dominicbeesley/blitter-vhdl-6502/src/hdl/modelC20K/boards/C20K816only/README.MD

# C20K

Test version with on-board 816 as main CPU
