dominicbeesley/blitter-vhdl-6502/src/hdl/modelC20K/boards/C20KFirstLight816/README.MD

# C20KFirstLight816 build

C20K test just the 816 and memory, uses debug UART + NoIce
now includes HDMI
