dominicbeesley/blitter-vhdl-6502/src/hdl/modelC20K/asm/C20KFirstLight816/C20KBareMOS816/README.md

# C20KBareMOS
=============

This is a boot ROM to be loaded at F000 on the C20KFirstLight816 firmware which
connects via the debug UART to a DeIce monitor.
