dominicbeesley/blitter-vhdl-6502/doc/API.md

# Introduction

The Paula and Blitter expansion boards expose a number of hardware 
registers. Most of the hardware registers are in the JIM page-wide except
where those registers enhance or reimplement a well-known mechanism, i.e.
the ROM paging register.

The addresses listed below are "physical" addresses in the form "AA BBCC"
i.e. FF FE30. Logical addresses are prefixed with "L" i.e. LFE30

# Physical memory map

The Blitter firmware has the concept of Physical and Logical memory maps. This
is to cater for the fact that the Blitter board needs a relatively large (24 bit)
memory map to cater for the large amount of memory available and the large number
of peripheral registers. However, each of the supported CPUs has differing 
capabilities in terms of the size of address that they natively support.

The section on [Logical to Physical Mapping] below describes how each CPU can 
access the physical address map.

## Physcial memory map overview

The physical memory map is separated in to the broad areas in the table
below. The following sections describe these in more detail.

 | Physical address         | hardware item         |
 |--------------------------|-----------------------|
 | $00 0000 - $5F FFFF      | ChipRAM               | 
 | $60 0000 - $7F FFFF      | BB RAM                | 
 | $80 0000 - $BF FFFF      | Flash EEPROM repeats  | 
 | $C0 0000 - $F9 FFFF      | Undefined do not use  | !!!! Used by 65816 for access to SYS without log mapping
 | $FA 0000 - $FB FDFF      | HDMI memory           | 
 | $FB FE00 - $FB FFFF      | HDMI registers        | 
 | $FC 0000 - $FC FFFF      | Debug/Version info    | !!!! Also boot rom for pre-boot?
 | $FE FC00 - $FE FCFF      | Chipset registers BE  | 
 | $FE FE00 - $FE FEFF      | Chipset registers LE  | 
 | $FF 0000 - $FF FFFF      | Motherboard           |

The Physical memory map is used when:
 - accessing devices or memory via the JIM page-wide interface
 - programming Chipset registers

### ChipRAM

ChipRAM is the extra RAM that is present on the Blitter/Paula board the amount
and arrangement of RAM will depend on which revision and level of board.

When accessing ChipRAM on a MOS compatible system it is advised that the memory
layout be divined using the OSWORD 99 calls available through the Utility ROM
wherever possible.

### BB RAM

Battery backed RAM present on Mk.2, Mk.3 and C20K boards, typically there is 
one megabyte of RAM that repeats here.

#### Paula

On the Paula there is 512KB of Fast 10ns RAM. This RAM will repeatedly alias
to fill the banks 00..7F. There is no battery backed RAM

#### Mk.2 Blitter

The Mk.2 contains a single 2MB CMOS SRAM which is usually battery backed. This
RAM will repeatedly alias to fill the banks 00..7F

### Mk.3 Blitter

#### Mk.3 Fast RAM

The Mk.3 Blitter can contain up to 3x2MB fast 10ns RAM in the range 00..5F these
RAMs may be smaller than 2MB in which case they will each alias within a range of 
banks that is &20 banks long. There may be no fast RAM in which case whatever chip
is in socket 3 (battery backed) will alias in the same way as the Mk.2 Blitter. 
Conversely if there is no Battery Backed RAM the ChipRAM will also alias in the 
60..7F range.

#### Mk.3 Battery backed RAM
The Mk.3 Blitter may contain up to 2MB of 45ns CMOS static battery backed RAM 
which will appear in the range 60..7F. If there is no Fast RAM the battery backed
RAM will also appear in the lower portion of ChipRAM address space 00..5F

### Flash EEPROM

The Mk.2 and Mk.3 Blitters contain upto 512KB of Flash EEPROM at $80 0000 onwards
the Paula board contains an alias of RAM in this range.

The Flash EEPROM is an SST39VFxxx-55 compatible device upto (and usually) 512KB in
size. The main use is to provide sideways ROMS however there is usually unused 
capacity toward the borrom of the ROM which may be used for other applications.

### HDMI memory / registers

Optionally on the Mk.3 boards there may be a HDMI framebuffer of up to 128K and
some associated registers in this area.

### Debug / Version info

The firmware places a ROM in these pages for the purpose of identifying the firmware
and capabilities of the board.

### Chipset Registers

The Blitter, Paula Sound, DMA, Aeris registers are in this address range

### Motherboard

The whole of the BBC Micro's or Electron's address space appears in bank FF 
The following points should be noted:
- There is no re-mapping of the sideways ROM/RAM area and the sideways ROM/RAM
  selected on the Blitter board will not be accessed, instead the underlying
  motherboard mapping will apply.
- Writing the ROM select register (BBC/Master at FF FE30, Elk at FE05) will
  also write the Blitter's copy, thus updating the mapping in the logical 
  to physical mapping (see below)
- Writing device select register at FF FCFF with the value D1 (blitter) or
  D0 (1M Paula) will enable Blitter JIM access, any other value will disable
- Reading or Writing the JIM paging registers at FF FCFD..FCFE when the
  when Blitter JIM access is enabled will *only* read or write the Blitter's
  copy of the paging registers

# Logical to Physical Mapping

There is a layer of address remapping between the currently running CPU and
the hardware resources of the board. This allows for:

 - different CPUs require ROM at different locations
 - 8, 16, 32 bit CPU requirements
 - providing enhanced Sideways ROM/RAM

In the following sections the various logical mappings are described. 
Addresses of the form LXXXX refer to logical addresses as seen by the CPU,
addressed of the XX XXXX refer to physical addresses

## MOS Compatible memory Map

In general most 8-bit CPUs use a "MOS compatible" memory map such that RAM
appears at 0-7FFF, Sideways ROM/RAM at 8000-BFFF and MOS ROM at C000-FFFF with
a "hole" for hardware register access at FC00-FEFF.

The default mappings for 6502, 65c02, 65816, 6809, 6309 and 6800 all use a 
similar mapping.

At boot time the RAM at 0000-7FFF is mapped to motherboard memory on 65xx systems
this will allow most games and demos to run without and modification. The motherboard
memory has a maximum speed of 2MHz and this will tend to throttle any faster
CPU to 2MHz by default when running code from, or accessing data in the 
motherboard RAM.

If a MOS compatible CPU wishes to access a physical address it can either
use a chipset device (such as the DMA device) or use the JIM page-wide
address expansion mechanism see [Using JIM](#using-jim)

### Shadow/Turbo memory

The normal mapping for the MOS memory map is to have the bottom 32k access
motherboard RAM. This is a good default setting for running existing 6502
games and demos which expect to run at 2MHz but will restrict the speed of
the CPU. 

It is possible using the [Lowmem Turbo](#TODO) register to configure
the logical to physical mapping to remap this area to faster chip ram

see [Low Memory Turbo](#ff-fe37-low-memory-turbo)
see [*BLTURBO](https://github.com/dominicbeesley/blitter-vhdl-6502/wiki/Command:BLTURBO)

### Sideways ROM/RAM

One of the most powerful features of the BBC micro series is the idea of 
sideways ROM (or sideways RAM). However, on the BBC Micro there are only
a limited number (4) of ROM slots on the motherboard. The Blitter board
can be used to expand this up to two sets of 16.

As the Blitter boards can be either run with an emulated 6502A (T65) CPU
or a variety of different hard CPUs it is useful to be able to have two
sets of ROM mappings for what might be two very different CPUs. There are
currently two maps called Map 0 and Map 1. 

Map 0 is usually in force when the T65 CPU is in use and will "punch through" 
various motherboard ROMs (depending on host machine).
Map 1 is usually in force then a hard CPU is in use.

It is possible to swap the above mapping by fitting the SWROMX jumper or
to disable Blitter ROMs altogether by fitting the MEMI jumper (see
the relevant jumper documentation for your board).

The mapping of which slots are mapped to motherboard ROM slots and which
to either RAM or ROM is dependent upon which type of host machine is in use.

The following sections outline how the mappings are performed.

Note: where "RAM" is specified in the tables below it will depend on which
mark of board and what level of RAM is fitted as to whether the RAM is 
battery backed or not.

As these mappings are quite complex and subject to change it is strongly
advised that the OSWORD 99 API be used to query these mappings in software.

#### ROM access speeds

Depending on the mapping of the current ROM the CPU may or may not be able
to run at greater than 2MHz depending on the ROM slot.

When running from a motherboard ("SYS") rom slot the CPU will always be 
restricted to running at 2MHz.

If running from EEPROM or BBRAM the memory will be accessed at either 45ns 
or 55ns with additional overhead of address mapping and arbitration the 
maximum speed of most CPUs will be held to around 6.5Mhz (this will change)

Each ROM can optionally be throttled by setting a bit in the [Per-ROM throttle 
register](#ff-fe33-ff-fe35-throttle-per-rom) see [*BLTURBO](https://github.com/dominicbeesley/blitter-vhdl-6502/wiki/Command:BLTURBO)

#### BBC B

##### BBC MAP 0

  | # | Type      | Physical address   | Notes                                 
  |---|-----------|--------------------|---------------------------------------
  | 0 | BB RAM    | 7E 0000 - 7E 3FFF  |                                       
  | 1 | EEPROM    | 9E 0000 - 9E 3FFF  |                                       
  | 2 | BB RAM    | 7E 4000 - 7E 7FFF  |                                       
  | 3 | EEPROM    | 9E 4000 - 9E 7FFF  |                    

  | 4 | SYS IC 52 | FF 8000 - FF BFFF  | Mk.1 / Mk.2 / Mk.3                                      
  | 5 | SYS IC 88 | FF 8000 - FF BFFF  | Mk.1 / Mk.2 / Mk.3                                      
  | 6 | SYS IC 100| FF 8000 - FF BFFF  | Mk.1 / Mk.2 / Mk.3                                      
  | 7 | SYS IC 101| FF 8000 - FF BFFF  | Mk.1 / Mk.2 / Mk.3                                      
  
  | 4 | BB        | 7E 8000 - 7E BFFF  | C20K                                      
  | 5 | EEPROM    | 9E 8000 - 9E BFFF  | C20K                                      
  | 6 | BB        | 7E C000 - 7E FFFF  | C20K                                      
  | 7 | EEPROM    | 9E C000 - 9E FFFF  | C20K                                      

  | 8 | BB RAM    | 7F 0000 - 7F 3FFF  | NB: also used as the MOS ROM when MOSRAM in effect
  | 9 | EEPROM    | 9F 0000 - 9F 3FFF  | NB: also used as the MOS on C20K                                      
  | A | BB RAM    | 7F 4000 - 7F 7FFF  |                                       
  | B | EEPROM    | 9F 4000 - 9F 7FFF  |                                       
  | C | BB RAM    | 7F 8000 - 7F BFFF  |                                       
  | D | EEPROM    | 9F 8000 - 9F BFFF  |                                       
  | E | BB RAM    | 1F 0000 - 1F 3FFF  | Fast chipRAM
  | F | EEPROM    | 9F C000 - 9F FFFF  | NB: also used as the NoIce debug bank

NOTE: In map 0 Blitter boards ROM slots 4-7 are taken direct from the BBC 
motherboard whereas on the C20K all ROMS come from the Flash EEPROM or BB RAM

NOTE: On the C20K the MOS ROM is loaded to slot 8 or 9

##### BBC MAP 1

  | # | Type      | Physical address   | Notes                                 
  |---|-----------|--------------------|---------------------------------------
  | 0 | BB RAM    | 7C 0000 - 7C 3FFF  |
  | 1 | EEPROM    | 9C 0000 - 9C 3FFF  |
  | 2 | BB RAM    | 7C 4000 - 7C 7FFF  |
  | 3 | EEPROM    | 9C 4000 - 9C 7FFF  |
  | 4 | BB RAM    | 7C 8000 - 7C BFFF  |
  | 5 | EEPROM    | 9C 8000 - 9C BFFF  |
  | 6 | BB RAM    | 7C C000 - 7C FFFF  |
  | 7 | EEPROM    | 9C C000 - 9C FFFF  |
  | 8 | BB RAM    | 7D 0000 - 7D 3FFF  | NB: also used as the MOS ROM when MOSRAM in effect
  | 9 | EEPROM    | 9D 0000 - 9D 3FFF  | NB: also used for MOS in Map 1 (not when MOSRAM in effect)
  | A | BB RAM    | 7D 4000 - 7D 7FFF  |
  | B | EEPROM    | 9D 4000 - 9D 7FFF  |
  | C | BB RAM    | 7D 8000 - 7D BFFF  |
  | D | EEPROM    | 9D 8000 - 9D BFFF  |
  | E | BB RAM    | 1F 4000 - 1F 7FFF  | Fast chipRAM
  | F | EEPROM    | 9D C000 - 9D FFFF  | NB: also used as the NoIce debug bank

#### Electron

##### Electron MAP 0

  | # | Type      | Physical address   | Notes                                 
  |---|-----------|--------------------|---------------------------------------
  | 0 | BB RAM    | 7F 8000 - 7F BFFF  |                                       
  | 1 | EEPROM    | 8F 8000 - 8F BFFF  |                                       
  | 2 | BB RAM    | 7F C000 - 7F FFFF  |                                       
  | 3 | EEPROM    | 8F C000 - 8F FFFF  | NB: also used as the NoIce debug bank
  | 4 | BB RAM    | 7F 0000 - 7F 3FFF  | NB: also used as the MOS ROM when MOSRAM in effect
  | 5 | EEPROM    | 8F 0000 - 8F 3FFF  |                                       
  | 6 | BB RAM    | 7F 4000 - 7F 7FFF  |                                       
  | 7 | EEPROM    | 8F 4000 - 8F 7FFF  |                                       
  | 8 | SYS       | FF 8000 - FF BFFF  | Keyboard
  | 9 | SYS       | FF 8000 - FF BFFF  | Keyboard                                      
  | A | SYS       | FF 8000 - FF BFFF  |                                       
  | B | SYS       | FF 8000 - FF BFFF  |                                       
  | C | BB RAM    | 7E 0000 - 7E 3FFF  |                                       
  | D | EEPROM    | 8E 0000 - 8E 3FFF  |                                       
  | E | BB RAM    | 7E 4000 - 7E 7FFF  |                                       
  | F | EEPROM    | 8E 4000 - 8E 7FFF  |                                       

##### Electron MAP 1

  | # | Type      | Physical address   | Notes                                 
  |---|-----------|--------------------|---------------------------------------
  | 0 | BB RAM    | 7D 8000 - 7D BFFF  |
  | 1 | EEPROM    | 8D 8000 - 8D BFFF  |
  | 2 | BB RAM    | 7D C000 - 7D FFFF  |
  | 3 | EEPROM    | 8D C000 - 8D FFFF  | NB: also used as the NoIce debug bank
  | 4 | BB RAM    | 7D 0000 - 7D 3FFF  | NB: also used as the MOS ROM when MOSRAM in effect
  | 5 | EEPROM    | 8D 0000 - 8D 3FFF  | NB: also used for MOS in Map 1 (not when MOSRAM in effect)
  | 6 | BB RAM    | 7D 4000 - 7D 7FFF  |
  | 7 | EEPROM    | 8D 4000 - 8D 7FFF  |
  | 8 | SYS       | FF 8000 - FF BFFF  | Keyboard
  | 9 | SYS       | FF 8000 - FF BFFF  | Keyboard                                      
  | A | SYS       | FF 8000 - FF BFFF  |                                       
  | B | SYS       | FF 8000 - FF BFFF  |                                       
  | C | BB RAM    | 7C 0000 - 7C 3FFF  |
  | D | EEPROM    | 8C 0000 - 8C 3FFF  |
  | E | BB RAM    | 7C 4000 - 7C 7FFF  |
  | F | EEPROM    | 8C 4000 - 8C 7FFF  |

NOTE:TODO: for NoIce to work correctly the utility ROM should be loaded in banks 3 and F on the Electron!

NOTE: the Electron mappings are similar to those for the BBC micro except that 
the ROM paging register is exclusive or'd with 0x0C and the SYS roms punch through in both maps

#### Master

TBC

### MOS in Map 1

When a Map 1 is in force the MOS at LC000..LFFFF is taken from Map 1's 
slot #9 (#5 on Elk). However, if [MOSRAM](#mosram) is in force the MOS 
will be taken from slot #8 (#4 on Elk)

### MOSRAM

When either the MOSRAM jumper is fitted or a '1' has has been written to the 
MOSRAM bit of the SWMOS_CTL register the MOS at LC000-LFFFF will be taken
from slot #8 (#4 on Elk) of the current map. 

This is useful for debugging the MOS ROM using NoIce and is also used to 
make a "flat" 64K RAM map for running non-MOS operating systems such as 
Flex for the 6800, 6809 or 6309.

The [BLTURBO](https://github.com/dominicbeesley/blitter-vhdl-6502/wiki/Command:BLTURBO) 
command can also be used to copy a ROM based MOS to ram and run from there to 
provide a speed boost.

See also: Registers [FF FE31 SWROM](#ff-fe31-swmos), [FF FE32 SWMOS save register](#ff-fe32-swmos-save-register)

TODO: remove FLEX shadow from vhdl
TODO: rename SWMOS_SHADOW to MOSRAM throughout vhdl/docs
TODO: BLTURBO link 

### NoIce Debugger mappings

## 6502/65C02/T65 extras

On the 65xx (not 65816) series CPUs there are some advanced facilities
to assist using the NoIce debugger.

NMI - when an NMI is detected extra logic is enabled to discover the
source (debug button or motherboard) and to enter the NoIce debugger
if it is enabled if the debug button is pressed.

5C NOP - when NoIce is enabled should an unknown/illegal opcode $5C
be executed then special processing is performed to enter the noice
debugger.

For more information read the section [The NoIce Debugger](#the-noice-debugger)

## 6809/6309 extras

The 6x09 CPUs have similar hardware reset and interrupt vectors to the
6502 and appear like the 6502 at the end of the 64K memory map. There 
are however more of them and these clash with "well known" MOS entry 
points. For this reason there is an extra logical mapping applied to 
6x09 series CPU whereby if a vector is being read, detected by the CPU
BA and BS pins being 0 and 1 respectively, then bit 11 of the address
is toggles such that vectors normally at LFFF0..F will actually be
read from LF7F0..F

On the 6x09 series processors the motherboard NMI line is actually
routed to the 6x09's FIRQ input as that is more suitable for fast
data transfers. The NMI input is mapped direct to the debug button.

## 65816 extras

The firmware for the 65816 CPU will normally boot in a MOS compatible mode such
that the 65816's logical bank 0 will map in the same way as a normal 6502
and the CPU will start in "emulation" mode. In this way the 65816 will
behave more or less identically to a 6502 except it may run faster. This is
known as "65816 boot mode".

The 65816 also has a "native" mode which unlocks some of its extended
functions but also requires a new set of hardware vectors. In additions there
are new hardware and software vectors in emulation mode for the ABORT 
interrupt and the COP instruction.

These new vectors addresses clash with locations in the 6502 MOS OS function
entry table so there is an extra logical mapping which redirects these vectors 
to chip RAM such that the vectors in native mode are fetched from L00FFxx to 
00 8Fxx in ChipRAM. The emulation mode vectors for irq, nmi and reset still
map to FF FFFx in boot mode - for maximum compatibility with 6502 code.

This is an experimental feature but has been used with some success in 
getting Communicator 65816 BASIC to run in native mode on an unmodified MOS.

Each time the hardware is reset the logical to physical mapping will
revert to this "boot mode". However it is possible to  remap the 65816 to 
use a "flatter" memory map where the bank register maps directly to 
the Physical bank *except* for bank FF which will go through a MOS compatible
logical to physical mapping. This has not been widely used and may change in
future. To exit boot mode write a 0 to bit 5 of FF FE31 (L00FE31 in boot mode) 
see [below](#ff-fe31-swmos)

## Motorolla M68K series

### 68K boot

When the 68008 first boots it needs its vectors to appear at 0 0000 to 0 00FF but
that would normally map to RAM. A facility is provided such that a boot ROM can appear
at 8D 3F00 (or 7D 3F00 if mosram is fitted) and it will be remapped to appear to the 
cpu to be at 0 0000, for reads only. This mapping will remain in effect until the first 
access of the JIM device register. 

The normal boot action of an OS ROM should be:

```
    ; copy rom vectors to low memory
    lea     $D0000,A6
    movea   #0, A0
    move.w  $FF, D0
.lp:move.l  (A6)+,(A0)+       ; note during "boot" writes to RAM pass through but reads from the bottom
                              ; page of RAM map to the boot rom 
    dbf     D0,.lp

    ; switch maps by temporarily selecting blitter device
    move.b  #$D1,$FFCFF       ; set jim device number
```

i.e. copy the vectors to RAM and then select the blitter JIM device

NOTE: this may be changed in future as it relies on the M68k running in map 1.

### 68008 specifics

The 68008 can address only 1MB of memory space which is remapped as follows to 
allow access to both ROM and RAMS

The 68008 processor has a special memory mapping: when the top bit(19) of the 
address is set

 | A19..16      | Mapping                                  | Bank |
 |--------------|------------------------------------------|------|
 | F            | MOS logical bank                         |    FF|
 | E            | The Chipset registers bank               |    FE|
 | D            | Current MOS - when mosram not fitted     |    8D|
 |              |  -- "" --   - when mosram is fitted      |    7D|
 | others       | Map to RAM                               |00..0C|

Whilst this does not expose all possible addresses it is still possible to access
all addresses via the JIM interface as the memory exposed at LF0000-LFFFFF is 
actually the MOS logical map along with all the usual ROM/JIM/etc mappings.

NOTE: this may be changed in future as it relies on the M68k running in map 1.

### 68000 / 68010 specifics

The 68000 plugin for the Mk.3 board actually has a full set of 24 address lines
sufficient to fully address all of the physical memory map. However there are
still logical mappings applied:

 | A19..16      | Mapping                                  | Bank |
 |--------------|------------------------------------------|------|
 | FF           | MOS logical bank                         |    FF|
 | others       | Map direct to physical address           |00..FE|

The boot mapping described [above](#68k-boot) is also applied to allow the 
initial reset time vectors to appear in low-memory.

### 68000 / 68008 agnostic code

The 8 bit and 16 bit version of the M68k are functionally almost 
identical apart from the address bus width. If the boot ROM is written
to be compiled at L8Dxxxx or L7Dxxxx it should work on both the 8 and
16 bit varieties.

TODO: two separate versions of boot rom must be compiled for running 
either from RAM (at L7D0000 or L8D0000) - consider extra mapping so that
boot rom is always at a single address?

# Using JIM

The BBC Micro series feature a "page-wide" address expansion mechanism
that allows hardware to appear outside the normal memory map. This is
useful where there is a limited address space, such as on 8-bit CPUs 
limited to 64K of memory. 

The Blitter and Paula use 3 registers to control access to the JIM memory
map. These appear in the FRED page of memory - which can be accessed 
direct by 8-bit CPUs. [where Physical Addresses start FF they can be 
accessed direct on 8-bit CPUs]

 | Phys Address | Contents                         
 |--------------|----------------------------------
 | FF FCFD      | JIM paging register high byte
 | FF FCFE      | JIM paging register low byte
 | FF FCFF      | JIM device register

Note: when the device register is read back, if the Blitter/Paula device
is selected the complement of the devices number will be read back

The Paula and Blitter use the device select mechanism described at
[https://stardot.org.uk/forums/viewtopic.php?f=3&t=17222] 

Paula uses a device number of $D0 and the Blitter $D1. If the device
is detected/selected the complement $2F, $2E respectively will be read
back.

In addition the Blitter support ROM for 6502/6809 the zero-page location 
$EE to store the current device number. This should be set to the desired
device number *before* the device register is written as during interrupts
this value may be used by the support ROM to restore the device number.

It is necessary to first set the 

i.e. to access the Blitter from BASIC:

```
        10  A_JIM%=&FD00:A_DEV%=&FCFF:A_PAGH%=&FCFD:A_PAGL%=&FCFE:A_DEVSAVE%=&EE:DEVNO%=&D1
        ...
        100 REM Poke a value to physical address 12 3456
        110 ?A_DEVSAVE%=DEVNO%:?A_DEV%=DEVNO%
        120 ?A_PAGH%=&12:?A_PAGL%=&34:A_JIM%?&56=X%
```

Or in assembler to write the contents of Y to a 24 bit physical address 
stored in little-endian format in zeropage address &80

```
        
        LDA #&D1:STA &EE:STA &FCFF                      \ select device
        LDA &82:STA &FCFD:LDA &81:STA &FCFE             \ set paging registers
        LDX &80:TYA:STA &FD00,X                         \ write value
```

Note: on the Blitter the board will NOT output any read or write access to the page 
select registers on to the motherboard when the Blitter is selected as the current
device. However, on the Paula 1MHz bus device all accesses will be sent to all 
hardware. Care should be taken if there are devices on the 1MHz bus that might
respond to these accesses (such as an unmodified RetroClinic DataCentre)

## Saving device registers

In general when coding as the "current application" it is not necessary to
worry about saving device state but if coding an interrupt routine or a 
ROM it is necessary to restore the state of the device select and register
state after changing them so as not to disturb the foreground application.

```
        
        LDA &EE:PHA                                     \ save "current device"        
        LDA #&D1:STA &EE:STA &FCFF                      \ select device
        LDA &FCFD:PHA:LDA &FCFE:PHA                     \ save current paging register values
        LDA &82:STA &FCFD:LDA &81:STA &FCFE             \ set paging registers
        LDX &80:TYA:STA &FD00,X                         \ write value
        PLA:STA &FCFE:PLA:STA &FCFD                     \ restore paging registers
        PLA:STA &EE:STA &FCFF                           \ reselect original device
```

## Detecting Blitter / Paula

The presence of the Paula and Blitter can be confirmed by first writing the
device number to the Device Select register and then reading back that register
if the device is selected can be read back and the complement of the device
number will read back.

```
        LDA &EE:PHA                                     \ save "current device"        
        LDA #&D1:STA &EE:STA &FCFF                      \ select device
        LDA &FCFF:EOR #&D1:TAX                          \ exclusive or with #&FF
        PLA:STA &EE:STA &FCFF                           \ reselect original device
        INX:BEQ present                                 \ branch if 0 for present
        \ do something here for blitter not present
```

# Register Reference

## FF xxxx

The entire memory map of the BBC micro appears in bank FF. When accessed 
via the JIM mechanism of an 8-bit CPU this is just like addressing direct
to a normal 16bit address. On a 16 or 32 bit CPU the motherboard resources
can be accessed here. 

For more information see (Logical to Physical Mapping)[#logical-to-physical-mapping]

Note: When reading through to the motherboard via JIM the Blitter
sideways ROM/RAM mapping is NOT performed therefore it is possible to
access all ROMS on the motherboard by using this mechanism as the ROM
select register is always written to both the Blitter copy AND the 
motherboard.

Note: When reading this address range direct from  CPUs with a larger 
address space than 64k (i.e. 65816, 68K, x86) the logical to physical
translation *is* performed

| Phys Address | Contents |API|Sub| 
|---|---
| FF FCFD..FF  | JIM device and paging | | |
| FF FE05 | Electron ROM paging | | |
| FF FE30 | ROM paging register | | |
| FF FE31 | Sideways MOS/NoIce control | | |
| FF FE32 | Sideways MOS/NoIce restore | | |
| FF FE33,5 | Per ROM throttle | 1 | 2 |
| FF FE36 | Memory aux control 1 | | |
| FF FE37 | "Low Mem Turbo" register. | | |
| FF FE38,9 | Per ROM auto-hazel | 1 | 3 |
| FF FE3E..3F  | Mk.2 config registers (deprecated) | | |
| FF FE3E..3F  | 65816 MOS/RAM window **dev/test** | 1 | 4 |

Note: the registers at FE3x may be moved to a different location in future
firmware releases to minimize incompatibilities with other memory expansion
hardware. For this reason caution should be exercised when using these
registers. If there is a reason to access these directly please contact
the firmware authors to register an interest. It may be possible to 
add an OSWORD call to the utility ROM to support your needs.

### FF FCFD..FCFF - JIM paging registers

See the section [Using JIM](#using-jim) for information on these registers

### FF FE30 ROMSEL

This register is kept in sync with the same register on the motherboard.
It is used to control the selection of sideways ROM/RAM in the logical
address space FF 8000..BFFF

When enabled sideways RAM/ROM accesses are mapped to Flash and ChipRAM
as outlined in the [Logical to Physical Mapping](#logical-to-physical)
section above. 

Note: this register is effectively ignored if the SWROM inhibit jumper
is fitted.

### FF FE31 SWMOS

This register controls the various MOS mapping options

 | Bit    | Purpose
 |--------|------------------------------------------------------------------
 | 0  #   | MOSRAM_EN 
 | 1      | - reserved -
 | 2      | SWMOS_DEBUG 
 | 3  #   | SWMOS_DEBUG_EN
 | 4      | 65816 boot
 | 5      | 65816 boot
 | 6      | SWMOS_DEBUG_5C
 | 7      | SWMOS_DEBUG_ACT

Note: items marked # are _not_ reset on a normal break, instead a "full reset"
must be performed by either power-cycling or holding down BREAK for 3 seconds.

Note: reserved items currently read as zero. To ensure compatibility with
future firmwares it is recommended these bits should be left unmodified i.e.
use OR or AND to set/clear bits rather than writing direct.

 * **MOSRAM_EN** when set to 1 the MOS will execute from sideways RAM bank #8. 
   Note: this setting may also be in force due to the MOSRAM jumper being fitted
   but currently this bit will still read back as '0'

 * **SWMOS_DEBUG** When set to 1 the MOS logical area LC000-LFFFF is remapped to 
   allow NoIce to run:

   | logical address range    | Mapped to
   |--------------------------|---------------------------------------
   | LC000-LCFFF              | 7E 8000 This is the hidden slot #4 of map 0
   | LD000-LFBFF, LFF00-LFFFF | Rom #F of current map (either (9F D000 or 9D D000))

   Note: on the Electron the ROM will be #3

   Note: writing this bit has no effect unless bit 3 is also set
   Note: this mapping does not take effect until the next instruction *after* 
   the current instruction has been executed.

 * **SWMOS_DEBUG_EN** This bit, when set enables the extra debugging features 
   the 5C debugging on the 6502/T65/65C02 CPUs and also the NMI debug on 65xx
   and 6x09 CPUs

   See [Noice Debugger](#the-noice-debugger) below

 * **65816 boot** In 65816 mode these bits control the 65816 access 
   to logical CPU bank 0 

   In "boot" mode the 65816 will see the motherboard in bank 0 i.e. bank FF
   will be mirrored in bank 0 with all logical addresses applied as if the
   processor were an 8bit 65xx

   Additionally in boot mode when the CPU is executing in "native mode" hardware
   vector accesses (VPB pin == '0' and E pin = '0') will be made from *physical
   address* 00 8Fxx as will the extra vectors for the emulation mode (cop/abort)

    | bit 5..4 | Description
    |----------|----------------------------------------------------------------
    | "00"     | Addresses mapped direct, no remapping, throttle applies in all modes
    | "01"     | logical Bank FF maps onto logical bank 00 in emulation mode only, throttle applies in all modes
    | "10"*    | logical Bank FF maps onto logical bank 00 in all modes, throttle applies in all modes
    | "11"     | logical Bank FF maps onto logical bank 00 in emulation mode only, throttle applies in emulation mode only

   [\*] The default setting is "10"

   Note: changes to the memory mapping take 2 cycles to complete to allow a 
   jump to follow the instruction performing the swap to continue in another bank.

 * **SWMOS_DEBUG_5C** This bit indicates that debug mode was entered due to a 
   5C opcode being executed (as opposed to a debug button NMI).

   See [Noice Debugger](#the-noice-debugger) below.

 * **SWMOS_DEBUG_ACT** This bit is set by the debug state machine when the debugger
   has been entered due to the debug NMI button or a 5C instruction being executed
   or bits 2 and 3 being set.

### FF FE32 SWMOS save register

This register holds a copy of some of the bits of the FE31 SWMOS register taken
at the time that the debugger is entered (due to a debug button NMI or the 
5C instruction being executed)

 | Bit    | Purpose           | Current/Saved
 |--------|-------------------|----------------------------------------------
 | 0  #   | MOSRAM_EN         | current
 | 1      | - reserved -      | -
 | 2      | SWMOS_DEBUG       | saved
 | 3  #   | SWMOS_DEBUG_EN    | current
 | 4      | - reserved -      | -
 | 5      | 65816 boot        | - 
 | 6      | SWMOS_DEBUG_5C    | current
 | 7      | SWMOS_DEBUG_ACT   | current

The main purpose of this register is that any write to this register initiates
a state machine which will restore the state of the SWMOS_DEBUG bit in FE31 and
hence the MOS remapping to the state it was before the debugger was entered.

To return after a debug interrupt the NoIce Monitor code does:

```
        STA     $FE32                           ; reset DEBUG map by writing restore reg
        RTI
```

### FF FE36 Throttle CPU

Bit 7, when set any 65xx/T65/6x09 CPU will be throttled to 2MHz and synchronized 
with the motherboard phi2 clock. This can be useful to ensure that games
and demos run correctly. 

Bit 6, when set any 65xx/T65/6x09 CPU will be throttled to 2MHz and 
synchronized with the motherboard phi2 clock when accessing the MOS area at 
FF C000-FF FFFF (except for hardware registers)

Bit 5, writing bit 5 will cancel the preboot mapping - see PREBOOT. This is 
typically set at reset and the pre-boot mini-rom will unset it and "reboot" by
returning the SYSVIA state to how it was before the preboot-1 rom was entered.

Bit 4, this bit selects between rom maps 0 and 1, it is normally set at boot time 
bit may be used to swap out the MOS rom programmatically

See [\*BLTURBO](https://github.com/dominicbeesley/blitter-vhdl-6502/wiki/Command:BLTURBO) 
command.

All other bits should be left alone (they may be non-zero) for future
expansion.

This setting may be ignored in non-boot mode 651816 operation, see the FF FE31 SWMOS 
register for details.

### FF FE33, FF FE35 Throttle per ROM
API/Sub : 1/2

Certain sideways ROMs may misbehave if they are allowed to run faster than
2MHz. By default ROMs on the Blitter will run faster than this depending on 
the type of memory that is delivering the ROM and which revision of the board.

Setting a bit in FEF3 or FEF5 will throttle accesses to bytes from that ROM
much as the CPU throttle in bit 7 of FE36. Bits in FE33 control accesses
to ROMs 0..7 and in FE35 control ROMs 8..15.

Depending on the type of memory this might not have any effect i.e. accesses
to motherboard roms will be unaffected as these run at 2MHz already.

See the [\*BLTURBO](https://github.com/dominicbeesley/blitter-vhdl-6502/wiki/Command:BLTURBO), 
[\*SRLOAD](https://github.com/dominicbeesley/blitter-vhdl-6502/wiki/Command:SRLOAD) and 
[\*ROMS](https://github.com/dominicbeesley/blitter-vhdl-6502/wiki/Command:SRLOAD) commands

### FF FE37 Low Memory Turbo

This register controls the mapping of the "low" portion of memory in the
65xx, T65, 6809 and 6800 CPUs logical to physical mappings. [Note: Z80
addresses are mapped differently]

Any bit that is set it in this register will cause a 4K chunk of memory
visible to an 8-bit cpu in the range 0-7FFF to be mapped to ChipRAM instead 
of the motherboard memory. This is used by the \*BLTURBO command 'L' option 
to accelerate programs on CPUs that run at >2MHz

i.e. ?&FE37 = &81 will cause addresses 0..0FFF and 7000-7FFF to come from
ChipRam when performing logical to physical address mapping.

The mapping causes logical addresses FF xxxx to become 00 xxxx. The first
32k of ChipRAM is generally reserved for this purpose.

Note: setting this at run time will likely crash the machine unless the 
current contents of the relevant memory are copied to chipRam first.

See [\*BLTURBO](https://github.com/dominicbeesley/blitter-vhdl-6502/wiki/Command:BLTURBO) 
command.

### FF FE38..39 - Auto-hazel
API/Sub : 1/3

When this bit is set the "Auto-Hazel" mapping is applied, that is the 
MOS at C000-DFFF is overlaid by RAM whenever a ROM is selected whose 
bit in this register is a '1'. The ROM at FF C000-DFFF is overlaid with
memory from physical address 00 C000-00 DFFF when Auto-Hazel is active.

The "auto" part of the auto-hazel is that the remapping of the C000-DFFF
region only occurs when an instruction is being executed in a marked ROM.
This is done to ensure maximum compatibility with existing Model B/B+ software
which expects MOS font data at C000 and Hazel capable ROMs.

### FF FE3E..3F - Old Mk.2 firmware config registers

NOTE: these registers are now deprecated. On firmwares after May 2022 the 
configuration MUST be read using the mechanisms outlined in the 
[Boot Time Configuration](#boot-time-configuration) section.

Information about the old registers is contained in the [Old Mk.2 Firmware
Documentaton.md] file.

### FF FE3E..3F - 65816 RAM window                  

Using the registers at these locations it is possible to remap the memory 
that is usually seen by the 6502/65816 at FF Exxx to any 4k region in 
physical memory. This mapping is only visible from emu/boot mode 

The bottom 3 bits of FE3E are ignored and should be set to 0
These bits are reset to map to the MOS rom at boot (dependent on the memi/swmos/mosram/map)

The mapping is only updated when the high order register is written

The mapping is the base address, and lies on any **2K** boundary to allow for the
window to be set such that strings of data up to 2K can be allowed to straddle

These registers are WRITE ONLY and will continue to return the mk.2 config bits for now

## Boot Time Configuration 

**Blitter only**

This section describes a set of read-only registers that describe the 
firmware that is currently programmed to the Blitter. 

### Build version and configuration

The version and configuration page in physical page FC 00xx contains 
information about the static build information for the current firmware.

Locations FC 0000 to FC 0080 contain a set of strings delimited by 0 bytes
and terminated by two zero bytes:

```
 | index        | Contents                                             |
 |--------------|------------------------------------------------------|
 | 0            | Repo version:                                        |
 |              | - G:<hash>[M] - Git Version hash                     |
 |              | - S:<number>[M] - Svn version number                 |
 |              | trailing 'M' indicates modified from the given no.   |
 |--------------|------------------------------------------------------|
 | 1            | YYYY-MM-DD:HH:MM:SS                                  |
 |              | build start time                                     |
 |--------------|------------------------------------------------------|
 | 2            | Board name - a short name for the configuration      |
 |--------------|------------------------------------------------------|
 | 3            | branch:repo                                          |
 |              | the repo name is shortened and the format should not |
 |              | be relied on and may change                          |
 |--------------|------------------------------------------------------|
```

More strings may be added in future

### Configuration Information

The boot-time configuration is read from the on-board configuration switches
(or build time options for firmware versions that do not support the function)
and presented in page FC 0080 onwards

This page contains information relating to the API level of the board and
the configuration settings as set by the user.

```
 | address      | Contents                                             |
 |--------------|------------------------------------------------------|
 | FC 0080      | API Level                                            |
 |              | If this byte is 0 or FF then the firmware is API 0   |
 |              | and the rest of the information in this page is not  |
 |              | valid. Current Value = 1                             | 
 |--------------|------------------------------------------------------|
 | FC 0081      | Board Type                                           |
 |              | - 0 - 1MHz Paula                                     |
 |              | - 1 - Mk.1 Blitter                                   |
 |              | - 2 - Mk.2 Blitter                                   |
 |              | - 3 - Mk.3 Blitter                                   |
 |              | - 4 - C20K / ModelC                                  |
 |--------------|------------------------------------------------------|
 | FC 0082      | API Sub level                                        |
 |--------------|------------------------------------------------------|
 | FC 0083      | - reserved -                                         |
 |--------------|------------------------------------------------------|
 | FC 0084..87  | Configuration bits in force, see table below         | [1]
 |--------------|------------------------------------------------------|
 | FC 0088..8F  | Capabilities, see table below                        |
 |--------------|------------------------------------------------------|
```

[1] The configuration bits are read at boot time. Unused bits should be masked out
as future firmwares will likely utilize these bits

#### API 0

Prior to the API/Sub registers being introduced it was not possible to 
query the capabilities of the board. API 0 builds are deprecated and 
may stop being supported altogether.

#### API > 1

The table below shows the features introduced at each API level. 

Tables elsewhere in this document may include API/Sub columns and these
indicate the API level at which a feature was introduced.

| API | Sub | Description |
|-----|-----|---|
|  1  |  0  | API level/sublevel registers introduced |
|  1  |  1  | Added new CPU types, per-ROM throttle registers |
|  1  |  2  | Per-rom throttle |
|  1  |  3  | Auto-hazel for Model B / Elk |
|  1  |  4  | 65816 MOS/RAM window **dev** |

#### Configuration bits

FC 0084..FC 0087

The configuration bits are mapped differently for each board level:

##### Paula

The current Paula firmware does not implement these registers.

TODO/CHECK, more info on how to detect/work round this?

##### Mk.2

 | address      | hardware                          |
 |--------------|-----------------------------------|
 | FC 0084      | configuration header bits  [7..0] |
 | FC 0085      | configuration header bits [15..8] |
 | FC 0086      | - unused -                        |
 | FC 0087      | - unused -                        |

##### Mk.3

 | address      | hardware                          |
 |--------------|-----------------------------------|
 | FC 0084      | PORTG[7..0]                       |
 | FC 0085      | PORTF[3..0] & PORTG[11..8]        |
 | FC 0086      | - unused -                        |
 | FC 0087      | - unused -                        |

### Blitter Capabilities

FC 0088..FC 008F

The capabilities of the current firmware build are exposed in API>0 at these 
locations the capabilities describe which devices and functions are available
in the current build

 | address     | bit # | descriptions                   |API|Sub|
 |-------------|-------|--------------------------------|---|---|
 | FC 0088     | 0     | Chipset                        | 1 | 0 |
 |             | 1     | Chipset + DMA                  | 1 | 0 |
 |             | 2     | Chipset + Blitter              | 1 | 0 |
 |             | 3     | Chipset + Aeris                | 1 | 0 |
 |             | 4     | Chipset + i2c                  | 1 | 0 |
 |             | 5     | Chipset + Paula sound          | 1 | 0 |
 |             | 6     | HDMI framebuffer               | 1 | 0 |
 |             | 7     | T65 soft CPU                   | 1 | 0 |
 | FC 0089     | 0     | 65C02 hard CPU                 | 1 | 0 |
 |             | 1     | 6800 hard CPU                  | 1 | 0 |
 |             | 2     | 80188 hard CPU                 | 1 | 0 |
 |             | 3     | 65816 hard CPU                 | 1 | 0 |
 |             | 4     | 6x09 hard CPU                  | 1 | 0 |
 |             | 5     | Z80 hard CPU                   | 1 | 0 |
 |             | 6     | 68008 hard CPU                 | 1 | 0 |
 |             | 7     | 680x0 hard CPU                 | 1 | 0 |
 | FC 008A     | 0     | ARM2 hard CPU                  | 1 | 1 |
 |             | 1     | Z180 hard CPU                  | 1 | 1 |
 |             | 2     | George Foot Supershadow        | 1 | 1 |
 |             | 3     | Fast RAM @ 10ns (else 45ns)    | 1 | 1 |
 |             | 4     | Slow RAM @ 45ns (else 55ns)    | 1 | 1 |
 |             | 5     | Chipset + SDCARD / SPI         | 1 | 4 |
 |             | 6     | 0                              | 1 | 1 |
 |             | 7     | 0                              | 1 | 1 |
 | FC 008B..8F | *     | - reserved - all bits read 0   |

# PREBOOT

In 2026 a new pre-boot feature is being rolled out to all the boards, starting
with the C20K.  The Pre-boot is a menu system that allows the user to 
re-configure their machine:
  - load romsets
  - switch between maps
  - switch between hard/soft cpus
  - other TBC

The main driver is that on the C20K if the MOS or BLTUTIL images are erased or
corrupted in FlashEEPROM it is difficult to reinstate them.

The pre-boot is a tiny <256 MOS rom that is mapped in for each reset, this rom
is part of the main FPGA bitstream. If a certain key combination is held down 
(COPY-ESC-BREAK) the pre-boot MOS will bootstrap a more complicated BIOS-like 
menu system. This will be loaded from the FPGA's SPI Flash configuration memory
(user flash on Mk.3/MAX10). See [preboot readme](../src/roms/preboot/readme.md)

# The NoIce debugger

TODO: tidy up and check the below - it may be wrong/out of date

### 3.5.1 DEBUG MEMORY MAP [65x02 only]

When the debug memory map is enabled (bit 0 and 2 of $FE31 SMOS are both set)
the MOS area of memory i.e. C000-FBFF and FF00 to FFFF will be mapped as follows:
```
C000-CFFF   = physical RAM 7E 8000 to 7E 8FFF this can be used by the 
              debugger as scratch memory, buffer space, etc
              [this is the SWRAM memory for ROM #4 which is always obscured by
              the SYS ROM]
D000-FBFF 
and
FF00-FFFF   = the top portion of SWROM #F (i.e. $ 8F D000 - 8F FFFF)
```

DEBUG NMI [65x02 only]
======================
A debug switch can be fitted to ground the bugbtn header pin input, which will 
cause an NMI [ on the 6809 the CPU nNMI input is dedicated to this pin]
      
A falling edge on this input will (after 16 8MHz cycles) perform the following:
  - save existing bits 0, 1 and 2 in FE31, these will be readable from FE32 
  - cause an NMI 
  - wait for the next NMI fetch and set bits 0 and 2 in the FE31 SWMOS register 
    to map in the debug memory and ROM #8 into the MOS workspace

This behaviour will be inhibited by holding the CPU nNMI low until $FE32 is 
next written to restore $FE31, this is to stop spurious multiple NMIs being 
generated from the debug button.

A consequence of these behaviours is that real NMI's will be lost whilst the
debugger is active.

Bit 3 of SWMOS must be set to enable this behaviour

DEBUG NOP [65x02 only]
======================
On the 6502A and 65c02 processors the opcode $5C is a NOP, when bit 3 of SWMOS
is set executing this instuction will cause the following behaviour:

  - save existing bits 0, 1 and 2 in FE31, these will be readable from FE32 
  - wait for the next vector fetch and set bits 0 and 2 in the FE31 SWMOS 
    register to map in the debug memory and ROM #8 into the MOS workspace
    [if an IRQ is pending this will be processed first]
  - cause and hold and nmi (as debug button)
This will effectively cause a BRK instruction to appear to have been executed
3 bytes after the 5C instruction (the 5C nop takes 2 bytes as arguments).

This is used by the NoICE debugger as its break point instruction, leaving the 
BRK instruction to be used as the regular MOS error mechanism.

Bit 3 of SWMOS must be set to enable this behaviour

WRITING BITs 2/3 of SWMOS
================================================ 
Writing a '1' to bits 2 and 3 of the SWMOS register will enter the noice debug 
memory map after the next instruction, saving the to the $FE32 register as above
this allows the debugger memory to be entered with an instruction sequence 
as below (example for 6809)

    ldx   #<address of entry routine in debugger memory>
    pshs  X
    lda   #$0C
    ora   $FE31
    sta   $FE31
    rts

the final rts will pull the debugger entry address from the stack in the 
_current_ map and set the PC to that address. The memory map will then be
swapped ready for the next instruction.

SWMOS debug save (65x02 only)
-----------------------------
[See FE32 above]

[Note: this is likely to change to along with SWMOS register]

When a debug NMI occurs on a 65x02 machine the SWMOS register will be saved
here prior to setting the SWMOS bits 0, 1 and 2 can be read by the debugger
to check the machine state before a debug NMI and to restore the state when
exiting the NMI

Any write to this register is a special case. A state machine will wait until
after the next CPU sync that before writing the data contained in this register
to $FE31. This for an exit from a debug NMI of the form

    .nmi_exit_to_sys
      pla
      tax
      pla
      tay
      pla
      sta $FE32
      rti                 ; at this point the old SWMOS state will be restored 
                          ; from the contents of $FE32

The current values of FE31 are returned in FE32 to allow code such as below to 
access the memory map as it stood when the debug nmi / 5C occurred.

    .get_byte
      lda $FE31
      pha
      lda $FE32
      sta $FE31
      lda ($00),Y
      tax
      pla
      sta $FE31
      rts

This code would need to be executed from memory other than C000-FFFF as the 
act of setting FE31 would likely page out the current code!

# Deprecated registers:

May 2022

The following registers are now deprecated and should not be used in new software
and are likely to be removed from the firmware. This information is retained in
case of looking at older software.

CONFIG registers

  **FF FE3E,F** this register pair can be used to read back the current values
  on the configuration pins, the values are inverted and give a '1' where a 
  jumper is fitted. Writing to this register is reserved for future uses and
  should be avoided.

  $FE3E:

```
  Bit(s) | Value | Meaning
  -------|-------|--------------------------------------
   0    *|   1   | t65 core in operation
         |   0   | hard cpu in operation
   3..1 *|  000  | 6502A @ 2 MHz
         |  100  | 65C02 @4Mhz
         |  010  | 65C02 @8Mhz          --currently 4Mhz
         |  110  | 65C816 @8Mhz         --currently 4Mhz
         |  001  | 6809E/6309E @2Mhz
         |  101  | 6309E @4Mhz
         |  011  | Z80A @8Mhz
         |  111  | 68008 @8Mhz
   4    *|   1   | swromx not fitted 
         |   0   | swromx fitted
   5     |   ?   | ?
   6     |   ?   | ?
   7     |   1   | bugbtn pressed         
```
  $FE3F:
```
  Bit(s) | Value | Meaning
  -------|-------|--------------------------------------
   0    *|   1   | memi jumper fitted i.e. chip swrom/ram disabled
         |   0   | normal
   1     |   X   | inverted bugout signal
   7..2  |   ?   | ?
```

NOTE: bits marked * are latched at reset time and do not reflect the active state
of the config pins
NOTE: bits marked ? should be masked out and ignored as these are used for various
debugging and test purposes which is likely to change with firmware updates
