dominicbeesley/blitter-vhdl-6502/ATTRIBUTION.md

Some parts of this project have been taken from source on the internet:

## Code taken from:

* [Benjamin Krill](https://git.krll.de/public/snippets/src/branch/master/vhdl/rrarbiter.vhd) for round robin arbiter
* T65 core - Daniel Wallner, Mike Johnson, Wolfgang Scherr Morten Leikvoll and many others
* Various files from Mike Stirling's [BeebFPGA](https://www.mike-stirling.com/retro-fpga/bbc-micro-on-an-fpga/bbc-micro-on-an-fpga-design-detail/)
* Various files from Mike Field's [HamsterWorks site](https://web.archive.org/web/20190115073318/http://hamsterworks.co.nz/mediawiki/index.php/FPGA_Projects)

## Code required for Simulations

These cores are used for simulations and are not present in the repository due to incompatible licences

See the file [README.md] in the /src/hdl/library/3rdparty/missing folder for instructions on how
to download the right files

* TG68 core - Tobias Gubener [GitHub](https://github.com/TobiFlex/TG68K.C)
* I2C_minion - Peter Samarin [GitHub](https://github.com/oetr/FPGA-I2C-Minion)
* System09 6809 core - John E Kent [http://members.optushome.com.au/jekent/system09/index.html#download]
* System68 6800 core - John E Kent [http://members.optushome.com.au/jekent/system68/index.htm]

## Many Thanks to
* [Dave Banks/Hoglet](https://github.com/hoglet67) for inspiration and advice
* [JGH](https://mdfs.net) for advice and  keeping my APIs more or less on the straight and narrow
* Everyone at [https://stardot.org.uk/forums]
