dominicbeesley/blitter-vhdl-6502/doc/mk3-components.png

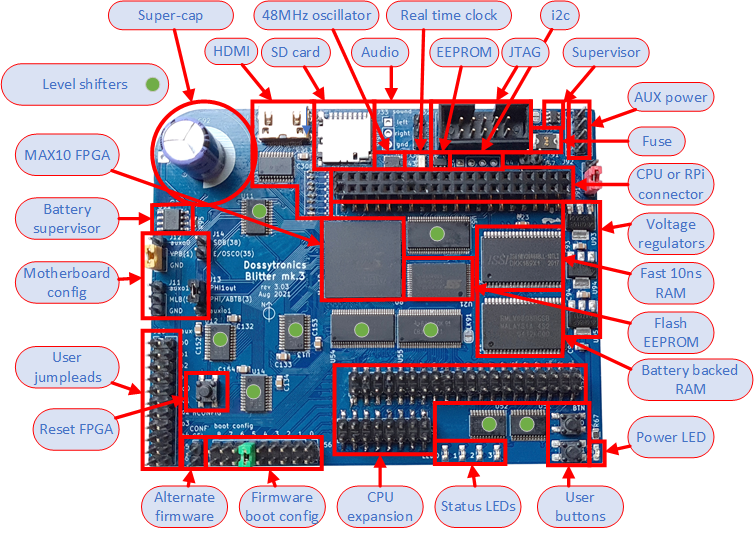
doc/mk3-components.png
