dominicbeesley/blitter-vhdl-6502/doc/getting-started.md

Getting Started - BBC Model B
=============================

# Long-Break

The Blitter and C20k respond differently to the Break key depending on how 
long it is held down. Pressing the Break key for less than 2 seconds results
in normal operation. Holding the Break key down for more than 3 seconds will
result in the configuration jumpers being re-scanned. It is recommended when
performing a long break to always hold down the ctrl-key as well to force a
cold boot.

# Introduction

This guide is intended to guide you through some first steps in using the 
Blitter board. It is not intended to be a complete reference.

The accompanying disc images are available [here](assets/getting-started/discs.zip)

# Preparing the base machine

Before inserting the card in a model B for the frst time it is recommended 
that you should:

 * remove any other sideways ROM/RAM expansions, you will hopefully not need
   these anyway
 * remove any 1MHz bus devices whilst doing initial setup and testing
 * remove any TUBE devices whilst doing initial setup and testing
 * remove expansion ROMS but keep BASIC and whatever filing system you wish
   to use to load ROMs ([see Choosing a filing system](#choosing-a-filing-system))
 * remove the 6502 CPU
 * place the supplied 6502 BLTUTILs ROM in the right-most (highest priority
   ROM slot)
 * VideoNULA is recommended but not required

Your machine should now look like this:

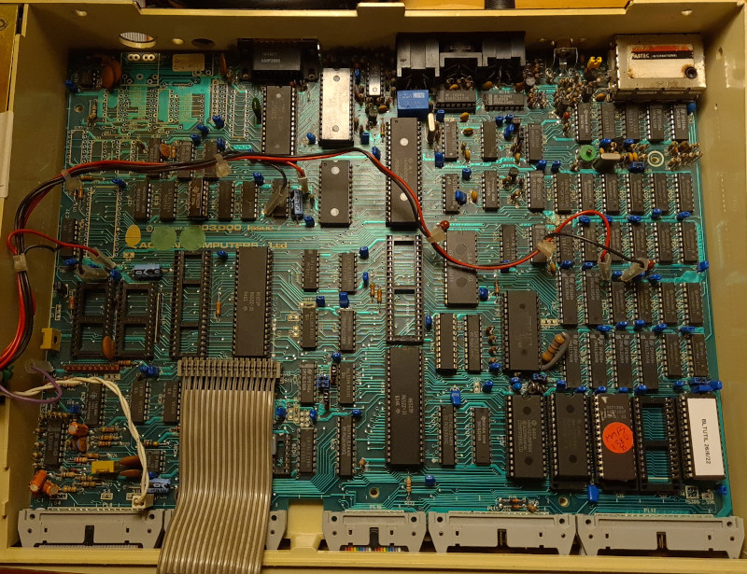
[picture p6: doc/assets/getting-started/empty-mb.jpg]


## Check S9 on the BBC Motherboard

Ensure either that S9 is fitted on the motherboard (it may be a wire link) or
that a Disc Interface is fitted. If your machine at one point had a disc 
interface that has now been removed you should remake S9.

## Choosing a filing system

The Blitter in 6502 mode should work with most filing systems *except* for 
unmodified RetroClinic DataCentre board which take over the 1MHz bus JIM 
interface in such a way that is not compatible with the Blitter. An updated
[firmware and ROM is available for the DataCentre](https://github.com/dominicbeesley/DataCentre)

In this example a simple user-port MMFS solution is used. Other options
that have been widely tested are:
 * ADFS (Disc and Winchester) \[Not Pi 1MHz\]
 * 1770 DFS
 * 8271 DFS
 * HOSTFS

The commands in the examples below i.e. DIN refer to the MMFS insert disk
command where this command is seen and you are using a different filing 
system then insert the relevant disc using the relevant command or by
inserting the given floppy disc.

## Strip down the Blitter to a minimal configuration

You may have been supplied with a buttons board to make changing jumper 
settings easier. If you have then you may connect the board as described
in [Buttons Board](buttons-mk1.md). NOTE: wherever a jumper is left open
in this guide the corresponding switch should be in the UP position. i.e.
British switch sense - down for on

**Mk.2**

* remove all hard CPUs
* remove all jumpers except:
  - P6 CPU voltage set to 3.3V (south)
  - J5 configuration jumper on position marked "0" (3rd from left) - selects T65 internal CPU
  - J2 SYS CPU Gnd - additional ground taken from motherboard
  - J8 Power Select - East - take power from motherboard

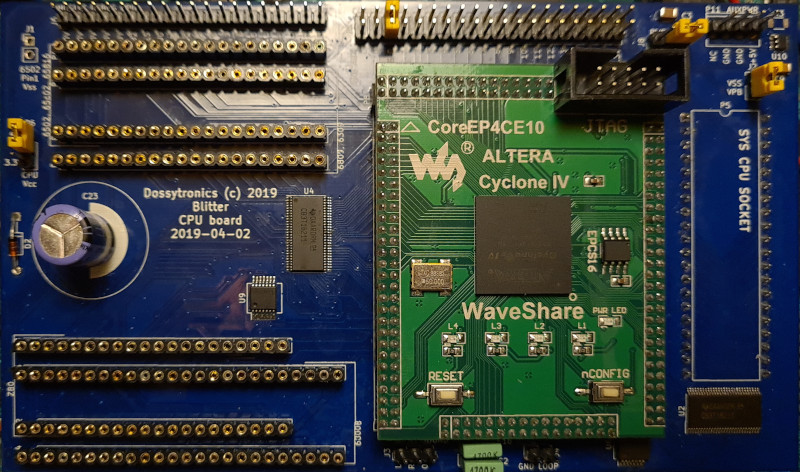
[picture p7: doc/assets/getting-started/mk2-first-boot-jumpers.jpg]


[See Hardware Overview](hardware-overview-mk2.md) for more information about
jumpers

**Mk.3**

TODO

## Insert the Blitter into the motherboard

Take great care when fitting the board as it is very easy to damage the pins
on the riser plug. 

### Raising the blitter

If you need to use a Watford Electronics or RetroClinic 1770/2 daughter board
with the Mk.2 blitter you may need to add about 1.5cm of height to the Blitter
this can be achieved by piggybacking 5 turned-pin 40pin dip sockets on the
end of Blitter to CPU socket riser plug.

When fitted the board should look like this:

**Mk.2**

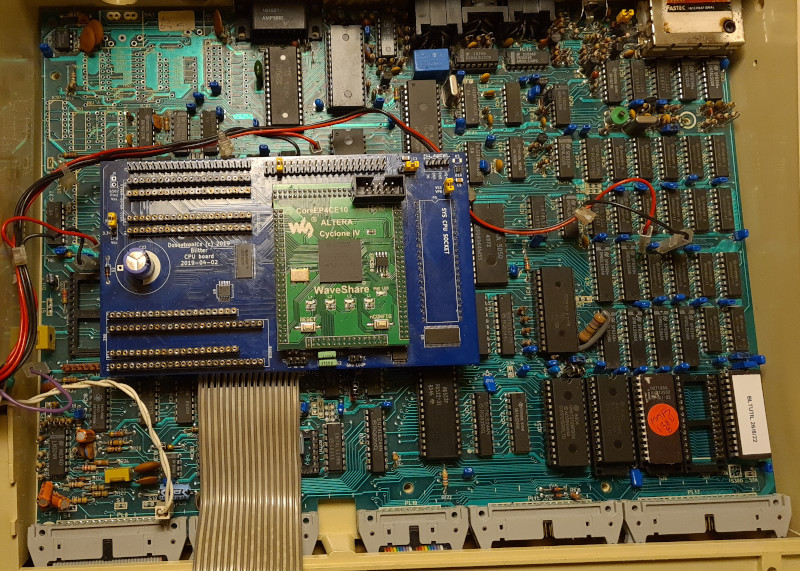
[picture p8: doc/assets/getting-started/mk2-first-boot-fitted.jpg]


**Mk.3**

TODO

Double check by looking under the board as best you can that the pins of the 
riser are correctly aligned with the motherboard CPU socket.

# First boot

You should power-up with the R key held down which should reset the 
configuration. Note: this will only work if your BLTUTIL ROM is newer than 
Nov 2024.

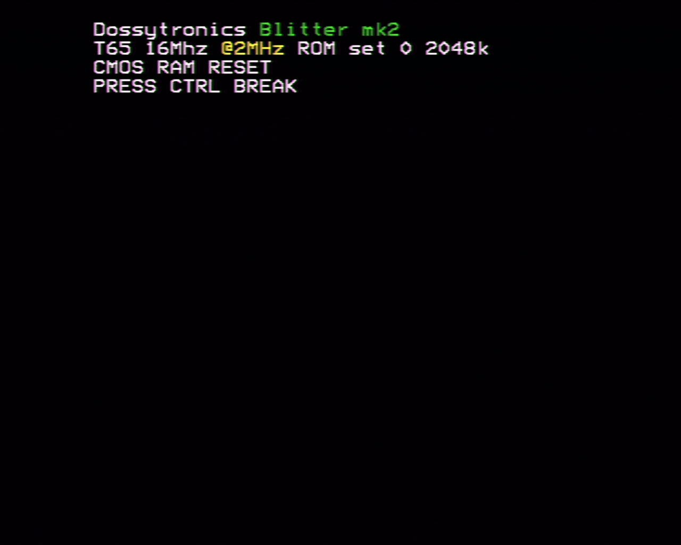
[picture p9: doc/assets/getting-started/mk2-cmos-reset-1st.jpg]


You can now press CTRL-BREAK to get to the normal boot screen.

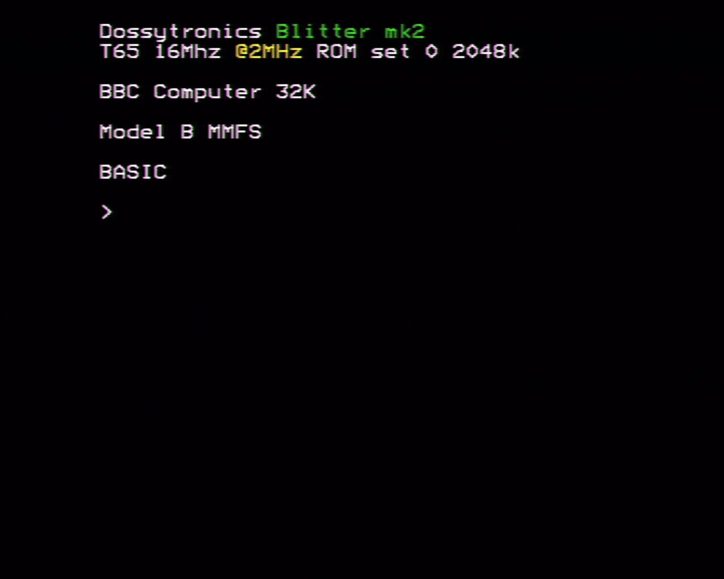
[picture p10: doc/assets/getting-started/mk2-first-boot.jpg]


If the machine doesn't boot then switch off and work through the 
[Troubleshooting](#troubleshooting) section.

You should then be able type type

    *ROMS

at the command prompt and receive a display of the ROMS in the machine thus:

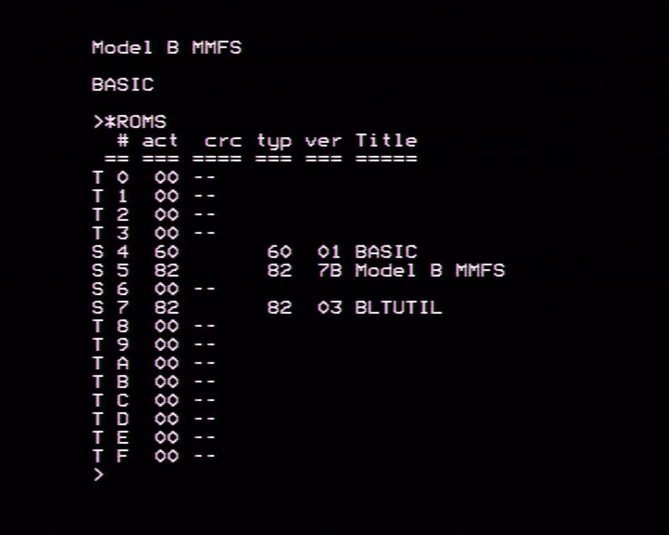
[picture p11: doc/assets/getting-started/empty-roms.jpg]


The ROMS that show through in slots #4-#7 should correspond to those fitted
in the motherboard. (Indicated with an S for System board). The other ROMS are
all marked as T to show that they are throttled.

The following sections will discuss loading up the default set of ROMs
you may have been supplied with a board which is pre-loaded with ROMs in 
which case you may want to skip all or part of the following sections.

# Configuration

The Blitter allows you to save some configuration to an on board EEPROM and
gives its own versions of \*CONFIGURE and \*STATUS as found on the Master 
series. There are a number of configuration options which may be set and you
can see what is available by typing

    *STATUS

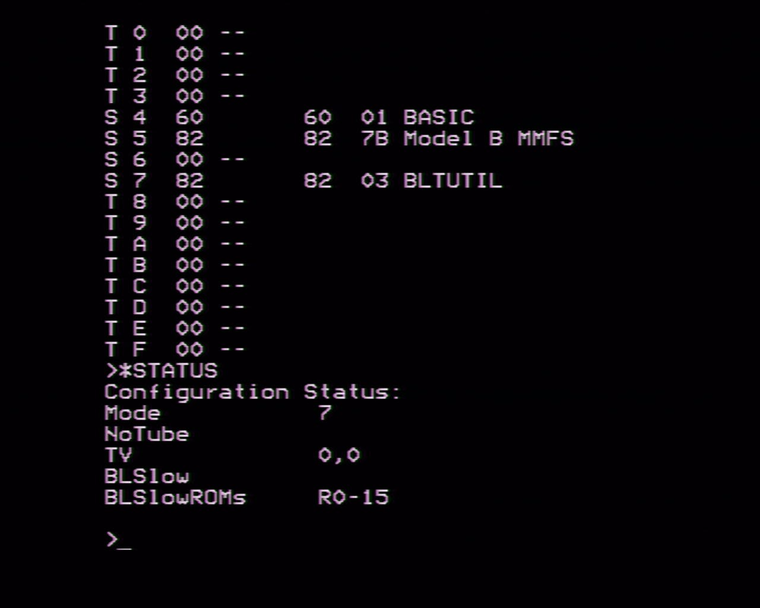
[picture p12: doc/assets/getting-started/status1.jpg]


You can set the options with the \*CONFIGURE command - for more information
on the options see the [BLTUTILS documentation](https://github.com/dominicbeesley/blitter-65xx-code/blob/dev-config/doc/bltutil_readme.md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)

For now we will turn off the throttling of the CPU and the ROMs using the
commands

    *CON. NOBLSLOW
    *CON. BLSLOWROMS -R0-R15

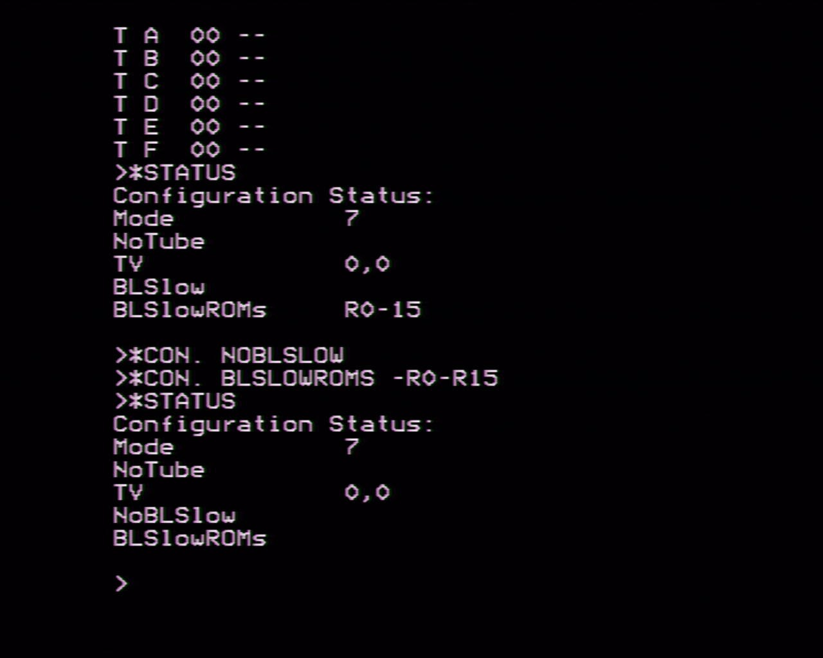
[picture p13: doc/assets/getting-started/con-slow-off.jpg]


You should now press CTRL-BREAK to update the current settings from the CMOS.

Typing

    *ROMS

will show the ROMs are now no longer all marked with 'T'

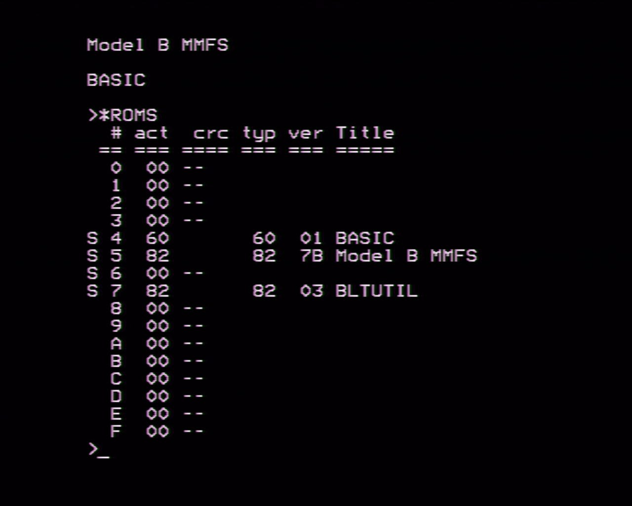
[picture p14: doc/assets/getting-started/empty-roms-fast.jpg]


# Loading other ROMs

This section will guide you through loading some ROMs to the slots provided
by the Blitter card.

When following these examples the syntax of the BLTUTIL ROM utilities can
be found on the [GitHub Wiki](https://github.com/dominicbeesley/blitter-vhdl-6502/wiki/BLTUTIL-Star-Commands)

## Load BLTUTILS to slot \#F (15)

It is desirable to have the utility ROM be in the highest slot:
 * the NoIce debugger only works in slot F
 * holding down "£" at boot can be used to "catch" corrupted ROMs (see 
   [Troubleshooting](#troubleshooting))
 * The Hazel feature for Model B, Electron machines only works on ROM slots 
   with a number below that of the BLTUTIL ROM

Please use the ROMS65.SSD file with your filing system. In this example it
is on MMFS

    *DIN 0 ROMS65
    *SRLOAD BLTUTIL F

This will load the ROM in slot F of the current map. You should get the 
following:

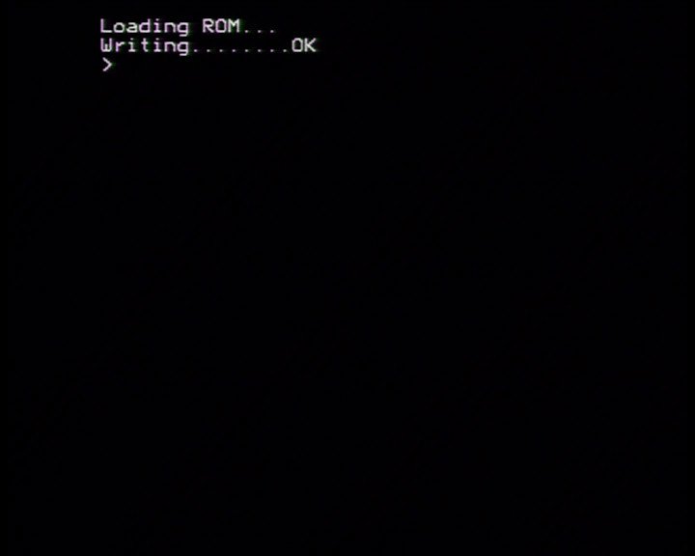
[picture p15: doc/assets/getting-started/srload-output.jpg]


You should now press CTRL-BREAK to refresh the MOS ROM table. Typing:

    *ROMS

Should now show

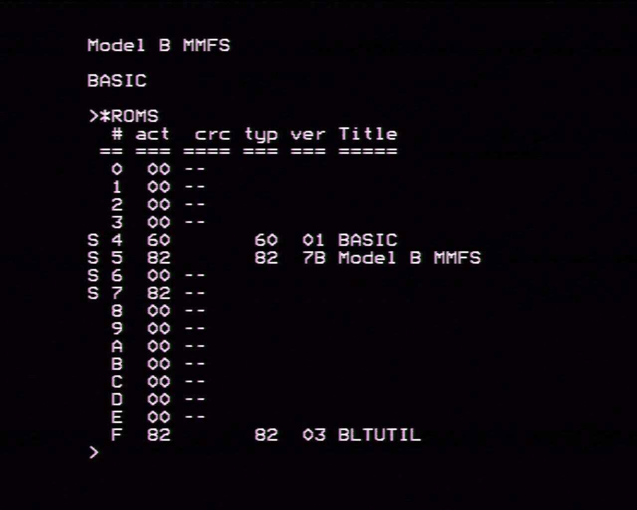
[picture p16: doc/assets/getting-started/srload-2.jpg]


The OS has now disabled the ROM at #7 as it is identical to the one in 
slot #F. 

Note: if you attempt to overwrite the current BLTUTIL rom at any time
the load should work but you will not be returned to the command prompt, 
instead the machine will hang after the "...OK" message. This is deliberate
you will need to press CTRL-BREAK to get the MOS to reload the ROMS table.

You can at any time add a parameter "A" to the \*ROMS command and it will
show all the ROMS, even those ignored by the MOS

    *ROMS A

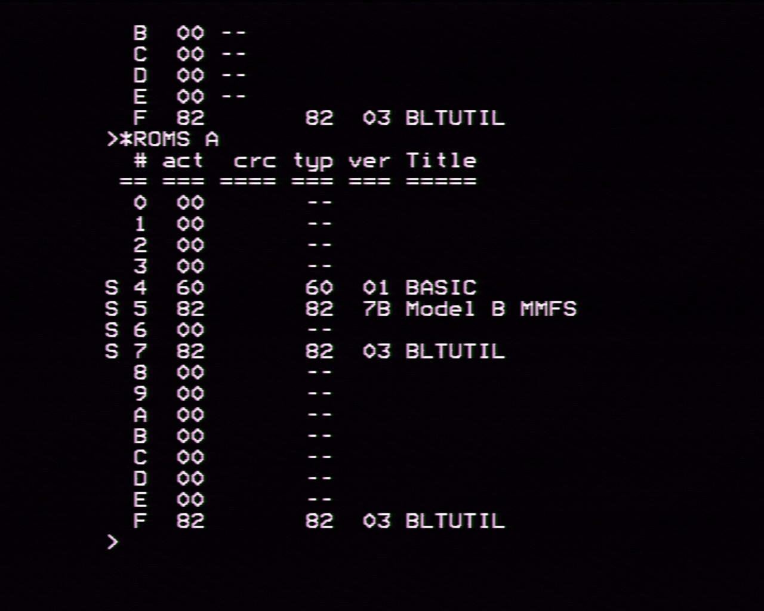
[picture p17: doc/assets/getting-started/roms-a.jpg]


There are also options 

  * "V" to show more verbose ROM titles (including version)
  * "C" to show a CRC for each ROM

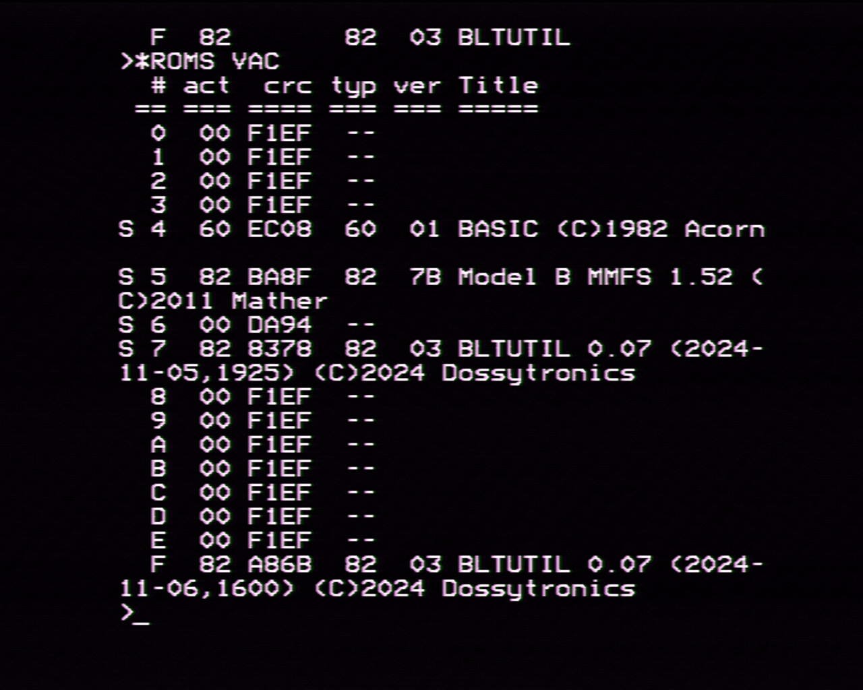
[picture p18: doc/assets/getting-started/roms-vac.jpg]


It can be useful to keep a note of ROM CRCs when they are first loaded,
especially to sideways RAM to check for corruption. Here you can see that
the ROMS at #7 and #F have the same CRC.

You could now remove the BLTUTILs ROM from the motherboard however it
is not recommended as it can be useful to use the MEMI jumper to boot
with the Blitter ROMs disabled. (see [Troubleshooting](#troubleshooting))

## ROM Notes

In map 0 the slots #4-#7 map directly to the four motherboard sockets
and the MOS ROM is taken from the motherboard socket

In map 0 (the default map, for alternate map see [Alternate ROM sets](#alternate-rom-sets))
the even numbered slots map to battery backed RAM and odd numbered slots
map to Flash EEPROM. There is little difference between the two except
that RAM is marginally faster but is more susceptible to accidental 
erasure or corruption

## VideoNULA

Some of the demos in this document work best when there is a VideoNULA 
fitted. They use the advanced palette features of the NULA. However, 
the demos will run without the NULA but the colours will be wrong.

The VideoNULA ROM be present in the machine. You may either install it 
in the spare motherboard slot or load it to a spare sideways ROM socket. 
You should insert the disc/image supplies with your NULA and type

    *SRLOAD NULA 3

Note: it is worth loading ROM images for frequently used and important
ROMS to odd-numbered sockets or to a motherboard socket (4-7) as the
sideways RAM sockets are more prone to becoming corrupted by errant
software.

# Try out CLOCKSP

You may now check to see the speed of the system:

    *DIN 0 TOOLS65
    CHAIN"CLOCKSP"

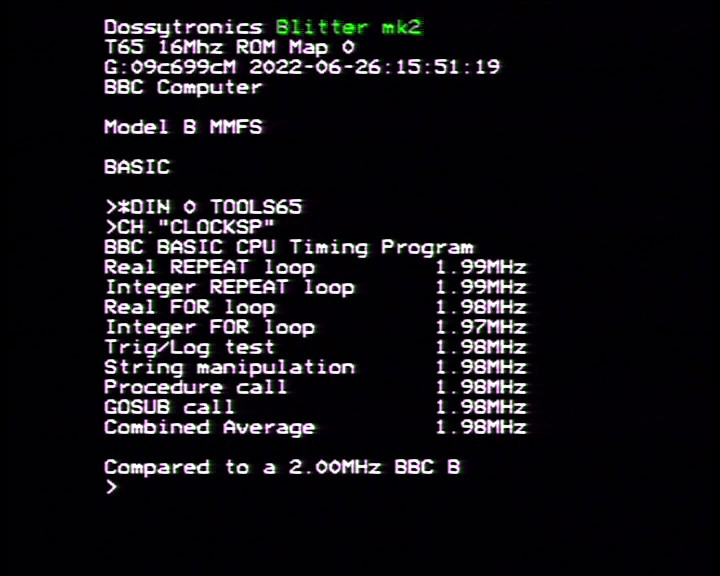
[picture p19: doc/assets/getting-started/clocksp-base.jpg]


As can be seen this is running at 2MHz. Even though the T65 core is 
capable of running at up to 16MHz per cycle on this firmware it is being
held back to 2MHz by the fact that the BASIC ROM, MOS and RAM are all being
accessed from the motherboard which has a maximum speed of 2MHz.

We could make BASIC a little faster by loading the BASIC ROM in to a Blitter
sideways RAM socket:

    *DIN 0 ROMS65
    *SRLOAD BASIC2 E

And press CTRL-Break

    *DIN 0 TOOLS65
    CHAIN"CLOCKSP"

<img src="assets/getting-started/clocksp-f2.jpg" width="600"" />

This has more or less doubled the speed of BASIC but we can do more:

    MODE 7
    *BLTURBO L7F
    RUN

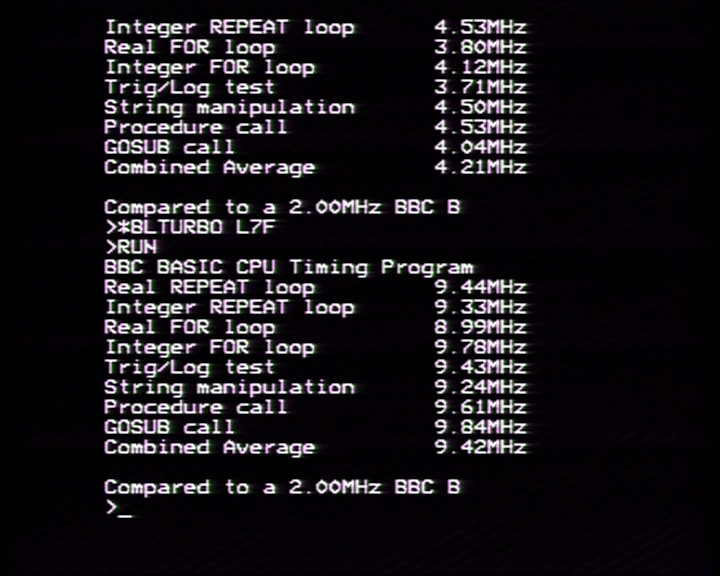
[picture p20: doc/assets/getting-started/clocksp-f3.jpg]


The [BLTURBO Lxx](https://github.com/dominicbeesley/blitter-vhdl-6502/wiki/Command:BLTURBO) 
command with the "L" switch will copy low memory in the range 0..7FFF to 
fast Blitter ChipRAM and then redirect CPU accesses to use this RAM. Each bit
in the number after "L" indicates a block of &1000 that will be redirected so
in our test above the memory 0-6FFF is taken from ChipRAM and 7000-7FFF is
on the motherboard.

The reason we had to switch to MODE 7 is that the MOS is currently unaware of
this remapping and will write any screen bound information to ChipRAM where there
is a remapping.

i.e. switch to MODE 0 and make the top most bank of memory be remapped    

    *BLTURBO L80

You will now need to type blind:

    MODE 0

The mode should change and give some garbage at the bottom. The data that are
being written to 7000-7FFF are now going to ChipRAM instead of the motherboard
so the video system will display the old data. Repeatedly typing

    *HELP

The help information will write correctly to much of the screen but no the 4K
that we have redirected to ChipRAM

    *BLTURBO L00

will restore the screen.

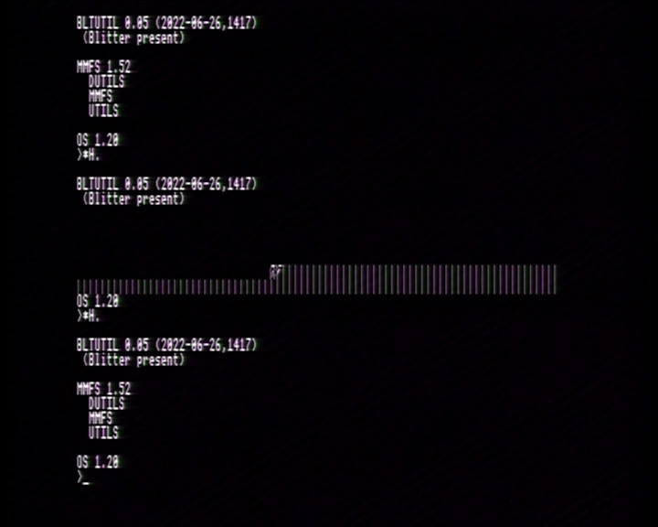
[picture p21: doc/assets/getting-started/blturbo-1.jpg]


We can have mode 0 work normally *and* have faster basic by using 

    *BLTURBO L07

This will remap 0-2FFF to ChipRAM and leave screen ram at 3000-7FFF pointing at
the motherboard

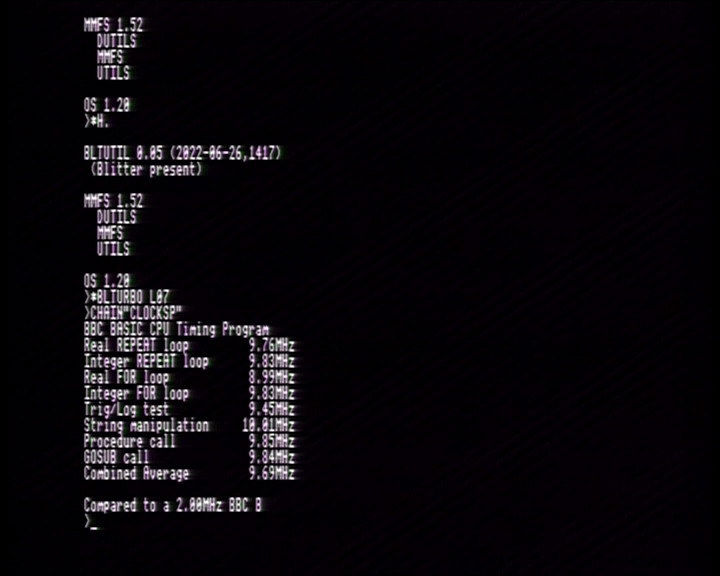
[picture p22: doc/assets/getting-started/blturbo-2.jpg]


Sometimes it is desirable, when ROMs or RAM is remapped to fast memory to have
the T65 run at a stable 2MHz this can be acheived with:

    *BLTURBO T

This will "throttle" the core such that all memory accesses are synchronised
the motherboard's phi2 clock.

One can type 

    *BLTURBO ?

to query the current settings.

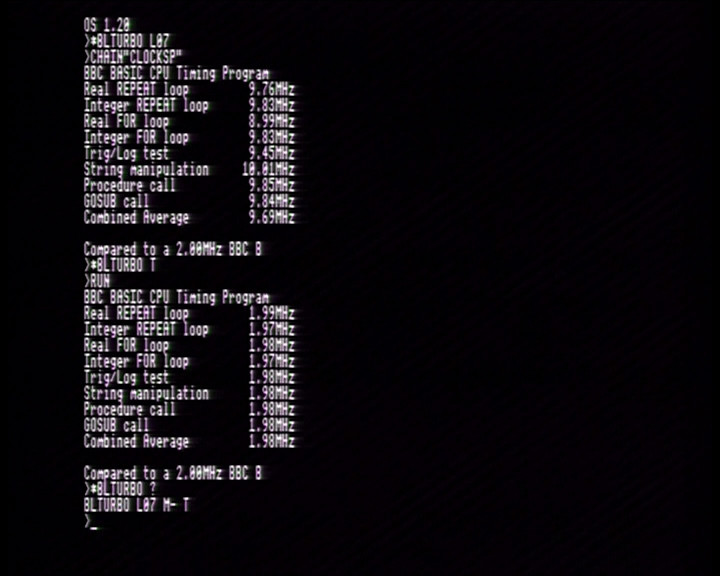
[picture p23: doc/assets/getting-started/blturbo-3.jpg]


When you have finished you may wish to erase the Blitter copy of the BASIC2 rom

    *SRERASE E

This command can be used to clear any ROM/RAM slot (including motherboard sockets
where sideways RAM is fitted).

And CTRL-BREAK - you may find the machine crashes when deleting the current 
language!

# Testing Sound

The Blitter board contains a Chipset feature called Paula which is closely 
modelled on the Amiga's Chip of the same name. One of the distinctive features
of the Paula is that it contains several independent channels which can play
sound samples at different sample rates. This is in contrast to newer machines
and many older machines such as the Archimedes etc that require complex 
and CPU intensive digital signal processing to play different notes. The
Paula concept is very much suited to 8 bit machines.

The Blitter board may be hooked up to the BBC Micro motherboard by attaching 
flying leads from the L and 0 pins of the Blitter audio header to the top
and bottom of resistor R172 on the motherboard respectively.

The audio headers are J3 on the Mk.2 and J32 on the Mk.3. The ground loop 
connector (J4 on the Mk.2 LK34 on the Mk.3) should be left un-bridged. 

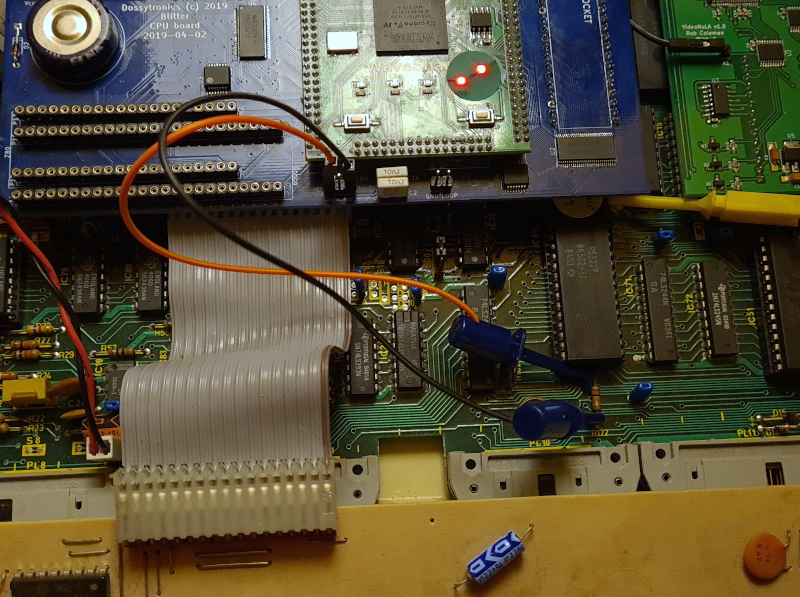
[picture p24: doc/assets/getting-started/mk2-audio-hookup.jpg]


This will mix the Paula sound with that of the BBC Micro and play it out 
through the internal speaker. Of course, it will sound pretty tinny and not
show off the true capabilities through a tiny speaker. 

Other options:
  
  * connect the Blitter as above and then unplug the BBC's internal speaker
    into "PC Speakers" or hifi

  * connect a larger speaker 4-16ohms to the bbc micro's speaker header. The
    LM386 is capable of delivering a few watts which is usually loud enough. 
    Alternatively there are a number of small amplifier modules on ebay which
    will deliver a decent amount of loudness from a single 5V supply which can 
    be source from the BBC motherboard [this is the solution I use]

  * connect some "PC Speakers" or other amplifier direct to the Blitter sound 
    output - you may need to experiment with the ground loop jumper if there 
    is excessive hum. You will not get the BBC motherboard sounds through the 
    speakers

Note: care should be taken when connecting to hifi equipment that the earthing
arrangements of the BBC Micro and Hifi are not incompatible. PC Speakers tend
to be designed to be hooked up to a device such as a desktop PC which is 
referenced to mains earth. If in doubt, ask!

## Playing some tunes

The paula.ssd demo disk contains a handful of tracker modules and a player.
More mod's are available on stardot.org.uk - as these are quite large it is
recommended that .adl or ADFS disks are used as these allow for much larger
trackers and are many times faster to load. (TODO: investigate ADFS MMFS)

    *DIN 0 PAULA
    *EXEC !BOOT

You should now be able to select one of the tunes to play - it may take some
time to load.

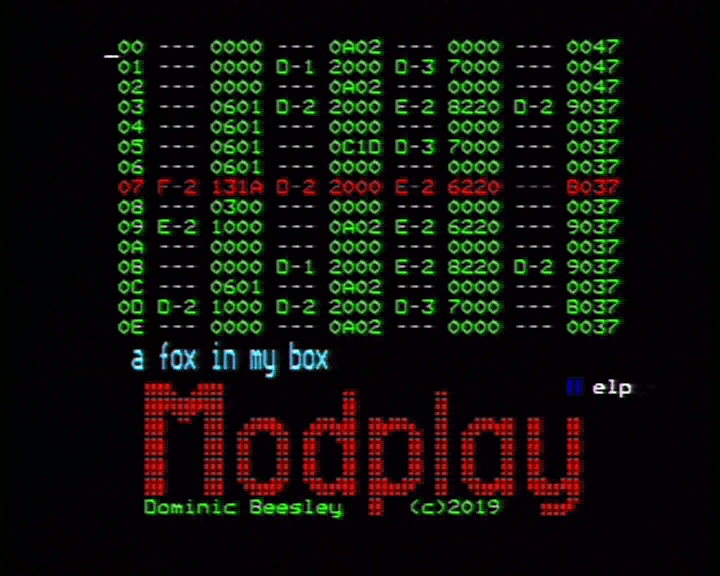
[picture p25: doc/assets/getting-started/modplay-1.gif]


Press H for options or ESCape to stop.

# Blitter

The Blitter Chipset feature is a virtual device for quickly performing
various bitmap operations such as drawing sprites and lines. For more
information see [Chipset](chipset.md#the-blitter)

## Run the demo

    *DIN 0 DEMO65
    *EXEC !BOOT

You should see demo which shows some smoot scrolling of large graphics
at 50 frames a second.

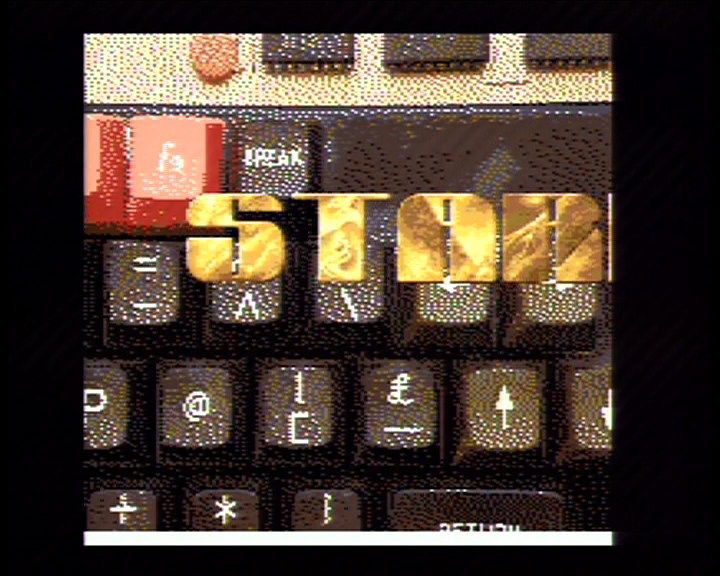
[picture p26: doc/assets/getting-started/demo65.jpg]


# Aeris

The Aeris is a Chipset feature which is analogous to [Copper](https://second.wiki/wiki/copper_amiga)
chip of the Amiga. It can very quickly perform operations that are
synchronised to the position of the display raster with very little
intervention from the CPU. This can produce some advanced graphics
effects such as palette cycling and vertical rupture whilst leaving 
the CPU free to handle game or demo control logic. 

For more information see [Chipset Aeris](chipset.md#the-aeris)

## Hookup the Aeris

To stay in sync with the display raster, whatever the screen mode, the
Aeris needs to monitor the horizontal and vertical sync lines of the 
CRTC controller. To do this please hook up the Blitter board to the 
CRTC as follows:

### mk.2 Aeris Hookup

 * Pin 14 of the configuration header (J5) should be attached to pin 40 of the
   CRTC (IC2, near middle North of the motherboard)
 * Pin 15 of the configuration header should be attached to pin 39 of
   IC2

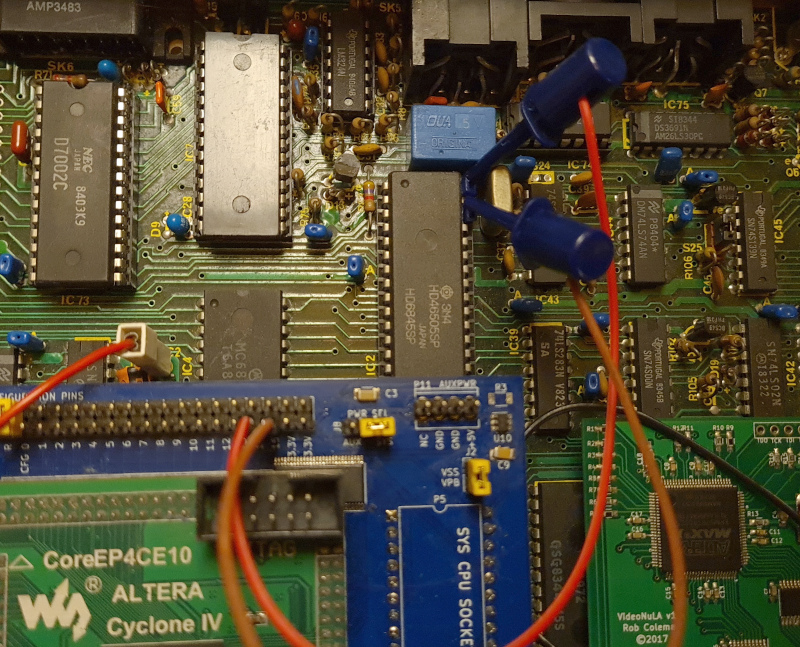
[picture p27: doc/assets/getting-started/mk2-aeris-hookup.jpg]


### mk.3 Aeris hookup

  TODO

## Bigfonts demo

The supplied bigfonts.ssd demo shows off some of the capabilities of the 
Aeris by scrolling some large bitmaps (using the Blitter Chipset) and 
doing various palette cycling and poking:
 
 * the outlines of the letters are cycled once per frame to make them
   appear to move at a different speed to the letters
 * the copper bars redefine the palette on each line without CPU 
   intervention
 * the copper bars are redefined also in the middle of the line

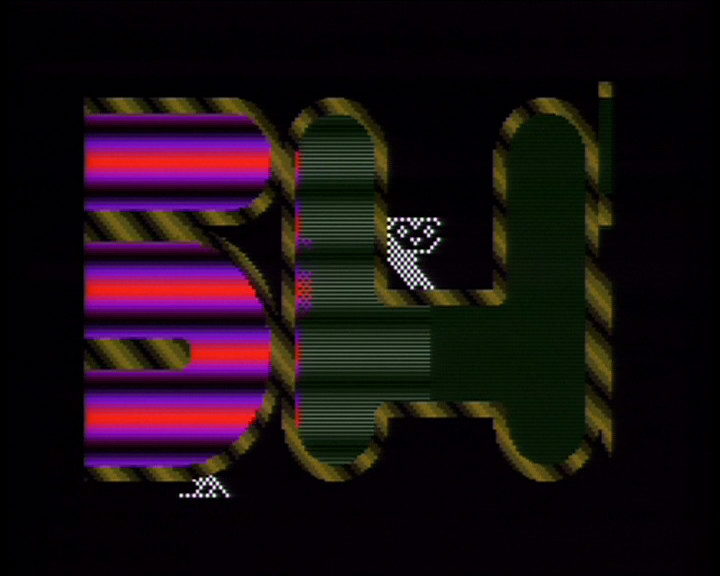
[picture p28: doc/assets/getting-started/bigfonts.jpg]


To show how much the Aeris and Blitter can assist with off-loading CPU
processing this demo is written in C, which is relatively slow, and runs the
CPU at 2MHz.

A further demonstration of the Aeris can be had by going back to the 
music player demo above and pressing the 'A' key. The colours of certain
text-columns in mode 7 are used to form a vu-meter.

# Alternate ROM sets

The Blitter provides a second bank of sideways ROM/RAM which may either be
used as an alternate set of ROMs for the T65 core or as a separate set of
ROMs for a hard CPU.

In this section an example will be given of loading up an alternate ROM set.

Before starting please check that your machine is set to run in Map 0 you
should get a boot message like the one in the picture below the important
parts are circled.

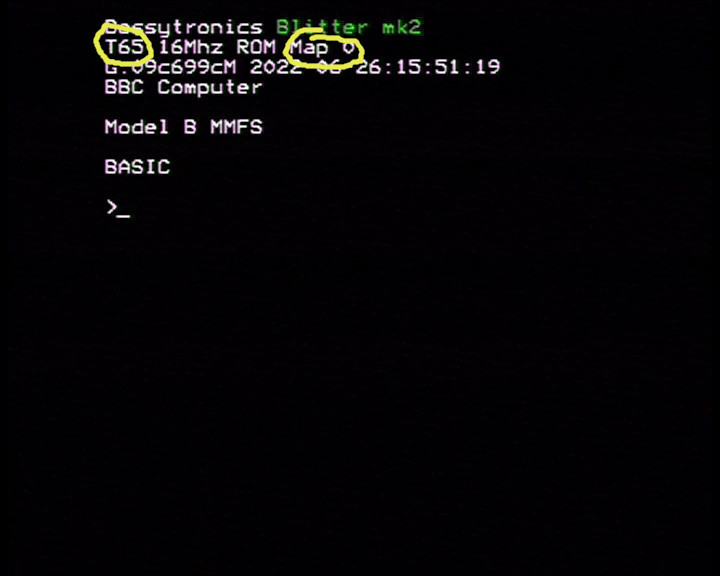
[picture p29: doc/assets/getting-started/mk2-first-boot-map0.jpg]


If you don't please check that the jumpers are set follows:

**MK2**

J5 (config):
  
  - CFG0 FITTED (t65 enabled)
  - CFG4 NOT FITTED (swromx disabled - map 0)
  - CFG5 NOT FITTED (mosram disabled)

Refer to [Hardware overview](harware-overview-mk2.md#j5-system-config)

**MK3**

TODO

## Accessing the alternate ROM set

The SRLOAD, SRERASE and ROMS commands all take an optional X switch which
will display the opposite set map to the one currently being accessed by the
CPU. Alternatively the map to use can be explicitly set by adding a 0 or 1 as
the final parameter.

## Check alternate set is blank

Executing the next line when in T65 mode and the SWROMX jumper is not fitted
will list the alternate ROM set from map 1

    *ROMS ACX

This will be equivalent to executing 

    *ROMS AC1

If you have started with a blank blitter board you should get a display like
this:

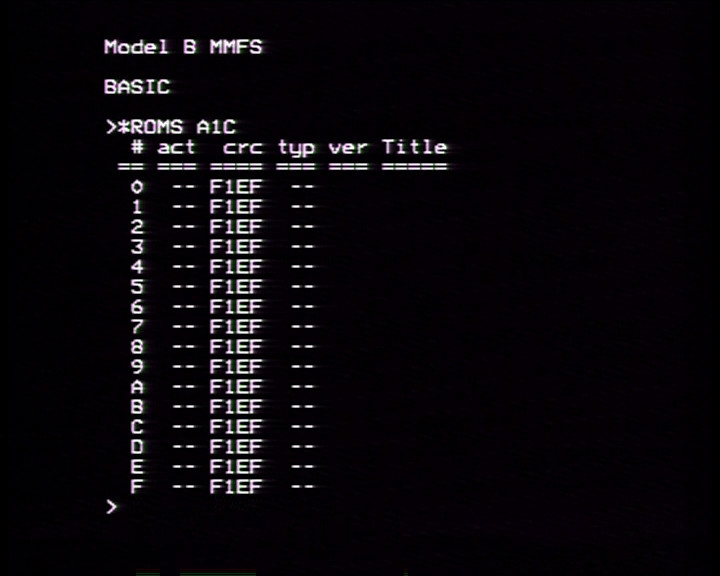
[picture p30: doc/assets/getting-started/roms-alt-all-blank.jpg]


Note: the special CRC F1EF is an indicator that all bytes of the entire 16K 
of each bank is set to the value &FF.

If any of the ROM slots is not blank or doesn't have a CRC of F1EF then
type 

    *SRERASE # 1

replacing # for the number of the non-blank slot.

## Loading up an alternate ROM set

When the Blitter has an alternate ROM set active not only do the sideways
ROM slots come from the alternate ROM set so does the operating system MOS
ROM. For this reason first we will load up an alternate MOS ROM and try
rebooting.

    *DIN 0 ROMS65
    *SRLOAD M.MOS120 9 X

Rom slot #9 in map 1 has a special purpose as it is the MOS rom slot for
that map and therefore should not be used for loading normal ROM images.

You should now type

    *ROMS ACX

and the CRC for slot #9 should now be 4694 which is the CRC of the MOS 
ROM.

You can now try booting to the alternate ROM set by fitting a jumper as 
follows:

**MK2**
    
    J5 - fit jumper to CFG4 (SWROMX)

**MK3**

    TODO

Refer to [Hardware overview](harware-overview-mk2.md#j5-system-config)

You may change the jumper settings any time when the blitter is running
- they will will only take effect after the next time a [long-break](#long-break)
is pressed.

CTRL-LONG-BREAK, you should see:

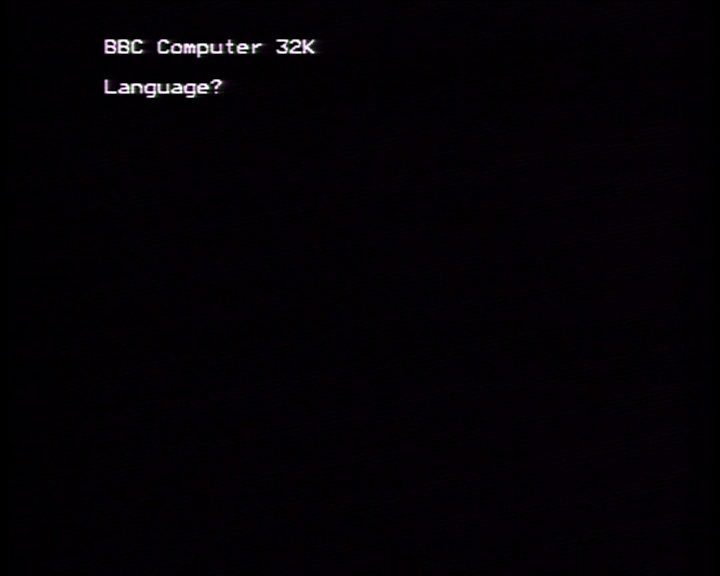
[picture p31: doc/assets/getting-started/roms-alt-boot-lang.jpg]


This shows that the MOS in slot #9 has been recognised but no other ROMS
are present.

Please now switch back to map 0 by removing the SWROMX jumper and reboot
with CTRL-LONG-BREAK.

You should now load up the remainder of the ROMS to the alternate ROM
set:

    *DIN 0 ROMS65
    *SRLOAD BLTUTIL F X
    *SRLOAD BASIC2 3 X

If you are using ADFS, HOSTFS, DFS you may also load these ROMS to the
alternate set. Unfortunately, at present MMFS relies on timing loops to
function correctly and so cannot be run from a Blitter ROM slot. It is 
hoped to have a correction for this in the near future whereby ROM slots
can be marked as throttled.

You should now be able to swap between sets and have a functioning system

# Hard CPUs

The following sections give a brief introduction to running alternate
CPUs in the sockets provided on the Blitter board. 

Please remove the SWROMX jumper if you fitted it above and perform a 
CTRL-LONG-BREAK.

## Running a 65C02

In this guide you may run either a Rockwell 65C02 or similar at 4MHz or
a faster W65C02S at 8MHz.

The pictures in the example show the W65C02S8P-10 please ensure that
you have selected the correct jumper settings for the speed grade and
supply voltage required. In general most of the older 65C02 chips 
should be run at 5V but the W65C02S (i.e. S suffix) do not run well
at 5V due to their requirement for a larger voltage swing on the data
and control lines.

**MK2**

Insert the CPU into the board as pictured and set the CPU configuration
jumpers as follows:

 * for 4MHz or faster parts fit CFG3 and leave CFG1 and CFG2 empty
 * for 8MHz or faster parts fit CFG2 and leave CFG1 and CFG3 empty

For further information see [Hardware overview Mk.2](hardware-overview-mk2.md#j5-system-config)

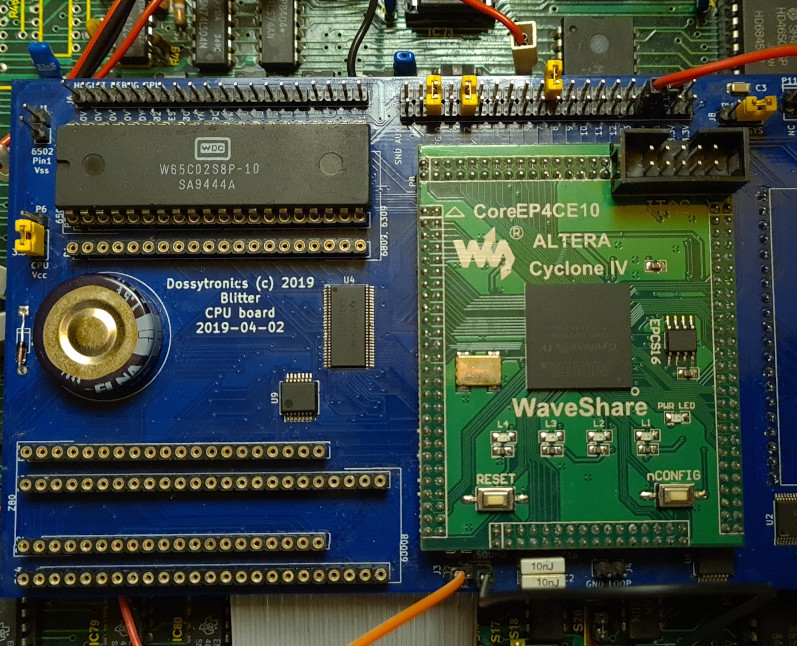
[picture p32: doc/assets/getting-started/w65c02s-fit.jpg]


Please ensure that:

 * the Pin 1 notch is to the West
 * the CPU is in the topmost CPU slot

### Loading ROMS and MOS

The hard CPU needs its own set of ROMS separate to those used in normal
T65 mode. These should be loaded as follows:

    *DIN 0 ROMS65
    *SRLOAD BLTUTIL F X
    *SRLOAD BASIC2 7 X
    *SRLOAD MOS120 9 X

Note: the X modifier after the ROM slot indicates that it should be loaded
to the other bank

The last of these commands loads the MOS operating system ROM into slot 9 
in map 1 - this is a special slot in that it is used to provide the MOS rom.

You should check that these, and no other, ROMs are loaded to map 1 by typing

    *ROMS ACX

Which will list all the ROMs in map 1 along with their CRC. your list should
look like this:

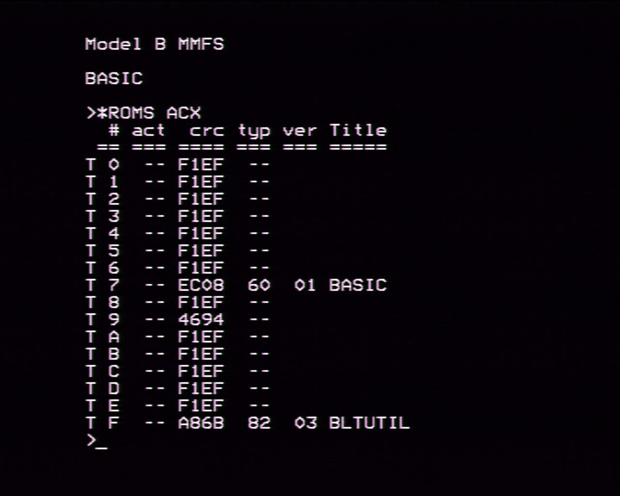
[picture p33: doc/assets/getting-started/w65c02-roms-1.jpg]


Any unwanted roms should be unloaded using

    *SRERASE # X

for each unwanted ROM, substituting the ROM number as appropriate.

You are now ready to boot to the alternate ROM set. You should remove the 
jumper from CFG0 to disable to disable the T65 CPU and perform a 
CTRL-LONG-BREAK.

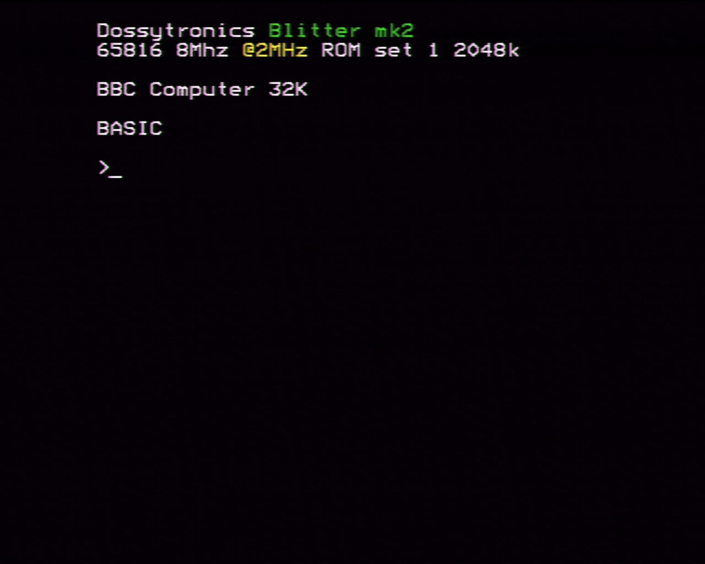
[picture p34: doc/assets/getting-started/w65c02-boot-1.jpg]


If you have problems such as a garbled or rolling screen you may need to hold
down R and press CTRL-BREAK to reset the CMOS configuration.

Notice that the boot message now says "65C02 8MHz". You may also type

    *BLINFO

as a command to see the configuration.

As the boot banner notes and the ```\*ROMS``` command will show the CPU and
ROM slots are all throttled to 2MHz you should enter the following commands, 
as you did for the T65 soft CPU, to set them to full speed:

    *CON. NOBLSLOW
    *CON. BLSLOWROMS -R0-R15

There's not much you can do other than type in BASIC programs as there is
no filing system present yet.

Switch back to T65 by refitting CFG0 and pressing CTRL-LONG-BREAK.

    *DIN 0 TOOLS65
    LOAD"CLOCKSP"
    PRINT ~PAGE

This will load the CLOCKSP program to memory and display page which will be
something like "E00" or "1900". Remove CFG0 and press CTRL-BREAK again. Then
execute the commands below, substituting XXXX for the value of page from 
above.

    PAGE=&XXXX
    OLD
    LIST

You should now see the CLOCKSP program listed and be able to run it.

    RUN

You should now get the CLOCKSP results you may try using BLTURBO Lxx as 
described [above](#try-out-clocksp)

    *BLTURBO L03
    RUN

This should run somewhat faster. Note depending on the configuration and type
of board you have the CPU may not be able to run at full speed.

You can get some more performance in BASIC by running a new version of BASIC.
Switch back to T65 by refitting CFG0 and loading BASIC 4.32

    *DIN 0 ROMS65
    *SRLOAD BAS432 7 X
    *DIN 0 TOOLS65
    LOAD "CLOCKSP"

Then switch back to the 65C02 by removing CFG0 (t65) and pressing CTRL-LONG-BREAK.

    PAGE=&XXXX
    OLD
    RUN

CLOCKSP should now run significantly faster, especially the Trig/Log test.

Copying files from the T65 to the 65C02 like this is somewhat laborious. So, 
you will probably want now to switch back to T65 mode and load the ROM images
for your favoured filing system and other utility ROMS to the alternate ROM
set. Use SRLOAD but do remember to use the X modifier as appropriate.

### Loading a filing system

You may now switch back to T65 mode and can load a filings system ROM to the
alternate ROM set using 

    *SRLOAD XXXX 3 X 

substituting the filename of a filing system ROM image for XXXX.

The following filing systems are tested and known to work

    * DFS 2.26
    * DFS 0.90
    * ADFS 1.3\*
    * HOSTFS
    * MMFS

Other filing systems may or may not work. Please report any difficulties on
the startdot forum.

Note: the supplied roms65.ssd contains BLMMFS and ADFSH30 which are special
Blitter enhanced versions of ADFS130 and MMFS (User port) for the BBC Micro
which leave PAGE at E00.

## Running a 65816

The Blitter supports a w65c816s as a hard CPU. The 65816 can operate almost
identically to a 65C02 processor and the ROM set and tests described above in
the 65C02 can be utilised but it is important still to set the jumpers 
specifically for the 65816 as it uses slightly different control signals and
damage could occur if these are not set first.

**MK2**

The speed grade of the CPU should be 8MHz or higher. Due to the fact that
the 65816 needs CMOS voltage levels on the data-bus it is important that
the 65816 voltage be set to 3.3V on P6.

Insert the CPU into the board as pictured and set the CPU configuration
jumpers as follows:

 * fit CFG2 and CFG3 and leave CFG1 empty

For further information see [Hardware overview Mk.2](hardware-overview-mk2.md#j5-system-config)

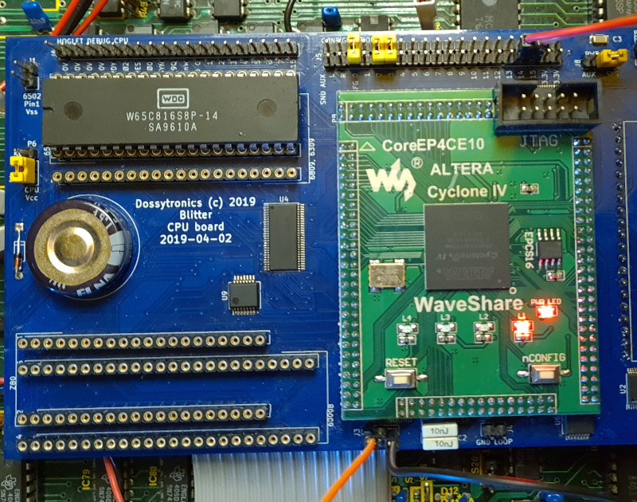
[picture p35: doc/assets/getting-started/w65c816s-fit.jpg]


Please ensure that:

 * the Pin 1 notch is to the West
 * the CPU is in the topmost CPU slot

You should can now try all the same tests as for the 65C02. Please follow the
instructions from the section *Loading ROMS and MOS* for the 65C02 above.

### 65816 Communicator BASIC

The 65816 has advanced facilities such as addressing up to 16MB of memory and
extra instructions. There is not much software yet to take advantage of this

However, there is a 65816 specific version of BBC BASIC which has been ported 
which is available at https://github.com/dominicbeesley/CommunicatorBasic100/releases

You should be able to run this extended version of BASIC by mounting the 
SSD (BAS816_BLIT.SSD) and executing !B00T. Ensure that you are running 
in hard cpu (not T65) mode:

    *DIN 0 BAS816BLIT
    *EXEC !BOOT

This should load up some files and return a > prompt. Typing 

    REPORT

should show "6816 BASIC (c) 2020 Dossy". 

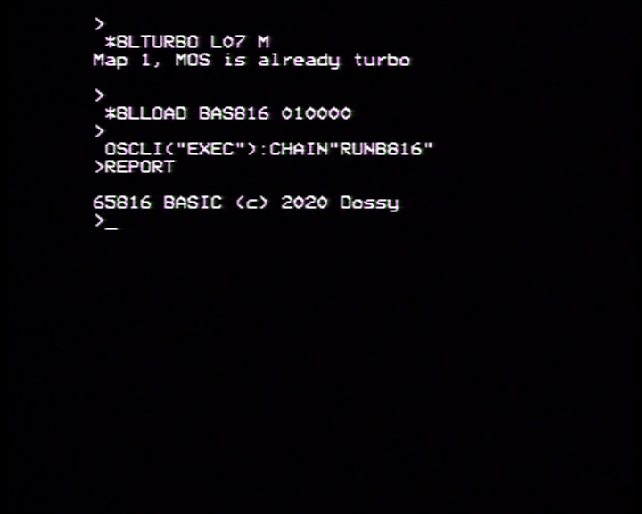
[picture p36: doc/assets/getting-started/bas816-1.jpg]


You may now run BASIC programs as normal i.e. CLOCKSP:

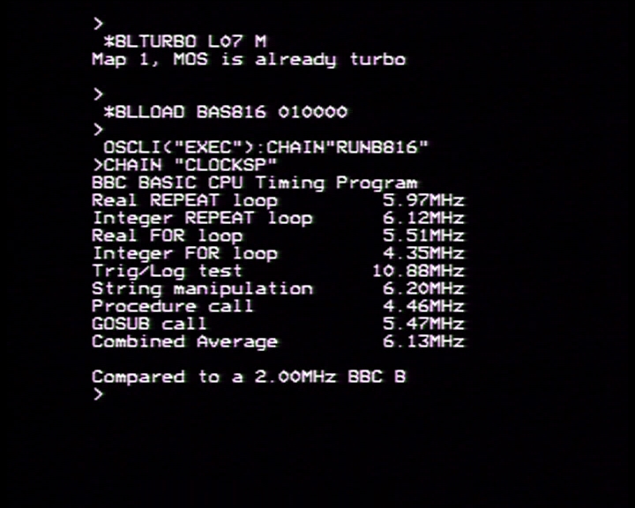
[picture p37: doc/assets/getting-started/bas816-2.jpg]


This will be somewhat slower than the figures obtained for a 65C02 running 
BASIC 4.32 but this is explained, in part, by the fact that the BASIC 
interpreter is using larger, slower, 24 bit pointers which allows for much
larger programs and data:

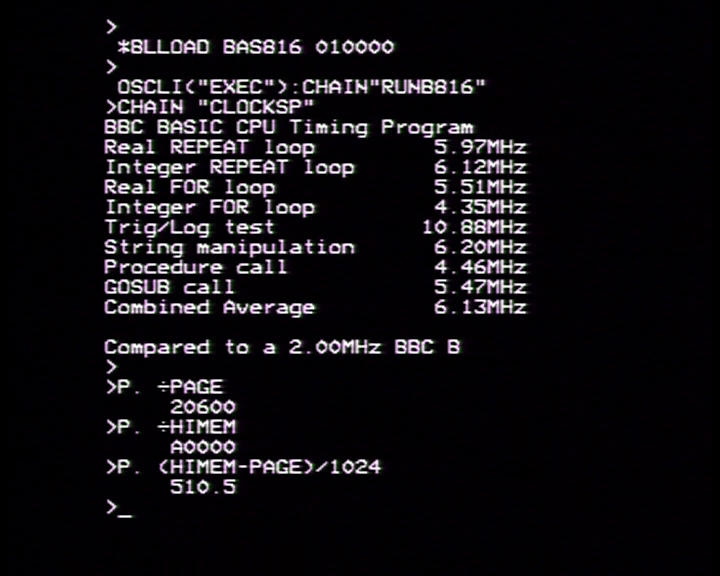
[picture p38: doc/assets/getting-started/bas816-3.jpg]


Currently the program/data size is limited to just slightly less than 512K.
However, if there is sufficient interest, this could be increased.

## Running a 6809 or 6309

The Blitter supports either a 68B09E, 63B09E at 2MHz or a 63C09E at 3.5MHz. 

Before starting this tutorial please remove the MEMI and SWROMX jumpers if
they are fitted and ensure you can boot to T65 mode.

### 2MHz

All the CPUs listed above may be run at 2MHz it is sensible even when using
a 63C09E to try it out at 2MHz first.

**MK2**

The jumpers should be set as follows:

    P6 - 5V
    CFG1 on J5 fitted
    CFG2,CFG3 on J5 clear

For details see [Mk.2 Hardware Overview](https://github.com/dominicbeesley/blitter-vhdl-6502/blob/main/doc/hardware-overview-mk2.md#j5-system-config)

Insert the 6309 in the correct set of pins with pin 1 of the CPU to the left 
and the CPU inserted into the lower of the 6502/6x09 socket pair near the top 
left.

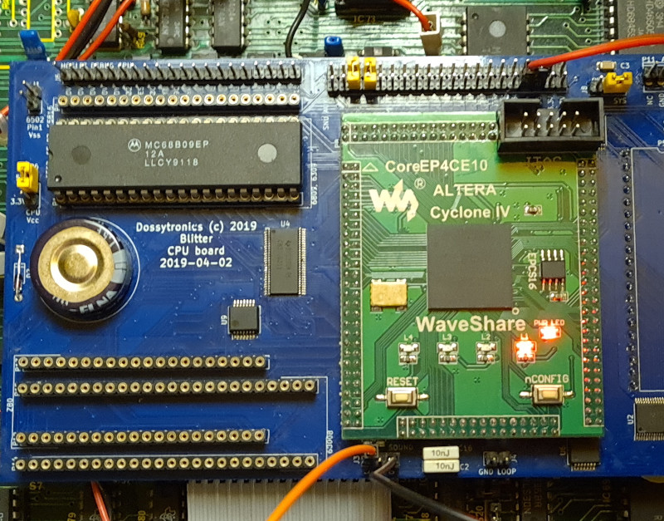
[picture p39: doc/assets/getting-started/6809-fit.jpg]


Please ensure that:

 * the Pin 1 notch is to the West
 * the CPU is in the second highest CPU slot, be careful it overlaps the 65xx
   sockets

## Load 6x09 ROMs

You should now be able to start the machine to load a set of ROMS and an 
operating system.

To double check that you have the configuration selected for the 6809 you can
type 

    *BLINFO

as a command to see the configuration, the hard cpu that is configured
should display even when it is not selected.

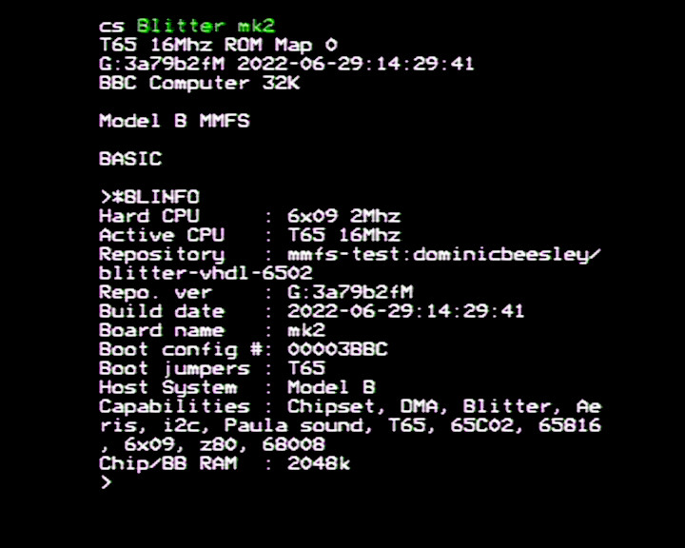
[picture p40: doc/assets/getting-started/6809-blinfo.jpg]


You will then need to load the 6809 MOS and BASIC roms from T65 mode:

    *DIN 0 ROMS69
    *SRLOAD M.MOS6809 9 X
    *SRLOAD R.BASIC 3 X
    *SRLOAD R.UTILS09 F X

and check with 

    *ROMS X

If you get any other ROMS, you should delete them using \*SRERASE # X

Ensure you have loaded from ROMS68 not the 6502 ssd!

You should have these ROMS:

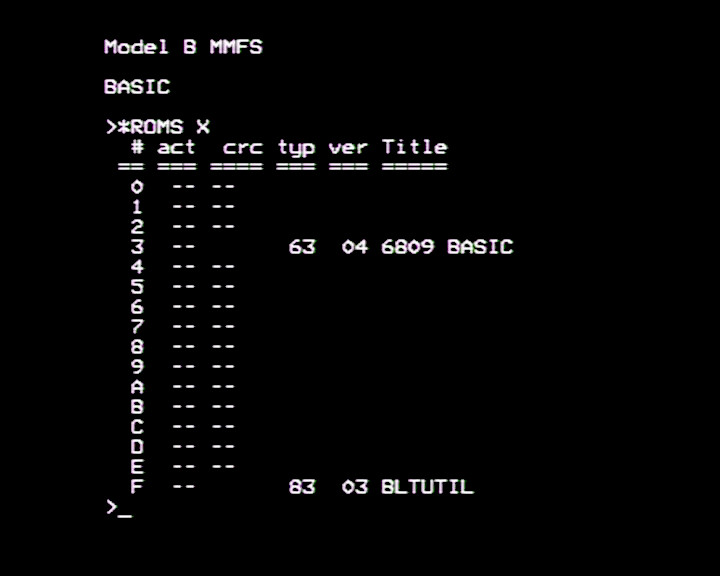
[picture p41: doc/assets/getting-started/6809-roms.jpg]


You should now be able to boot the 6809 by removing the T65 jumper (CFG0) and 
perform a CTRL-LONG-BREAK.

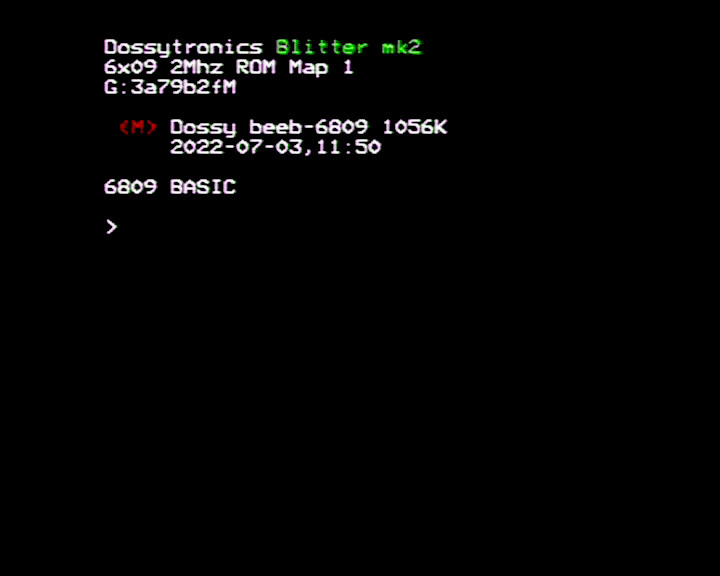
[picture p42: doc/assets/getting-started/6809-boot-1.jpg]


You should get a screen as above. As there is now no filings system there is
not much you can do other than type programs in and try them out.

However, you may use the T65 mode to load BASIC programs into memory and then
access them on the 6x09

Switch back to T65 by refitting CFG0 (t65 enabled) and performing a 
CTRL-LONG-BREAK.

    *DIN 0 TOOLS65
    LOAD"CLOCKSP"
    PRINT ~PAGE

This will load the CLOCKSP program to memory and display page which will be
something like "E00" or "1900". Remove CFG0 (t65) and perform a 
CTRL-LONG-BREAK again. Then execute the commands below, substituting XXXX for
the value of page from above.

    PAGE=&XXXX
    OLD
    LIST

You should now see the CLOCKSP program listed and be able to run it. This
should run a little faster then a 2MHz 6502 

    RUN

### HOSTFS on 6x09

Alternatively the ROMS69.ssd contains a ROM R.HOSTFS which is the HOSTFS 
filing system ported to the 6809. This is set to run with a baud rate of
38,400.

see:
    [https://github.com/sweharris/TubeHost]
    [https://mdfs.net/Software/Tube/Serial/]

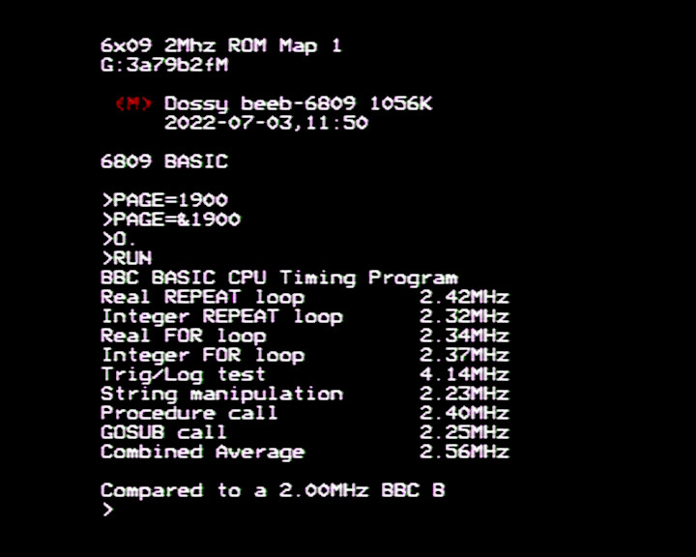
[picture p43: doc/assets/getting-started/6809-clocksp.jpg]


The timings are a little faster but fairly similar to a 6502. This first
comparison is a little flattering of the 6809 as in 2MHz mode it actually
run slightly faster than 2MHz. To give a fairer comparison it is possible
to throttle the CPU to be exactly 2MHz and synchronized with the BBC's 
motherboard clock.

    *BLTURBO T



Now most of the timings are within around 10% of the 6502's times. The
trig/log functions are significantly faster as the 6809 BASIC ROM uses
the algorithms from BBC BASIC 4.32.

The ports of BASIC currently in use for the 6809/6309 have not been 
heavily optimised for the 6809. In future it should be possible to improve
on thse numbers

## 3.5 MHz

If you have a HD63C09E chip then you can run this at 3.5MHz. Change the 
CPU configuration jumpers as below

**MK2**

The jumpers should be set as follows:

    P6 - 5V
    CFG1,CFG3 on J5 fitted
    CFG2 on J5 clear

Note: It has been found that newer MC68B09E CPUs will happily run at 3.5MHz
though it is unlikely that these will support the extended instruction set
of the HD63C09E that is used in the following examples.

You should now be able to reboot to the 6309. You should transfer the CLOCKSP
program to the 6309 using the method above or using HOSTFS. Running CLOCKSP
should now give better results

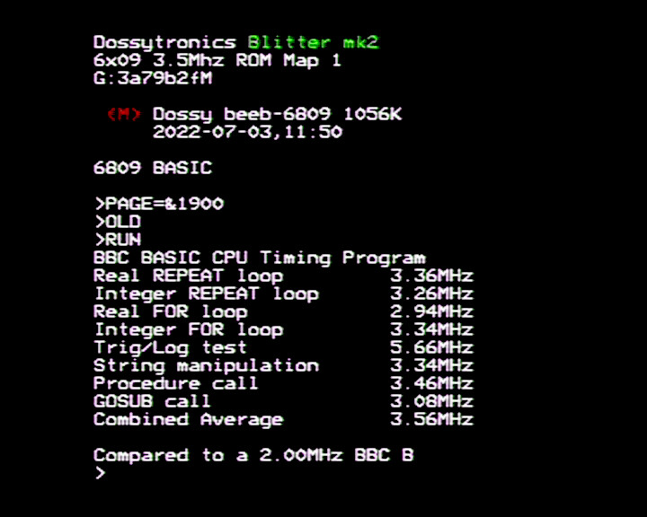
[picture p44: doc/assets/getting-started/6309-clocksp-1.jpg]


This is still somewhat held back by the fact that the memory used to store
the BASIC program is running at 2MHz. You can used the BLTURBO command to 
use fast ChipRAM shadow memory

    *BLTURBO L07

This should give a little more of a boost

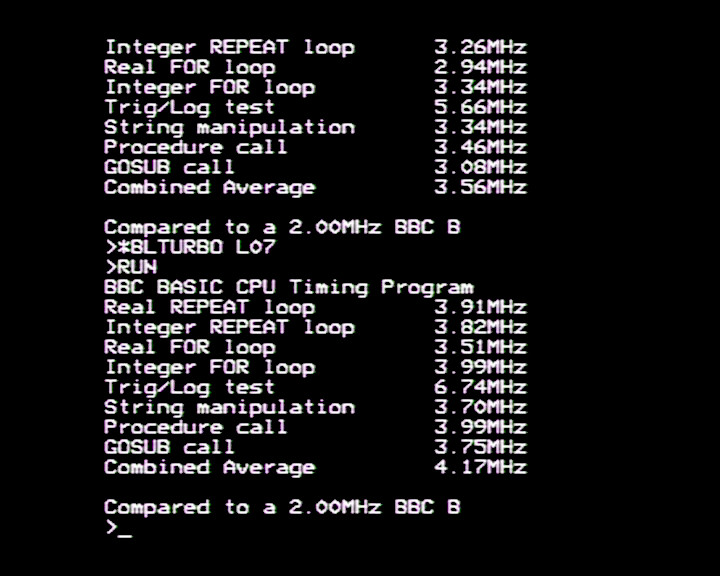
[picture p45: doc/assets/getting-started/6309-clocksp-2.jpg]


However, this is still not using all the facilities of the 6309 processor
which features a "native" mode which runs around 25% faster than the 6809
by eliminating most of the CPUs "dead" cycles. Also, the 6309 offers extra
registers and instructions which may be used to improve performance.

Switch back to T65 mode and load alternate operating system and BASIC ROMS:

    *DIN 0 ROMS69
    *SRLOAD M.MOS630N 9 X
    *SRLOAD R.BAS6309 3 X

Note: the correct MOS filename ends with "N" for native.

Repeating the CLOCKSP tests above (don't forget BLTURBO L07) should give an
even greater improvement.

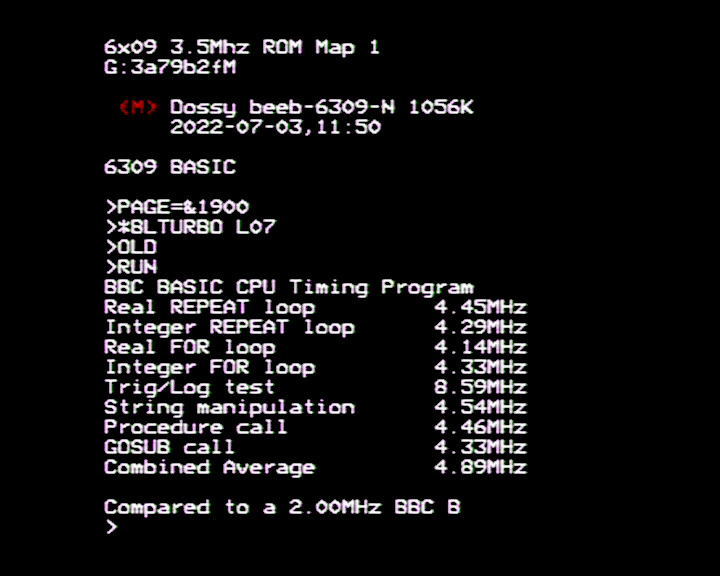
[picture p46: doc/assets/getting-started/6309-clocksp-3.jpg]


6x09 MOS ROMS

  | Filename  | Description
  |-----------|------------------------------------------------
  | M.MOS6809 | The MOS120 ROM for 6809. No 6309 specifics
  | M.MOS6309 | As above with optimisations for 6309
  | M.MOS630N | As above in "native mode". 25% faster

6x09 BASIC ROMS

  | Filename  | Description
  |-----------|------------------------------------------------
  | R.BASIC   | BBC BASIC 4.32 with 6809 assembler
  | R.BAS6309 | BBC BASIC 4.32 with 6309 assembler and 6309 optimisations

6x09 Filing system ROMS

  | Filename  | Description
  |-----------|------------------------------------------------
  | R.HOSTFS  | HostFS over RS423 serial
  | R.HOSTFSM | HostFS over "Myelin" second serial port
  | R.HOSTFST | HostFS over TCP/IP using WizNet ethernet module

# Troubleshooting

## NOTES/Q's for Hoglet

### Default Turbo/Throttle off

Currently the 65xx and 6x09 CPUs by default boot in a trim that allows them
to go as fast as the memory they are accessing will allow. This is usually
not a problem for games as by default they'll run from normal motherboard 
memory at 2MHz but ROMs may run faster which may cause problems (see MMFS
below). Would it be better to boot in "Throttled" mode where these CPUs 
boot strictly limited to 2MHz unless explicitly unlocked?

### BLTURBO L

I've not really given much thought to doing proper shadow memory. It should
be possible to do something akin to the B+ but that will mean some fannying 
around with the MOS? Or maybe just checking for instructions executing from
C000-D000? 

### Rom options

Any preferences on how the sideways ROM/RAM is split I've gone for a 
very arbitrary choice of RAM at even slots, ROM at odd slots and with
the motherboard punching through at slots 4-7 in map 0.

I need to add the following stuff
 * optional write protect on RAM slots
 * optional "slow" setting on non-motherboard slots
 * SRCOPY command

Would a "hard" unplug be useful? Any other requests for ROM management

### 65C02 "soft" CPU

The default fall-back mode is to run with a T65 FPGA core configured as a 
NMOS 6502. This gives maximum compatibility for Elk/BBC. Would it be desirable
to be able to be able to configure the T65 as CMOS - this would allow 
running BASIC 4, etc and possibly other Master compatible stuff but at the 
expense of loss of compatibility.

### MMFS

However, on one machine which otherwise seemed to work OK MMFS returned 
corrupt directories listings and the games menu would crash. Swapping the 
74LS245 (IC14) with and HCT device from another machine solved the problem. 
The swapped out 74LS245 worked ok in the original machine!?!

I've not got MMFS to work when loaded into the Blitterboard sideways ROM or 
RAM but I suspect that is because T65 will try to run at full speed and MMFS
is doing timing loops? If this proves troublesome I have planned but not 
started a facility to mark which ROMs should be allowed to run full speed.
