dominicbeesley/blitter-vhdl-6502/src/hdl/modelC20K/doc/UKWebb/assets/getting-started/816-2-clockspL7F.jpg

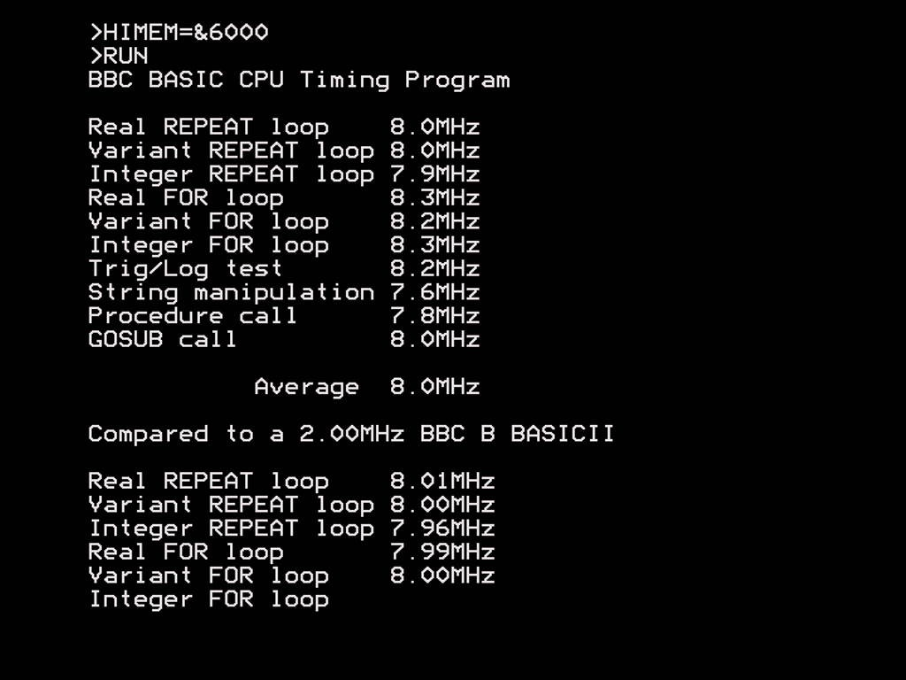
src/hdl/modelC20K/doc/UKWebb/assets/getting-started/816-2-clockspL7F.jpg
