dominicbeesley/blitter-vhdl-6502/src/hdl/modelC20K/doc/UKWebb/assets/getting-started/816-3-clocksp-64.jpg

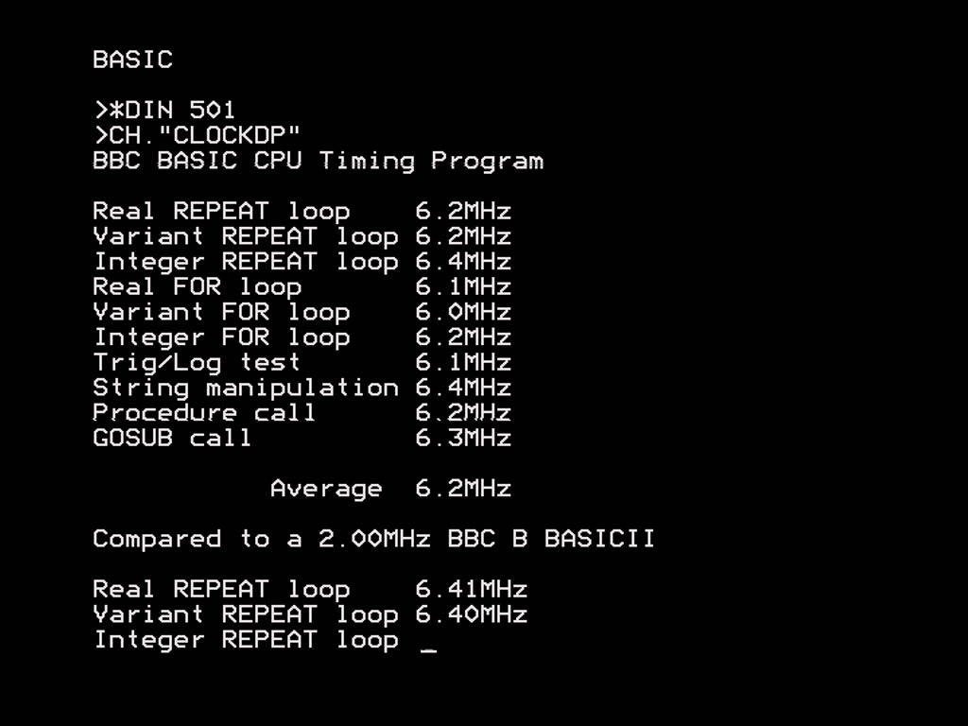
src/hdl/modelC20K/doc/UKWebb/assets/getting-started/816-3-clocksp-64.jpg
