dominicbeesley/blitter-vhdl-6502/src/hdl/modelC20K/doc/UKWebb/assets/getting-started/blturbo-L80-mode0.jpg

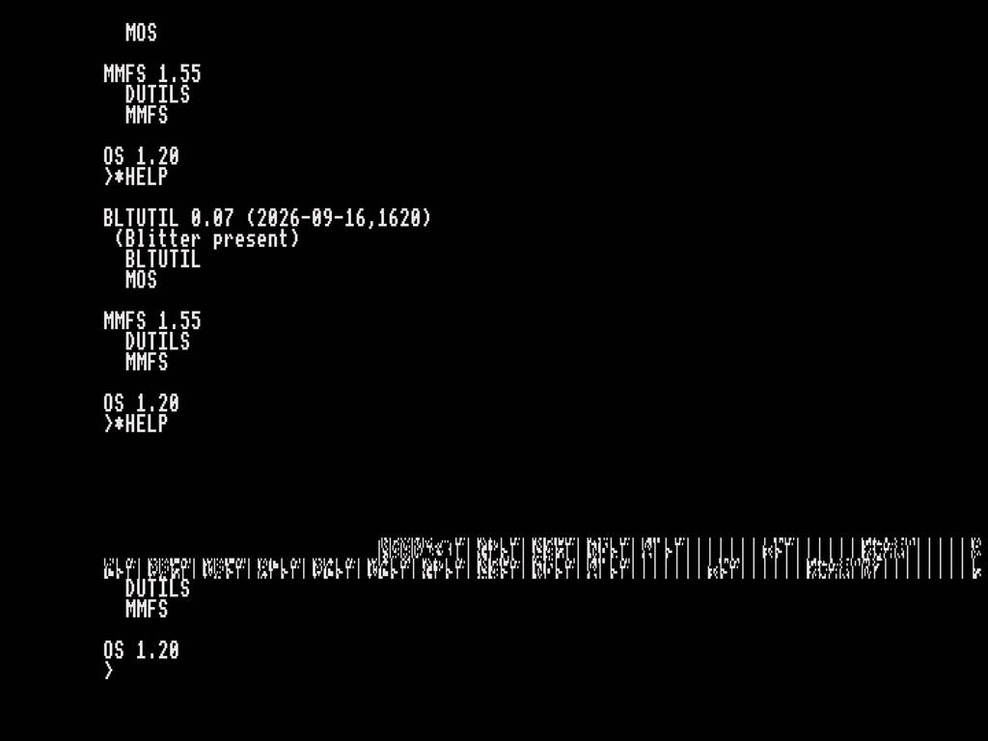
src/hdl/modelC20K/doc/UKWebb/assets/getting-started/blturbo-L80-mode0.jpg
