dominicbeesley/blitter-vhdl-6502/src/hdl/modelC20K/doc/UKWebb/assets/getting-started/preboot2-clear.jpg

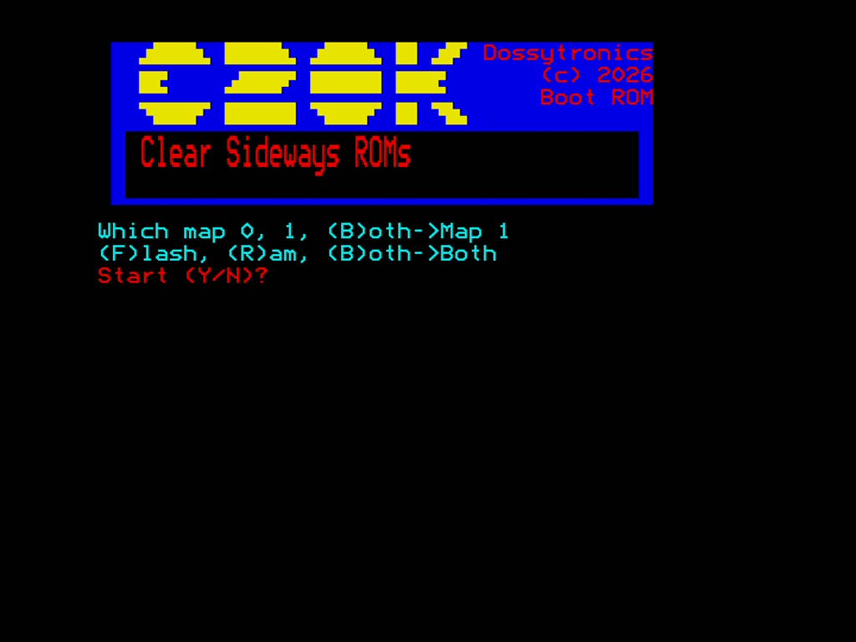
src/hdl/modelC20K/doc/UKWebb/assets/getting-started/preboot2-clear.jpg
