dominicbeesley/blitter-vhdl-6502/src/hdl/modelC20K/doc/UKWebb/assets/getting-started/preboot-3-load-menu.jpg

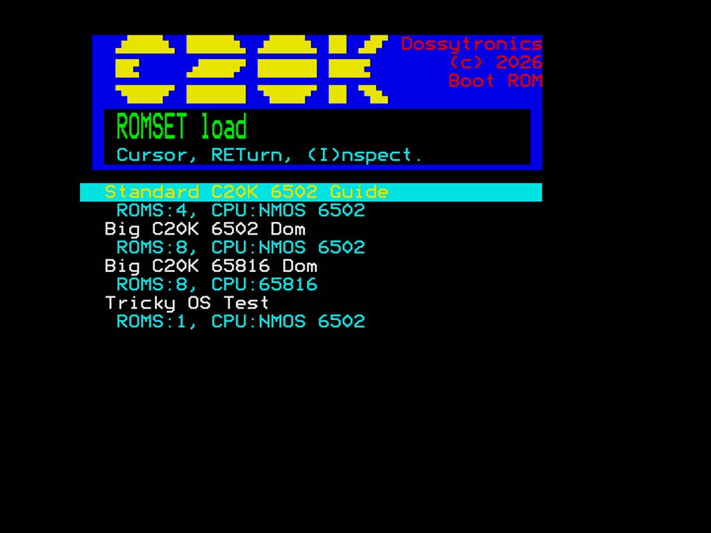
src/hdl/modelC20K/doc/UKWebb/assets/getting-started/preboot-3-load-menu.jpg
