dominicbeesley/blitter-vhdl-6502/src/hdl/modelC20K/doc/UKWebb/assets/getting-started/preboot-4-inspect.jpg

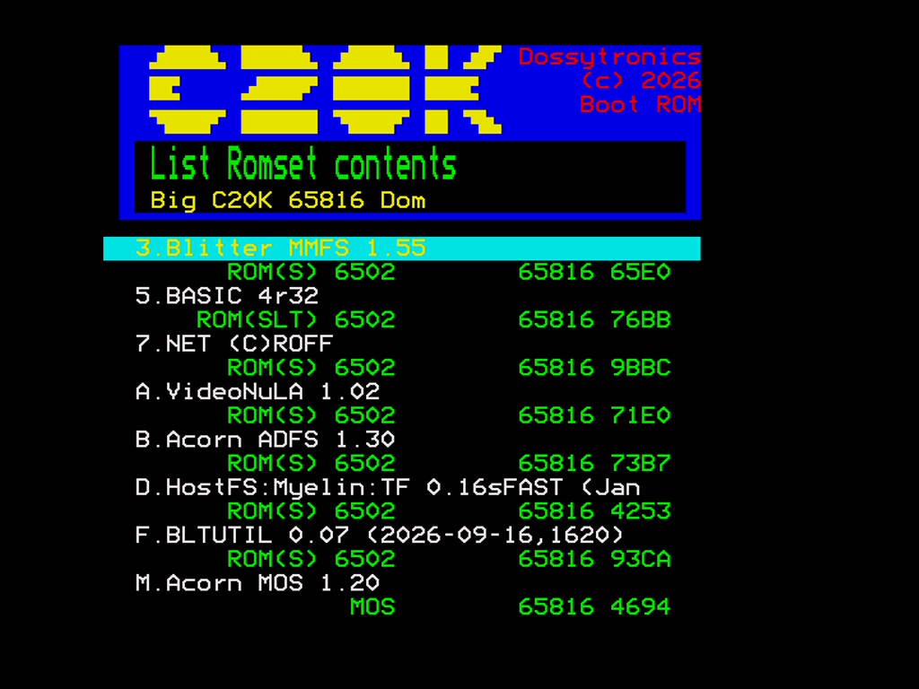
src/hdl/modelC20K/doc/UKWebb/assets/getting-started/preboot-4-inspect.jpg
