dominicbeesley/blitter-vhdl-6502/src/hdl/modelC20K/doc/UKWebb/assets/getting-started/preboot-5-load-1.jpg

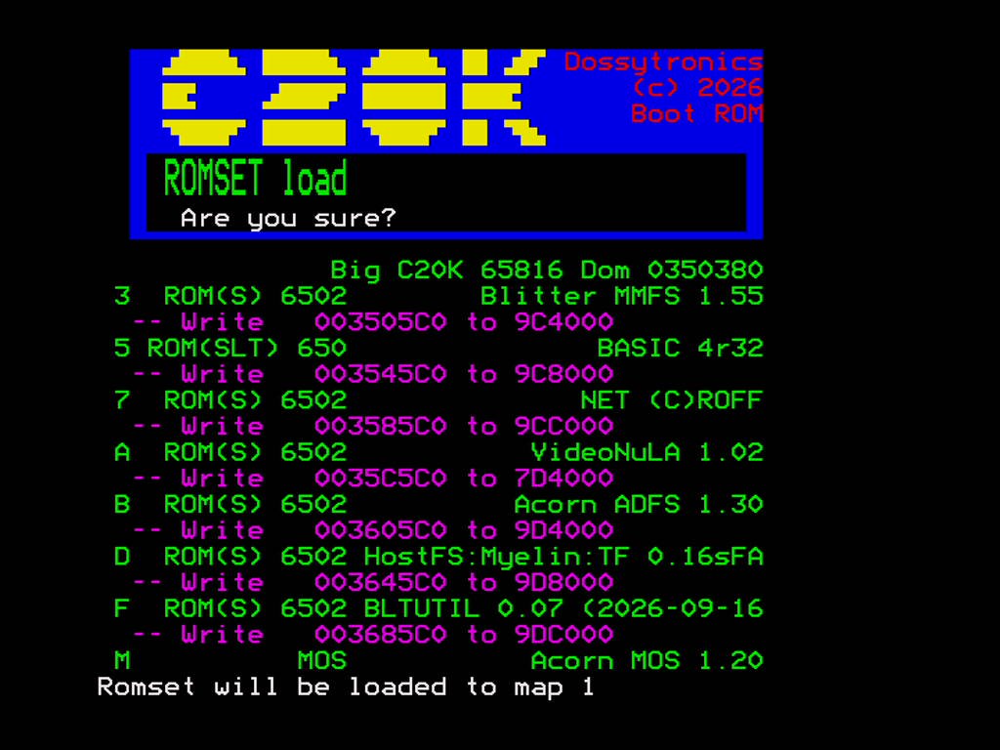
src/hdl/modelC20K/doc/UKWebb/assets/getting-started/preboot-5-load-1.jpg
