dominicbeesley/blitter-vhdl-6502/src/hdl/modelC20K/doc/UKWebb/assets/getting-started/preboot-6-load-2.jpg

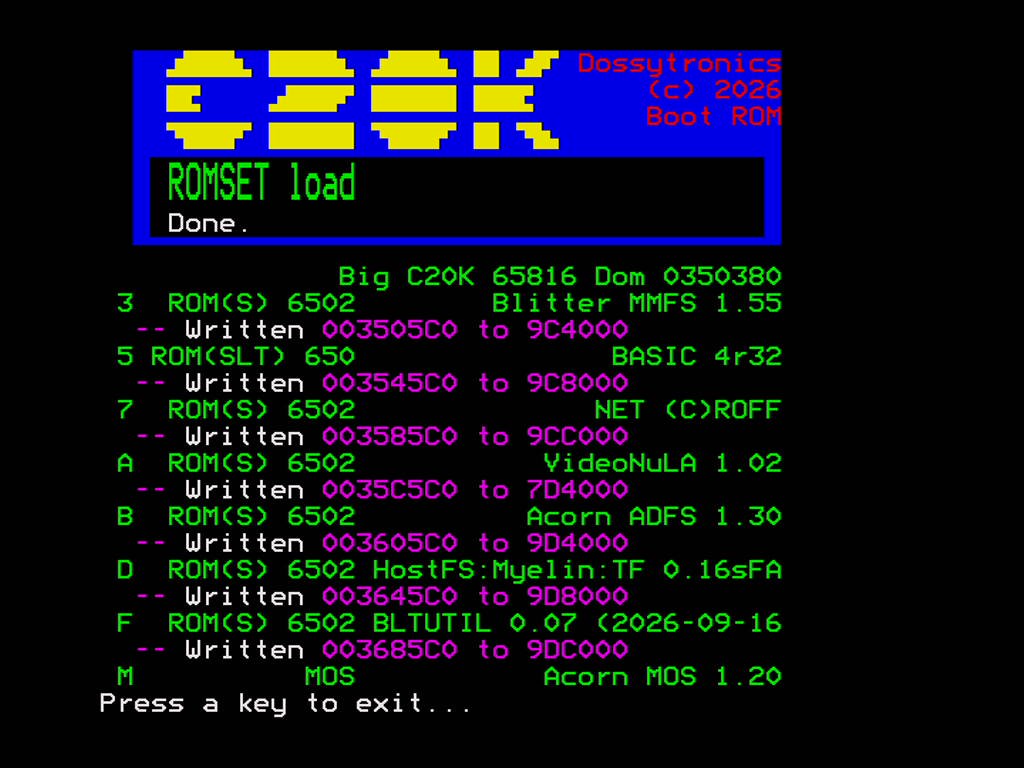
src/hdl/modelC20K/doc/UKWebb/assets/getting-started/preboot-6-load-2.jpg
