dominicbeesley/blitter-vhdl-6502/src/hdl/mk2/testing/README.md

# Testing

This folder contains board builds for performing build and electrical testing of boards
