dominicbeesley/blitter-vhdl-6502/src/hdl/mk3/Testing/mk3-erc-65816/README.md

# mk3-board-erc

This project can be used to buzz out a mk.3 board 65816 CPU expansion board

No CPU or other expansion (SD/HDMI/etc) should be fitted. The board should NOT be plugged into a machine's CPU socket and should be powered via the AUX connector. The 68000 expansion board should be fitted with no jumpers set.

Input / output lines are set as outputs and each line continuously outputs a 4 character code to identify it. This can be used to check soldering.

* Bridged/shorted lines will output incorrect/low levels or garbled text
* High impedance/partially soldered lines should be loaded with ca. 1k resistor to ground and tested for level.

The lines should be tested at the CPU socket pins
