dominicbeesley/blitter-vhdl-6502/src/hdl/modelC20K/vunit/tests/sim_beebfpga_peripherals_obs/readme.txt

# sim_beebfpga_peripherals_obs

An observational test bed for the peripherals controller running at BeebFPGA 
speeds
