dominicbeesley/blitter-vhdl-6502/src/hdl/modelC20K/vunit/tests/sim_fb_c20k_peripherals_obs/readme.txt

# sim_fb_c20k_peripherals_obs

An observational test bed for the peripherals controller running at within a 
Fishbone wrapper
