dominicbeesley/blitter-vhdl-6502/src/hdl/modelC20K/vunit/tests/sim_peripherals_csel/readme.txt

# sim_periph_csl

An observational test bed for the sim_peripherals_csl.vhd board simulation
module
