dominicbeesley/blitter-vhdl-6502/src/hdl/modelC20K/vunit/tests/sim_peripherals_mux/readme.txt

# sim_peripherals_mux

An observational test bed for the sim_peripherals_mux.vhd board simulation
module
