dominicbeesley/blitter-vhdl-6502/src/hdl/modelC20K/asm/C20KFirstLight/testprogs/flashinfo/readme.md

# FlshTst

Demonstrates reading the manufacturer codes of the Flash EEPROM of
the Blitter (mk2 or mk3) board via the JIM interface.
This assumes that the Flash EEPROM is mapped at JIM addres 80 0000
