dominicbeesley/blitter-vhdl-6502/src/hdl/modelC20K/asm/C20KFirstLight/testprogs/ledchase/readme.md

# ledchase

A simple led pattern chaser to test the ws2812 functionality
