dominicbeesley/blitter-vhdl-6502/doc/blit-cpu-mk2.pdf

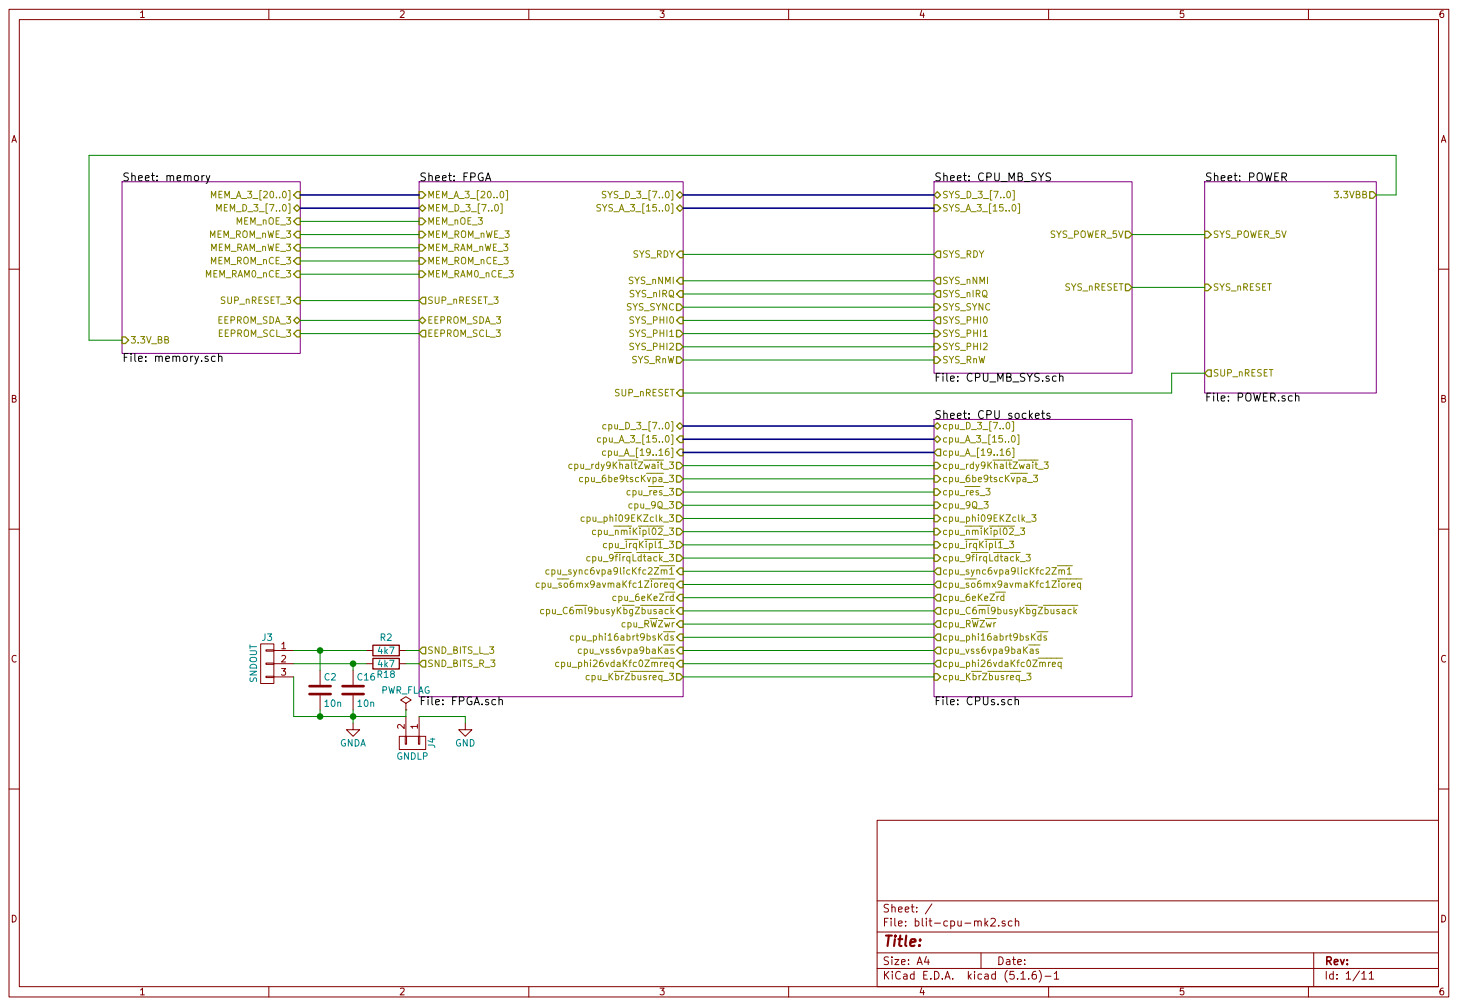
[picture p80: page 1]

File: blit-cpu-mk2.sch Sheet: /
Id: 1/11 Title:

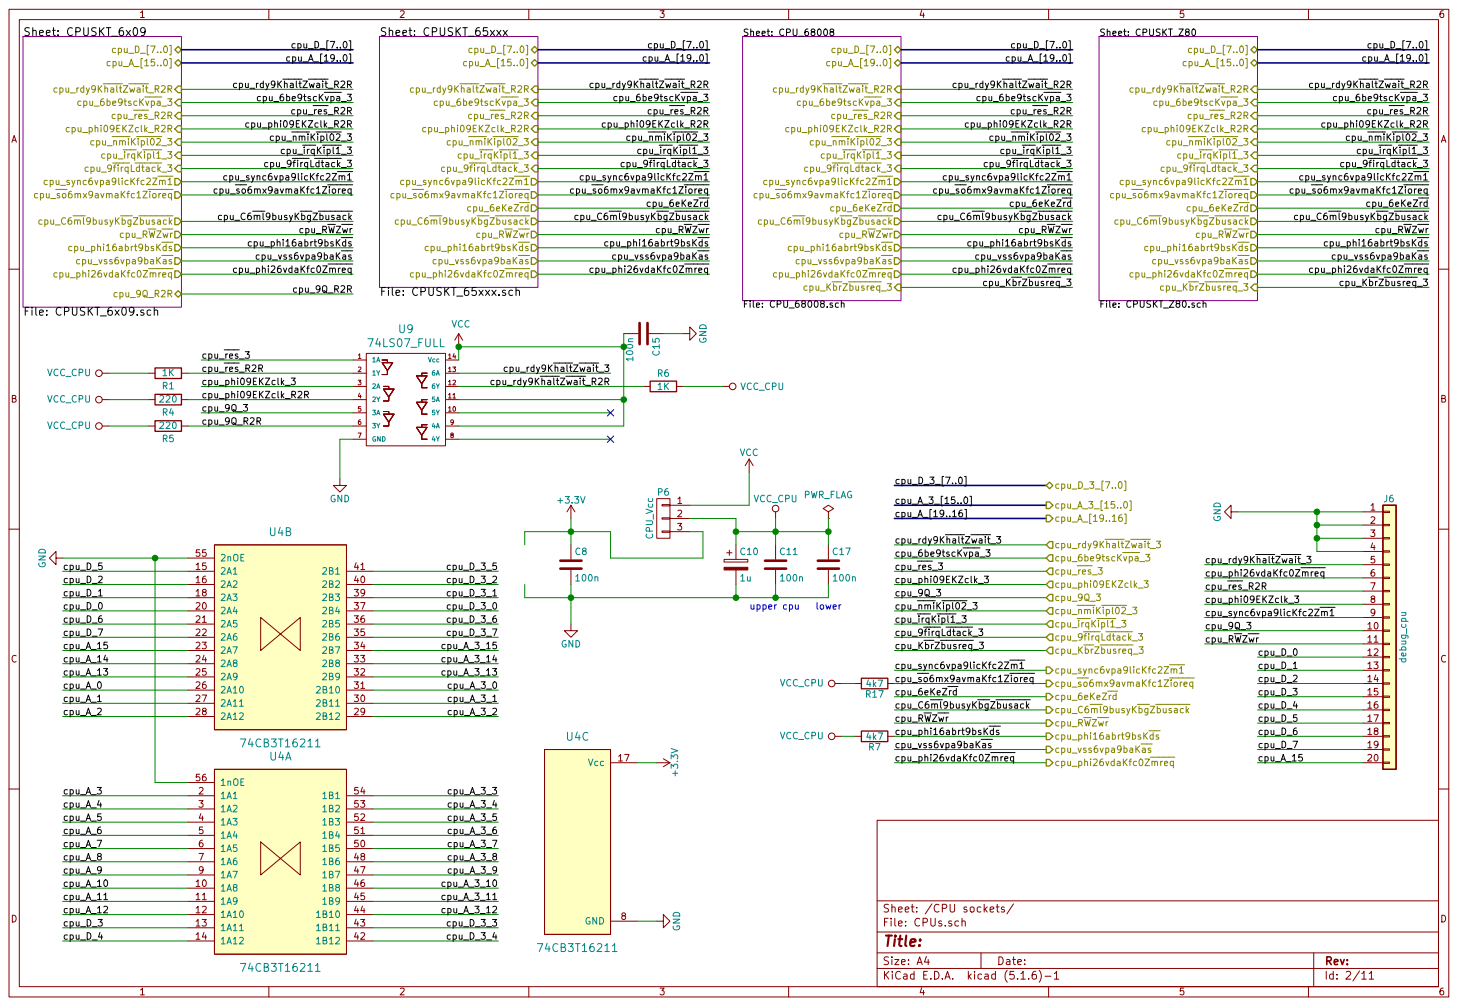
[picture p81: page 2]

cpu_rdy9KhaltZwait_R2R | cpu_rdy9KhaltZwait_R2R | cpu_rdy9KhaltZwait_R2R
cpu_6be9tscKvpa_3 | cpu_6be9tscKvpa_3 | cpu_6be9tscKvpa_3
cpu_res_R2R | cpu_res_R2R | cpu_res_R2R

cpu_phi09EKZclk_R2R | cpu_phi09EKZclk_R2R | cpu_phi09EKZclk_R2R
cpu_nmiKipl02_3 | cpu_nmiKipl02_3 | cpu_nmiKipl02_3
cpu_irqKipl1_3 | cpu_irqKipl1_3 | cpu_irqKipl1_3
cpu_9firqLdtack_3 | cpu_9firqLdtack_3 | cpu_9firqLdtack_3

cpu_sync6vpa9licKfc2Zm1 | cpu_sync6vpa9licKfc2Zm1 | cpu_sync6vpa9licKfc2Zm1
cpu_so6mx9avmaKfc1Zioreq | cpu_so6mx9avmaKfc1Zioreq | cpu_so6mx9avmaKfc1Zioreq
cpu_C6ml9busyKbgZbusack | cpu_6eKeZrd | cpu_6eKeZrd

cpu_C6ml9busyKbgZbusack | cpu_C6ml9busyKbgZbusack

cpu_RWZwr | cpu_RWZwr | cpu_RWZwr

cpu_phi16abrt9bsKds | cpu_phi16abrt9bsKds | cpu_phi16abrt9bsKds
cpu_vss6vpa9baKas | cpu_vss6vpa9baKas | cpu_vss6vpa9baKas
cpu_phi26vdaKfc0Zmreq | cpu_phi26vdaKfc0Zmreq | cpu_phi26vdaKfc0Zmreq

Id: 2/11 Title: File: CPUs.sch Sheet: /CPU sockets/

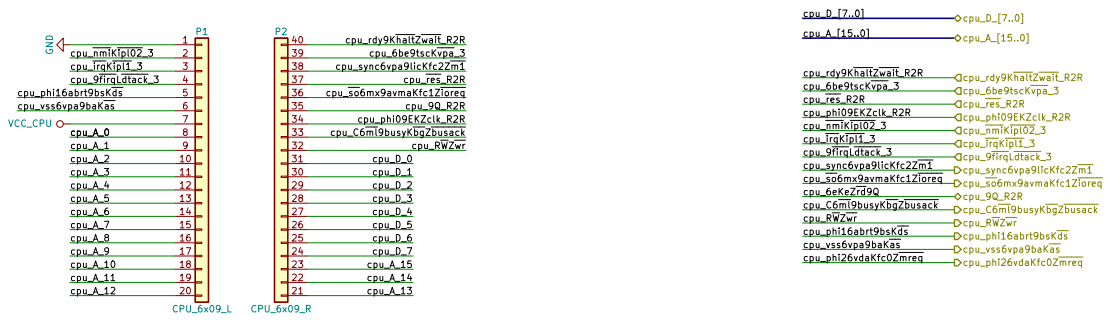
[picture p82: page 3]

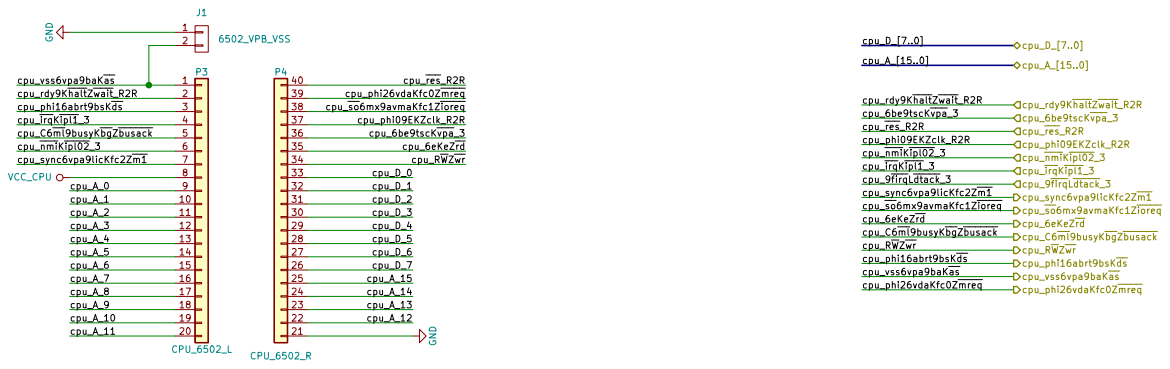
[picture p83: page 4]

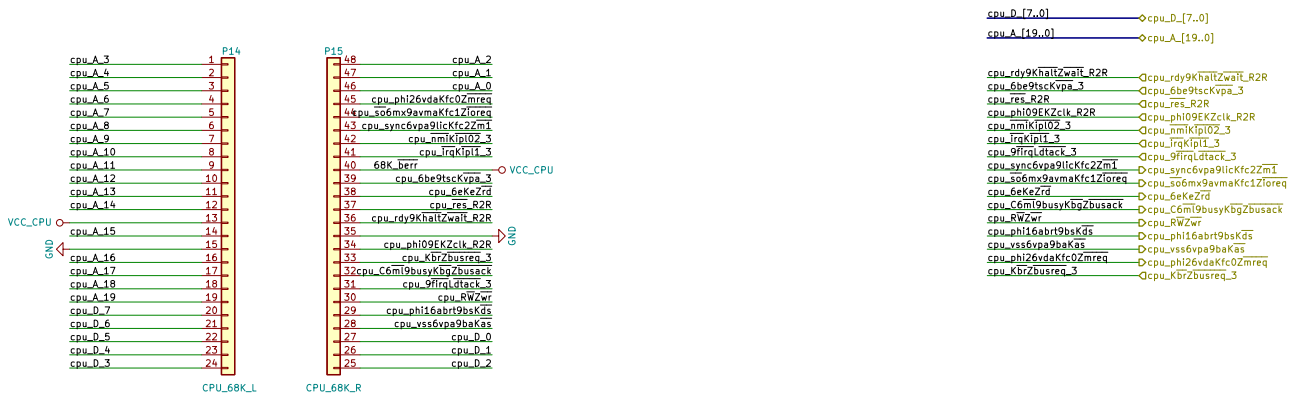
[picture p84: page 5]

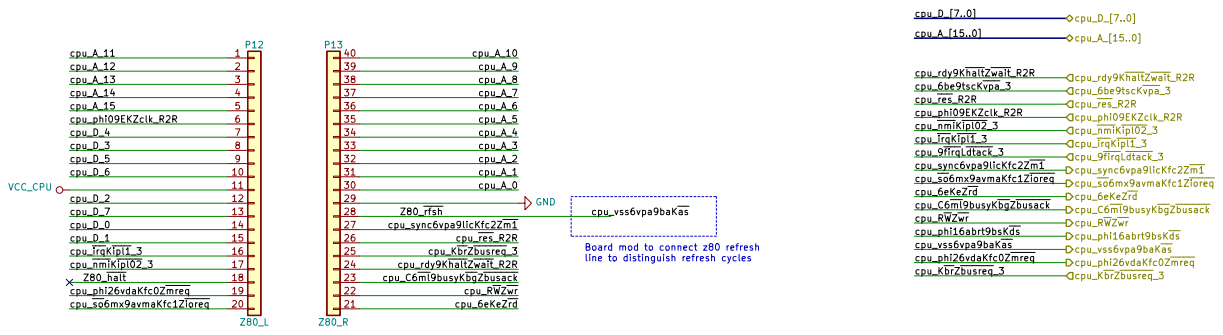
[picture p85: page 6]

line to distinguish refresh cycles

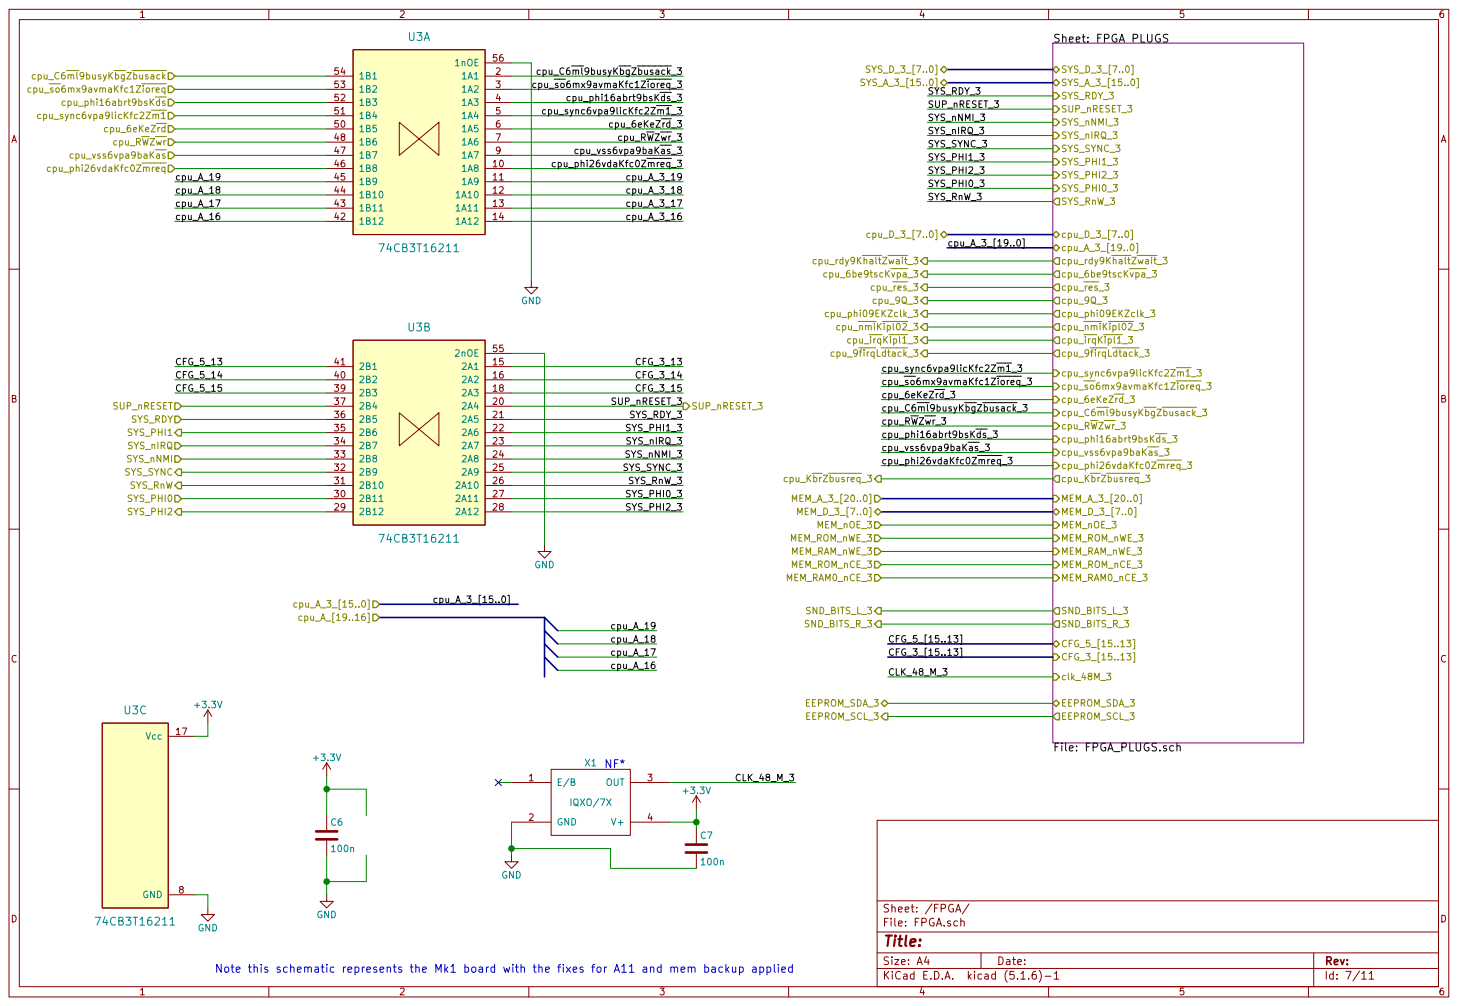
[picture p86: page 7]

SUP_nRESET_3 NF* Note this schematic represents the Mk1 board with the fixes for A11 and mem backup applied

Id: 7/11 Title: File: FPGA.sch Sheet: /FPGA/

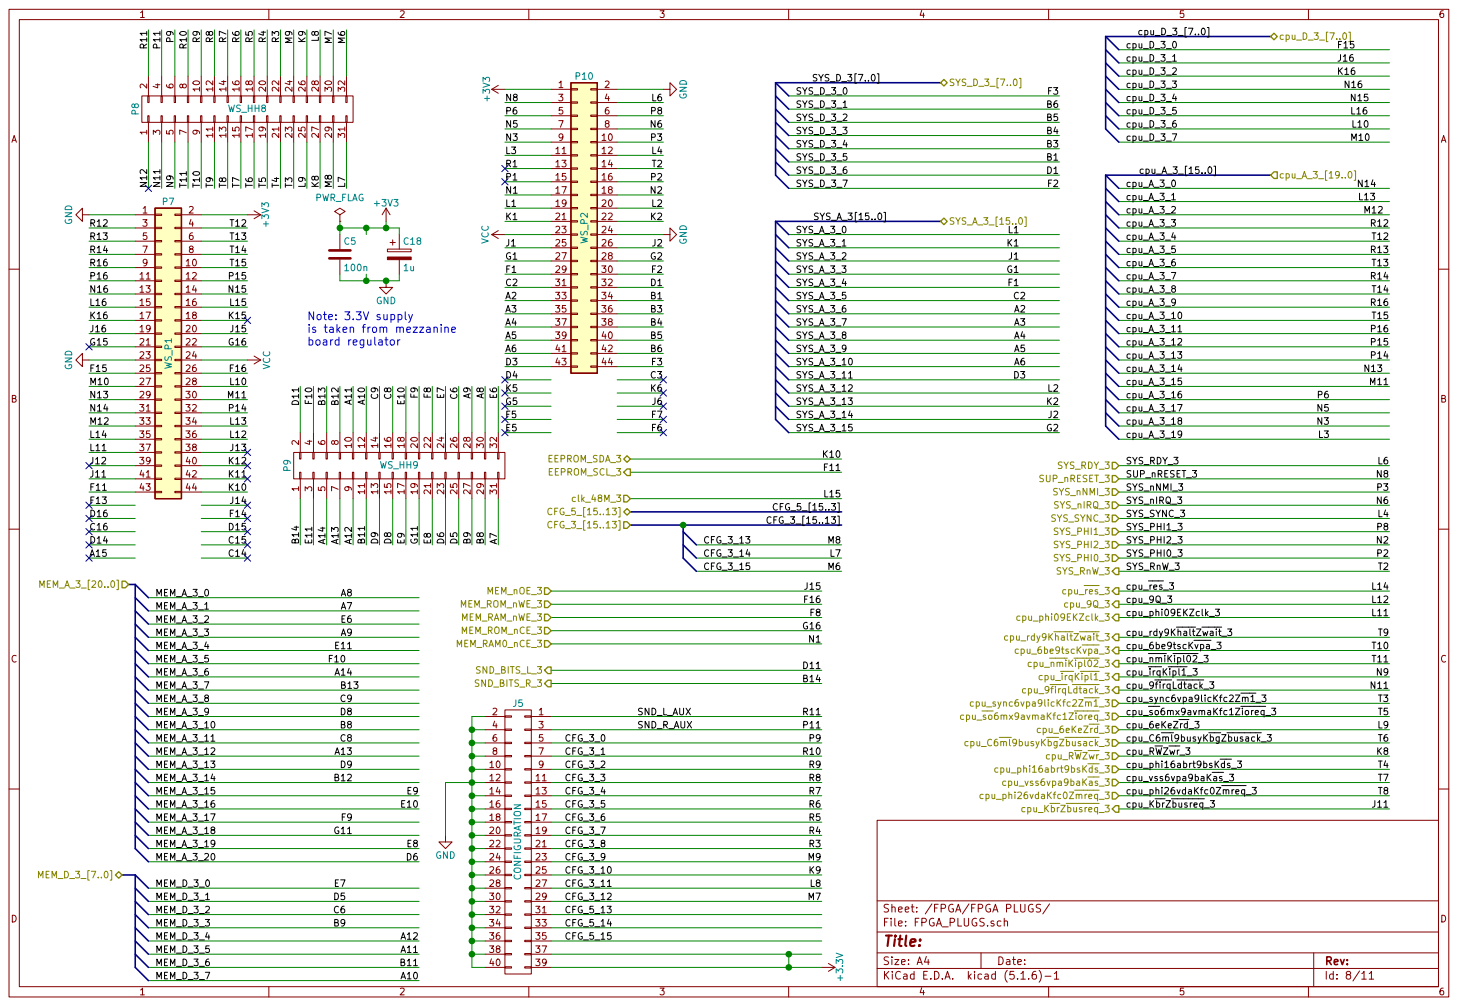
[picture p87: page 8]

is taken from mezzanine
board regulator

File: FPGA_PLUGS.sch Sheet: /FPGA/FPGA PLUGS/
Id: 8/11 Title:

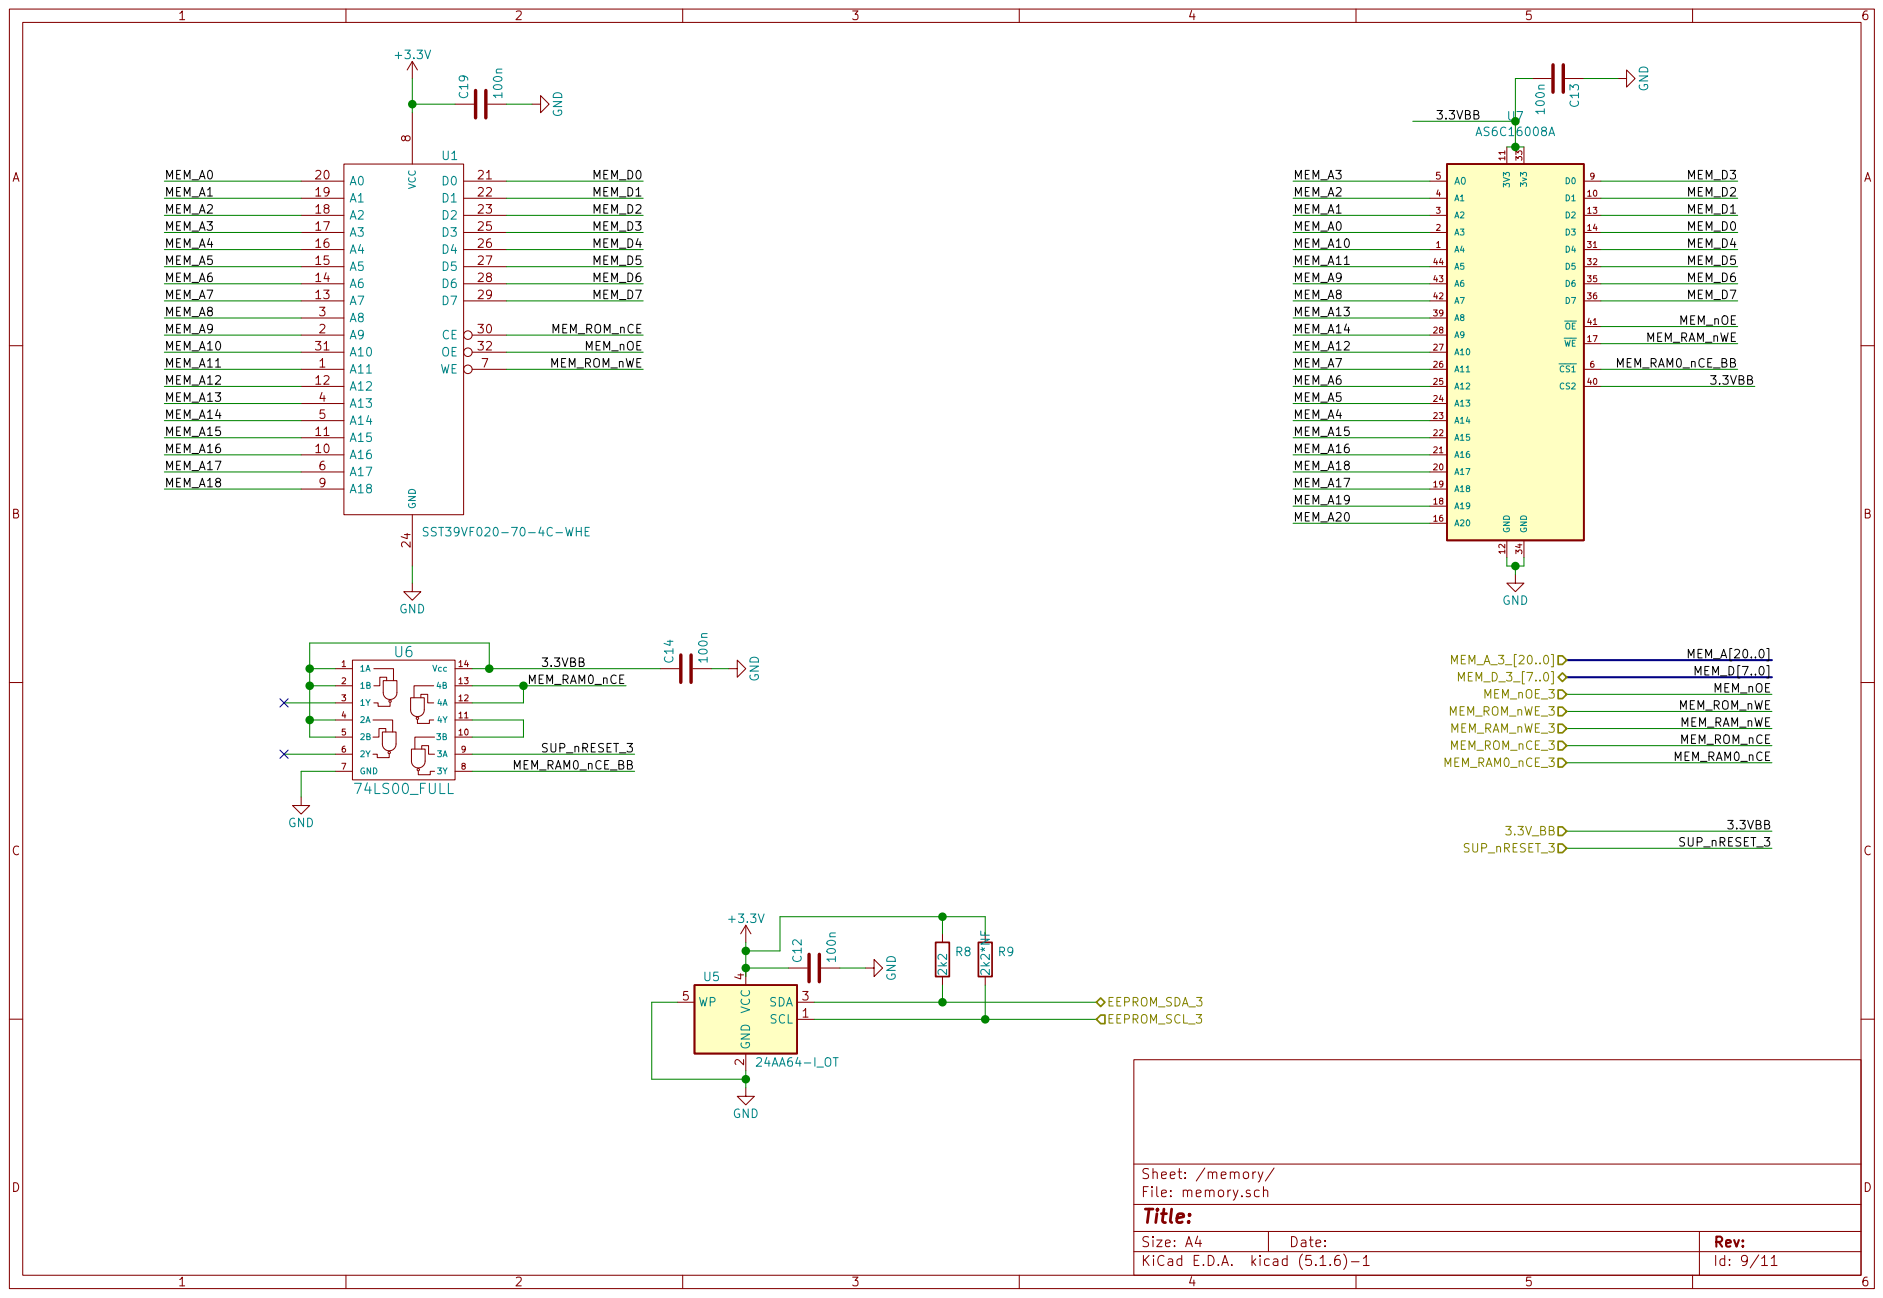
[picture p88: page 9]

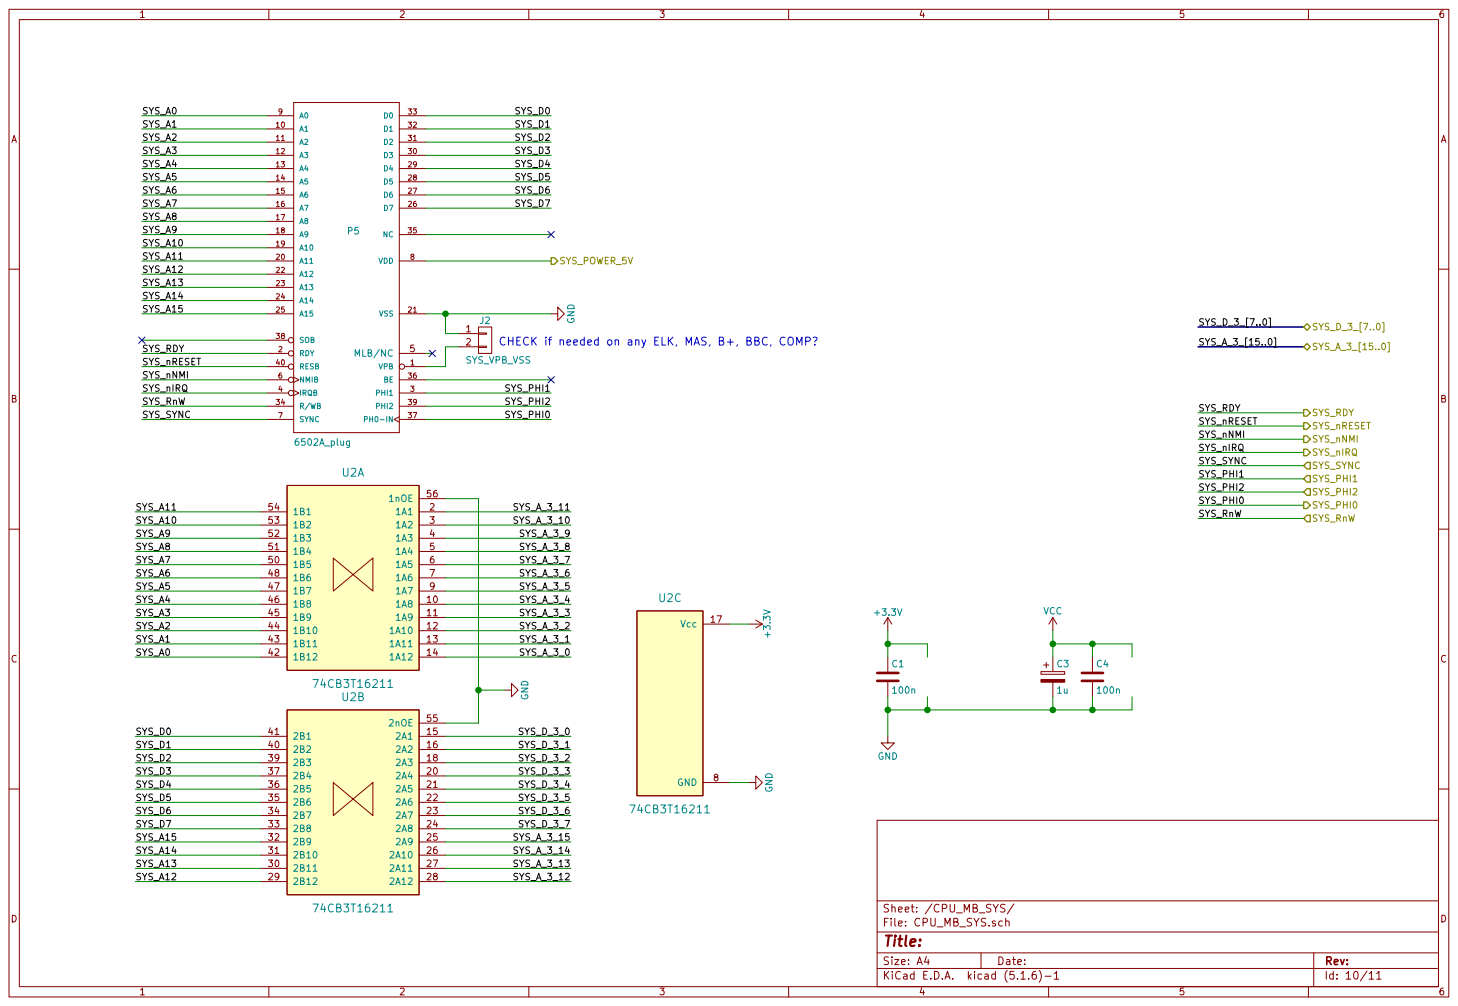
[picture p89: page 10]

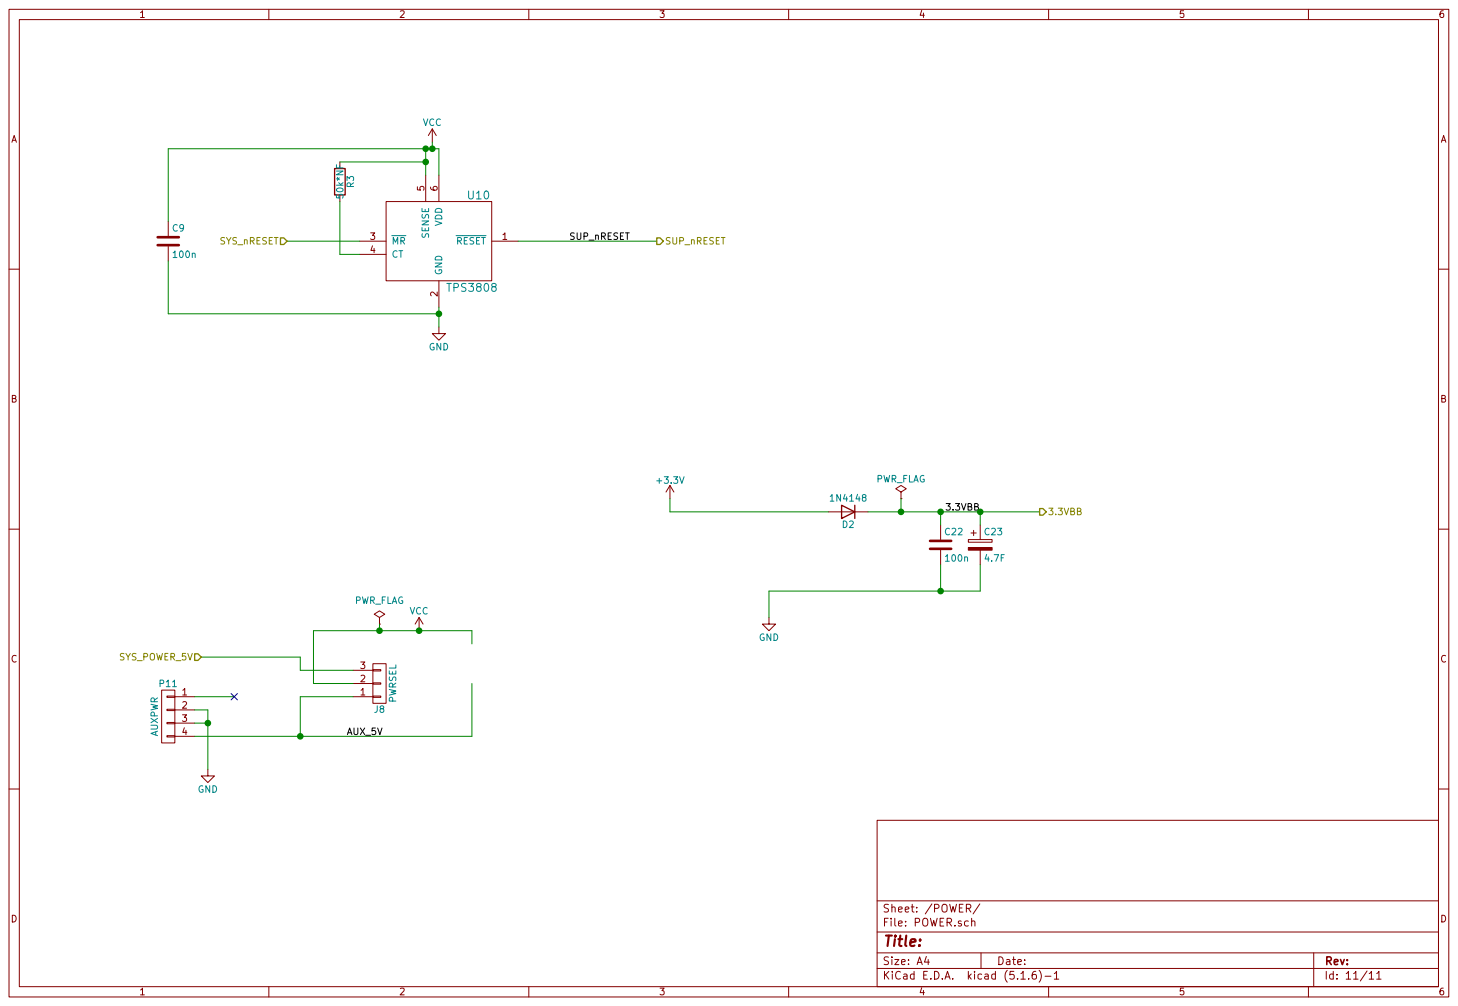
[picture p90: page 11]

Id: 11/11 Title: File: POWER.sch Sheet: /POWER/
