dominicbeesley/blitter-vhdl-6502/doc/blit-cpu-mk3.pdf

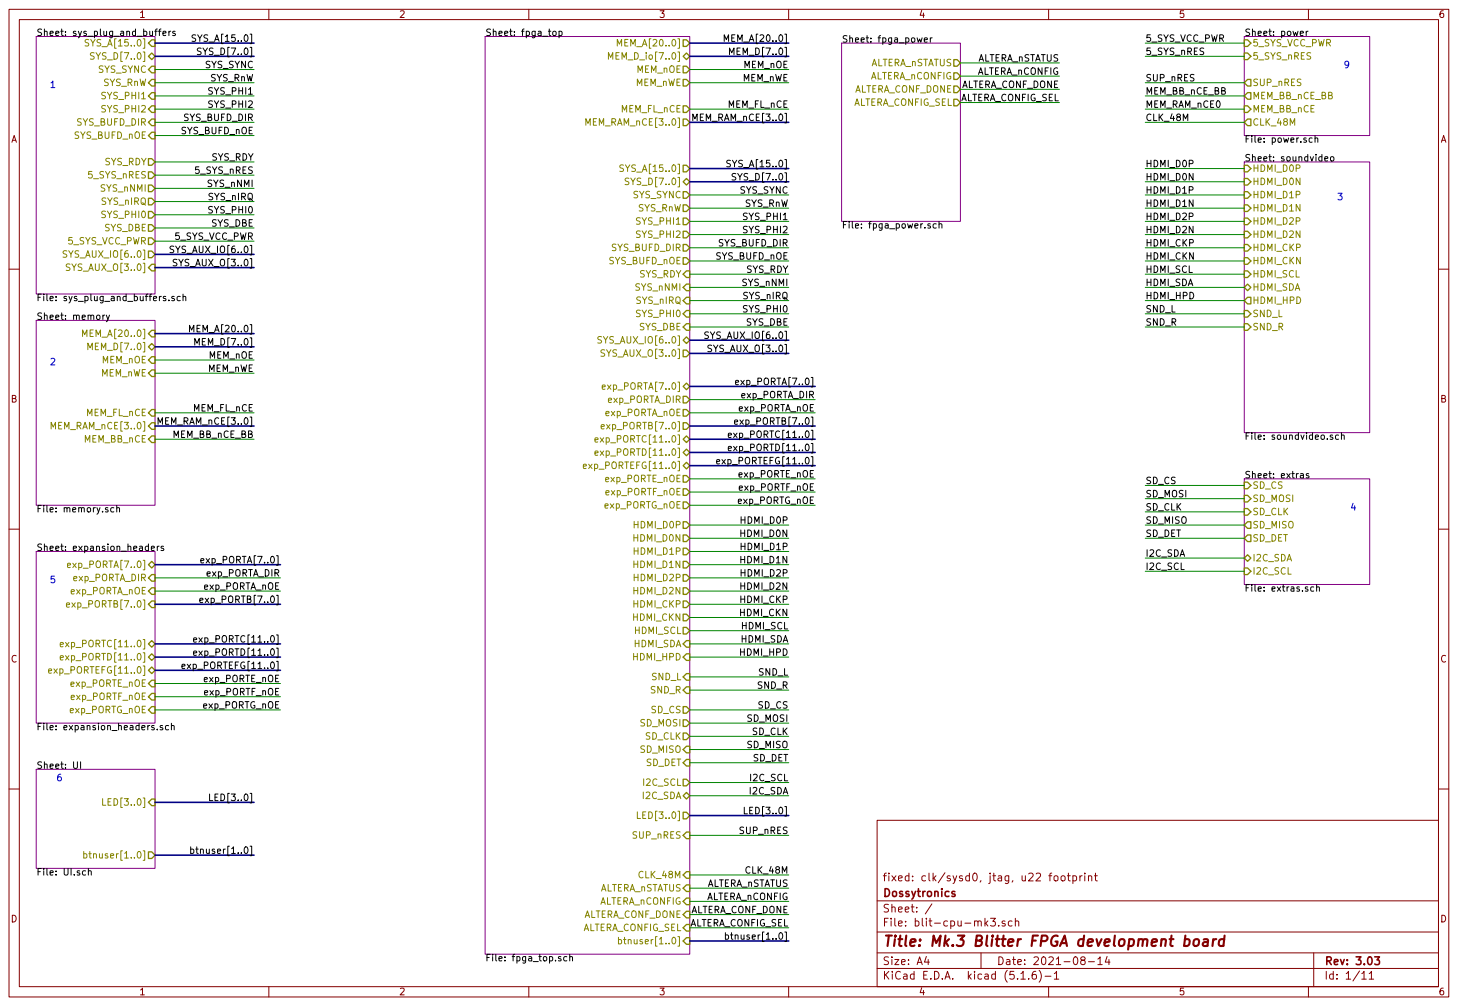
[picture p91: page 1]

SYS_AUX_IO[6..0]
SYS_AUX_O[3..0]

exp_PORTB[7..0]
exp_PORTC[11..0]
exp_PORTD[11..0]
exp_PORTEFG[11..0]

Sheet: extras File: extras.sch SD_CS

fixed: clk/sysd0, jtag, u22 footprint
File: blit-cpu-mk3.sch Sheet: / Dossytronics

Id: 1/11 Title: Mk.3 Blitter FPGA development board

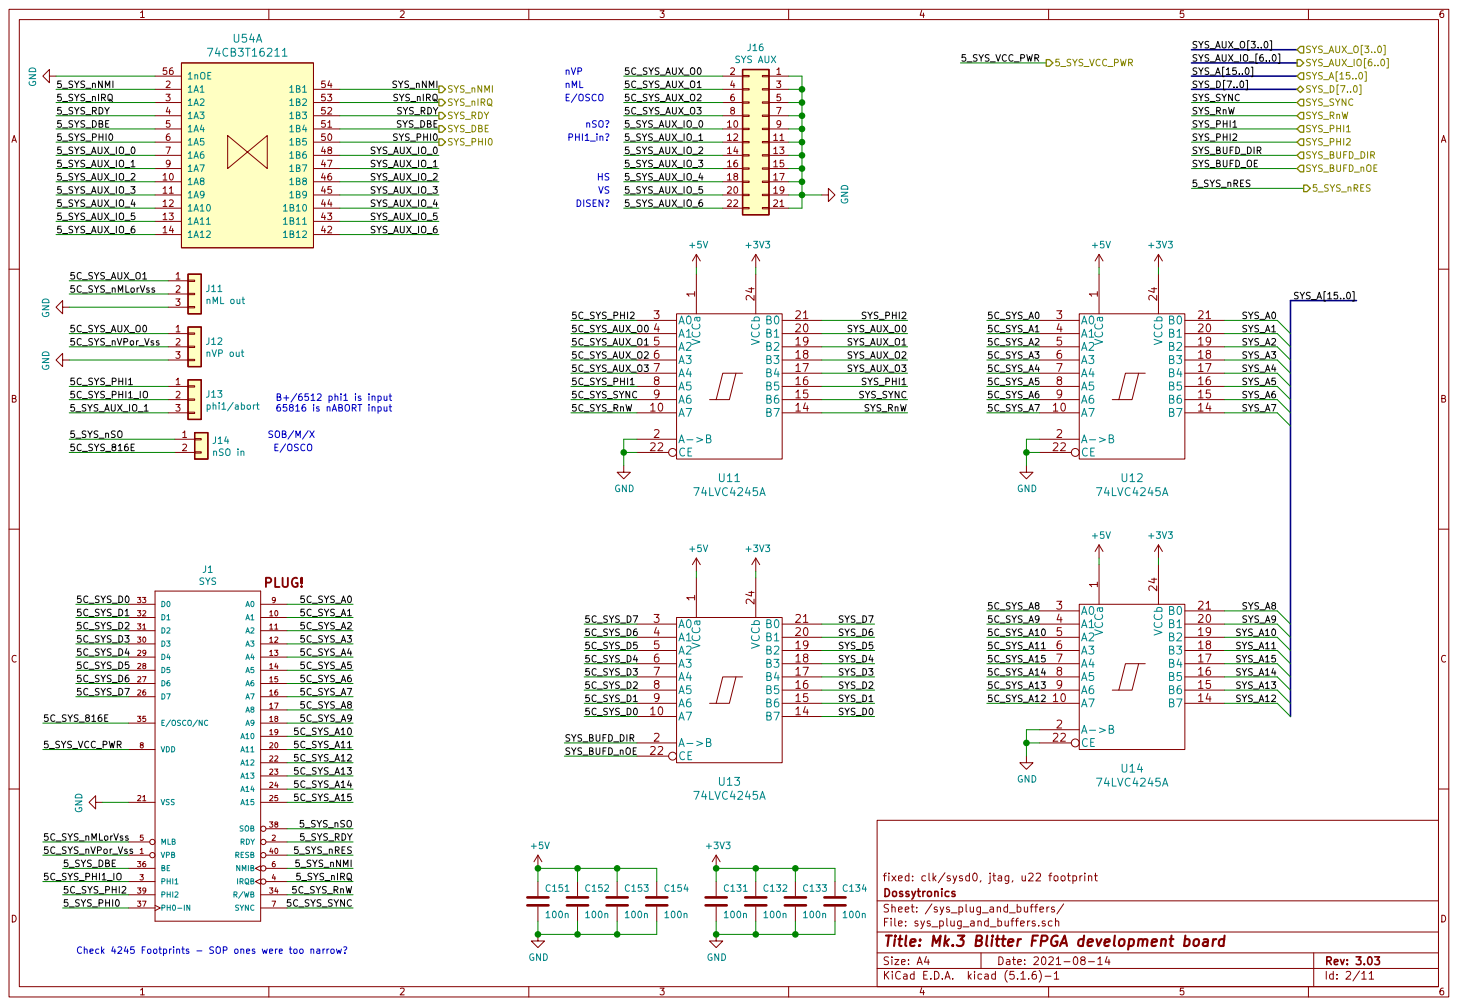
[picture p92: page 2]

fixed: clk/sysd0, jtag, u22 footprint VCCa

Dossytronics
Sheet: /sys_plug_and_buffers/
File: sys_plug_and_buffers.sch
Id: 2/11 Title: Mk.3 Blitter FPGA development board

Check 4245 Footprints - SOP ones were too narrow?

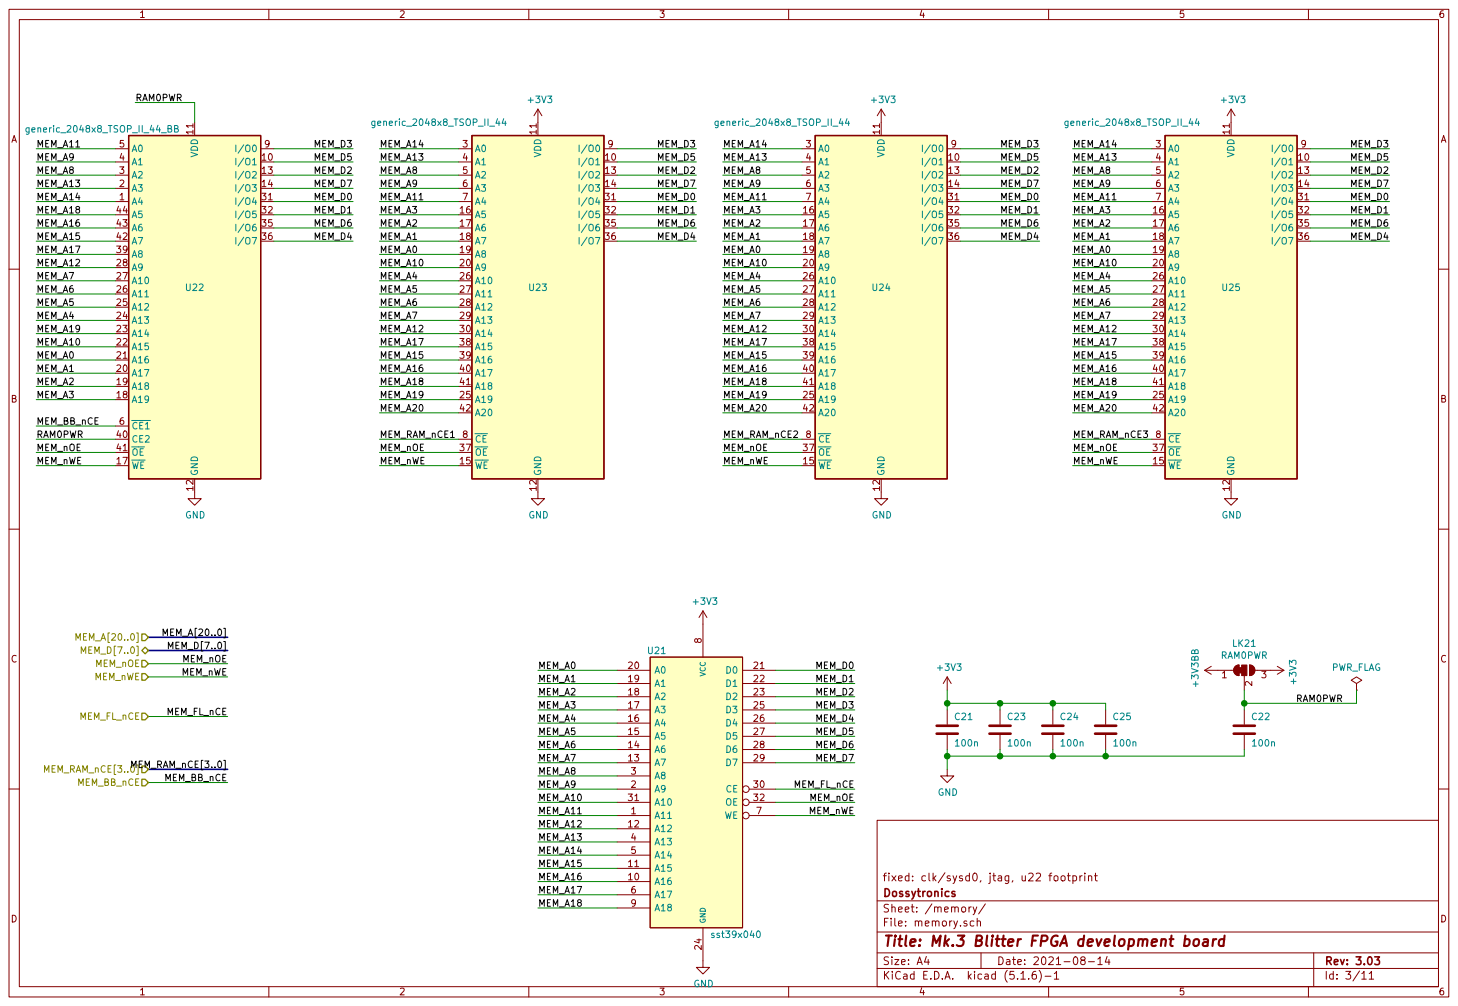
[picture p93: page 3]

Dossytronics
Sheet: /memory/
File: memory.sch
Id: 3/11 Title: Mk.3 Blitter FPGA development board

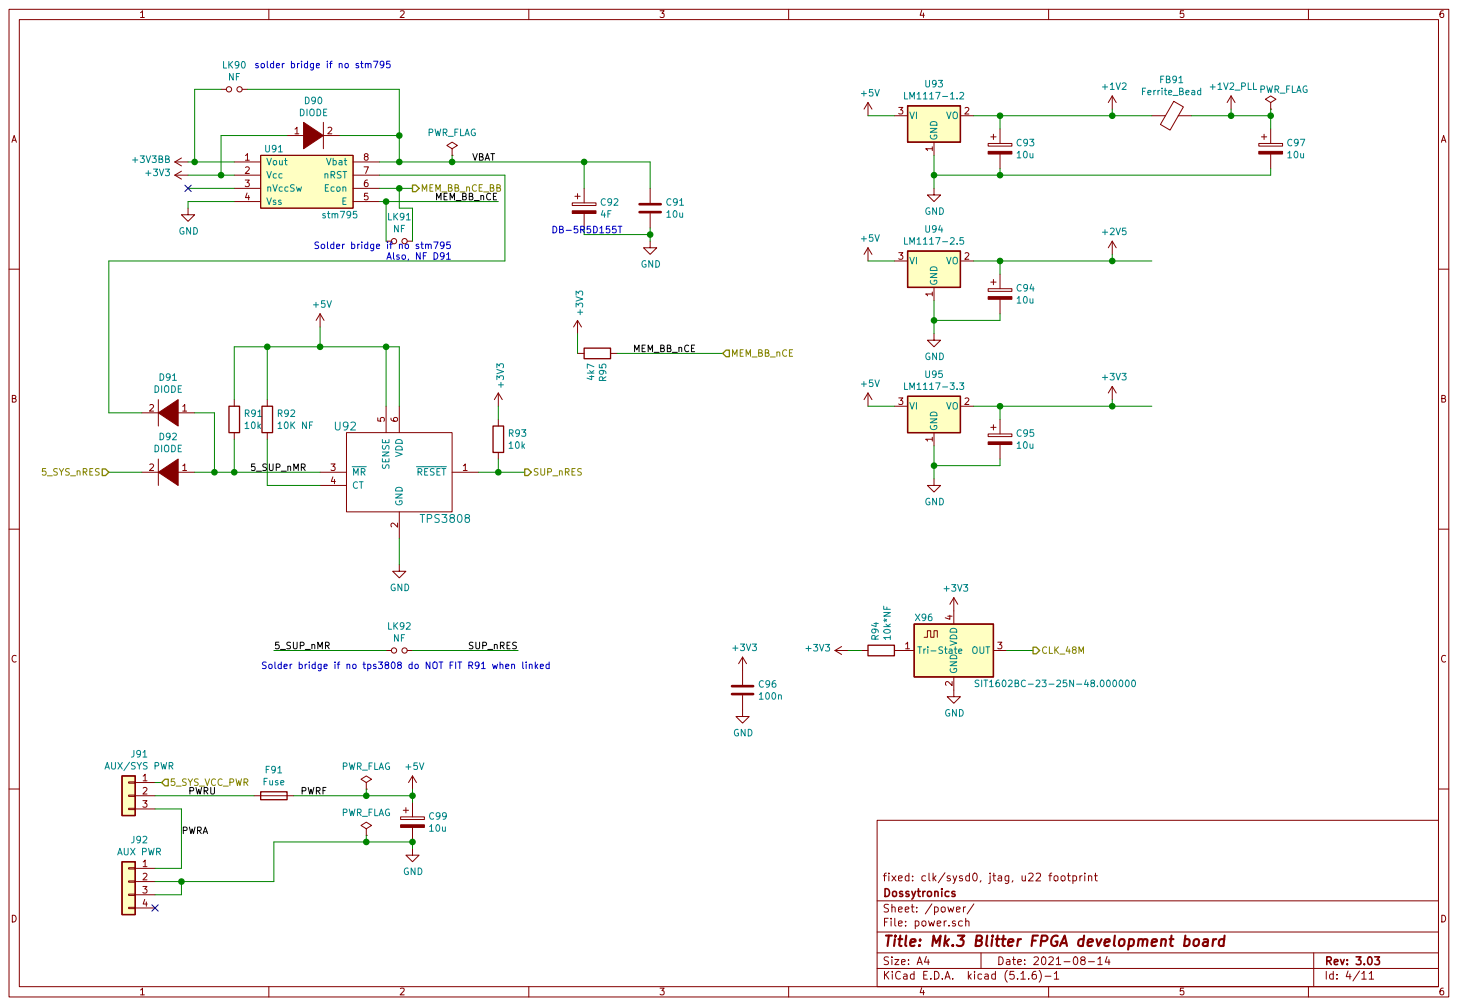
[picture p94: page 4]

solder bridge if no stm795

fixed: clk/sysd0, jtag, u22 footprint
Dossytronics
Sheet: /power/
File: power.sch
Id: 4/11 Title: Mk.3 Blitter FPGA development board

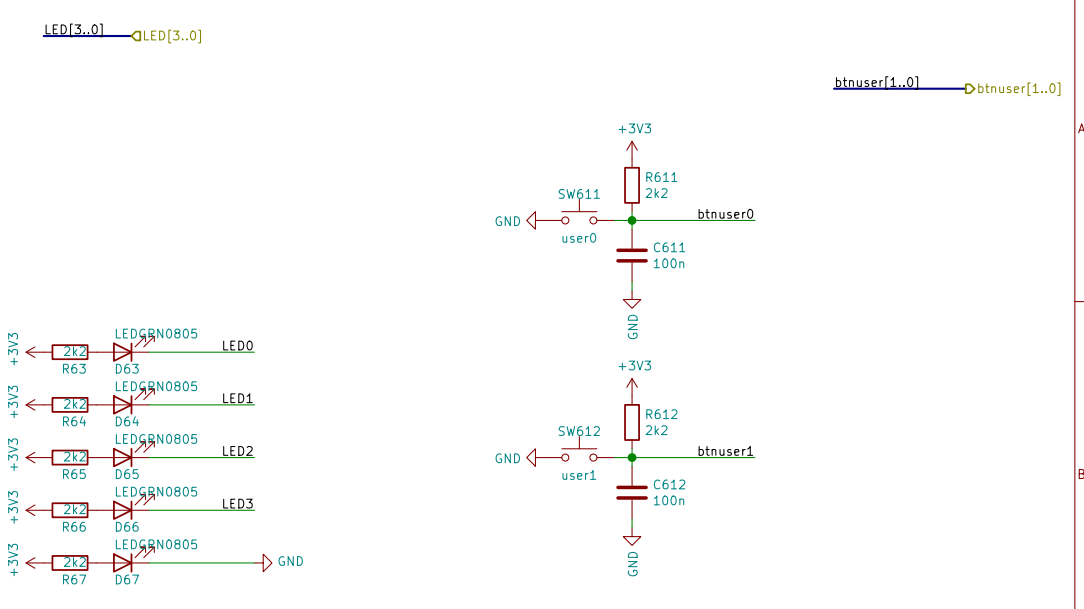
[picture p95: page 5]

fixed: clk/sysd0, jtag, u22 footprint
File: UI.sch Sheet: /UI/ Dossytronics

Id: 5/11 Title: Mk.3 Blitter FPGA development board

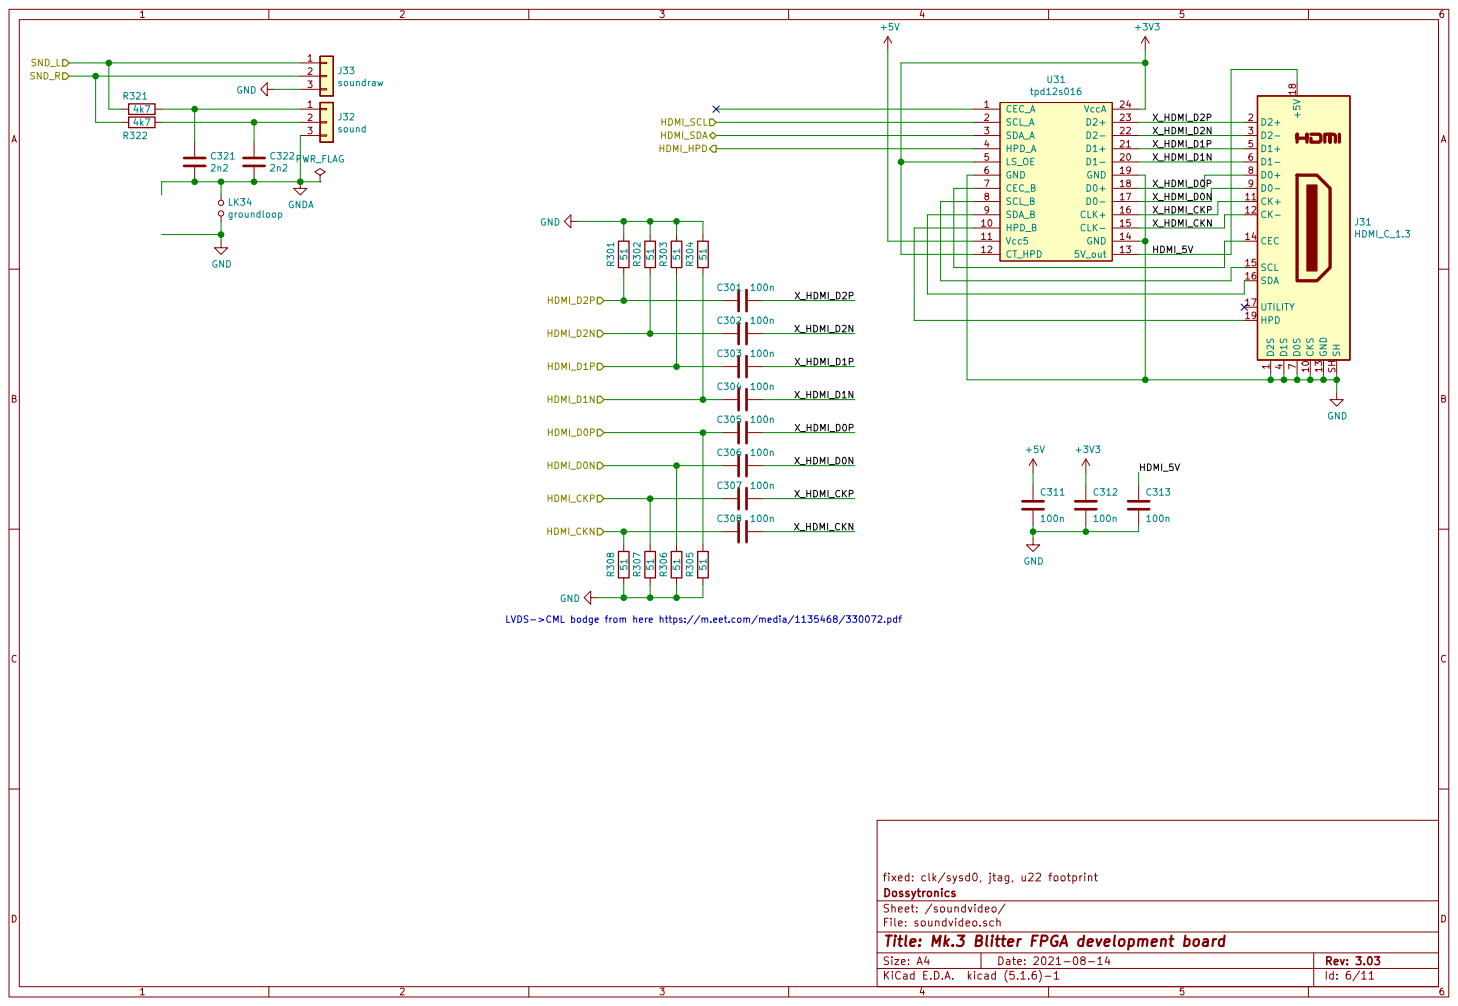
[picture p96: page 6]

1 CKS 10 CK+ 11 CK- 12 GND 13 CEC 14 SCL 15 SDA 16 UTILITY 17 +5V 18 HPD 19 D2+ 2 D2- 3 D1S

X_HDMI_D1P
X_HDMI_D1N

LVDS->CML bodge from here https://m.eet.com/media/1135468/330072.pdf

fixed: clk/sysd0, jtag, u22 footprint
File: soundvideo.sch Sheet: /soundvideo/ Dossytronics

Id: 6/11 Title: Mk.3 Blitter FPGA development board

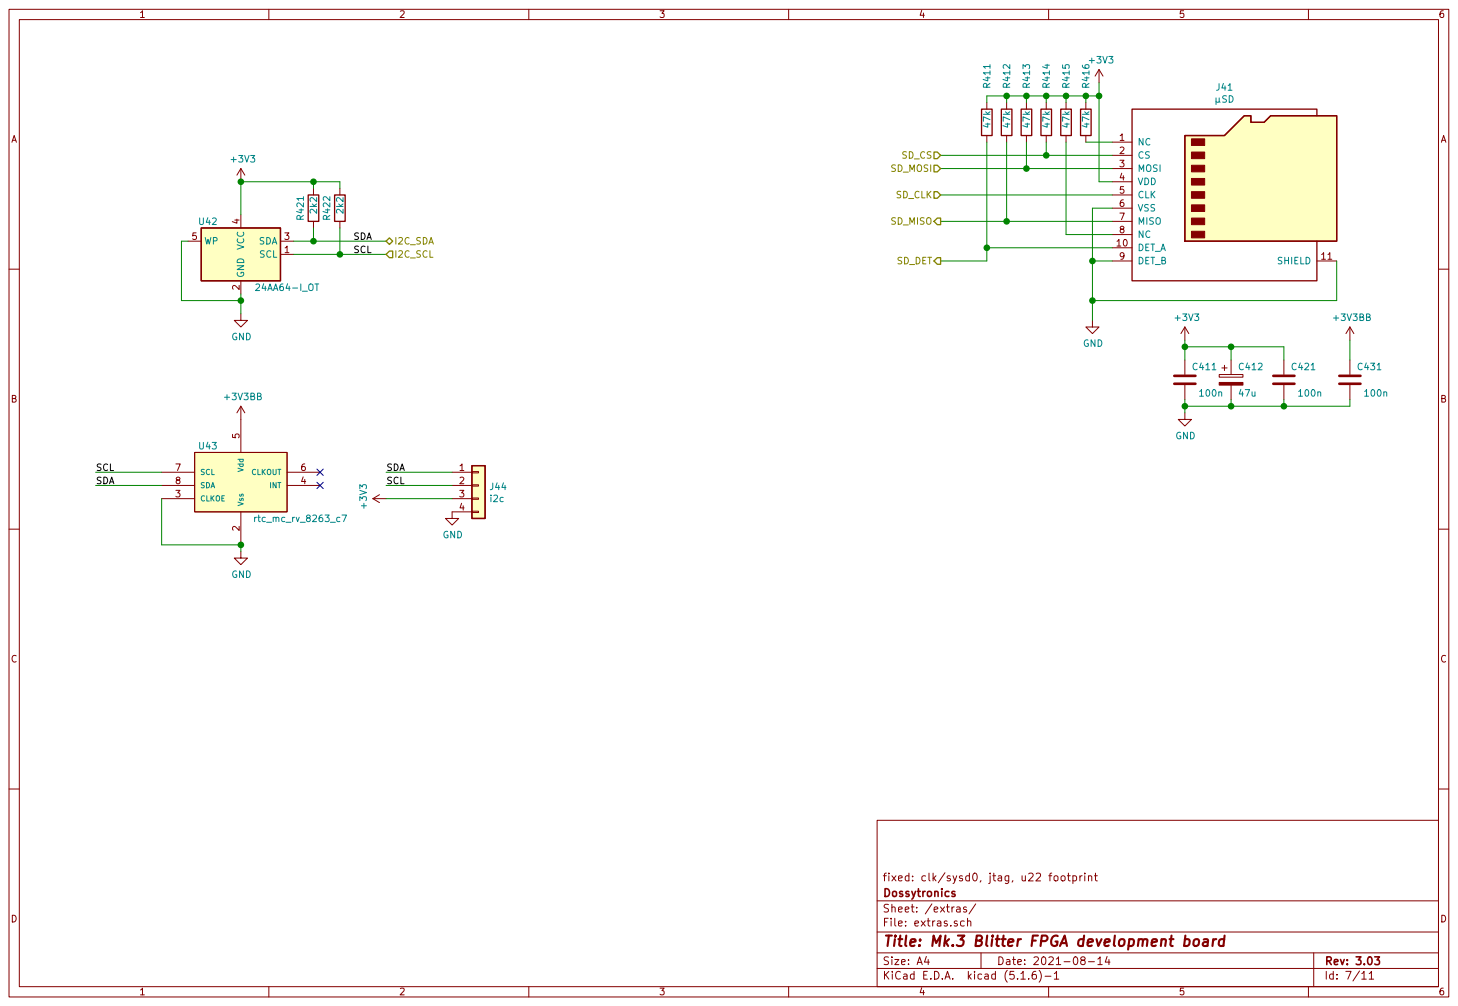
[picture p97: page 7]

File: extras.sch Sheet: /extras/ Dossytronics

Id: 7/11 Title: Mk.3 Blitter FPGA development board

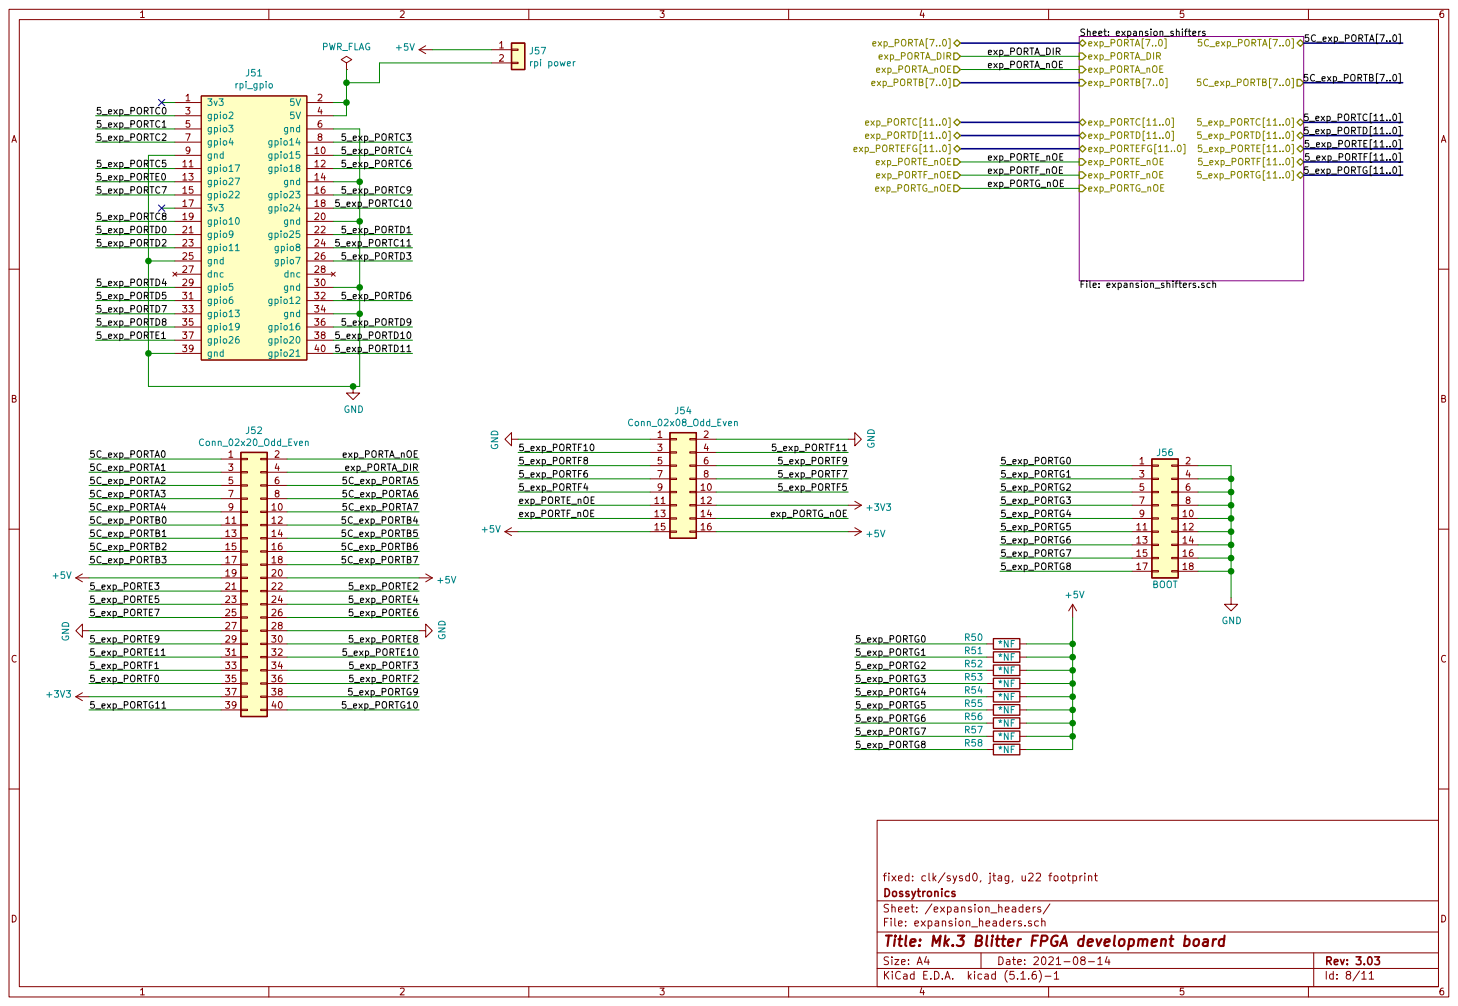
[picture p98: page 8]

5_exp_PORTD[11..0]
5_exp_PORTE[11..0]
5_exp_PORTF[11..0]
5_exp_PORTG[11..0]

fixed: clk/sysd0, jtag, u22 footprint
Dossytronics
Sheet: /expansion_headers/
File: expansion_headers.sch
Id: 8/11 Title: Mk.3 Blitter FPGA development board

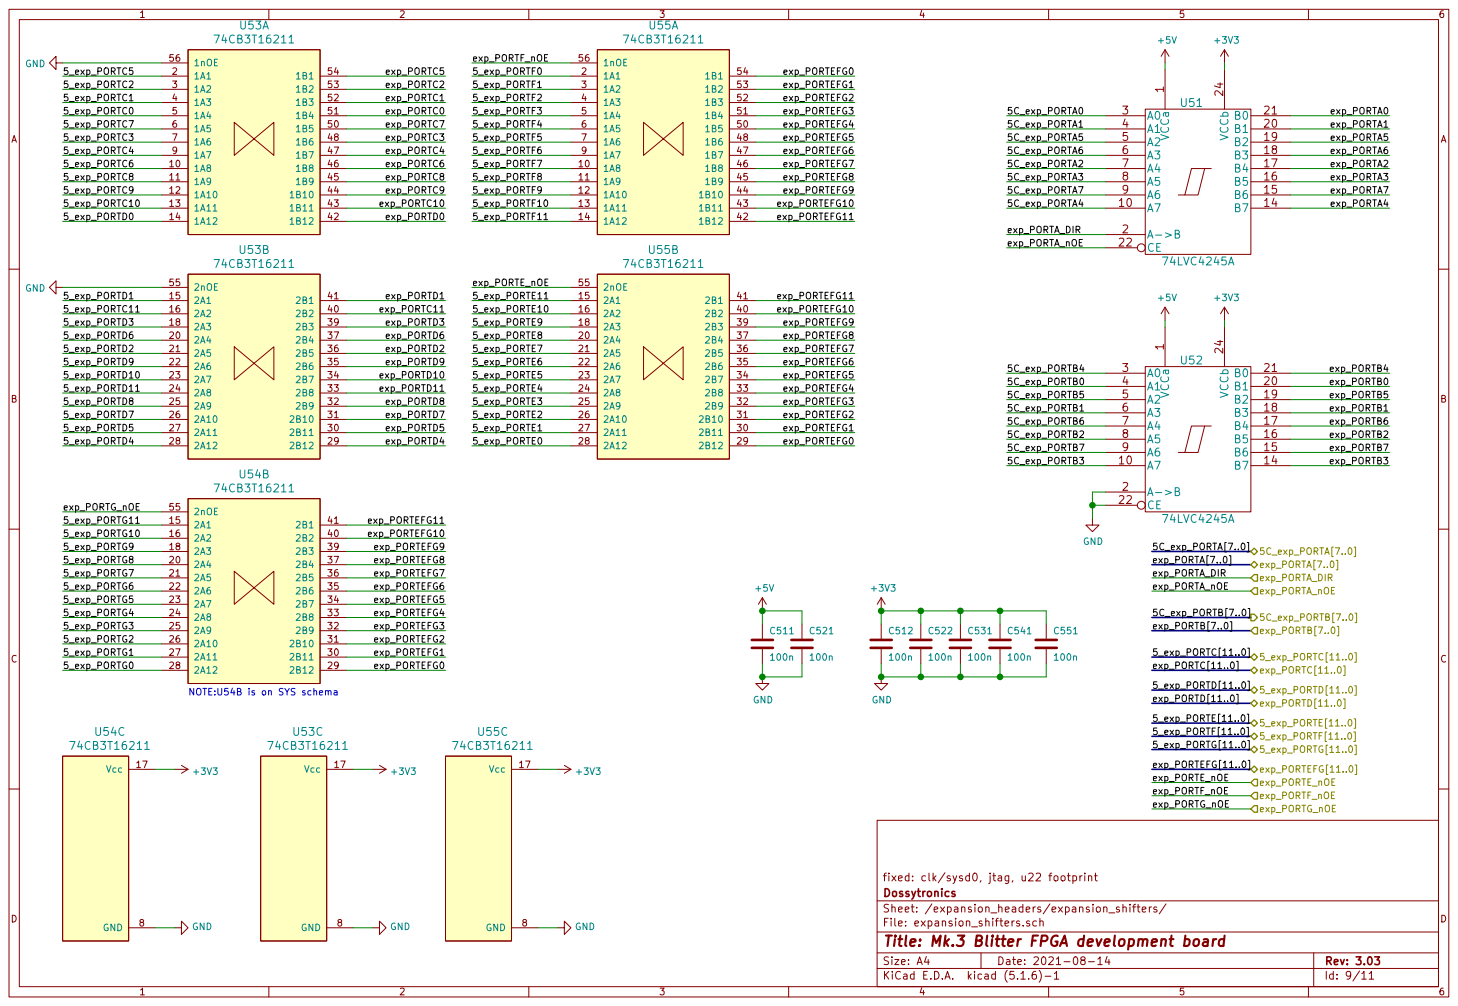
[picture p99: page 9]

5_exp_PORTE6 NOTE:U54B is on SYS schema

fixed: clk/sysd0, jtag, u22 footprint C541

Dossytronics
Sheet: /expansion_headers/expansion_shifters/
File: expansion_shifters.sch
Id: 9/11 Title: Mk.3 Blitter FPGA development board

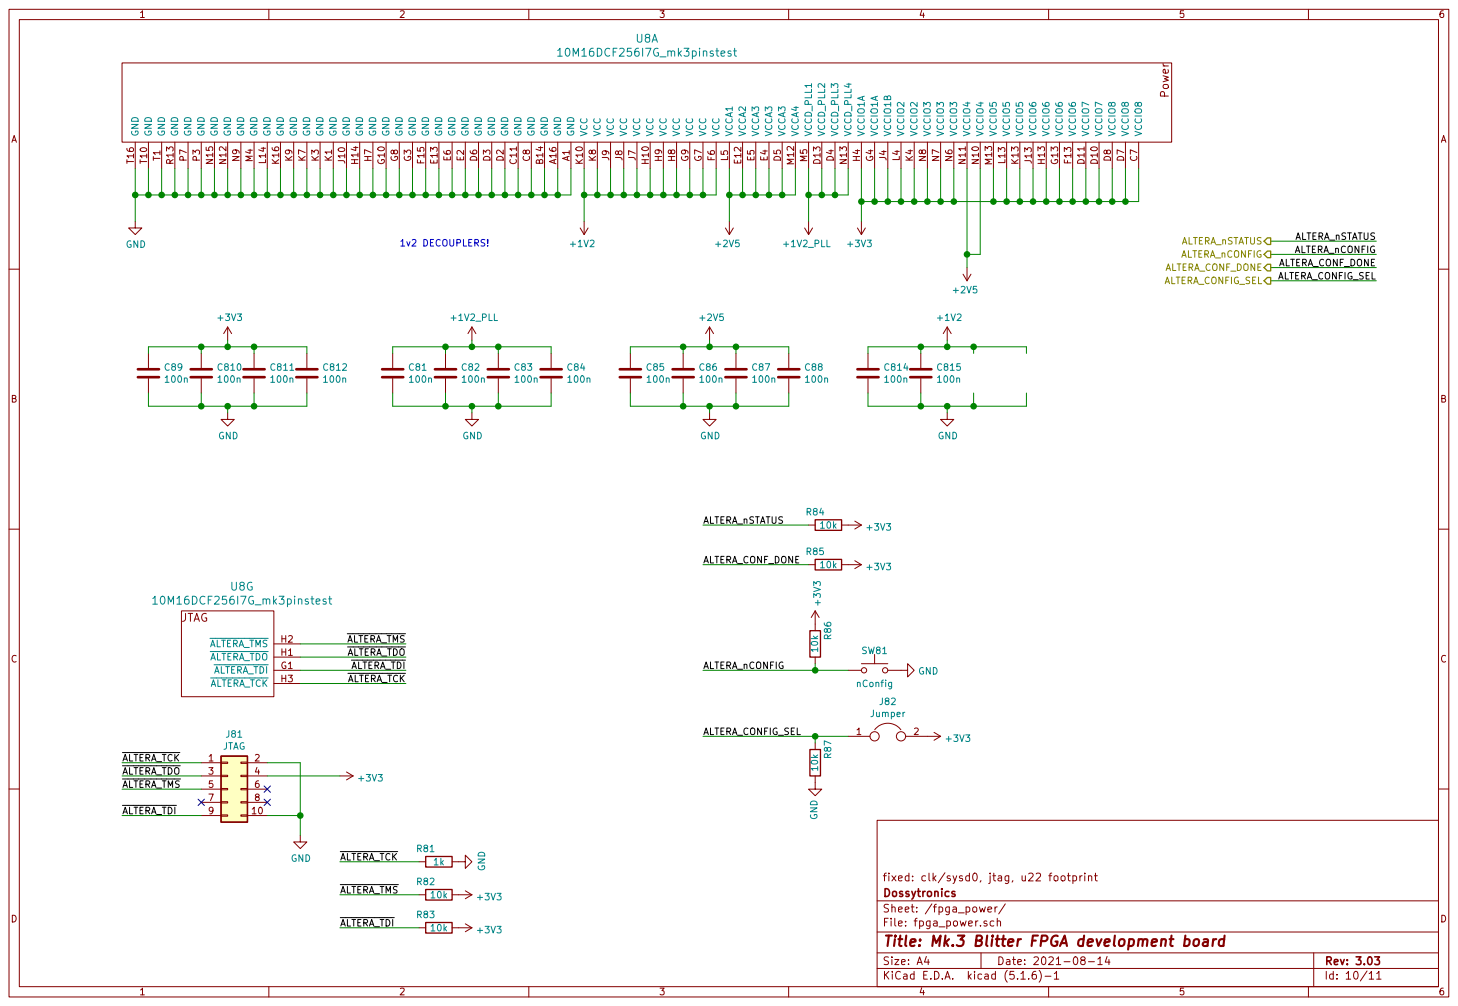
[picture p100: page 10]

fixed: clk/sysd0, jtag, u22 footprint
Dossytronics
Sheet: /fpga_power/
File: fpga_power.sch
Id: 10/11 Title: Mk.3 Blitter FPGA development board

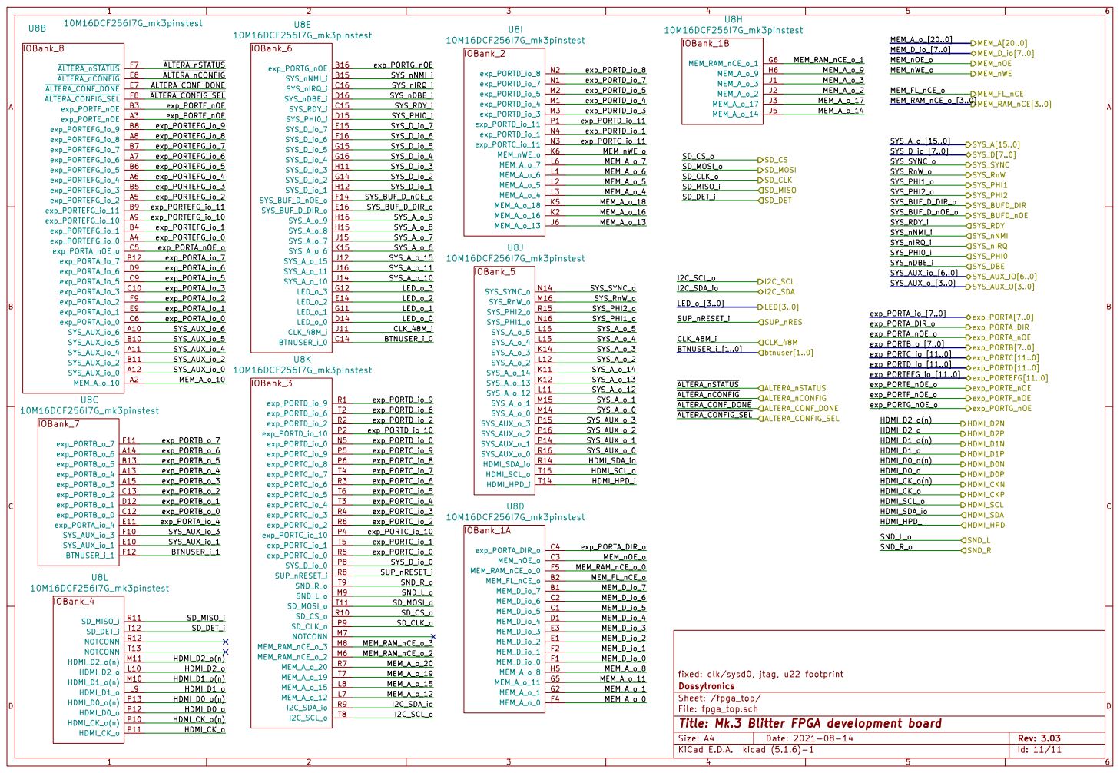
[picture p101: page 11]

fixed: clk/sysd0, jtag, u22 footprint
Dossytronics
Sheet: /fpga_top/
File: fpga_top.sch
Id: 11/11 Title: Mk.3 Blitter FPGA development board
