dominicbeesley/blitter-vhdl-6502/src/hdl/shared/fb_CPU_arm2.vhd

-- MIT License
-- -----------------------------------------------------------------------------
-- Copyright (c) 2022 Dominic Beesley https://github.com/dominicbeesley
--
-- Permission is hereby granted, free of charge, to any person obtaining a copy
-- of this software and associated documentation files (the "Software"), to deal
-- in the Software without restriction, including without limitation the rights
-- to use, copy, modify, merge, publish, distribute, sublicense, and/or sell
-- copies of the Software, and to permit persons to whom the Software is
-- furnished to do so, subject to the following conditions:
--
-- The above copyright notice and this permission notice shall be included in
-- all copies or substantial portions of the Software.
--
-- THE SOFTWARE IS PROVIDED "AS IS", WITHOUT WARRANTY OF ANY KIND, EXPRESS OR
-- IMPLIED, INCLUDING BUT NOT LIMITED TO THE WARRANTIES OF MERCHANTABILITY,
-- FITNESS FOR A PARTICULAR PURPOSE AND NONINFRINGEMENT. IN NO EVENT SHALL THE
-- AUTHORS OR COPYRIGHT HOLDERS BE LIABLE FOR ANY CLAIM, DAMAGES OR OTHER
-- LIABILITY, WHETHER IN AN ACTION OF CONTRACT, TORT OR OTHERWISE, ARISING FROM,
-- OUT OF OR IN CONNECTION WITH THE SOFTWARE OR THE USE OR OTHER DEALINGS IN
-- THE SOFTWARE.
-- -----------------------------------------------------------------------------

-- Company: 			Dossytronics
-- Engineer: 			Dominic Beesley
-- 
-- Create Date:    	19/7/2022
-- Design Name: 
-- Module Name:    	fishbone bus - CPU wrapper component - arm2
-- Project Name: 
-- Target Devices: 
-- Tool versions: 
-- Description: 		A fishbone wrapper for the arm2 processor slot
-- Dependencies: 
--
-- Revision: 
-- Additional Comments: 
--
----------------------------------------------------------------------------------

library ieee;
use ieee.std_logic_1164.all;
use ieee.numeric_std.all;

library work;
use work.fishbone.all;
use work.common.all;
use work.board_config_pack.all;
use work.fb_cpu_pack.all;
use work.fb_cpu_exp_pack.all;

entity fb_cpu_arm2 is
	generic (
		CLOCKSPEED							: positive := 128;
		SIM									: boolean := false
	);
	port(

		-- configuration
		cpu_en_i									: in std_logic;				-- 1 when this cpu is the current one
		fb_syscon_i								: in	fb_syscon_t;
		cfg_mosram_i							: in std_logic;

		-- state machine signals
		wrap_o									: out t_cpu_wrap_o;
		wrap_i									: in t_cpu_wrap_i;

		-- CPU expansion signals
		wrap_exp_o								: out t_cpu_wrap_exp_o;
		wrap_exp_i								: in t_cpu_wrap_exp_i;

		-- special arm2 signals

		jim_en_i									: in		std_logic

	);
end fb_cpu_arm2;

architecture rtl of fb_cpu_arm2 is

	function prior(x : in std_logic_vector) return std_logic_vector is
	variable v_x   : std_logic_vector(x'length-1 downto 0);
	variable v_ret : std_logic_vector(x'length-1 downto 0);
	begin
	   v_x   := x;
	   v_ret := (others => '0');
	   for I in 0 to x'length-1 loop
	      if v_x(I) = '1' then
	         v_ret(I) := '1';
	         return v_ret;
	      end if;
	   end loop;
	   return v_ret;
	end function;

-- timings below in number of fast clocks
	constant C_CLKD2_8		: natural 		:= 8;		-- clock half period - 8MHz

	signal r_clkctdn			: unsigned(NUMBITS(C_CLKD2_8)-1 downto 0) := to_unsigned(C_CLKD2_8-1, NUMBITS(C_CLKD2_8));

	signal r_cpu_phi1			: std_logic;
	signal r_cpu_phi2			: std_logic;

	signal r_cyc_o				: std_logic;
	signal i_cyc_ack_i		: std_logic;
	signal r_D_wr_stb			: std_logic_vector(3 downto 0);
	signal r_D_wr				: std_logic_vector(31 downto 0);

	signal r_arm_boot			: std_logic;							-- place ROM at 0-100 from 8D3Fxx at boot

	-- address signals registered from the cpu during phi2 of previous cycle (pipelined)
	-- note ABE, ALE are pulled high
	signal r_a_cpu_p			: std_logic_vector(23 downto 0);
	signal r_nMREQ_p				: std_logic;
	signal r_nOPC_p				: std_logic;
	signal r_nBW_p				: std_logic;
	signal r_nRW_p				: std_logic;

	-- the current ARM cycle's request: copied from the _p signals when phi2
	-- ends (the cycle starts) and held for the whole cycle, so an access that
	-- starts late (behind a posted write) still uses this cycle's values
	signal r_a_cpu_cur		: std_logic_vector(23 downto 0);
	signal r_nMREQ_cur		: std_logic := '1';
	signal r_nBW_cur			: std_logic;
	signal r_nRW_cur			: std_logic;						-- also sets the PORTA buffer direction
	signal r_instr_fetch		: std_logic;						-- not nOPC

	-- Fishbone access signals
	signal r_A_log_cur		: std_logic_vector(23 downto 0);
	signal r_WE					: std_logic;

	-- port A buffer signals
	signal r_nRW_buf_dly		: std_logic_vector(1 downto 0);	-- r_nRW_cur delayed for the PORTA buffer direction

	-- port B

	signal i_CPUSKT_ABRT_b2c	: std_logic;
	signal i_CPUSKT_phi1_b2c	: std_logic;
	signal i_CPUSKT_phi2_b2c	: std_logic;
	signal i_CPUSKT_nIRQ_b2c	: std_logic;
	signal i_CPUSKT_nFIRQ_b2c	: std_logic;
	signal i_CPUSKT_RES_b2c		: std_logic;

	signal i_CPUBRD_nBL_b2c		: std_logic_vector(3 downto 0);

	signal i_BUF_D_RnW_b2c		: std_logic;

	signal i_CPUSKT_nM_c2b		: std_logic_vector(1 downto 0);
	signal i_CPUSKT_nRW_c2b		: std_logic;
	signal i_CPUSKT_nBW_c2b		: std_logic;
	signal i_CPUSKT_nOPC_c2b	: std_logic;
	signal i_CPUSKT_nMREQ_c2b	: std_logic;
	signal i_CPUSKT_nTRAN_c2b	: std_logic;
	signal i_CPUSKT_SEQ_c2b		: std_logic;


	signal i_CPUSKT_D_mux_c2b	: std_logic_vector(7 downto 0);
	signal i_CPUSKT_D_mux_b2c	: std_logic_vector(7 downto 0);
	signal i_CPUSKT_A_c2b		: std_logic_vector(25 downto 0);

	signal r_rd_nBL				: std_logic_vector(3 downto 0);	-- read latch pre-enables, low for 1 clock per byte lane
	signal r_rd_nBL2				: std_logic_vector(3 downto 0);	-- actual read latch enables, low for 1 clock 1/2 clock later
	signal r_rd_D					: std_logic_vector(7 downto 0);	-- read byte to the latches - must be valid for at least 2 cycles.

	signal r_write_lane			: std_logic_vector(3 downto 0);
	signal r_write_lane_prev	: std_logic_vector(3 downto 0);
	signal r_write_lane_done	: std_logic_vector(3 downto 0);
	signal r_write_lane_done2	: std_logic_vector(3 downto 0);

	type t_clk_state is (
		phi1,
		phi2
		);

	signal r_clk_state		: t_clk_state;

	-- Fishbone access for the current ARM cycle:
	--   idle  		no access in progress (a pending one starts from here)
	--   rd    		read in progress, waiting for con_burst's ack
	--   wr    		write in progress: gathering the bytes from the ARM in phi2
	--   wr_post	write has been posted wait for ack but allow phi2 to end
	--         		then waiting for con_burst's ack before resuming idle
	type t_mem_acc_state is (
		idle,
		rd,
		wr,
		wr_post
		);

	signal r_mem_acc_state  : t_mem_acc_state;

	-- handshake between p_clk_state (ARM phi1/phi2) and p_mem_acc_state (Fishbone)
	signal r_new_cycle		: std_logic;		-- (p_clk_state) one clock pulse: phi2 ended, a new ARM cycle starts; the _cur request is now this cycle's
	signal r_acc_pending		: std_logic;		-- (p_mem_acc_state) this ARM cycle still needs its Fishbone access started
	signal r_release			: std_logic;		-- (p_mem_acc_state) this ARM cycle's access no longer needs the ARM: phi2 may end
	signal r_lane_req		: std_logic_vector(3 downto 0);

begin

	assert CLOCKSPEED = 128 report "CLOCKSPEED must be 128" severity failure;
	
	e_pinmap:entity work.fb_cpu_arm2_exp_pins
	port map(

		-- cpu wrapper signals
		wrap_exp_o => wrap_exp_o,
		wrap_exp_i => wrap_exp_i,

		-- local 6x09 wrapper signals to/from CPU expansion port 

		CPUSKT_ABRT_b2c		=> i_CPUSKT_ABRT_b2c,
		CPUSKT_phi1_b2c		=> i_CPUSKT_phi1_b2c,
		CPUSKT_phi2_b2c		=> i_CPUSKT_phi2_b2c,
		CPUSKT_nIRQ_b2c		=> i_CPUSKT_nIRQ_b2c,
		CPUSKT_nFIRQ_b2c		=> i_CPUSKT_nFIRQ_b2c,
		CPUSKT_RES_b2c			=> i_CPUSKT_RES_b2c,

		-- multiplexed 8 to 32 databus
		CPUSKT_D_mux_b2c		=> i_CPUSKT_D_mux_b2c,
		CPUBRD_nBL_b2c			=> i_CPUBRD_nBL_b2c,
		BUF_D_RnW_b2c			=> i_BUF_D_RnW_b2c,

		CPUSKT_nM_c2b			=> i_CPUSKT_nM_c2b,
		CPUSKT_nRW_c2b			=> i_CPUSKT_nRW_c2b,
		CPUSKT_nBW_c2b			=> i_CPUSKT_nBW_c2b,
		CPUSKT_nOPC_c2b		=> i_CPUSKT_nOPC_c2b,
		CPUSKT_nMREQ_c2b		=> i_CPUSKT_nMREQ_c2b,
		CPUSKT_nTRAN_c2b		=> i_CPUSKT_nTRAN_c2b,
		CPUSKT_SEQ_c2b			=> i_CPUSKT_SEQ_c2b,

		CPUSKT_D_mux_c2b		=> i_CPUSKT_D_mux_c2b,
		CPUSKT_A_c2b			=> i_CPUSKT_A_c2b

	);


	-- The PORTA direction changes 2 clocks after r_nRW_cur: at the end of a read
	-- the last lane's latch (nBL) closes on the same edge that r_nRW_cur changes,
	-- so without the delay PORTA stops being driven with no hold time
	-- (2543 hold is 2 ns). Writes don't need DIR until phi2.
	i_BUF_D_RnW_b2c <= 	not r_nRW_buf_dly(1);

	i_CPUSKT_ABRT_b2c 	<= '0';
	i_CPUSKT_phi1_b2c 	<= r_cpu_phi1;
	i_CPUSKT_phi2_b2c 	<= r_cpu_phi2;
	i_CPUSKT_RES_b2c		<= fb_syscon_i.rst when cpu_en_i = '1' else '1';		-- can be async
	i_CPUSKT_nFIRQ_b2c	<= wrap_i.nmi_n;
	i_CPUSKT_nIRQ_b2c 	<= wrap_i.irq_n;
	i_CPUBRD_nBL_b2c 		<= r_rd_nBL2 when r_WE = '0' else
									not r_write_lane;
	i_CPUSKT_D_mux_b2c <= 	r_rd_D;


	wrap_o.BE 				<= '0';
	wrap_o.A	 				<= r_A_log_cur;
	wrap_o.lane_req		<= r_lane_req;
	wrap_o.cyc 				<= r_cyc_o;
	wrap_o.we	  			<= r_WE;
	wrap_o.D_wr				<=	r_D_wr;
	wrap_o.D_wr_stb		<= r_D_wr_stb;
	wrap_o.rdy_ctdn		<= RDY_CTDN_MIN;
	wrap_o.instr_fetch 	<= r_instr_fetch;

	i_cyc_ack_i 			<= wrap_i.ack;



	-- Read bytes to the CPU board latches. Data and latch enable come straight
	-- from registers (only the CPU mux follows), so they reach the pins
	-- together. They are loaded from con_burst's rx_lane_unreg/rx_D_rd_unreg,
	-- so they change on the same edge as ack_lane did. Each latch is re-registered
	-- on the falling_edge in the p_rd_lat2 process and is open for
	-- one clock while its byte lane data is on PORTA; the next byte comes at least
	-- one half clock after the BL2 latch closes (back-to-back reads are 2 clocks apart).
	p_rd_lat:process(fb_syscon_i)
	begin
		if fb_syscon_i.rst = '1' then
			r_rd_nBL <= (others => '1');
			r_rd_D <= (others => '0');
		elsif rising_edge(fb_syscon_i.clk) then
			r_rd_nBL <= not wrap_i.rx_lane_unreg;
			if my_or_reduce(wrap_i.rx_lane_unreg) = '1' then
				r_rd_D <= wrap_i.rx_D_rd_unreg;
			end if;
		end if;
	end process;

	-- shifted byte lane latch signal to allow data throw exp4 4245 to transit before
	-- latching.
	p_rd_lat2:process(fb_syscon_i)
	begin
		if fb_syscon_i.rst = '1' then
			r_rd_nBL2 <= (others => '1');
		elsif falling_edge(fb_syscon_i.clk) then
			r_rd_nBL2 <= r_rd_nBL;
		end if;
	end process;

	p_mem_acc_state:process(fb_syscon_i)
	variable v_start : boolean;
	begin
		if fb_syscon_i.rst ='1' then
			r_cyc_o <= '0';
			r_lane_req <= (others => '1');
			r_write_lane <= (others => '0');
			r_write_lane_prev <= (others => '0');
			r_write_lane_done <= (others => '0');
			r_write_lane_done2 <= (others => '0');
			r_mem_acc_state <= idle;
			r_D_wr_stb <= (others => '0');
			r_D_wr <= (others => '0');
			r_WE <= '0';
			r_A_log_cur <= (others => '0');	
			r_acc_pending <= '0';
			r_release <= '0';
		elsif rising_edge(fb_syscon_i.clk) then

			r_write_lane <= prior(r_lane_req and (not r_write_lane_done) and (r_cpu_phi2 & r_cpu_phi2 & r_cpu_phi2 & r_cpu_phi2));
			r_write_lane_prev <= r_write_lane;
			r_write_lane_done <= r_write_lane_done or r_write_lane_prev;
			r_write_lane_done2 <= r_write_lane_done;

			-- a new ARM cycle: take its access requirement, it hasn't been released yet
			if r_new_cycle = '1' then
				r_acc_pending <= not r_nMREQ_cur;
				r_release <= '0';
			end if;

			case r_mem_acc_state is 
				when idle =>
					null; -- a pending access starts below
				when rd =>
					if i_cyc_ack_i then
						r_cyc_o <= '0';
						r_release <= '1';							-- read data is in the latches
						r_mem_acc_state <= idle;
					end if;				
				when wr =>
					if r_lane_req = r_D_wr_stb then
						r_mem_acc_state <= wr_post;
						r_release <= '1';							-- release phi2, allow cpu to continue
					elsif r_cpu_phi2 = '1' then
						for I in 0 to 3 loop
							if r_write_lane_done2(I) = '1' and r_D_wr_stb(I) = '0' then
   							r_D_wr(7+8*I downto 8*I) <= i_CPUSKT_D_mux_c2b;
							end if;
						end loop;
						r_D_wr_stb <= r_D_wr_stb or r_write_lane_done2;
					end if;
				when wr_post =>
					if i_cyc_ack_i = '1' then
						r_D_wr_stb <= (others => '0');
						r_cyc_o <= '0';
						r_mem_acc_state <= idle;
					end if;
				when others =>
					r_cyc_o <= '0';
					r_D_wr_stb <= (others => '0');
					r_mem_acc_state <= idle;
			end case;

			-- start this cycle's access: from a pending request, or straight from the
			-- new-cycle pulse (so a memory cycle still starts at T+1). cyc has been low
			-- for at least a clock: it drops on the ack edge, which takes us to idle.
			v_start := r_mem_acc_state = idle and
						  (r_acc_pending = '1' or (r_new_cycle = '1' and r_nMREQ_cur = '0'));

			if v_start then
				r_acc_pending <= '0';
					r_D_wr_stb <= (others => '0');
					r_write_lane <= (others => '0');
					r_write_lane_prev <= (others => '0');
					r_write_lane_done <= (others => '0');
					r_write_lane_done2 <= (others => '0');
					if r_nBW_cur = '1' then
						r_lane_req <= "1111";
						r_A_log_cur <= r_a_cpu_cur(23 downto 2) & "00";
					else
						r_lane_req <= (others => '0');
						r_lane_req(to_integer(unsigned(r_a_cpu_cur(1 downto 0)))) <= '1';
						r_A_log_cur <= r_a_cpu_cur(23 downto 0);
					end if;
					if r_nRW_cur = '0' then
						r_mem_acc_state <= rd;
						r_WE <= '0';
					else
						r_mem_acc_state <= wr;
						r_WE <= '1';
					end if;
					r_cyc_o <= '1';
			end if;
		end if;
	end process;

	p_clk_state:process(fb_syscon_i)
	begin
		if rising_edge(fb_syscon_i.clk) then

			r_new_cycle <= '0';
			r_nRW_buf_dly <= r_nRW_buf_dly(0) & r_nRW_cur;

			if r_clkctdn /= 0 then
				r_clkctdn <= r_clkctdn - 1;
			end if;

			case r_clk_state is
				when phi1 =>
					if r_clkctdn = 0 then
						r_cpu_phi1 <= '0';
						r_clkctdn <= to_unsigned(C_CLKD2_8-1, r_clkctdn'length);
						r_clk_state <= phi2;
					else
						r_cpu_phi1 <= '1';
					end if;

				when phi2 =>

					-- get pipelined stuff for next cycle
					if r_arm_boot = '1' and i_CPUSKT_nRW_c2b = '0' then
						if cfg_mosram_i = '1' then
							r_a_cpu_p <= x"7D3F" & i_CPUSKT_A_c2b(7 downto 0); 	-- boot from SWRAM at 7D xxxx
						else
							r_a_cpu_p <= x"8D3F" & i_CPUSKT_A_c2b(7 downto 0); 	-- boot from Flash at 8D xxxx
						end if;
					else
						r_a_cpu_p <= i_CPUSKT_A_c2b(23 downto 0);
					end if;
					r_nMREQ_p <= i_CPUSKT_nMREQ_c2b or fb_syscon_i.rst;
					r_nOPC_p <= i_CPUSKT_nOPC_c2b;
					r_nBW_p <= i_CPUSKT_nBW_c2b;
					r_nRW_p <= i_CPUSKT_nRW_c2b;

					

					-- end phi2 once the minimum time is up and either this cycle has no
					-- memory access, or its access has released the ARM
					if r_clkctdn = 0 and (r_nMREQ_cur = '1' or r_release = '1') then
						r_cpu_phi2 <= '0';
						r_clkctdn <= to_unsigned(C_CLKD2_8-1, r_clkctdn'length);
						r_clk_state <= phi1;
						r_new_cycle <= '1';
						-- freeze the new cycle's request
						r_a_cpu_cur <= r_a_cpu_p;
						r_nMREQ_cur <= r_nMREQ_p;
						r_nBW_cur <= r_nBW_p;
						r_nRW_cur <= r_nRW_p;
						r_instr_fetch <= not r_nOPC_p;
					else
						r_cpu_phi2 <= '1';
					end if;
				when others =>
					r_clk_state <= phi1;
			end case;
		end if;

	end process;

	p_arm_boot:process(fb_syscon_i)
	begin
		if fb_syscon_i.rst = '1' then
			r_arm_boot <= '1';
		elsif rising_edge(fb_syscon_i.clk) then
			if JIM_en_i = '1' then
				r_arm_boot <= '0';
			end if;
		end if;
	end process;

  	wrap_o.noice_debug_cpu_clken 	<= '0';
  	wrap_o.noice_debug_5c	 	 	<=	'0';
  	wrap_o.noice_debug_opfetch 	<= '0';
	wrap_o.noice_debug_A0_tgl  	<= '0';



end rtl;
