dominicbeesley/blitter-vhdl-6502/src/hdl/modelC20K/asm/C20KFirstLight/C20KBareMON/C20KBareMON.asm

; MIT License
; 
; Copyright (c) 2025 Dossytronics
; https://github.com/dominicbeesley/blitter-vhdl-6502
; 
; Permission is hereby granted, free of charge, to any person obtaining a copy
; of this software and associated documentation files (the "Software"), to deal
; in the Software without restriction, including without limitation the rights
; to use, copy, modify, merge, publish, distribute, sublicense, and/or sell
; copies of the Software, and to permit persons to whom the Software is
; furnished to do so, subject to the following conditions:
; 
; The above copyright notice and this permission notice shall be included in all
; copies or substantial portions of the Software.
; 
; THE SOFTWARE IS PROVIDED "AS IS", WITHOUT WARRANTY OF ANY KIND, EXPRESS OR
; IMPLIED, INCLUDING BUT NOT LIMITED TO THE WARRANTIES OF MERCHANTABILITY,
; FITNESS FOR A PARTICULAR PURPOSE AND NONINFRINGEMENT. IN NO EVENT SHALL THE
; AUTHORS OR COPYRIGHT HOLDERS BE LIABLE FOR ANY CLAIM, DAMAGES OR OTHER
; LIABILITY, WHETHER IN AN ACTION OF CONTRACT, TORT OR OTHERWISE, ARISING FROM,
; OUT OF OR IN CONNECTION WITH THE SOFTWARE OR THE USE OR OTHER DEALINGS IN THE
; SOFTWARE.

		.include 	"p20k.inc"

.macro          M_PRINT addr
		ldx	#<addr
		ldy	#>addr
		jsr	PrintXY
.endmacro

.macro		M_PRINTI str
		jsr	PrintI
		.asciiz	str
.endmacro

.macro		M_ADDR 	addr
		lda	#.bankbyte(addr)
		sta	zp_addr+2
		lda	#.hibyte(addr)
		sta	zp_addr+1
		lda	#.lobyte(addr)
		sta	zp_addr+0
.endmacro

LOCALBUF	=	$4000		; load ROMSs to here to bounce up to chipram / Flash
FLASHBASE 	=	$800000		; base of Flash
REASON_RESET	=	0
REASON_USER	=	1
REASON_IRQ	=	2
REASON_BRK	=	3
REASON_NMI	=	4

fred_SPI_CTL		=	$FC50
fred_SPI_STAT		=	$FC50
fred_SPI_DIV		=	$FC51
fred_SPI_READ_DATA  	=	$FC52
fred_SPI_WRITE_END 	=	$FC52
fred_SPI_WRITE_CONT  	=	$FC53


		.ZEROPAGE
zp_tmpptr:	.res	2
zp_addr:	.res	3
zp_tmp = zp_addr
zp_data:	.res	1
zp_fail:	.res	1
zp_len:		.res	3
zp_curlen:	.res	1
zp_cksum:	.res	1
zp_src_ptr:	.res	2

zp_trans_acc:	.res	4

zp_hex_tmp:	.res	1

zp_mos_txtptr:	.res	2

read_dump_flag:	.res	1
srec_type_flag = read_dump_flag


		.BSS
addr_max:	.res	3
flag_soak:	.res	1
flag_soak_ctr:	.res	4

REGS_START:	
REGS_P:		.res	1
REGS_A:		.res	1
REGS_X:		.res	1
REGS_Y:		.res	1
REGS_PC:		.res	2
REGS_REASON:	.res	1
REGS_END:
		

textbuf:		.res	128
textptr:		.res	1


		.CODE

;==============================================================================
; M A I N
;==============================================================================
enter_main:
		sei
		cld

		sta	REGS_REASON

		lda	#DEVNO_C20K
		sta	fred_JIM_DEVNO
		jsr	OSNEWL
		jsr	show_regs

mainloop:	
		lda	#':'
		jsr	OSASCI

		jsr	ReadLine
		bcs	mainloop

		lda	textbuf
		jsr	ToUpper
		sta	zp_tmp
		ldx	#0
@cmd_lp:	lda	command_table,X
		bmi	cmd_err
		cmp	zp_tmp
		beq	@cmd_fnd
		inx
		inx
		inx
		jmp	@cmd_lp

@cmd_fnd:	
		lda	command_table+2,X
		pha
		lda	command_table+1,X
		pha

		ldx	#<textbuf
		stx	zp_mos_txtptr
		ldy	#>textbuf
		sty	zp_mos_txtptr+1
		ldy	#1

		rts

cmd_err:	jsr	OSNEWL
		lda	#'?'
		jsr	OSASCI
		; drop through unrecognized
		jmp	 mainloop


ErrBadHex:	M_PRINT str_BadHex
		jmp	 mainloop
ErrBadChecksum:	M_PRINT str_BadCheckSum
		jmp	 mainloop


;==============================================================================
; G O 
;==============================================================================
doGO:		
		jsr	ParseHex
		bcc	@ok_start
		jmp	ErrBadHex
@ok_start:	lda	#>(mainloop-1)
		pha
		lda	#<(mainloop-1)
		pha
		jmp	(zp_trans_acc)



;==============================================================================
; S R E C    R E A D
;==============================================================================
doSREC:		
		
		jsr	ParseHexNyb
		bcc	@ok1
@hexerr:	jmp	ErrBadHex
@ok1:		tax
		beq	@cont		; ignore header
		cmp	#'3'
		bcs	@cont2		; skip all others
		ror	A
		ror	srec_type_flag	; set top bit if 16 bit, clear else
		lda	#0
		sta	zp_cksum
		jsr	ParseHexByte
		bcs	@hexerr
		sta	zp_len
		dec	zp_len				; dec by 1 for main loop, +1 for checksum
		beq	@hexerr
		lda	#$FF
		bit	srec_type_flag
		bmi	@b16_1				; 16 bit Srec skip top byte, set to FF
		jsr	ParseHexByte
		bcs	@hexerr
		dec	zp_len
		beq	@hexerr
@b16_1:		sta	zp_addr + 2
		jsr	ParseHexByte
		bcs	@hexerr
		sta	zp_addr + 1
		dec	zp_len
		beq	@hexerr
		jsr	ParseHexByte
		bcs	@hexerr
		sta	zp_addr + 0
		dec	zp_len
		beq	@checksum
		ldx	zp_addr
		lda	zp_addr + 1
		sta	fred_JIM_PAGE_LO
		lda	zp_addr + 2
		sta	fred_JIM_PAGE_HI
@l:		jsr	ParseHexByte
		bcs	@hexerr
		sta	JIM,X
		inx
		bne	@spg
		inc	fred_JIM_PAGE_LO
		bne	@spg
		inc	fred_JIM_PAGE_HI
@spg:		dec	zp_len
		bne	@l
@checksum:	jsr	ParseHexByte
		lda	zp_cksum
		eor	#$FF
		beq	@cont	
@errcksum:	jmp	ErrBadChecksum
@cont2:		lda	#'!'
		jsr	OSWRCH
@cont:		jmp	mainloop

;==============================================================================
; E R A S E
;==============================================================================

doERASE:	jsr	ParseHex
		bcc	@ok_start
		jmp	ErrBadHex
@ok_start:	jsr	acc2Addr
		jsr	ParseHex
		bcc	@ok_len
		jmp	ErrBadHex
@ok_len:	jsr	acc2Len

		M_PRINT	str_Erase
		

		lda	zp_addr+1
		and	#$0F
		ora	zp_addr			; check sector boundary
		bne	@bad_sector
		lda	zp_len+1
		and	#$0F
		ora	zp_len			; check sector boundary
		bne	@bad_sector

		lda	#0
		sta	zp_addr
		sta	zp_len
		lda	zp_addr + 1
		and	#$F0
		sta	zp_addr + 1
		lda	zp_len + 1
		and	#$F0
		sta	zp_len + 1

@erase_loop:	lda	zp_len + 1
		ora	zp_len + 2
		beq	@mm

		jsr	PrintAddr
		jsr	OSNEWL

		lda	#$80
		jsr	flash_cmd
		jsr	pushAddr
		jsr	jimwrite5522
		jsr	popAddr
		jsr	jimaddr
		ldx	zp_addr
		lda	#$30
		sta	JIM,X

@wlp:		lda	JIM,X
		eor	JIM,X
		bne	@wlp

		clc
		lda	zp_addr + 1
		adc	#$10
		sta	zp_addr + 1
		lda	zp_addr + 2
		adc	#0
		sta	zp_addr + 2

		sec
		lda	zp_len + 1
		sbc	#$10
		sta	zp_len + 1
		lda	zp_len + 2
		sbc	#0
		sta	zp_len + 2
		jmp	@erase_loop

@bad_sector:	M_PRINT str_badSector
@mm:		jmp	mainloop

;==============================================================================
; P R O G R A M   F R O M   R A M   A T   LOCALBUF
;==============================================================================

doPROG:		jsr	ParseHex
		bcc	@ok_start
		jmp	ErrBadHex
@ok_start:	jsr	acc2Addr
		jsr	ParseHex
		bcc	@ok_len
		jmp	ErrBadHex
@ok_len:	jsr	acc2Len
		
		M_PRINT	str_Prog
		lda	#<LOCALBUF			; point at buffer starting at local 0x1000
		sta	zp_src_ptr
		lda	#>LOCALBUF
		sta	zp_src_ptr+1
@prog_loop:	jsr	PrintAddr
		jsr	OSNEWL
		; length to program in X 
		ldx	#$80
		lda	zp_len+1
		ora	zp_len+2
		bne	@lensk3
		lda	zp_len
		bne	@lensk1
		jmp	mainloop
@lensk1:	bmi	@lensk3
		tax
@lensk3:	; check for page alignment
		clc
		txa
		adc	zp_addr
		bcc	@lensk2
		lda	zp_addr
		eor	#$FF
		tax
		inx
@lensk2:	stx	zp_curlen
		stx	zp_cksum		; save length for later add
		ldy	#0
		ldx	zp_addr
		lda	zp_addr+2
		bmi	@prog_flash
		; RAM program
		jsr	jimaddr
@rplp:		lda	(zp_src_ptr),Y
		sta	JIM,X
		iny
		inx
		dec	zp_curlen
		bne	@rplp

@uppaddr:	lda	zp_cksum
		jsr	addAAddr
		clc
		lda	zp_cksum
		adc	zp_src_ptr
		sta	zp_src_ptr
		lda	#0
		adc	zp_src_ptr+1
		sta	zp_src_ptr+1

		sec
		lda	zp_len
		sbc	zp_cksum
		sta	zp_len
		lda	zp_len+1
		sbc	#0
		sta	zp_len+1
		lda	zp_len+2
		sbc	#0
		sta	zp_len+2

		jmp	@prog_loop


@prog_flash:	lda	#$A0			; write byte command
		jsr	flash_cmd
		jsr	jimaddr
		lda	(zp_src_ptr),Y
		sta	JIM,X
@wlp:		lda	JIM,X
		eor	JIM,X
		bne	@wlp

		lda	(zp_src_ptr),Y
		eor	JIM,X
		beq	@okv
		jsr	pushAddr
		stx	zp_addr
		jsr	PrintAddr
		lda	#'!'
		jsr	uart_tx
		lda	JIM,X
		jsr	PrintHex
		lda	#'!'
		jsr	uart_tx
		lda	(zp_src_ptr),Y
		jsr	PrintHex
		jsr	OSNEWL
		jmp	mainloop

@okv:		iny
		inx
		dec	zp_curlen
		bne	@prog_flash
		jmp	@uppaddr


flash_prog_byte:pha
		lda	#$A0
		jsr	flash_cmd
		pla
		jsr	jimwriteA
		; todo: check toggle bit?
		jmp	mainloop

;==============================================================================
; F L A S H
;==============================================================================

doFLASH:
		lda	(zp_mos_txtptr), Y
		iny
		jsr	ToUpper
		cmp	#'R'
		beq	doFLASH_READ
		cmp	#'D'
		beq	doFLASH_DUMP
		jsr	OSASCI
		jmp	cmd_err

doFLASH_READ:	lda	#$40
		bne	doDUMPREAD
doFLASH_DUMP:	lda	#$C0
		bne	doDUMPREAD

;==============================================================================
; R E A D   M E M O R Y
;==============================================================================
doREAD:		lda	#0
		beq	doDUMPREAD
doDUMP:		lda	#$80
doDUMPREAD:	sta	read_dump_flag
		jsr	ParseHex
		bcc	@ok_start
		jmp	ErrBadHex
@ok_start:	jsr	acc2Addr
		jsr	ParseHex
		bcc	@ok_len
		jmp	ErrBadHex
@ok_len:	jsr	acc2Len
@rd_lp:		ldx	#$20
		lda	read_dump_flag
		bpl	@nodump3
		ldx	#$10
@nodump3:	stx	zp_curlen
		lda	zp_len+1
		ora	zp_len+2
		bne	@go20		; if >= $100 start
		lda	zp_len+0
		bne	@skend
		jmp	@end
@skend:		cmp	zp_curlen
		bcs	@go20		; if >= 40 start
		tax
@go20:		; now check to see if this will cross a page boundary
		clc
		txa
		adc	zp_addr
		bcc	@go
		; it does so set length to remainder
		lda	zp_addr
		eor	#$FF
		tax
		inx
@go:		stx	zp_curlen
		ldy	#0
		sty	zp_cksum

		lda	read_dump_flag
		bmi	@dump1
		lda	#'S'
		jsr	OSWRCH
		lda	#'2'
		jsr	OSWRCH
		lda	zp_curlen
		clc
		adc	#4			; add 4 for addr, checksum
		jsr	PrintHex
@dump1:		jsr	PrintAddr
		lda	read_dump_flag
		bpl	@nodump1
		M_PRINTI " : "		
@nodump1:	jsr	@read_start_block
		ldy	zp_addr+0
@rd_lp2:	jsr	@read_byte
		iny
		jsr	PrintHex
		lda	read_dump_flag
		bpl	@nos
		lda	#' '
		jsr	OSASCI
@nos:		dex
		bne	@rd_lp2
		lda	read_dump_flag
		bpl	@nodump2
		M_PRINTI " : "		
		jsr	@read_start_block
		ldx	zp_curlen
		ldy	zp_addr+0
@clp:		jsr	@read_byte
@op:		bmi	@skctl2
		cmp	#' '
		bcs	@skctl
@skctl2:	lda	#'.'
@skctl:		jsr	OSASCI
		iny
		dex
		bne	@clp
		beq	@endl

@nodump2:	lda	zp_cksum
		eor	#$FF
		jsr	PrintHex
@endl:		jsr	OSNEWL
		lda	zp_curlen
		jsr	subALen
		lda	zp_curlen
		jsr	addAAddr
		jmp	@rd_lp

@end:		jsr	OSNEWL
		jmp	mainloop

@read_start_block:
		bit	read_dump_flag
		bvs	@spi_start
		jsr	jimaddr
		jmp	@goy
@spi_start:	jsr	spi_reset
		lda	#$0B		; fast read
		jsr	spi_write_cont
		lda	zp_addr+2
		jsr	spi_write_cont
		lda	zp_addr+1
		jsr	spi_write_cont
		lda	zp_addr+0
		jsr	spi_write_cont
		lda	#$FF		; dummy
		jsr	spi_write_cont
@goy:		rts

@read_byte:	bit	read_dump_flag
		bvs	@rspi
		lda	JIM,Y
		rts
@rspi:		jsr	spi_write_cont
		rts

@read_end_block:
		bit	read_dump_flag
		bvc	@rts
		jsr	spi_reset
@rts:		rts

;==============================================================================
; R E A D   L I N E   F R O M   U A R T
;==============================================================================


ReadLine:	ldx	#0		
		stx	textptr
@rllp:		
		jsr	uart_rx
		cmp	#27
		beq	@esc
		ldx	textptr
		bne	@nospck
		cmp	#32
		beq	@rllp
@nospck:	cmp	#13
		beq	@cr
		cmp	#10
		beq	@cr
		cmp	#32
		bcc	@rllp
		cmp	#8
		beq	@del
		cmp	#127
		beq	@del
@cr:		jsr	uart_tx
		ldx	textptr
		sta	textbuf,X
		inx	
		bpl	@skdec
		dex
@skdec:		stx	textptr		
		cmp	#10
		beq	@done
		cmp	#13
		bne	@rllp
@done:		lda	#0
		sta	textbuf,X
		jsr	OSNEWL
		clc
		rts

@esc:		M_PRINT str_Escape
		sec
		rts

@del:		txa
		beq	@rllp
		lda	#8
		jsr	uart_tx
		lda	#32
		jsr	uart_tx
		lda	#8
		jsr	uart_tx
		dex
		stx	textptr
		jmp	@rllp

;----------------------------------------------------------------------

flash_cmd:	jsr	pushAddr
		pha
		jsr	jimwrite5522
		M_ADDR	FLASHBASE + $5555
		pla
		jsr	jimwriteA
		jsr	popAddr
		rts
		


jimwrite5555_AA:M_ADDR	FLASHBASE + $5555
		lda	#$AA
		bne	jimwriteA

jimwrite5522:	jsr	jimwrite5555_AA
		; fall through
jimwrite2AAA_55:M_ADDR	FLASHBASE + $2AAA
		lda	#$55
		bne	jimwriteA
jimwrite:
		lda	zp_data
jimwriteA:	pha
		txa
		pha
		jsr	jimaddr
		tsx
		lda	$102,X
		ldx	zp_addr+0
		sta	JIM,X
		pla
		tax
		pla
		rts

jimreadA:
		jsr	jimaddr
		ldx	zp_addr+0
		lda	JIM,X
		rts



jimaddr:
;;		lda	dev_no
;;		sta	zp_mos_jimdevsave
;;		sta	fred_JIM_DEVNO
		pha
		lda	zp_addr+2
		sta	fred_JIM_PAGE_HI
		lda	zp_addr+1
		sta	fred_JIM_PAGE_LO
		pla
		rts

; see http://www.obelisk.me.uk/6502/algorithms.html
PrintHex:
		pha                        
		clc
		adc	zp_cksum
		sta	zp_cksum		; update checksum
		pla
		pha
		lsr 	A
		lsr	A
		lsr 	A
		lsr	A
		jsr 	PrIntHexNyb
		pla
		and 	#$0F
PrIntHexNyb:
		sed
		clc
		adc	#$90
		adc	#$40
		cld
		jmp	OSWRCH

PrintAddr:	lda	zp_addr+2
		jsr	PrintHex
		lda	zp_addr+1
		jsr	PrintHex
		lda	zp_addr+0
		jmp	PrintHex

PrintData:	lda	zp_data
		jmp	PrintHex

PrintXY:		stx	zp_tmpptr
		sty	zp_tmpptr + 1
		ldy	#0
@lp:		lda	(zp_tmpptr),Y
		beq	@out
		jsr	OSASCI
		iny
		bne	@lp
@out:		rts

PrintI:		php
		pha
		txa
		pha
		tya
		pha
		lda	zp_tmpptr
		pha
		lda	zp_tmpptr+1
		pha

		tsx
		lda	$107,X
		sta	zp_tmpptr
		lda	$108,X
		sta	zp_tmpptr+1
		ldy	#1

@lp:		lda	(zp_tmpptr),Y
		beq	@sk
		jsr	OSASCI
		iny
		jmp	@lp
@sk:		clc
		tya
		adc	zp_tmpptr
		sta	$107,X
		lda	#0
		adc	zp_tmpptr + 1
		sta	$108,X

		pla
		lda	zp_tmpptr+1
		pla
		lda	zp_tmpptr
		pla
		tay
		pla
		tax
		pla
		plp
		rts



PromptYN:	jsr	PrintXY
		ldx	#<str_YN
		ldy	#>str_YN
		jsr	PrintXY
@1:		jsr	WaitKey
		bcs	PromptRTS
		and	#$DF
		cmp	#'Y'
		beq	PromptYes
		cmp	#'N'
		bne	@1
PromptNo:	ldx	#<strNo
		ldy	#>strNo
		jsr	PrintXY
		lda	#$FF
		clc
		rts
PromptYes:	ldx	#<strYes
		ldy	#>strYes
		jsr	PrintXY
		lda	#0
		clc
PromptRTS:	rts

Print13:	lda	#13
		jmp	OSWRCH

PrintSpc:	lda	#' '
		jmp	OSWRCH



WaitKey:	jsr	uart_rx
		cmp	#27
		beq	@esc
		clc
		rts
@esc:		M_PRINT str_Escape
		sec
		rts

;------------------------------------------------------------------------------
; Parsing
;------------------------------------------------------------------------------
SkipSpacesPTR:	lda	(zp_mos_txtptr),Y
		iny
		beq	@s
		cmp	#' '
		beq	SkipSpacesPTR
@s:		dey
		rts

ToUpper:	cmp	#'a'
		bcc	@1
		cmp	#'z'+1
		bcs	@1
		and	#$DF
@1:		rts

ParseHex:
		ldx	#$FF				; indicates first char
		jsr	zeroAcc
		jsr	SkipSpacesPTR
		cmp	#$D
		beq	ParseHexErr
ParseHexLp:	jsr	ParseHexNyb
		bcc	ParseHexShAd
		cmp	#' ' + 1
		bcc	ParseHexDone
ParseHexShAd:	jsr	asl4Acc				; multiply existing number by 16
		jsr	addAAcc				; add current digit
		jmp	ParseHexLp
ParseHexAlpha:	cmp	#'A'
		bcc	ParseHexErr
		cmp	#'F'+1
		bcs	ParseHexErr
		sbc	#'A'-11				; note carry clear 'A'-'F' => 10-15
		jmp	ParseHexShAd
ParseHexErr:	sec
		rts
ParseHexDone:	dey
		clc
		rts

ParseHexByte:	jsr	ParseHexNyb
		bcs	@sk
		asl	A
		asl	A
		asl	A
		asl	A
		sta	zp_hex_tmp	
		jsr	ParseHexNyb
		bcs	@sk
		ora	zp_hex_tmp
		pha
		clc
		adc	zp_cksum
		sta	zp_cksum		; update checksum
		pla
		clc
@sk:		rts


ParseHexNyb:	lda	(zp_mos_txtptr),Y
		iny
		jsr	ToUpper
		cmp	#'0'
		bcc	@err
		cmp	#'9'+1
		bcs	@alpha
		sec
		sbc	#'0'
		clc
		rts
@alpha:		cmp	#'A'
		bcc	@err
		cmp	#'F'+1
		bcs	@err
		sbc	#'A'-11
		clc
		rts
@err:		sec
		rts

;------------------------------------------------------------------------------
; Address
;------------------------------------------------------------------------------
acc2Addr:	lda	zp_trans_acc
		sta	zp_addr
		lda	zp_trans_acc + 1
		sta	zp_addr + 1
		lda	zp_trans_acc + 2
		sta	zp_addr + 2
		rts

acc2Len:	lda	zp_trans_acc
		sta	zp_len
		lda	zp_trans_acc + 1
		sta	zp_len + 1
		lda	zp_trans_acc + 2
		sta	zp_len + 2
		rts
subALen:	eor	#$FF
		sec
		adc	zp_len
		sta	zp_len
		lda	zp_len+1
		sbc	#0
		sta	zp_len+1
		lda	zp_len+2
		sbc	#0
		sta	zp_len+2
		rts
addAAddr:	clc
		adc	zp_addr
		sta	zp_addr
		lda	zp_addr+1
		adc	#0
		sta	zp_addr+1
		lda	zp_addr+2
		adc	#0
		sta	zp_addr+2
		rts

pushAddr:	pha
		pha
		pha		; reserve space

		pha
		txa
		pha
		
		; stack
		; + 6..7	rts
		; + 3..5	space
		; + 2		caller A
		; + 1		caller X

		tsx
		lda	$106,X
		sta	$103,X
		lda	$107,X
		sta	$104,X

		; stack
		; + 5..7	spare
		; + 3..4	rts
		; + 2		caller A
		; + 1		caller X

		lda	zp_addr
		sta	$105,X
		lda	zp_addr+1
		sta	$106,X
		lda	zp_addr+2
		sta	$107,X
		pla
		tax
		pla
		rts


		; stack on entry to popAddr
		; + 3..5	pushed addr
		; + 1..2	rts
popAddr:	pha
		txa
		pha

		; + 5..7	pushed addr
		; + 3..4	rts
		; + 2		A
		; + 1		X

		tsx
		lda	$105,X
		sta	zp_addr
		lda	$106,X
		sta	zp_addr+1
		lda	$107,X
		sta	zp_addr+2

		lda	$104,X
		sta	$107,X
		lda	$103,X
		sta	$106,X
		lda	$102,X
		sta	$105,X

		; + 6..7	rts
		; + 5		A
		; + 3..4	-
		; + 2		A
		; + 1		X

		pla
		tax
		pla
		pla
		pla
		pla
		rts






;------------------------------------------------------------------------------
; Arith
;------------------------------------------------------------------------------
zeroAcc:	pha
		lda	#0
		sta	zp_trans_acc
		sta	zp_trans_acc + 1
		sta	zp_trans_acc + 2
		sta	zp_trans_acc + 3
		pla
		rts

asl4Acc:
		pha
		txa
		pha
		ldx	#4
@1:		asl	zp_trans_acc + 0
		rol	zp_trans_acc + 1
		rol	zp_trans_acc + 2
		rol	zp_trans_acc + 3
		dex
		bne	@1
		pla
		tax
		pla
		rts

addAAcc:
		pha
		clc
		adc	zp_trans_acc + 0
		sta	zp_trans_acc + 0
		bcc	@1
		inc	zp_trans_acc + 1
		bne	@1
		inc	zp_trans_acc + 2
		bne	@1
		inc	zp_trans_acc + 3
@1:		pla
		rts

;=============================================
; S P I
;=============================================

spi_reset:
		lda	#$10
		sta	fred_SPI_DIV		; fast spi
		lda	#$1C			; select nCS[7]
		sta	fred_SPI_CTL
		sta	fred_SPI_WRITE_END	; start and reset
		jsr	spi_wait_rd
		lda	#$00			; select nCS[0]
		sta	fred_SPI_CTL
		jmp	spi_wait_rd

spi_write_last:	sta	fred_SPI_WRITE_END
		jmp	spi_wait_rd
spi_write_cont:	sta	fred_SPI_WRITE_CONT
spi_wait_rd:	bit	fred_SPI_STAT
		bmi	spi_wait_rd
		lda	fred_SPI_READ_DATA
		rts





show_help:	jsr	show_help_int

		jmp	mainloop

show_help_int:
		M_PRINT	str_menu

		jsr	spi_reset

		lda	#$9F
		jsr	spi_write_cont
		jsr	spi_write_cont		
		jsr	PrintHex
		jsr	spi_write_cont		
		jsr	PrintHex
		jsr	spi_write_last
		jsr	PrintHex
		jmp	OSNEWL

show_regs:	M_PRINTI	"A="
		lda	REGS_A
		jsr	PrintHex
		M_PRINTI ", X="
		lda	REGS_X
		jsr	PrintHex
		M_PRINTI ", Y="
		lda	REGS_Y
		jsr	PrintHex
		M_PRINTI ", P="
		lda	REGS_P
		jsr	PrintHex
		M_PRINTI ", PC="
		lda	REGS_PC+1
		jsr	PrintHex
		lda	REGS_PC
		jsr	PrintHex
		M_PRINTI ", Why="
		lda	REGS_REASON
		jsr	PrintHex
		jmp	OSNEWL

OSASCI:		cmp	#$0d		; OSASCI output a byte to VDU stream expanding
		bne	OSWRCH		; carriage returns (&0D) to LF/CR (&0A,&0D)
OSNEWL:		lda	#$0a		; OSNEWL output a CR/LF to VDU stream
		jsr	OSWRCH		; Outputs A followed by CR to VDU stream
		lda	#$0d
OSWRCH:
uart_tx:	bit	UART_STAT
		bvs	uart_tx
		sta	UART_DAT
		rts


uart_rx:	bit	UART_STAT
		bpl	uart_rx
		lda	UART_DAT
		rts

		.rodata
str_menu:	.byte   "C20KBareMON",13,10
		.byte   "R(ead) <p-addr> <len>", 13,10
		.byte   "D(ump) <p-addr> <len>", 13,10
		.byte   "E(rase) <p-addr> <len>", 13, 10
		.byte   "P(rog) <p-addr> <len>", 13, 10
		.byte   "G(o) <l-addr>", 13, 10
		.byte   "FR(ead flash) <f-addr> <len>", 13, 10
		.byte   "FD(ump flash) <f-addr> <len>", 13, 10
		.byte   "S<moto srec>", 13, 10
		.byte   "?", 13, 10
		.byte 	0

str_Prog:	.byte	"Prog...",13,10,0
str_Erase:	.byte	"Erase...",13,10,0

str_badSector:	.byte	"Bad sector",13,10,0

str_Escape:	.byte   "Escape", 0
str_YN:		.byte	" (Y/N)?",0
strNo:		.byte	"No", $D, 0
strYes:		.byte	"Yes", $D, 0

str_BadHex:	.byte	"Bad Hex", 13, 10, 0
str_BadCheckSum:.byte	"Bad CKSUM", 13, 10, 0

default_vectors:
		.addr	default_userv
		.addr	default_brk
		.addr	default_irqv
		.addr	default_nmi
end_default_vectors:

.macro		CMD	letter, addr
		.byte	letter
		.addr	addr - 1
.endmacro

command_table:	CMD	'?', show_help
		CMD	'R', doREAD
		CMD	'P', doPROG
		CMD	'D', doDUMP
		CMD	'E', doERASE
		CMD	'S', doSREC
		CMD	'G', doGO
		CMD	'F', doFLASH
		CMD	0,   mainloop

		.SEGMENT "CODE2"
default_userv:	jmp	enter_main
default_irqv:	jmp	enter_main
default_nmi:	jmp	enter_main
default_brk:	jmp	enter_main

;==============================================================================
; R E S E T and default vectors
;==============================================================================
mos_handle_res:

		sei
		cld
		ldx	#$FF	
		txs

		; setup default vectors
		ldx	#end_default_vectors - default_vectors - 1
@vl:		lda	default_vectors,X
		sta	USERV,X
		dex
		bpl	@vl

		jsr	show_help_int

		lda	#REASON_RESET
		jmp	enter_main


mos_handle_nmi:
		jmp	(NMIV)

mos_handle_irq:
		; check for BRK
		pha
		txa
		pha

		; stack
		;	+5	caller PCH
		;	+4	caller PCL
		;	+3	caller P
		;	+2	caller A
		;	+1	caller X

		tsx	
		lda	$103,X
		and	#$10
		bne	mos_handle_brk

		
		;;;;; interrupt handler, can use A,X
		jsr	call_irqv

		pla
		tax
		pla
		rti

call_irqv:	jmp	(IRQV)

mos_handle_brk:	pla
		tax
		pla
		jmp	(BRKV)

		.SEGMENT "VECTORS"
hanmi:  .addr   mos_handle_nmi                  
hares:  .addr   mos_handle_res                  
hairq:  .addr   mos_handle_irq                  

		.END

		.end
