dominicbeesley/blitter-vhdl-6502/src/hdl/modelC20K/shared/fb_C20K_mem_cpu_65816.vhd

-- MIT License
-- -----------------------------------------------------------------------------
-- Copyright (c) 2023 Dominic Beesley https://github.com/dominicbeesley
--
-- Permission is hereby granted, free of charge, to any person obtaining a copy
-- of this software and associated documentation files (the "Software"), to deal
-- in the Software without restriction, including without limitation the rights
-- to use, copy, modify, merge, publish, distribute, sublicense, and/or sell
-- copies of the Software, and to permit persons to whom the Software is
-- furnished to do so, subject to the following conditions:
--
-- The above copyright notice and this permission notice shall be included in
-- all copies or substantial portions of the Software.
--
-- THE SOFTWARE IS PROVIDED "AS IS", WITHOUT WARRANTY OF ANY KIND, EXPRESS OR
-- IMPLIED, INCLUDING BUT NOT LIMITED TO THE WARRANTIES OF MERCHANTABILITY,
-- FITNESS FOR A PARTICULAR PURPOSE AND NONINFRINGEMENT. IN NO EVENT SHALL THE
-- AUTHORS OR COPYRIGHT HOLDERS BE LIABLE FOR ANY CLAIM, DAMAGES OR OTHER
-- LIABILITY, WHETHER IN AN ACTION OF CONTRACT, TORT OR OTHERWISE, ARISING FROM,
-- OUT OF OR IN CONNECTION WITH THE SOFTWARE OR THE USE OR OTHER DEALINGS IN
-- THE SOFTWARE.
-- ----------------------------------------------------------------------

-- Company:          Dossytronics
-- Engineer:         Dominic Beesley
-- 
-- Create Date:      8/8/2025
-- Design Name: 
-- Module Name:      fb_C20K_mem_cpu_65816
-- Project Name: 
-- Target Devices: 
-- Tool versions: 
-- Description:      A fishbone wrapper for just the on-board 65816 shared with memory bus
-- Dependencies: 
--
-- Revision: 
--    Oct 2026: shared by C20K and C20K816only (merged from the two board
--    copies: C20K816only's Fishbone/timing version, plus the C20K's
--    cfg_cpu_use_t65_i, mem_rdy and mem5)
-- Additional Comments: 
--    
-- Notes to future self:
--    
-- BANK ADDRESS
-- ============
--
-- 65816 - only asserts bank address on first cycle where RDY is not asserted
--
-- PHI2  ________|¯¯¯¯¯¯¯¯|________|¯¯¯¯¯¯¯¯|________|¯¯¯¯¯¯¯¯|________|¯¯¯¯¯¯¯¯|
--
-- RDY   ____________________________|¯¯¯¯¯¯¯¯|__________________________|¯¯¯¯¯¯¯¯|
--
-- D     BA=====>----------------<===D=========>-<=BA=>--------------<====D=======>
--
-- This means that for each CPU cycle we must enter the wait_asetup state once and
-- only once, if we skip a RDY cycle we should repeat cpu_log_a afterwards
-- (an fb_mem access goes mem1..mem5 and back to cpu_log_a)
--
-- Note: dead cycles assert RDY so should instead repeat at wait_setup for a new
-- CPU cycle
-- 
-- DEADLOCKS
-- =========
-- As we can both produce and consume requests we must ensure against deadlocks
-- and either be a higher priority controller than all other controllers, or 
-- ensure that we process all incoming requests before asserting an outgoing
-- request.
--
-- We can't really tune this out using the normal fb_intcon_shared priority 
-- mechanisms as we could still get a condition where the requester is asserted
-- just prior to the 816 starting a cycle, so we must instead ensure that we
-- process all outstanding incoming requests (on fb_mem_c2p_i) before starting
-- any outgoing request (out of fb_cpu_c2p_o)
--
----------------------------------------------------------------------------------



library ieee;
use ieee.std_logic_1164.all;
use ieee.numeric_std.all;
use ieee.math_real.all;

library work;
use work.fishbone.all;
use work.common.all;
use work.board_config_pack.all;
use work.fb_sys_pack.all;

entity fb_C20K_mem_cpu_65816 is
   generic (
      G_NMI_META_LEVELS             : natural := 5;
      SIM                           : boolean := false;                    -- skip some stuff, i.e. slow sdram start up
      CLOCKSPEED                    : natural;                             -- fast clock speed in Hz
      CPU_SPEED                     : natural                              -- cpu speed in Hz must divide into CLOCKSPEED by an exact integer                
   );
   port(

      -- configuration
      cfg_cpu_use_t65_i                : in std_logic;   -- '1': the T65 is in use, hold the 65816 in reset

      -- direct CPU control signals from system
      nmi_n_i                          : in  std_logic;
      irq_n_i                          : in  std_logic;

      -- debug button (NoIce / DeIce)
      debug_btn_n_i                    : in  std_logic;

      -- fishbone signals
      fb_syscon_i                      : in  fb_syscon_t;

      -- fishbone cpu controller to rest of system
      fb_cpu_c2p_o                     : out fb_con_o_per_i_t;
      fb_cpu_p2c_i                     : in  fb_con_i_per_o_t;
      fb_cpu_c2p_instr_fetch_o         : out std_logic;

      -- fishbone memory peripheral from other bus controller
      fb_mem_c2p_i                     : in  fb_con_o_per_i_t;
      fb_mem_p2c_o                     : out fb_con_i_per_o_t;

      -- chipset control signals
      chipset_cpu_halt_i               : in  std_logic;
      chipset_cpu_int_i                : in  std_logic;

      -- config signals
      cfg_swram_enable_i            : in std_logic;
      cfg_map0n1_i                  : in std_logic;
      cfg_mosram_i                  : in std_logic;
      cfg_sys_type_i                : in sys_type;

      -- CPU address control signals from other components
      sys_ROMPG_i                   : in  std_logic_vector(7 downto 0);
      JIM_page_i                    : in  std_logic_vector(15 downto 0);
      turbo_lo_mask_i               : in  std_logic_vector(7 downto 0);

      rom_throttle_map_i            : in  std_logic_vector(15 downto 0);

      rom_autohazel_map_i           : in  std_logic_vector(15 downto 0);
      throttle_all_i                : in  std_logic;
      throttle_mos_i                : in  std_logic;
      cpu_2MHz_phi2_clken_i         : in  std_logic;

      boot_65816_i                  : in  std_logic_vector(1 downto 0);
      -- boot settings:
      -- 10    logical page FF maps to logical page 00, any change takes 2 instructions to complete to allow jump
      -- 00    pages map direct, any change takes 2 instructions to complete to allow jump
      -- 01    logical page FF maps to 00 in Emu mode, direct map otherwise, immediate change on emu switch
      -- 11    logical page FF maps to 00 in Emu mode, direct map otherwise, immediate change on emu switch ignore Throttle in native mode

      -- when active set a "window" from logical address space 00/FF E000-F000
      -- resets to point at MOS rom at boot time
      window_65816_i                : in  std_logic_vector(12 downto 0);
      window_65816_wr_en_i          : in  std_logic;

      -- memctl signals in
      jim_en_i                      : in  std_logic;     -- local jim override
      swmos_shadow_i                : in  std_logic;     -- shadow mos from SWRAM slot #8

      -- noice debugger signals to cpu
      noice_debug_shadow_i          : in std_logic;      -- debugger memory MOS map is active (overrides shadow_mos)

      -- memory motherboard signals

      MEM_A_io                         : inout  std_logic_vector(20 downto 0);
      MEM_D_io                         : inout  std_logic_vector(7 downto 0);

      MEM_RAM_nCE_o                    : out    std_logic_vector(3 downto 0); -- 0 is BB RAM
      MEM_ROM_nCE_o                    : out    std_logic;                    -- Flash EEPROM select
      MEM_nOE_o                        : out    std_logic;
      MEM_nWE_o                        : out    std_logic;

      -- cpu motherboard signals
      CPU_A_nOE_o                      : out    std_logic;

      CPU_PHI2_o                       : out    std_logic;
      CPU_BE_o                         : out    std_logic;
      CPU_RDY_io                       : inout  std_logic;

      CPU_nRES_o                       : out    std_logic;
      CPU_nIRQ_o                       : out    std_logic;
      CPU_nNMI_o                       : out    std_logic;
      CPU_nABORT_o                     : out    std_logic;

      CPU_MX_i                         : in     std_logic;
      CPU_E_i                          : in     std_logic;

      debug_cpu_state_o                : out    std_logic_vector(2 downto 0);
      debug_throttle_act_o             : out    std_logic;

      -- preboot
      preboot_i                        : in     std_logic


   );
end fb_C20K_mem_cpu_65816;

architecture rtl of fb_C20K_mem_cpu_65816 is

   function cdiv(dividend:time; divisor:time) return integer is
   begin
      return integer(ceil(real(1000 * dividend / divisor) / 1000.0));

   end cdiv;

   constant C_CLOCK_PER    : time      := 1000000 us / CLOCKSPEED;

   constant T_ADS          : time      := 40000 ps;
   constant T_DHR          : time      := 10000 ps;
   constant T_DSR          : time      := 10000 ps;
   constant T_PCS          : time      := 15000 ps;
   constant T_MDS          : time      := 30000 ps;

   -- constants for cpu clock division events
   constant C_DIV_TOTAL          : integer   := CLOCKSPEED / CPU_SPEED;
   constant C_CPU_DIV_PHI1       : integer   := 0;
   constant C_CPU_DIV_PHI2       : integer   := C_DIV_TOTAL / 2;
   constant C_CPU_DIV_ADS        : integer   := cdiv(T_ADS , C_CLOCK_PER);
   constant C_CPU_DIV_PHI1_DHR   : integer   := cdiv(T_DHR , C_CLOCK_PER);
   constant C_CPU_DIV_PHI2_DHR   : integer   := C_CPU_DIV_PHI2 + cdiv(T_DHR , C_CLOCK_PER);
   constant C_CPU_DIV_MDS        : integer   := C_CPU_DIV_PHI2 + cdiv(T_MDS, C_CLOCK_PER);
   constant C_CPU_DIV_PHI2_DSR   : integer   := C_DIV_TOTAL - maximum(cdiv(T_DSR, C_CLOCK_PER), cdiv(T_PCS , C_CLOCK_PER));

   constant C_CPU_DIV_END_MEM    : integer   := 2;

   -- ring position, wrapped
   function cw(index:integer) return integer is
   begin
      return index mod C_DIV_TOTAL;
   end function;

   -- fb_mem accept window: a request is only accepted at ring positions
   -- 0..C_MEM_ACC_LAST. An access accepted at E has nCE/address out at E+2
   -- (mem2) and finishes at the next END_MEM - 1 point (16 + END_MEM - 1), so
   -- the last accept edge giving at least 7 clocks (54.7 ns) of nCE to sample
   -- is 8. The normal accepts (cpu_log_a, cpu_skip: 7; cpu_phys_a: 8) are
   -- always in it. A later accept (only possible from cpu_read_fb /
   -- cpu_write_fb, while the CPU's own A_stb waits) used to finish at that
   -- END_MEM - 1 point however soon it came (as little as 2 clocks, with a
   -- WE pulse down to 7.8 ns); it now waits for the window.
   constant C_MEM_ACC_LAST       : integer   := C_DIV_TOTAL + C_CPU_DIV_END_MEM - 1 - 2 - 7;

   signal r_nmi            : std_logic;
   signal r_nmi_meta       : std_logic_vector(G_NMI_META_LEVELS-1 downto 0);

   signal r_cpu_div_ring   : std_logic_vector(C_DIV_TOTAL - 1 downto 0) := (C_DIV_TOTAL - 2 => '1', others => '0');
   signal r_cpu_phi        : std_logic := '0';
   signal r_cpu_phi_DHR    : std_logic := '1';

   signal i_ring_next      : std_logic_vector(C_DIV_TOTAL-1 downto 0);
   signal r_cpu_n_reset    : std_logic_vector(3 downto 0) := (others => '0');

   type t_state is (
      reset,            -- coming out of reset
      wait_asetup,      -- wait for previous cycle to release and address / bank to be ready
      cpu_log_a,        -- act on phys a from log2phys
      cpu_phys_a,       -- act on phys a from log2phys
      cpu_read_fb,      -- a fishbone read cycle is in progress, wait for fb ack
      cpu_write_fb,     -- a fishbone write cycle is in progress, wait for fb ack,
      cpu_read_local,   -- a local memory access, A(20..8) modified to phys A
      cpu_write_local,  -- a local write access, A(20..8) modified to phys A
      cpu_dead,         -- VPA and VDA both null, assert ready and wait for another cycle
      cpu_skip,         -- cpu is being throttled, suppress phi2
      mem1,             -- memory access from fb slave port - BE settle
      mem2,             -- memory access from fb slave port - ???
      mem3,             -- memory access from fb slave port - ???
      mem4,             -- memory access from fb slave port - ???
      mem5              -- fb slave access done: wait for ADS, back to cpu_log_a (the bank isn't sent again)
      );

   signal r_state          : t_state := reset;
   signal r_cpu_RnW        : std_logic;
   signal r_A              : std_logic_vector(23 downto 0);
   signal r_A_stb          : std_logic;
   signal i_phys_A         : std_logic_vector(23 downto 0);
   signal r_phys_A         : std_logic_vector(23 downto 0);

   signal r_VPA            : std_logic;
   signal r_VDA            : std_logic;
   signal r_MLB            : std_logic;
   signal r_VPB            : std_logic;

   signal r_had_fb_ack     : std_logic;
   signal r_fb_D_rd        : std_logic_vector(7 downto 0);
   signal r_D_wr_local     : std_logic_vector(7 downto 0);

   signal i_peripheral_sel_oh : std_logic_vector(PERIPHERAL_COUNT-1 downto 0);
   signal r_peripheral_sel_oh : std_logic_vector(PERIPHERAL_COUNT-1 downto 0);


   signal r_debug_abort_n_ack    : std_logic;

   signal r_boot_65816_dly : std_logic_vector(2 downto 0) := (others => '1');
   signal i_boot           : std_logic;

   signal r_cyc_2M_before  : std_logic;         -- a phi2 was detected this cycle, next will be valid for throttled cycles
   signal r_cyc_2M         : std_logic;         -- qualifies a cpu cycle as being the first after phi2 ended

   signal i_throttle_act   : std_logic;   

   signal r_mem_RnW        : std_logic;

   -- memory data bus drive: data and output enable registers; MEM_D_io is
   -- driven from these outside the clocked process, so the pin is only read,
   -- never held through its own input (see revision notes, bidirectional pins)
   signal r_MEM_D_o        : std_logic_vector(7 downto 0);
   signal r_MEM_D_nOE      : std_logic;
   signal r_mem_D_WR       : std_logic_vector(7 downto 0);

   -- memory address lines drive
   signal r_MEM_A_o        : std_logic_vector(20 downto 0);
   signal r_MEM_A_20_8_nOE : std_logic;
   signal r_MEM_A_7_0_nOE  : std_logic;


   -- fishbone memory peripheral port (chipset controllers -> shared memory)
   signal r_mem_A_ack      : std_logic;                     -- A_ack for an accepted fb_mem request
   signal r_mem_D_ack      : std_logic;                     -- D_ack (and rdy) for it
   signal r_mem_had_d_stb  : std_logic;                     -- write data has arrived for the accepted write
   signal r_mem_abort      : std_logic;                     -- the controller dropped cyc during the access
   signal r_mem_done       : std_logic;                     -- memory access finished (D_ack given or aborted)
   signal r_mem_A          : std_logic_vector(23 downto 0); -- fb_mem address, followed while not in mem1..mem4

   signal r_CPU_RDY        : std_logic;
   signal r_MEM_RDY        : std_logic;                     -- '0': fb_mem access waits an extra ring (slow memory)
   signal r_mem_win        : std_logic;                     -- '1' in the clock before an accept edge in the window

   signal i_throttle_all_E : std_logic;

begin

   i_throttle_all_E <= '0' when CPU_E_i = '0' and boot_65816_i = "11" else
                     throttle_all_i;

   debug_throttle_act_o <= i_throttle_act;

   assert CLOCKSPEED > CPU_SPEED report "CLOCKSPEED must be greater than CPU_SPEED" severity error;
   assert CLOCKSPEED mod CPU_SPEED = 0 report "CLOCKSPEED must be an integer multiple of CPU_SPEED" severity error;


   CPU_RDY_io <= r_CPU_RDY;


   p_det_2m:process(fb_syscon_i)
   begin
      if fb_syscon_i.rst = '1' then
         r_cyc_2M <= '0';
         r_cyc_2M_before <= '0';
      elsif rising_edge(fb_syscon_i.clk) then
         if i_ring_next(C_CPU_DIV_PHI1_DHR) = '1' then
            r_cyc_2M <= r_cyc_2M_before;
            r_cyc_2M_before <= cpu_2MHz_phi2_clken_i;
         else
            r_cyc_2M_before <= r_cyc_2M_before or cpu_2MHz_phi2_clken_i;
         end if;
      end if;
   end process;

   -- ================================================================================================ --
   -- NMI registration - kept from Blitter, might be unnecessary
   -- ================================================================================================ --

   -- nmi was unreliable when testing DFS/ADFS, try de-gltiching
   p_nmi_meta:process(fb_syscon_i)
   begin
      if fb_syscon_i.rst = '1' then
         r_nmi_meta <= (others => '1');
         r_nmi <= '1';
      elsif rising_edge(fb_syscon_i.clk) then
         r_nmi_meta <= nmi_n_i & r_nmi_meta(G_NMI_META_LEVELS-1 downto 1);
         if my_or_reduce(r_nmi_meta) = '0' then
            r_nmi <= '0';
         elsif my_and_reduce(r_nmi_meta) = '1' then
            r_nmi <= '1';
         end if;
      end if;
   end process;

   -- ================================================================================================ --
   -- CPU phi clock generation
   -- ================================================================================================ --
   
   p_cpu_phi:process(fb_syscon_i)
   variable v_p_rst : std_logic;
   begin
--      if fb_syscon_i.rst = '1' then
--         r_cpu_div_ring <= (0 => '1', others => '0');
--         r_cpu_phi <= '0';
--         r_cpu_phi_DHR <= '1';
--      els
      if rising_edge(fb_syscon_i.clk) then

         if fb_syscon_i.rst = '1' and v_p_rst = '0' then
            r_cpu_div_ring   <= (C_DIV_TOTAL - 2 => '1', others => '0');
         else
            if i_ring_next(C_CPU_DIV_PHI1) = '1' then
               r_cpu_phi <= '0';
            end if;

            if i_ring_next(C_CPU_DIV_PHI2) = '1' and r_state /= cpu_skip then
               r_cpu_phi <= '1';
            end if;

            if i_ring_next(C_CPU_DIV_PHI1_DHR) = '1' and r_state = wait_asetup then
               r_cpu_phi_DHR <= '0';
            end if;

            if i_ring_next(C_CPU_DIV_PHI2_DHR) = '1' then
               r_cpu_phi_DHR <= '1';
            end if;

            r_cpu_div_ring <= i_ring_next;         
         end if;

         v_p_rst := fb_syscon_i.rst;
      end if;
   end process;

   i_ring_next <= r_cpu_div_ring(r_cpu_div_ring'high - 1 downto 0) & r_cpu_div_ring(r_cpu_div_ring'high);

   -- ================================================================================================ --
   -- CPU reset
   -- ================================================================================================ --

   p_cpu_reset:process(fb_syscon_i)
   begin
      if fb_syscon_i.rst = '1' then
         r_cpu_n_reset <= (others => '0');         
      else
         if rising_edge(fb_syscon_i.clk) then
            if cfg_cpu_use_t65_i = '1' then
               r_cpu_n_reset <= (others => '0');
            elsif i_ring_next(C_CPU_DIV_PHI2) = '1' then
               r_cpu_n_reset <= "1" & r_cpu_n_reset(r_cpu_n_reset'high downto 1);
            end if;
         end if;
      end if;

   end process;

   -- ================================================================================================ --
   -- Local log2phys
   -- ================================================================================================ --

   e_log2phys:entity work.log2phys
   generic map (
      SIM                           => SIM,
      G_MK3                         => false,
      G_C20K                        => true
   )
   port map (
      fb_syscon_i                   => fb_syscon_i,
      cfg_swram_enable_i            => cfg_swram_enable_i,
      cfg_map0n1_i                  => cfg_map0n1_i,
      cfg_mosram_i                  => cfg_mosram_i,
      cfg_sys_via_block_i           => '1',
      cfg_sys_type_i                => cfg_sys_type_i,
      sys_ROMPG_i                   => sys_ROMPG_i,
      JIM_page_i                    => JIM_page_i,
      turbo_lo_mask_i               => turbo_lo_mask_i,
      throttle_mos_i                => throttle_mos_i,
      throttle_all_i                => i_throttle_all_E,
      rom_throttle_map_i            => rom_throttle_map_i,
      throttle_act_o                => i_throttle_act,
      cpu_2MHz_phi2_clken_i         => cpu_2MHz_phi2_clken_i,
      rom_autohazel_map_i           => rom_autohazel_map_i,
      window_65816_i                => window_65816_i,
      window_65816_wr_en_i          => window_65816_wr_en_i,
      jim_en_i                      => jim_en_i,
      swmos_shadow_i                => swmos_shadow_i,
      noice_debug_shadow_i          => noice_debug_shadow_i,
      A_i                           => r_A,
      A_stb_i                       => r_A_stb,
      instruction_fetch_i           => r_VPA and r_VDA,
      A_o                           => i_phys_A,
      preboot_i                     => preboot_i

   );

   e_ad_local:entity work.address_decode
   generic map (
      G_C20K                  => true,
      G_HDMI_SHADOW_SYS       => G_HDMI_SHADOW_SYS
   )
   port map (
      addr_i                  => i_phys_A,
      we_i                    => not r_cpu_RnW,
      peripheral_sel_o        => open,
      peripheral_sel_oh_o     => i_peripheral_sel_oh
   );

   -- ================================================================================================ --
   -- CPU cycle state machine
   -- ================================================================================================ --

   MEM_D_io <= r_MEM_D_o when r_MEM_D_nOE = '0' else (others => 'Z');
   MEM_A_io(20 downto 8) <= r_MEM_A_o(20 downto 8) when r_MEM_A_20_8_nOE = '0' else (others => 'Z');
   MEM_A_io(7 downto 0) <= r_MEM_A_o(7 downto 0) when r_MEM_A_7_0_nOE = '0' else (others => 'Z');

   p_state:process(fb_syscon_i)

      procedure mem_unsel is
      begin
         r_MEM_A_7_0_nOE <= '1';
         r_MEM_A_20_8_nOE <= '1';

         r_MEM_D_nOE <= '1';

         MEM_RAM_nCE_o <= (others => '1');
         MEM_ROM_nCE_o <= '1';
         MEM_nOE_o <= '1';
         MEM_nWE_o <= '1';
      end mem_unsel;


      procedure mem_sel(A : std_logic_vector(23 downto 0)) is
      begin
         mem_unsel;

         r_MEM_A_20_8_nOE <= '0';
         r_MEM_A_o(20 downto 8) <= A(20 downto 8);

         if A(23) = '1' then
            MEM_ROM_nCE_o <= '0';
         elsif A(22 downto 21) = "11" then
            MEM_RAM_nCE_o(0) <= '0';
         else
            MEM_RAM_nCE_o(to_integer(unsigned(A(22 downto 21)))+1) <= '0';
         end if;

      end mem_sel;

      procedure cpu_rdy is
      begin

         if r_phys_A(23) = '1' then
            r_CPU_RDY <= '1'; -- slow for 55ns rom
         elsif r_phys_A(22 downto 21) = "11" then
            r_CPU_RDY <= '1';
         else
            r_CPU_RDY <= '1';
         end if;
      end cpu_rdy;

      -- as cpu_rdy, for fb_mem accesses: '0' makes the access wait an extra
      -- ring (CPU cycle)
      procedure mem_rdy is
      begin
         if r_mem_A(23) = '1' then
            r_MEM_RDY <= '0'; -- '0' for slow (55ns) rom
         else
            r_MEM_RDY <= '1';
         end if;
      end mem_rdy;

   variable v_mem_accept : boolean;    -- a fb_mem request was accepted (state -> mem1) this clock
   begin
      if fb_syscon_i.rst = '1' then
         r_state      <= reset;
         r_had_fb_ack <= '0';
         r_fb_D_rd       <= (others => '0');

         fb_cpu_c2p_o <= fb_c2p_unsel;
         fb_cpu_c2p_instr_fetch_o <= '0';

         CPU_A_nOE_o <= '0';
         r_CPU_RDY <= '1';
         r_MEM_RDY <= '1';
         mem_unsel;
         r_A <= (others => '0');
         r_A_stb <= '0';
         CPU_BE_o <= '1';
         r_mem_D_WR <= (others => '1');
         r_MEM_D_o <= (others => '1');
         r_MEM_D_nOE <= '0';

         r_mem_A_ack <= '0';
         r_mem_D_ack <= '0';
         r_mem_had_d_stb <= '0';
         r_mem_abort <= '0';
         r_mem_done <= '0';

      else
         if rising_edge(fb_syscon_i.clk) then

            v_mem_accept := false;

            r_A_stb <= '0';
            r_mem_A_ack <= '0';
            r_mem_D_ack <= '0';

            case r_state is
               when reset =>
                  CPU_BE_o <= '1';
                  fb_cpu_c2p_o <= fb_c2p_unsel;
                  fb_cpu_c2p_instr_fetch_o <= '0';
                  if i_ring_next(C_CPU_DIV_PHI2) = '1' then
                     r_state <= wait_asetup;
                  end if;
                  r_MEM_D_o <= (others => '1');
                  r_MEM_D_nOE <= '0';
               when wait_asetup =>

                  r_CPU_RDY <= '0';
                  CPU_BE_o <= '1';
                  fb_cpu_c2p_o <= fb_c2p_unsel;
                  if i_ring_next(C_CPU_DIV_ADS) = '0' and i_ring_next(C_CPU_DIV_ADS + 1) = '0' then
                     CPU_A_nOE_o <= '0';
                  else
                     CPU_A_nOE_o <= '1';
                  end if;
                  mem_unsel;

                  if i_ring_next(C_CPU_DIV_ADS) = '1' then
                     r_A_stb <= '1';
                     if i_boot = '1' then
                        if MEM_D_io = x"00" then
                           if MEM_A_io(20) = '0' and unsigned(MEM_A_io(4 downto 0)) <= 16#19# then
                              -- vector pull in Native mode or "new" ABORT/COP
                              -- get from 008Fxx
                              r_A <= x"008F" & MEM_A_io(7 downto 0);
                           else
                              -- bank 0 maps to FF in boot mode
                              r_A <= x"FF" & MEM_A_io(15 downto 0);
                           end if;
                        else
                           -- not bank 0 map direct
                           r_A <= MEM_D_io & MEM_A_io(15 downto 0);
                        end if;
                     else
                        -- not boot mode map direct
                        r_A <= MEM_D_io & MEM_A_io(15 downto 0);
                     end if;

                     r_VPA <= MEM_A_io(16);
                     r_VDA <= MEM_A_io(17);
                     r_MLB <= MEM_A_io(18);
                     r_cpu_RnW <= MEM_A_io(19);
                     r_VPB <= MEM_A_io(20);
                     r_state <= cpu_log_a;

                  end if;                  



               when cpu_log_a =>
                  CPU_BE_o <= '1';
                  r_phys_A <= i_phys_A;
                  r_peripheral_sel_oh <= i_peripheral_sel_oh;
                  if fb_mem_c2p_i.A_stb = '1' and fb_mem_c2p_i.cyc = '1' then
                     r_mem_RnW <= not fb_mem_c2p_i.we;
                     v_mem_accept := true;
                     CPU_BE_o <= '0';
                     CPU_A_nOE_o <= '1';
                     r_state <= mem1;
                  else
                     if cfg_cpu_use_t65_i = '1' then
                        r_state <= cpu_dead;
                     elsif (r_cyc_2M = '0' and i_throttle_act = '1') or chipset_cpu_halt_i = '1' then
                        r_state <= cpu_skip;
                     elsif r_VPA = '0' and r_VDA = '0' then
                        r_state <= cpu_dead;
                     else
                        r_state <= cpu_phys_a;

                     end if;
                  end if;
               when cpu_phys_a =>
                  if fb_mem_c2p_i.A_stb = '1' and fb_mem_c2p_i.cyc = '1' then
                     r_mem_RnW <= not fb_mem_c2p_i.we;
                     v_mem_accept := true;
                     CPU_BE_o <= '0';
                     CPU_A_nOE_o <= '1';
                     r_state <= mem1;
                  elsif r_peripheral_sel_oh(PERIPHERAL_NO_CHIPRAM) = '1' then
                     mem_sel(r_phys_A);
                     cpu_rdy;
                     -- local memory cycle
                     if r_cpu_RnW = '1' then
                        r_state <= cpu_read_local;
                     else
                        r_state <= cpu_write_local;
                     end if;
                  else
                     -- not local memory start a fishbone cycle
                     fb_cpu_c2p_o.cyc <= '1';
                     fb_cpu_c2p_o.A <= r_phys_A;
                     fb_cpu_c2p_o.A_stb <= '1';      
                     fb_cpu_c2p_instr_fetch_o <= r_VPA and R_VDA;               
                     r_had_fb_ack <= '0';
                     if r_cpu_RnW = '1' then
                        r_state <= cpu_read_fb;
                     else
                        fb_cpu_c2p_o.we <= '1';
                        r_state <= cpu_write_fb;
                     end if;
                  end if;

               when cpu_read_fb =>
                  if fb_cpu_c2p_o.A_stb = '1' then
                     if fb_cpu_p2c_i.A_ack = '1' then
                        fb_cpu_c2p_o.A_stb <= '0';                     
                     elsif fb_mem_c2p_i.A_stb = '1' and fb_mem_c2p_i.cyc = '1' and r_mem_win = '1' then
                        -- not yet accepted: abort our cycle (A_stb and cyc
                        -- down) and serve the fb_mem request first, so a chipset
                        -- controller holding the intcon can't deadlock us;
                        -- cpu_log_a restarts the cycle afterwards
                        fb_cpu_c2p_o.cyc <= '0';
                        fb_cpu_c2p_o.A_stb <= '0';

                        r_mem_RnW <= not fb_mem_c2p_i.we;
                        v_mem_accept := true;
                        CPU_BE_o <= '0';
                        CPU_A_nOE_o <= '1';
                        r_state <= mem1;
                     end if;
                  end if;
                     
                  if r_cpu_phi_DHR = '1' then
                     r_MEM_D_o <= r_fb_D_rd;
                     r_MEM_D_nOE <= '0';
                  end if;

                  -- read data goes to MEM_D_io from r_fb_D_rd (above) a clock
                  -- after D_ack. RDY is only raised at the DSR point once
                  -- r_had_fb_ack is set, by which time r_fb_D_rd is on the bus,
                  -- so driving D_rd straight from the return path gained nothing
                  -- (and was a failing path into the MEM_D_io I/O registers)
                  if fb_cpu_p2c_i.D_ack = '1' then
                     r_fb_D_rd <= fb_cpu_p2c_i.D_rd;
                     r_had_fb_ack <= '1';
                     fb_cpu_c2p_o.cyc <= '0';
                  end if;

                  if i_ring_next(C_CPU_DIV_PHI2_DSR) = '1' and r_had_fb_ack = '1' then
                     r_CPU_RDY <= '1';
                  end if;

                  if r_CPU_RDY = '1' and i_ring_next(C_CPU_DIV_PHI1_DHR) = '1' then
                     r_state <= wait_asetup;
                  end if;

               when cpu_write_fb =>
                  if fb_cpu_c2p_o.A_stb = '1' then
                     if fb_cpu_p2c_i.A_ack = '1' then
                        fb_cpu_c2p_o.A_stb <= '0';
                     elsif fb_mem_c2p_i.A_stb = '1' and fb_mem_c2p_i.cyc = '1' and r_mem_win = '1' then
                        -- not yet accepted: abort and serve fb_mem (as cpu_read_fb)
                        fb_cpu_c2p_o.cyc <= '0';
                        fb_cpu_c2p_o.A_stb <= '0';

                        r_mem_RnW <= not fb_mem_c2p_i.we;
                        v_mem_accept := true;
                        CPU_BE_o <= '0';
                        CPU_A_nOE_o <= '1';
                        r_state <= mem1;
                     end if;
                  end if;

                  if fb_cpu_p2c_i.D_ack = '1' then
                     r_had_fb_ack <= '1';
                     fb_cpu_c2p_o.cyc <= '0';
                  end if;

                  if i_ring_next(C_CPU_DIV_MDS + 1) = '1' then  -- TODO:BODGED: else model-c-mos font corrupted when LA attached!
                     fb_cpu_c2p_o.D_wr <= MEM_D_io;
                     fb_cpu_c2p_o.D_wr_stb <= '1';
                  end if;

                  if i_ring_next(C_CPU_DIV_PHI2_DSR) = '1' and r_had_fb_ack = '1' then
                     r_CPU_RDY <= '1';
                  end if;

                  if r_CPU_RDY = '1' and i_ring_next(C_CPU_DIV_PHI1_DHR) = '1' then
                     r_state <= wait_asetup;
                  end if;
               when cpu_read_local|cpu_write_local =>
                  MEM_nWE_o <= r_cpu_RnW;
                  if i_ring_next(C_CPU_DIV_PHI2_DHR) = '1' then
                     MEM_nOE_o <= not r_cpu_RnW;
                  end if;

                  if r_CPU_RDY = '1' then   -- memsel will have set this to 0 for slow (4MHz) accesses
                     if i_ring_next(C_CPU_DIV_PHI1_DHR - 1) = '1' then
                        MEM_nWE_o <= '1';
                     elsif i_ring_next(C_CPU_DIV_PHI1_DHR) = '1' then
                        r_state <= wait_asetup;
                        CPU_A_nOE_o <= '0';
                        mem_unsel;
                     end if;
                  else
                     if i_ring_next(C_CPU_DIV_PHI1_DHR) = '1' then
                        r_CPU_RDY <= '1';
                     end if;
                  end if;
               when cpu_dead =>
                  r_CPU_RDY <= '1';
                  if cfg_cpu_use_t65_i = '1' then
                     -- T65 in use, the 65816 is held in reset: stay here and serve
                     -- fb_mem requests (one per ring) instead of going round
                     -- wait_asetup / cpu_log_a, which only accepts at position 7.
                     -- The 65816 is kept off the bus (BE low) the whole time, so an
                     -- access needs no BE settle clock: straight to mem2. That puts
                     -- nCE out a clock sooner, so the window also takes position 9
                     -- (see p_mem_win); the T65's next request after a D_ack at
                     -- position 1 arrives at 9 (fishbone-roundtrip trace, 20 Oct).
                     CPU_BE_o <= '0';
                     CPU_A_nOE_o <= '1';
                     if fb_mem_c2p_i.A_stb = '1' and fb_mem_c2p_i.cyc = '1' and r_mem_win = '1' then
                        r_mem_RnW <= not fb_mem_c2p_i.we;
                        v_mem_accept := true;
                        r_CPU_RDY <= '0';
                        r_state <= mem2;
                     end if;
                  elsif i_ring_next(0) = '1' then
                     r_state <= wait_asetup;
                  end if;
               when cpu_skip =>

                  if i_ring_next(C_CPU_DIV_ADS + 1) = '1' then
                     if fb_mem_c2p_i.A_stb = '1' and fb_mem_c2p_i.cyc = '1' then
                        r_mem_RnW <= not fb_mem_c2p_i.we;
                        v_mem_accept := true;
                        CPU_BE_o <= '0';
                        CPU_A_nOE_o <= '1';
                        r_state <= mem1;                        
                     elsif (r_cyc_2M = '0' and i_throttle_act = '1') or chipset_cpu_halt_i = '1' then
                        r_state <= cpu_skip;                     
                     else
                        r_state <= cpu_phys_a;
                     end if;
                  end if;

               when mem1 =>
                  -- time for BE to take effect; the fb_mem address was captured
                  -- in r_mem_A (p_mem_A) when the request was accepted
                  -- T65 mode can skip this state (BE is already low)
                  r_CPU_RDY <= '0';
                  r_state <= mem2;
               when mem2 =>
                  mem_sel(r_mem_A);
                  mem_rdy;

                  r_mem_A_o(7 downto 0) <= r_mem_A(7 downto 0);
                  r_MEM_A_7_0_nOE <= '0';

                  r_state <= mem3;
               when mem3 =>
                  MEM_nWE_o <= r_mem_RnW;
                  -- reads only: OE low during a write inhibits it on many flash parts
                  MEM_nOE_o <= not r_mem_RnW;
                  r_state <= mem4;
               when mem4 =>

                  if r_cpu_phi_DHR = '1' and r_mem_RnW = '0' then
                     r_MEM_D_o <= r_mem_D_WR;
                     r_MEM_D_nOE <= '0';
                  end if;

                  -- r_mem_had_d_stb: for a write, the data has arrived (r_mem_D_WR
                  -- is driven onto MEM_D_io above while nWE is low, so data that
                  -- arrives any time before nWE rises is written). If it hasn't
                  -- arrived by END_MEM - 1, stay here (cpu still held, BE low) and
                  -- finish at the next END_MEM - 1 instead of acknowledging a
                  -- write we haven't got. An aborted request finishes as normal
                  -- but without D_ack.
                  -- r_MEM_RDY = '0' (slow memory, see mem_rdy): let one END_MEM - 1
                  -- point go by first
                  if r_MEM_RDY = '0' then
                     if i_ring_next(cw(C_CPU_DIV_END_MEM + 1)) = '1' then
                        r_MEM_RDY <= '1';
                     end if;
                  elsif i_ring_next(cw(C_CPU_DIV_END_MEM - 1)) = '1' and
                     (r_mem_RnW = '1' or r_mem_had_d_stb = '1' or r_mem_abort = '1') then
                     if r_mem_abort = '0' and fb_mem_c2p_i.cyc = '1' then
                        r_mem_D_ack <= '1';
                     end if;
                     MEM_nWE_o <= '1';
                     fb_mem_p2c_o.D_rd <= MEM_D_io;
                     r_mem_done <= '1';
                  elsif i_ring_next(cw(C_CPU_DIV_END_MEM)) = '1' and r_mem_done = '1' then
                     mem_unsel;
                     -- note we need to release nOE a cycle late for 10ns memory or we get
                     -- spurious reads.
                     MEM_nOE_o <= '1';  

                     r_MEM_A_7_0_nOE <= '1';

                     r_state <= mem5;
                  end if;
               when mem5 =>
                  -- back to cpu_log_a, not wait_asetup: the CPU doesn't send the
                  -- bank address again for the cycle we took over (see BANK ADDRESS)
                  if cfg_cpu_use_t65_i = '1' then
                     r_state <= cpu_dead;    -- T65 in use: wait for the next fb_mem request
                  elsif i_ring_next(C_CPU_DIV_ADS) = '1' then
                     r_state <= cpu_log_a;
                  end if;
               when others =>
                  r_state <= reset;
            end case;

            -- fishbone memory peripheral port bookkeeping
            if v_mem_accept then
               -- A_ack the request we have just taken (registered, once)
               r_mem_A_ack <= '1';
               r_mem_had_d_stb <= '0';
               r_mem_abort <= '0';
               r_mem_done <= '0';
               -- write data may come with A_stb
               if fb_mem_c2p_i.we = '1' and fb_mem_c2p_i.D_wr_stb = '1' then
                  r_mem_D_WR <= fb_mem_c2p_i.D_wr;
                  r_mem_had_d_stb <= '1';
               end if;
            elsif r_state = mem1 or r_state = mem2 or r_state = mem3 or r_state = mem4 then
               -- take D_wr_stb only for our accepted write still waiting for
               -- data (D_wr_stb is broadcast to every peripheral)
               if r_mem_RnW = '0' and r_mem_had_d_stb = '0' and r_mem_abort = '0' and r_mem_done = '0'
                     and fb_mem_c2p_i.cyc = '1' and fb_mem_c2p_i.D_wr_stb = '1' then
                  r_mem_D_WR <= fb_mem_c2p_i.D_wr;
                  r_mem_had_d_stb <= '1';
               end if;
               -- an abort (cyc dropped) finishes the access without D_ack
               if fb_mem_c2p_i.cyc = '0' and r_mem_done = '0' then
                  r_mem_abort <= '1';
               end if;
            end if;

         end if;
      end if;
      
   end process;

   fb_mem_p2c_o.A_ack   <= r_mem_A_ack;
   fb_mem_p2c_o.D_ack   <= r_mem_D_ack;
   fb_mem_p2c_o.rdy     <= r_mem_D_ack;

   -- fb_mem accept window (see C_MEM_ACC_LAST), registered a clock ahead: in
   -- the clock before ring position E, i_ring_next(E-1) was '1' at the edge
   -- In T65 mode accepts go straight to mem2 (nCE a clock sooner), so the
   -- window is one position longer.
   p_mem_win:process(fb_syscon_i)
   begin
      if rising_edge(fb_syscon_i.clk) then
         r_mem_win <= '0';
         for i in 0 to C_MEM_ACC_LAST + 1 loop
            if i_ring_next(cw(i - 1)) = '1' and (i <= C_MEM_ACC_LAST or cfg_cpu_use_t65_i = '1') then
--            if i_ring_next(cw(i - 1)) = '1' and (i <= C_MEM_ACC_LAST) then
               r_mem_win <= '1';
            end if;
         end loop;
      end if;
   end process;

   -- address capture for the fishbone memory port: follows the request while
   -- not serving one, so the address register's enable doesn't depend on
   -- A_stb (accept is in several states); used by mem2 directly 
   p_mem_A:process(fb_syscon_i)
   begin
      if rising_edge(fb_syscon_i.clk) then
         if r_state /= mem1 and r_state /= mem2 and r_state /= mem3 and r_state /= mem4 then
            r_mem_A <= fb_mem_c2p_i.A;
         end if;
      end if;
   end process;

   -- ================================================================================================ --
   -- WDM / ABORT detect
   -- ================================================================================================ --

   p_wdm:process(fb_syscon_i)
   begin
      if fb_syscon_i.rst = '1' then
         CPU_nABORT_o <= '1';
         r_debug_abort_n_ack <= '1';
      elsif rising_edge(fb_syscon_i.clk) then
         if i_ring_next(0) = '1' and r_CPU_RDY = '1' and r_state /= cpu_skip then
            if debug_btn_n_i = '1' then
               r_debug_abort_n_ack <= '1';
            end if;

            --TODO: add baulk to defend against button + WDM coinciding

            if MEM_D_io = x"42" and r_VDA = '1' and r_VPA = '1' then
               CPU_nABORT_o <= '0';
            elsif debug_btn_n_i = '0' and r_debug_abort_n_ack = '1' then
               r_debug_abort_n_ack <= '0';
               CPU_nABORT_o <= '0';
            else
               CPU_nABORT_o <= '1';
            end if;
         end if;
      end if;
   end process;


   -- ================================================================================================ --
   -- associate generated
   -- ================================================================================================ --

   CPU_nRES_o <= r_cpu_n_reset(0);
   CPU_nIRQ_o <= irq_n_i and not chipset_cpu_int_i;
   CPU_PHI2_o <= r_cpu_phi;
   CPU_nNMI_o <= r_nmi;

--=======================================================================================
-- 65816 "boot" mode, in boot mode all accesses are to bank FF
--=======================================================================================

   -- the boot signal is delayed such that it doesn't take effect until the next instruction
   -- fetch after the subsequent instruction to allow a long jump from the boot bank after
   -- the boot flag is removed

   p_boot_65816_dly:process(fb_syscon_i)
   begin
      if fb_syscon_i.rst = '1' then
         r_boot_65816_dly <= (others => '1');
      elsif rising_edge(fb_syscon_i.clk) then
         if i_ring_next(0) = '1' and r_VPA = '1' and r_VDA = '1' and r_CPU_RDY = '1' then
            r_boot_65816_dly <= r_boot_65816_dly(r_boot_65816_dly'high-1 downto 0) & boot_65816_i(1);
         end if;
      end if;

   end process;

   -- boot (or not boot) is taken one cpu cycle early when instruction fetch
   -- NOTE: This allows two instruction in the previous mode before switching - not one!
   i_boot <=   CPU_E_i when boot_65816_i(0) = '1' else
               r_boot_65816_dly(1) when r_VPA = '1' and r_VDA = '1' else
               r_boot_65816_dly(2);




   debug_cpu_state_o <= std_logic_vector(to_unsigned(t_state'pos(r_state), 3));
end rtl;
