dominicbeesley/blitter-vhdl-6502/src/hdl/shared/log2phys.vhd

-- TODO : URGENT 2023/12/11 - Rom E on Mk.3 is hard-coded at 1Fxxxx make all SWROMS start in
-- BBRAM at boot and be configurable with registers to a lower number - BLTUTILs to allocate
-- them from the heap with an aligned memory allocation call (to be added)

-- Oct/22 - part done, just for ROM E on mk3
-- Suggest adding turbo mask registers that indicates which roms to run from ChipRAM and a ChipRAM base register
-- Add CMOS support to allow configure of Fast/Turbo/Throttled ROMS


-- MIT License
-- -----------------------------------------------------------------------------
-- Copyright (c) 2020 Dominic Beesley https://github.com/dominicbeesley
--
-- Permission is hereby granted, free of charge, to any person obtaining a copy
-- of this software and associated documentation files (the "Software"), to deal
-- in the Software without restriction, including without limitation the rights
-- to use, copy, modify, merge, publish, distribute, sublicense, and/or sell
-- copies of the Software, and to permit persons to whom the Software is
-- furnished to do so, subject to the following conditions:
--
-- The above copyright notice and this permission notice shall be included in
-- all copies or substantial portions of the Software.
--
-- THE SOFTWARE IS PROVIDED "AS IS", WITHOUT WARRANTY OF ANY KIND, EXPRESS OR
-- IMPLIED, INCLUDING BUT NOT LIMITED TO THE WARRANTIES OF MERCHANTABILITY,
-- FITNESS FOR A PARTICULAR PURPOSE AND NONINFRINGEMENT. IN NO EVENT SHALL THE
-- AUTHORS OR COPYRIGHT HOLDERS BE LIABLE FOR ANY CLAIM, DAMAGES OR OTHER
-- LIABILITY, WHETHER IN AN ACTION OF CONTRACT, TORT OR OTHERWISE, ARISING FROM,
-- OUT OF OR IN CONNECTION WITH THE SOFTWARE OR THE USE OR OTHER DEALINGS IN
-- THE SOFTWARE.
-- -----------------------------------------------------------------------------


-- Company: 			Dossytronics
-- Engineer: 			Dominic Beesley
-- 
-- Create Date:    	16/04/2019
-- Design Name: 
-- Module Name:    	map "logical" CPU addresses to physical addresses
-- Project Name: 
-- Target Devices: 
-- Tool versions: 
-- Description: 		
-- Dependencies: 
--
-- Revision: 
-- Additional Comments: 
--
----------------------------------------------------------------------------------


library ieee;
use ieee.std_logic_1164.all;
use ieee.numeric_std.all;

library work;
use work.fishbone.all;
use work.fb_sys_pack.all;
use work.common.all;
use work.board_config_pack.all;

entity log2phys is
	generic (
		SIM									: boolean := false;							-- skip some stuff, i.e. slow sdram start up
		G_MK3									: boolean := false;
		G_C20K								: boolean := false;
		G_SYSVIA_BLOCK_LEN				: natural := 20;								-- number of 2MHz cycles to throttle for
		G_PRE_BOOT_BANK					: std_logic_vector(23 downto 14) := x"FC" & "11"
	);
	port(

		-- fishbone signals
		fb_syscon_i							: in	fb_syscon_t;

		-- config signals
		cfg_swram_enable_i				: in std_logic;
		cfg_map0n1_i						: in std_logic;
		cfg_mosram_i						: in std_logic;
		cfg_sys_via_block_i				: in std_logic;
		cfg_sys_type_i						: in sys_type;

		-- CPU address control signals from other components
		sys_ROMPG_i							: in	std_logic_vector(7 downto 0);
		JIM_page_i							: in  std_logic_vector(15 downto 0);
		turbo_lo_mask_i					: in	std_logic_vector(7 downto 0);

		throttle_mos_i						: in  std_logic;
		rom_throttle_map_i				: in  std_logic_vector(15 downto 0);
		throttle_all_i						: in  std_logic;
		throttle_act_o						: out std_logic;
		cpu_2MHz_phi2_clken_i			: in  std_logic;

		rom_autohazel_map_i				: in  std_logic_vector(15 downto 0);

		-- when active set a "window" from logical address space 00/FF E000-F000
		-- resets to point at MOS rom at boot time
		window_65816_i						: in	std_logic_vector(12 downto 0);
		window_65816_wr_en_i				: in	std_logic;

		-- memctl signals in
		jim_en_i								: in  std_logic;		-- local jim override
		swmos_shadow_i						: in	std_logic;		-- shadow mos from SWRAM slot #8

		-- noice debugger signals to cpu
		noice_debug_shadow_i				: in std_logic;		-- debugger memory MOS map is active (overrides shadow_mos)

		-- pre-boot							
		preboot_i							: in 	std_logic := '0';		-- the pre-boot 6502 MOS is active

		-- addresses to map
		A_i									: in	std_logic_vector(23 downto 0);
		instruction_fetch_i				: in  std_logic;		-- qualify current cycle as an instruction fetch
		A_stb_i								: in  std_logic;		-- qualify cycle start
		-- mapped address
		A_o									: out std_logic_vector(23 downto 0)

	);
end log2phys;

architecture rtl of log2phys is

	constant SYS_VIA_ADDR : std_logic_vector(23 downto 4) := x"FFFE4";
	constant USR_VIA_ADDR : std_logic_vector(23 downto 4) := x"FFFE6";

	signal r_pagrom_A 	: std_logic_vector(9 downto 0);
	signal r_mosrom_A		: std_logic_vector(9 downto 0);

	signal i_rom_acc		: std_logic;		-- current address is accessing rom
	signal i_nmi_acc		: std_logic;		-- current address is accessing NMI region

	signal r_rom_throttle_cur 		: std_logic;	-- set to '1' when the currently selected ROM is throttled
	signal r_mos_throttle_reg		: std_logic;	-- set to '1' when the mos is throttled
	signal r_all_throttle_reg		: std_logic;	-- set to '1' when everything is throttled
	signal i_throttle_rom			: std_logic;	-- temporary signal during instr fetch, latched in r_instr_rom_throttle
	signal r_instr_rom_throttle	: std_logic;	-- latched i_throttle rom throughout instruction
	signal r_rom_autohazel_cur 	: std_logic;   -- set to '1' when the currently selected ROM is marked for auto-hazel
	signal r_instr_autohazel_cur 	: std_logic;	-- set to '1' when the current instruction is from a ROM that is marked for auto-hazel
	signal i_autohazel 				: std_logic;	-- set to '1' when the current cycle is from a ROM that is marked for auto-hazel
	signal r_window_en				: std_logic;
	signal r_window_65815_l			: std_logic_vector(12 downto 0);
	signal r_window_65815_h			: std_logic_vector(12 downto 0);

	-- via blocker
	signal r_sysvia_block_counter	: unsigned(numbits(G_SYSVIA_BLOCK_LEN)-1 downto 0);
	signal r_sysvia_blocking			: std_logic;

begin

	p_window:process(fb_syscon_i, r_mosrom_A)
	begin
		if rising_edge(fb_syscon_i.clk) then
			if fb_syscon_i.rst = '1' then
				r_window_65815_l <= r_mosrom_A & "100";
				r_window_65815_h <= r_mosrom_A & "101";
				r_window_en <= '0';
			elsif window_65816_wr_en_i = '1' then
				r_window_65815_l <= window_65816_i;
				r_window_65815_h <= std_logic_vector(unsigned(window_65816_i) + 1);
				r_window_en <= '1';
			end if;
		end if;
	end process;

	p_romadd:process(fb_syscon_i)
	begin
		if rising_edge(fb_syscon_i.clk) then
			r_pagrom_A <= x"FF" & "10";
			if (cfg_swram_enable_i = '1' or G_C20K) and fb_syscon_i.rst = '0' then
				if cfg_map0n1_i = '1' then
					if sys_ROMPG_i(3 downto 0) = x"E" and (G_MK3 or G_C20K) then -- special turbo ROM
						r_pagrom_A <= x"1F" & "00";
					elsif G_C20K or (sys_ROMPG_i(2) = '0' or sys_ROMPG_i(3) = '1') then
						if sys_ROMPG_i(0) = '0' then
							r_pagrom_A <= x"7" & "111" & sys_ROMPG_i(3 downto 1);
						else
							r_pagrom_A <= x"9" & "111" & sys_ROMPG_i(3 downto 1);
						end if;
					end if;
				else
					if sys_ROMPG_i(3 downto 0) = x"E" and (G_MK3 or G_C20K) then -- special turbo ROM
						r_pagrom_A <= x"1F" & "01";
					elsif (sys_ROMPG_i(2) = '0' or sys_ROMPG_i(3) = '1' or cfg_sys_type_i /= SYS_ELK) then
						if sys_ROMPG_i(0) = '0' then
							r_pagrom_A <= x"7" & "110" & sys_ROMPG_i(3 downto 1);
						else
							r_pagrom_A <= x"9" & "110" & sys_ROMPG_i(3 downto 1);
						end if;						
					end if;
				end if;	

				r_rom_throttle_cur <= rom_throttle_map_i(to_integer(unsigned(sys_ROMPG_i(3 downto 0))));
			else			
				r_rom_throttle_cur <= '0';
			end if;
			r_rom_autohazel_cur <= rom_autohazel_map_i(to_integer(unsigned(sys_ROMPG_i(3 downto 0))));
		end if;
	end process;

	p_mosadd:process(fb_syscon_i)
	begin
		if fb_syscon_i.rst = '1' then
			r_mos_throttle_reg <= '0';
			r_all_throttle_reg <= '0';
			r_mosrom_A <= x"FF" & "11";
		elsif rising_edge(fb_syscon_i.clk) then
			r_mosrom_A <= x"FF" & "11";								-- SYS																FF C000 - FF FFFF
			if cfg_swram_enable_i = '1' or G_C20K then
				if preboot_i = '1' and G_INCL_PREBOOT then
					r_mosrom_A <= G_PRE_BOOT_BANK;
				elsif noice_debug_shadow_i = '1' then
					if cfg_map0n1_i = '1' then		
						r_mosrom_A <= x"9F" & "11";							-- NOICE shadow MOS from slot #F map 0 					9F C000 - 9F FFFF
					else
						r_mosrom_A <= x"9D" & "11";							-- NOICE shadow MOS from slot #F map 1						9D C000 - 9D FFFF
					end if;			
				elsif swmos_shadow_i = '1' or cfg_mosram_i = '1' then
					if cfg_map0n1_i = '1' then
						r_mosrom_A <= x"7F" & "00";							-- SWMOS from slot #8 map 0 RAM at							7F 0000 - 7F 3FFF
					else
						r_mosrom_A <= x"7D" & "00";							-- SWMOS from slot #8 map 1 RAM at							7D 0000 - 7D 3FFF
					end if;
				elsif not cfg_map0n1_i = '1' then
					r_mosrom_A <= x"9D" & "00";								-- SWMOS from slot #9 map 1									9D 0000 - 9D 3FFF
				elsif cfg_map0n1_i = '1' and G_C20K then
					r_mosrom_A <= x"9F" & "00";								-- SWMOS from slot #9 map 0 on C20K							9F 0000 - 9F 3FFF
				end if;
			end if;
			r_mos_throttle_reg <= throttle_mos_i;
			r_all_throttle_reg <= throttle_all_i;
		end if;
	end process;

	p_A0:process(all)
	begin
		A_o <= A_i;
		i_throttle_rom <= '0';
		i_rom_acc <= '0';
		i_nmi_acc <= '0';
		if A_i(23 downto 16) = x"FF" then -- system access
			if A_i(15 downto 14) = "10" then -- paged rom access
				i_rom_acc <= '1';
				A_o <= r_pagrom_A & A_i(13 downto 0);
				i_throttle_rom <= r_rom_throttle_cur; -- throttle accesses to current ROM if needed, TODO: consider making this for whole instruction from ROM using SYNC?
			elsif A_i(15 downto 8) = x"FD" then
				if jim_en_i = '1' then
					A_o <= JIM_page_i & A_i(7 downto 0);
				end if;
			elsif A_i(15 downto 14) = "11" 
					and A_i(15 downto 8) /= x"FC"
					and A_i(15 downto 8) /= x"FD"
					and A_i(15 downto 8) /= x"FE" then -- MOS access
				if noice_debug_shadow_i = '1' and A_i(13 downto 12) = "00" then
					A_o <= x"7E8" & A_i(11 downto 0);				-- NOICE shadow RAM from hidden slot #4 of map 0		7E 8000 - 7E 8FFF
				else
					if i_autohazel = '1' and A_i(13) = '0' then
						-- Hazel from 00 C000-DFFF
						A_o <= x"00" & "110" & A_i(12 downto 0);
					else
						if r_window_en = '1' and A_i(13 downto 11) = "100" then
							A_o <= r_window_65815_l & A_i(10 downto 0);
						elsif r_window_en = '1' and A_i(13 downto 11) = "101" then
							A_o <= r_window_65815_h & A_i(10 downto 0);
						else
							A_o <= r_mosrom_A & A_i(13 downto 0);		
							i_throttle_rom <= r_mos_throttle_reg;	
						end if;
					end if;
				end if;
			elsif A_i(15) = '0' and turbo_lo_mask_i(to_integer(unsigned(A_i(14 downto 12)))) = '1' then
				A_o <= x"00" & A_i(15 downto 0);							-- turbo RAM														00 0000 - 00 7FFF
			end if;

			if A_i(15 downto 8) = x"0D" then
				i_nmi_acc <= '1';
			end if;

		end if;
	end process p_A0;

	i_autohazel <= r_rom_autohazel_cur and i_rom_acc when instruction_fetch_i = '1' else
						r_instr_autohazel_cur;

	p_instr:process(fb_syscon_i)
	begin
		if fb_syscon_i.rst = '1' then
			r_instr_autohazel_cur <= '0';
		elsif rising_edge(fb_syscon_i.clk) then
			if instruction_fetch_i = '1' then
				if i_nmi_acc = '1' then
					r_instr_autohazel_cur <= r_rom_autohazel_cur;
				elsif i_rom_acc = '1' then
					r_instr_autohazel_cur <= r_rom_autohazel_cur;
				else
					r_instr_autohazel_cur <= '0';
				end if;
			end if;
		end if;
	end process;


	throttle_act_o <= (i_throttle_rom or r_all_throttle_reg or r_sysvia_blocking) when instruction_fetch_i = '1' else
						r_instr_rom_throttle;

	p_instr_throt:process(fb_syscon_i)
	begin
		if fb_syscon_i.rst = '1' then
			r_instr_rom_throttle <= '0';
		elsif rising_edge(fb_syscon_i.clk) then
			if instruction_fetch_i = '1' then
				r_instr_rom_throttle <= i_throttle_rom or r_all_throttle_reg or r_sysvia_blocking;
			end if;
		end if;
	end process;

	p_sys_via_block:process(fb_syscon_i)
	begin
		if fb_syscon_i.rst = '1' then
			r_sysvia_blocking <= '0';
			r_sysvia_block_counter <= (others => '0');
		elsif rising_edge(fb_syscon_i.clk) then
			if A_stb_i = '1'
				and cfg_sys_via_block_i = '1'
				and (A_i(23 downto 4) = SYS_VIA_ADDR or A_i(23 downto 4) = USR_VIA_ADDR) then
				r_sysvia_blocking <= '1';
				r_sysvia_block_counter <= to_unsigned(G_SYSVIA_BLOCK_LEN, r_sysvia_block_counter'length);
			elsif r_sysvia_blocking = '1' and cpu_2MHz_phi2_clken_i = '1' then
				if r_sysvia_block_counter = 0 then
					r_sysvia_blocking <= '0';
				else
					r_sysvia_block_counter <= r_sysvia_block_counter - 1;
				end if;
			end if;
		end if;
	end process;

end rtl;
