dominicbeesley/blitter-vhdl-6502/src/hdl/shared/fb_CPU_con_burst.vhd

-- MIT License
-- -----------------------------------------------------------------------------
-- Copyright (c) 2022 Dominic Beesley https://github.com/dominicbeesley
--
-- Permission is hereby granted, free of charge, to any person obtaining a copy
-- of this software and associated documentation files (the "Software"), to deal
-- in the Software without restriction, including without limitation the rights
-- to use, copy, modify, merge, publish, distribute, sublicense, and/or sell
-- copies of the Software, and to permit persons to whom the Software is
-- furnished to do so, subject to the following conditions:
--
-- The above copyright notice and this permission notice shall be included in
-- all copies or substantial portions of the Software.
--
-- THE SOFTWARE IS PROVIDED "AS IS", WITHOUT WARRANTY OF ANY KIND, EXPRESS OR
-- IMPLIED, INCLUDING BUT NOT LIMITED TO THE WARRANTIES OF MERCHANTABILITY,
-- FITNESS FOR A PARTICULAR PURPOSE AND NONINFRINGEMENT. IN NO EVENT SHALL THE
-- AUTHORS OR COPYRIGHT HOLDERS BE LIABLE FOR ANY CLAIM, DAMAGES OR OTHER
-- LIABILITY, WHETHER IN AN ACTION OF CONTRACT, TORT OR OTHERWISE, ARISING FROM,
-- OUT OF OR IN CONNECTION WITH THE SOFTWARE OR THE USE OR OTHER DEALINGS IN
-- THE SOFTWARE.
-- ----------------------------------------------------------------------

-- Company:          Dossytronics
-- Engineer:         Dominic Beesley
-- 
-- Create Date:      28/10/2022
-- Design Name: 
-- Module Name:      fishbone bus - CPU burst transfers for multiple bytes
-- Project Name: 
-- Target Devices: 
-- Tool versions: 
-- Dependencies: 
--
-- Revision: 
----------------------------------------------------------------------------------

library ieee;
use ieee.std_logic_1164.all;
use ieee.numeric_std.all;

library work;
use work.fishbone.all;
use work.common.all;

entity fb_cpu_con_burst is
generic (
   SIM : boolean := false;
   G_BYTELANES : positive := 1
   );
port (

   -- config

   BE_i              : in std_logic; -- 1 for big endian

   -- from cpu wrappers

   cyc_i             : in std_logic; 
   A_i               : in std_logic_vector(23 downto 0);
   we_i              : in std_logic;
   lane_req_i        : in std_logic_vector(G_BYTELANES-1 downto 0);        -- this is a mask of byte lanes to be read/written and must all be set when cyc goes active
   D_wr_i            : in std_logic_vector((8 * G_BYTELANES)-1 downto 0);
   D_wr_stb_i        : in std_logic_vector(G_BYTELANES-1 downto 0);        -- unlike fishbone this must stay asserted until the end of the cycle!
   rdy_ctdn_i        : in t_rdy_ctdn;
   instr_fetch_i     : in std_logic;

   -- return to wrappers

   rdy_o             : out std_logic;                                   -- unlike fishbone D_rd, rdy, ack_lane and ack will latch until end of cycle
   act_lane_o        : out std_logic_vector(G_BYTELANES-1 downto 0);
   ack_lane_o        : out std_logic_vector(G_BYTELANES-1 downto 0);
   ack_o             : out std_logic;
   D_rd_o            : out std_logic_vector((8 * G_BYTELANES)-1 downto 0);
   -- unregistered, for wrappers that register their own pins: the lane being
   -- D_acked this clock (reads and writes) and its data. They change at the
   -- edge before ack_lane_o/D_rd_o do.
   rx_lane_unreg_o   : out std_logic_vector(G_BYTELANES-1 downto 0);
   rx_D_rd_unreg_o   : out std_logic_vector(7 downto 0);

   -- fishbone byte wide controller interface

   fb_syscon_i       : in fb_syscon_t;

   fb_con_c2p_o      : out fb_con_o_per_i_t;
   fb_con_p2c_i      : in  fb_con_i_per_o_t;
   fb_con_c2pinstr_fetch_o : out std_logic -- qualify current cycle as an instruction fetch

);
end fb_cpu_con_burst;


architecture rtl of fb_cpu_con_burst is

   signal r_cyc         : std_logic;
   signal r_instr_fetch : std_logic;

   signal r_tx_mas      : std_logic_vector(G_BYTELANES-1 downto 0);     -- mask where we're at with servicing A/A_stb/A_ack
   signal r_txd_mas     : std_logic_vector(G_BYTELANES-1 downto 0);     -- mask where we're at with servicing D_wr/D_wr_stb/D_ack
   signal r_rx_mas      : std_logic_vector(G_BYTELANES-1 downto 0);     -- mask where we're at with servicing D_rd/D_ack

   signal i_tx_cur      : std_logic_vector(G_BYTELANES-1 downto 0);     -- next byte lane to service priority encoded by BE/LE
   signal i_txd_cur     : std_logic_vector(G_BYTELANES-1 downto 0);     -- next byte lane to service priority encoded by BE/LE
   signal i_rx_cur      : std_logic_vector(G_BYTELANES-1 downto 0);     -- next byte lane to service priority encoded by BE/LE

   signal r_A           : std_logic_vector(23 downto 0);
   signal r_D_rd        : std_logic_vector((8 * G_BYTELANES)-1 downto 0);
   signal r_rdy         : std_logic;
   signal r_ack         : std_logic;
   signal r_ack_lane    : std_logic_vector(G_BYTELANES-1 downto 0);

   function priority_endian(
      BE    : std_logic;
      req   : std_logic_vector(G_BYTELANES-1 downto 0)      
      ) return std_logic_vector is
   variable i:natural;
   variable b:boolean;
   variable ret:std_logic_vector(G_BYTELANES-1 downto 0);
   begin

      b := false;
      ret := (others => '0');
      if BE = '1' then
         for i in G_BYTELANES-1 downto 0 loop
            if not b and req(i) = '1' then
               ret(i) := '1';
               b:=true;
            end if;
         end loop;
      else
         for i in 0 to G_BYTELANES-1 loop
            if not b and req(i) = '1' then
               ret(i) := '1';
               b:=true;
            end if;
         end loop;
      end if;
      return ret;
   end function;



begin

   i_tx_cur <= priority_endian(BE_i, lane_req_i and r_tx_mas);
   i_txd_cur <= priority_endian(BE_i, lane_req_i and r_txd_mas);
   i_rx_cur <= priority_endian(BE_i, lane_req_i and r_rx_mas);

   p_con_state:process(fb_syscon_i)
   begin

      if fb_syscon_i.rst = '1' then
         r_cyc <= '0';
      elsif rising_edge(fb_syscon_i.clk) then
         if r_cyc = '1' then
            if cyc_i = '0' then
               r_cyc <= '0';
            end if;
         else
            if cyc_i = '1' then
               r_cyc <= '1';
            end if;
         end if;
      end if;

   end process;

   p_tx:process(fb_syscon_i) 
   begin
      if fb_syscon_i.rst = '1' then
         r_tx_mas <= (others => '1');
         r_A <= (others => '0'); 
         r_instr_fetch <= '0';
      elsif rising_edge(fb_syscon_i.clk) then

         if r_cyc = '0' and cyc_i = '1' then
            r_tx_mas <= (others => '1');
            r_A <= A_i;
            r_instr_fetch <= instr_fetch_i;
         elsif r_cyc = '1' then
            if cyc_i = '0' then
               r_tx_mas <= (others => '0');
            elsif fb_con_p2c_i.A_ack = '1' and my_or_reduce(i_tx_cur) = '1' then
               r_tx_mas <= r_tx_mas and not i_tx_cur;
               r_A <= std_logic_vector(unsigned(r_A) + 1);
            end if;
         else
            r_tx_mas <= (others => '0');
         end if;
      end if;
   end process;

   p_txd:process(fb_syscon_i) 
   begin
      if fb_syscon_i.rst = '1' then
         r_txd_mas <= (others => '1');
      elsif rising_edge(fb_syscon_i.clk) then

         if r_cyc = '0' and cyc_i = '1' then
            r_txd_mas <= (others => '1');
         elsif r_cyc = '1' then
            if cyc_i = '0' then
               r_txd_mas <= (others => '0');
            elsif fb_con_p2c_i.D_ack = '1' and my_or_reduce(i_txd_cur) = '1' then
               r_txd_mas <= r_txd_mas and not i_txd_cur;
            end if;
         else
            r_txd_mas <= (others => '0');
         end if;
      end if;
   end process;

   p_rx:process(fb_syscon_i)
   variable i:natural;
   begin
      if fb_syscon_i.rst = '1' then
         r_rx_mas <= (others => '1');
         r_D_rd <= (others => '1');
         r_rdy <= '0';
         r_ack <= '0';
         r_ack_lane <= (others => '0');
      elsif rising_edge(fb_syscon_i.clk) then
         if r_cyc = '0' and cyc_i = '1' then
            r_rx_mas <= (others => '1');
            r_rdy <= '0';
            r_ack <= '0';
            r_ack_lane <= (others => '0');
         elsif r_cyc = '1' and cyc_i = '1' then
            if fb_con_p2c_i.D_ack = '1' then
               for i in 0 to G_BYTELANES-1 loop
                  if i_rx_cur(i) = '1' then
                     r_d_Rd(((i+1)*8)-1 downto (i*8)) <= fb_con_p2c_i.D_rd;
                  end if;
               end loop;
               r_rx_mas <= r_rx_mas and not i_rx_cur;
               r_ack_lane <= r_ack_lane or i_rx_cur;
               if my_or_reduce(lane_req_i and r_rx_mas and not i_rx_cur) = '0' then
                  r_ack <= '1';
                  r_rdy <= '1';
               end if;
            end if;

            if fb_con_p2c_i.rdy = '1' and my_or_reduce(lane_req_i and r_rx_mas and not i_rx_cur) = '0' and r_cyc = '1' then
               r_rdy <= '1';
            end if;
         else
            r_rx_mas <= (others => '0');
            r_rdy <= '0';
            r_ack <= '0';
            r_ack_lane <= (others => '0');
         end if;
      end if;
   end process;

   fb_con_c2p_o.cyc <= r_cyc;
   fb_con_c2p_o.A_stb <= my_or_reduce(i_tx_cur);
   fb_con_c2p_o.A <= r_A;
   fb_con_c2p_o.we <= we_i;
   fb_con_c2p_o.rdy_ctdn <= rdy_ctdn_i;
   fb_con_c2p_o.D_wr_stb <= my_or_reduce(i_txd_cur and D_wr_stb_i) and we_i;
   fb_con_c2pinstr_fetch_o <= r_instr_fetch;

   p_d_wr_mux:process(all)
   variable i:natural;
   begin
      fb_con_c2p_o.D_Wr <= (others => '-');
      for i in 0 to G_BYTELANES -1 loop
         if i_txd_cur(i) = '1' then
            fb_con_c2p_o.D_Wr <= D_wr_i((8*(i+1))-1 downto 8*i);
         end if;
      end loop;
   end process;

   rdy_o       <= r_rdy;
   ack_lane_o  <= r_ack_lane;
   ack_o       <= r_ack;
   D_rd_o      <= r_d_Rd;

   act_lane_o  <= i_tx_cur;

   -- same qualification as the D_rd capture in p_rx
   rx_lane_unreg_o <= i_rx_cur when r_cyc = '1' and cyc_i = '1' and fb_con_p2c_i.D_ack = '1' else
                      (others => '0');
   rx_D_rd_unreg_o <= fb_con_p2c_i.D_rd;

end rtl;
