dominicbeesley/blitter-vhdl-6502/src/hdl/shared/fb_CPU_65816.vhd

-- MIT License
-- -----------------------------------------------------------------------------
-- Copyright (c) 2022 Dominic Beesley https://github.com/dominicbeesley
--
-- Permission is hereby granted, free of charge, to any person obtaining a copy
-- of this software and associated documentation files (the "Software"), to deal
-- in the Software without restriction, including without limitation the rights
-- to use, copy, modify, merge, publish, distribute, sublicense, and/or sell
-- copies of the Software, and to permit persons to whom the Software is
-- furnished to do so, subject to the following conditions:
--
-- The above copyright notice and this permission notice shall be included in
-- all copies or substantial portions of the Software.
--
-- THE SOFTWARE IS PROVIDED "AS IS", WITHOUT WARRANTY OF ANY KIND, EXPRESS OR
-- IMPLIED, INCLUDING BUT NOT LIMITED TO THE WARRANTIES OF MERCHANTABILITY,
-- FITNESS FOR A PARTICULAR PURPOSE AND NONINFRINGEMENT. IN NO EVENT SHALL THE
-- AUTHORS OR COPYRIGHT HOLDERS BE LIABLE FOR ANY CLAIM, DAMAGES OR OTHER
-- LIABILITY, WHETHER IN AN ACTION OF CONTRACT, TORT OR OTHERWISE, ARISING FROM,
-- OUT OF OR IN CONNECTION WITH THE SOFTWARE OR THE USE OR OTHER DEALINGS IN
-- THE SOFTWARE.
-- -----------------------------------------------------------------------------

-- Company: 			Dossytronics
-- Engineer: 			Dominic Beesley
-- 
-- Create Date:    	9/8/2020
-- Design Name: 
-- Module Name:    	fishbone bus - CPU wrapper component - 65816
-- Project Name: 
-- Target Devices: 
-- Tool versions: 
-- Description: 		
-- Dependencies: 
--
-- Revision: 
-- Additional Comments: 
--
----------------------------------------------------------------------------------

-- Speed up notes 7/11/22 - it seems SUBSTATE_A_8 could be shaved to 3 for the 14MHz part at 5V except
-- that the i_VMA signal then seems to cause problems with possible metastability - look at either 
-- timing constraints on ports to improve this or ignore VMA altogether?

-- The following cycles were tested and found ok 7/11/22 on 14MHz part, returned values to those
-- for the 3.3V/8MHz part
--	constant SUBSTATEMAX_8	: t_substate := to_unsigned(7, t_substate'length);
--	constant SUBSTATE_A_8	: t_substate := SUBSTATEMAX_8 - to_unsigned(4, t_substate'length);
--	constant SUBSTATE_D_8	: t_substate := to_unsigned(2, t_substate'length);
--	constant SUBSTATE_D_WR_8: t_substate := SUBSTATEMAX_8 - to_unsigned(3, t_substate'length);


library ieee;
use ieee.std_logic_1164.all;
use ieee.numeric_std.all;

library work;
use work.fishbone.all;
use work.board_config_pack.all;
use work.fb_cpu_pack.all;
use work.fb_cpu_exp_pack.all;

entity fb_cpu_65816 is
		generic (
		SIM									: boolean := false;							-- skip some stuff, i.e. slow sdram start up
		CLOCKSPEED							: positive
	);
	port(

		-- configuration
		cpu_en_i									: in std_logic;				-- 1 when this cpu is the current one
		fb_syscon_i								: in	fb_syscon_t;

		-- state machine signals
		wrap_o									: out t_cpu_wrap_o;
		wrap_i									: in t_cpu_wrap_i;

		-- CPU expansion signals
		wrap_exp_o								: out t_cpu_wrap_exp_o;
		wrap_exp_i								: in t_cpu_wrap_exp_i;

		-- 65816 specific signals

		boot_65816_i							: in		std_logic_vector(1 downto 0);
		-- boot settings:
		--	10		logical page FF maps to logical page 00, any change takes 2 instructions to complete to allow jump
		--	00		pages map direct, any change takes 2 instructions to complete to allow jump
		--	01		logical page FF maps to 00 in Emu mode, direct map otherwise, immediate change on emu switch
		-- 11		logical page FF maps to 00 in Emu mode, direct map otherwise, immediate change on emu switch ignore Throttle in native mode

		debug_vma_o								: out		std_logic;
		debug_addr_meta_o						: out		std_logic;
		debug_65816_boot_act_o				: out std_logic

);
end fb_cpu_65816;

architecture rtl of fb_cpu_65816 is
	signal r_prev_A0			: std_logic;

	signal r_PHI0				: std_logic;
	signal r_PHI0_dly			: std_logic_vector(3 downto 0);

	type t_state is (
		phi1,
		phi2
		);

	signal r_state				: t_state;

	subtype t_substate is unsigned(4 downto 0); -- divide down by a max of 64/2

	signal r_substate			: t_substate := (others => '1');	
	signal r_rdy_ctup			: t_substate := (others => '1'); -- this counts up since data was ready


	--TODO: sort this all out to be more intuitive 
	--TODO: test phi0 to phi2 skew during boot and adjust?

	constant SUBSTATEMAX_8	: t_substate := to_unsigned(7, t_substate'length);

	-- address latch state:
	constant SUBSTATE_A_8	: t_substate := SUBSTATEMAX_8 - to_unsigned(6, t_substate'length);
	constant SUBSTATE_A_8_PRE : t_substate := SUBSTATE_A_8 + to_unsigned(1, t_substate'length);

	constant SUBSTATE_A_META: t_substate := SUBSTATEMAX_8 - to_unsigned(3, t_substate'length);


	constant SUBSTATE_D_8	: t_substate := to_unsigned(2, t_substate'length);

	constant SUBSTATE_D_WR_8: t_substate := SUBSTATEMAX_8 - to_unsigned(5, t_substate'length);


	signal r_cpu_hlt			: std_logic;	-- need to register this at the start of the cycle following
														-- halt being asserted to stop that cycle from starting
	signal r_cpu_hlt_prev	: std_logic;	-- the previous cpu cycle was held by RDY (r_cpu_hlt through its phi2)
	signal r_cpu_res			: std_logic;

	signal r_boot_65816_dly	: std_logic_vector(2 downto 0) := (others => '1');
	signal i_boot				: std_logic;
															-- this should be before A/CYC

	signal i_vma				: std_logic;		-- '1' if VPA or VDA
	signal r_cyc				: std_logic;		-- '1' for entirety of cycle
	signal r_D_WR_stb			: std_logic;
	signal r_inihib			: std_logic;		-- '1' throughout an inhibited cycle

	signal r_log_A				: std_logic_vector(23 downto 0);
	signal r_A_meta			: std_logic_vector(23 downto 0);
	signal r_instr_fetch		: std_logic;

	signal i_ack				: std_logic;

	signal r_fbreset_prev	: std_logic := '0';

	signal r_throttle_sync  : std_logic;		-- hold throttle for the rest of the instruction
	signal i_throttle			: std_logic;		-- '1' if current throttle or sync throttle
	signal r_had_phi2			: std_logic;		-- a phi2 occurred already while we were waiting for ack


	-- port b
	signal i_CPUSKT_BE_b2c		: std_logic;		-- note only for the WDC 's' parts
	signal i_CPUSKT_PHI0_b2c	: std_logic;
	signal i_CPUSKT_RDY_b2c		: std_logic;
	signal i_CPUSKT_nIRQ_b2c	: std_logic;
	signal i_CPUSKT_nNMI_b2c	: std_logic;
	signal i_CPUSKT_nRES_b2c	: std_logic;
	signal i_BUF_D_RnW_b2c		: std_logic;

	signal r_CPUSKT_nABORT_b2c	: std_logic;
	signal r_debug_nmi_ack		: std_logic;
	-- TODO: look to merge with stuff in memctl?
	signal r_WDM					: std_logic;		-- a WDM instruction opcode has been seen, request an abort


	-- port d

	signal i_CPUSKT_6E_c2b		: std_logic;
	signal i_CPUSKT_RnW_c2b		: std_logic;
	signal i_CPUSKT_VDA_c2b		: std_logic;
	signal i_CPUSKT_VPA_c2b		: std_logic;
	signal i_CPUSKT_VPB_c2b		: std_logic;

	signal i_CPUSKT_D_c2b		: std_logic_vector(7 downto 0);
	signal i_CPUSKT_A_c2b		: std_logic_vector(15 downto 0);



begin

	assert CLOCKSPEED = 128 report "CLOCKSPEED must be 128" severity error;

	debug_65816_boot_act_o	<= i_boot;

	-- this will go active either for ever if BLTURBO T or at some point during
	-- the current cycle if BLTURBO R and may stay active to next SYNC
	i_throttle <= '0' when boot_65816_i = "11" and i_CPUSKT_6E_c2b = '0' else
								  r_throttle_sync or wrap_i.throttle_cpu_2MHz;



	e_pinmap:entity work.fb_cpu_65816_exp_pins
	port map(
		-- cpu wrapper signals
		wrap_exp_o => wrap_exp_o,
		wrap_exp_i => wrap_exp_i,

		-- local 65816 wrapper signals to/from CPU expansion port 

		CPUSKT_BE_b2c			=> i_CPUSKT_BE_b2c,
		CPUSKT_PHI0_b2c		=> i_CPUSKT_PHI0_b2c,
		CPUSKT_RDY_b2c			=> i_CPUSKT_RDY_b2c,
		CPUSKT_nIRQ_b2c		=> i_CPUSKT_nIRQ_b2c,
		CPUSKT_nNMI_b2c		=> i_CPUSKT_nNMI_b2c,
		CPUSKT_nRES_b2c		=> i_CPUSKT_nRES_b2c,
		CPUSKT_nABORT_b2c		=> r_CPUSKT_nABORT_b2c,
		CPUSKT_D_b2c			=> wrap_i.D_rd(7 downto 0),

		BUF_D_RnW_b2c			=> i_BUF_D_RnW_b2c,

		CPUSKT_6E_c2b			=>	i_CPUSKT_6E_c2b,
		CPUSKT_RnW_c2b			=> i_CPUSKT_RnW_c2b,
		CPUSKT_VDA_c2b			=> i_CPUSKT_VDA_c2b,
		CPUSKT_VPA_c2b			=> i_CPUSKT_VPA_c2b,
		CPUSKT_VPB_c2b			=> i_CPUSKT_VPB_c2b,

		-- shared per CPU signals
		CPUSKT_A_c2b			=> i_CPUSKT_A_c2b,
		CPUSKT_D_c2b			=> i_CPUSKT_D_c2b

	);



	debug_vma_o <= i_vma;



	i_BUF_D_RnW_b2c <= 	'1' 	when i_CPUSKT_RnW_c2b = '1' 						-- we need to make sure that
										and r_PHI0_dly(r_PHI0_dly'high) = '1' 	-- read data into the CPU from the
										and r_PHI0 = '1' 								-- board doesn't crash into the bank
										else												-- bank address so hold is short
																							-- and setup late														
								'0';

	wrap_o.BE 					<= '0';
	wrap_o.A 					<= r_log_A;
	wrap_o.cyc					<= r_cyc;
	wrap_o.lane_req 			<= ( 0 => '1', others => '0');
	wrap_o.we	  				<= not(i_CPUSKT_RnW_c2b);
	wrap_o.D_wr(7 downto 0)	<=	i_CPUSKT_D_c2b;	
	wrap_o.instr_fetch		<= r_instr_fetch;

	G_D_WR_EXT:if C_CPU_BYTELANES > 1 GENERATE
		wrap_o.D_WR((8*C_CPU_BYTELANES)-1 downto 8) <= (others => '-');
	END GENERATE;

	wrap_o.D_wr_stb			<= ( 0 => r_D_WR_stb, others => '0');
	wrap_o.rdy_ctdn			<= RDY_CTDN_MIN;

	p_phi0_dly:process(fb_syscon_i)
	begin
		if fb_syscon_i.rst = '1' then
			r_PHI0_dly <= (others => '0');
		elsif rising_edge(fb_syscon_i.clk) then
			r_PHI0_dly <= r_PHI0_dly(r_PHI0_dly'high-1 downto 0) & r_PHI0;
		end if;
	end process;

	p_state:process(fb_syscon_i)
	variable v_ctupnext : t_substate;	
	begin
		if rising_edge(fb_syscon_i.clk) then
			if wrap_i.rdy = '1' then
				v_ctupnext := r_rdy_ctup + 1;
				if v_ctupnext /= 0 then
					r_rdy_ctup <= v_ctupnext;
				end if;
			end if;

			if wrap_i.cpu_2MHz_phi2_clken = '1' then
				r_had_phi2 <= '1';
			end if;

			case r_state is
				when phi1 =>

					if r_substate = SUBSTATE_A_META then
						r_A_meta <= i_CPUSKT_D_c2b(7 downto 0) & i_CPUSKT_A_c2b;
					end if;

					if r_substate = SUBSTATE_A_8_PRE then

						if fb_syscon_i.rst = '1' or cpu_en_i = '0' then
							r_cpu_hlt <= '0';
							r_cpu_res <= '1';
						else
							r_cpu_hlt <= wrap_i.cpu_halt;
							r_cpu_res <= '0';					
						end if;

					end if;

					if r_substate = SUBSTATE_A_8 then

						-- latch the address and bank only at the start of a new cpu cycle:
						-- after a cycle held by RDY the cpu completes the same cycle and
						-- doesn't drive the bank onto the data bus again
						if r_cpu_hlt_prev = '0' then
							if i_boot = '1' then
								if i_CPUSKT_D_c2b(7 downto 0) = x"00" then -- bank 0 map to FF, special treatment for native vector pulls
									if i_CPUSKT_VPB_c2b = '0' and unsigned(i_CPUSKT_A_c2b(4 downto 0)) <= 16#19# then
										-- vector pull in Native mode or "new" ABORT/COP
										-- get from 008Fxx
										r_log_A <= x"008F" & i_CPUSKT_A_c2b(7 downto 0);
									else
										-- bank 0 maps to FF in boot mode
										r_log_A <= x"FF" & i_CPUSKT_A_c2b;
									end if;
								else
									-- not bank 0 map direct
									r_log_A <= i_CPUSKT_D_c2b(7 downto 0) & i_CPUSKT_A_c2b;	
								end if;
							else
								-- not boot mode map direct
								r_log_A <= i_CPUSKT_D_c2b(7 downto 0) & i_CPUSKT_A_c2b;
							end if;

							r_instr_fetch <= i_CPUSKT_VPA_c2b and i_CPUSKT_VDA_c2b;
						end if;

						if r_A_meta = i_CPUSKT_D_c2b & i_CPUSKT_A_c2b then
							debug_addr_meta_o <= '0';
						else
							debug_addr_meta_o <= '1';
						end if;


						if  wrap_i.noice_debug_inhibit_cpu = '0' and
						 		fb_syscon_i.rst = '0' and
						 		r_cpu_hlt = '0' and
						 		i_vma = '1' then
							r_cyc <= '1';
							r_D_WR_stb <= '0';
							r_rdy_ctup <= (others => '0');
							r_inihib <= '0';
						else
							r_inihib <= '1';
						end if;

					end if;

					if r_substate = 0 then

						r_state <= phi2;
						r_PHI0 <= '1';
						r_substate <= SUBSTATEMAX_8;
					else
						r_substate <= r_substate - 1;
					end if;

					r_had_phi2 <= '0';

				when phi2 =>

					if r_substate = SUBSTATE_D_WR_8 then
						r_D_WR_stb <= '1';
					end if;

					if r_substate = 0 then

						if i_ack then
							r_cpu_hlt_prev <= r_cpu_hlt;
							r_state <= phi1;
							r_PHI0 <= '0';
							r_substate <= SUBSTATEMAX_8;
							r_cyc <= '0';
							r_D_WR_stb <= '0';
							r_wdm <= '0';
							if i_CPUSKT_VPA_c2b = '1' and i_CPUSKT_VDA_c2b = '1' then
								r_throttle_sync <= wrap_i.throttle_cpu_2MHz;
								if wrap_i.D_rd(7 downto 0) = x"42" then
									r_wdm <= '1';
								end if;
							end if;
						end if;
					else
						r_substate <= r_substate - 1;
					end if;

				when others =>
					r_state <= phi1;
					r_substate <= SUBSTATEMAX_8;
					r_PHI0 <= '0';
					r_cyc <= '0';
					r_D_WR_stb <= '0';
			end case;


			-- bodge for reset - need to better work out the state machine!
			if r_fbreset_prev = '0' and fb_syscon_i.rst = '1' then
				r_cpu_hlt_prev <= '0';
				r_state <= phi1;
				r_substate <= SUBSTATEMAX_8;
				r_PHI0 <= '0';				
				r_throttle_sync <= '0';
				r_WDM <= '0';
			end if;
			r_fbreset_prev <= fb_syscon_i.rst;


		end if;
	end process;

	i_ack <= '1' when
		r_state = phi2 and
		r_substate = 0 and
		(
			r_inihib = '1' or
			r_cpu_res = '1' or
				(	(i_CPUSKT_RnW_c2b = '0' and wrap_i.rdy = '1') or 
					r_rdy_ctup >= SUBSTATE_D_8) 
		) and
		(i_throttle = '0' or wrap_i.cpu_2MHz_phi2_clken = '1' or r_had_phi2 = '1')

			else
				'0';

	p_abort:process(fb_syscon_i)
	begin
		if fb_syscon_i.rst = '1' then
			r_CPUSKT_nABORT_b2c <= '1';
			r_debug_nmi_ack <= '1';
		elsif rising_edge(fb_syscon_i.clk) then
			if r_state = phi1 and r_substate = SUBSTATE_A_8 then							
				if wrap_i.noice_debug_nmi_n = '1' then
					r_debug_nmi_ack <= '1';
				end if;

				if (wrap_i.noice_debug_nmi_n = '0' and r_debug_nmi_ack = '1') or r_WDM = '1' then
					r_debug_nmi_ack <= '0';
					r_CPUSKT_nABORT_b2c <= '0';
				else
					r_CPUSKT_nABORT_b2c <= '1';
				end if;

			end if;
		end if;
	end process;

	i_vma <= i_CPUSKT_VPA_c2b or i_CPUSKT_VDA_c2b;

	i_CPUSKT_BE_b2c <= cpu_en_i;
	
	i_CPUSKT_PHI0_b2c <= r_PHI0;
	
	i_CPUSKT_nRES_b2c <= not r_cpu_res;

	
	i_CPUSKT_nNMI_b2c <= wrap_i.nmi_n;
  	
	i_CPUSKT_nIRQ_b2c <=  wrap_i.irq_n;

  	i_CPUSKT_RDY_b2c <= 	'0' when r_cpu_hlt = '1' else
  											'1';

--=======================================================================================
-- 65816 "boot" mode, in boot mode all accesses are to bank FF
--=======================================================================================

	-- the boot signal is delayed such that it doesn't take effect until the next instruction
	-- fetch after the subsequent instruction to allow a long jump from the boot bank after
	-- the boot flag is removed

	p_boot_65816_dly:process(fb_syscon_i)
	begin
		if fb_syscon_i.rst = '1' then
			r_boot_65816_dly <= (others => '1');
		elsif rising_edge(fb_syscon_i.clk) then
			if r_state = phi2 and r_substate = 0 and i_CPUSKT_VPA_c2b = '1' and i_CPUSKT_VDA_c2b = '1' and i_ack = '1' then
				r_boot_65816_dly <= r_boot_65816_dly(r_boot_65816_dly'high-1 downto 0) & boot_65816_i(1);
			end if;
		end if;

	end process;

	-- boot (or not boot) is taken one cpu cycle early when instruction fetch
	-- NOTE: This allows two instruction in the previous mode before switching - not one!
	i_boot <= 	i_CPUSKT_6E_c2b when boot_65816_i(0) = '1' else
					r_boot_65816_dly(1) when i_CPUSKT_VPA_c2b = '1' and i_CPUSKT_VDA_c2b = '1' else
				 	r_boot_65816_dly(2);


--=======================================================================================
-- NoIce stuff
--=======================================================================================

   p_prev_a0:process(fb_syscon_i) 
  	begin
  		if fb_syscon_i.rst = '1' then
  			r_prev_A0 <= '0';
  		elsif rising_edge(fb_syscon_i.clk) then
  			if r_state = phi2 and r_substate = 0 then
  				r_prev_A0 <= i_CPUSKT_A_c2b(0);
  			end if;
  		end if;
  	end process;

	--TODO: this doesn't work for 65816 - there's no special A0 no-toggle cycle

	wrap_o.noice_debug_A0_tgl <= r_prev_A0 xor i_CPUSKT_A_c2b(0);

  	wrap_o.noice_debug_cpu_clken <= '1' when r_state = phi2 and r_substate = 0 and i_ack = '1' else '0';
  	
  	wrap_o.noice_debug_5c	 <= '0';

  	wrap_o.noice_debug_opfetch <= i_CPUSKT_VPA_c2b and i_CPUSKT_VDA_c2b and not r_cpu_hlt;






end rtl;
