dominicbeesley/blitter-vhdl-6502/(commit log)

2021-11-01 fix and gitignore mk3-board-erc project
    [mk3-board-erc.vhd]
2021-11-01 Add shared stuff, fix copyright notices
    [address_decode.vhd, address_decode_chipset.vhd, aeris.vhd, blit_addr.vhd, blit_int.vhd, blit_types.vhd, clocks_pll.vhd, dac_1bit.vhd]
2021-11-02 1st cut build 16-max
2021-11-10 Add simulation files
    Also:
    Remove HDMI/config thing - it doesn't work with modelsim
    Faff with 65816 T65 core to better do VPA/VDA
    ONLY 65816 Sim is working
    [blit-bringup2-rom0.cfg]
2021-11-10 Update ELK 65816 TB and switch to P65C816 core
2021-11-12 switch 65816 testbench to P65C816 core and tweak/bodge timings for sys clock stretch
    [sim_SYS_tb.vhd]
2021-11-12 FIX: address_decode - decode HDMI address even if not included
    [address_decode.vhd]
2021-11-12 Fixup t65 testbenches for new directory structure
    [sim_t65_tb.vhd]
2021-11-12 remove unwanted assembler output
2021-11-12 more directory structure fixes
    [sim_68008_tb.vhd]
2021-11-13 6x09 - reinstate and update sim for new model and mk.3 board
    First run works
2021-11-16 speed up reset in simulations
    [mk3blit.vhd]
2021-11-21 FIX: missing assembler scripts
2021-12-09 reinsate cpu-04-min board
2021-12-09 reinstate cpu-16-hdmitest board
2021-12-17 first cut back port spirkov stuff from testing
2021-12-19 simplify synchroniser - still not working as crtc is outputting only 624 lines!
    Odd field is too short?! compare with real 6845s
    [HDMI_pack.vhd, dvi_synchro.vhd, fb_HDMI_ctl.vhd, fb_HDMI_enabled.vhd, mk3blit.vhd]
2021-12-20 Fix: odd v_front was one line too long, delay v_sync by two lines instead of one for correct ilace
    [dvi_synchro.vhd]
2021-12-21 FIX: DMA channels mismatched to number of controllers causes blitter to fail
2021-12-21 FIX: don't keep ack asserted after cyc
    [fb_HDMI_ram.vhd]
2021-12-21 FIX: de-assert all p2c signals as soon as cyc is dropped
    Was causing blitter to read a spurious ack from hdmi memory when blitting from chipram to hdmi ram
2021-12-22 first cut teletext with smaller ttx rom
2021-12-25 timing tweaks - blitter was failing, hdmi was causing big hold delays
    [dvi_synchro.vhd, fb_HDMI_enabled.vhd]
2021-12-29 1st cut 6800 - testbench set up not working!
    [sim_6800_tb.vhd]
2021-12-30 first fb_6800 cut reads/writes from slow SYS memory not working
    [fb_CPU.vhd, fb_CPU_6800.vhd, mk3blit.vhd, sim_6800_tb.vhd]
2021-12-30 Timing fixes - probably a bit conservative
    [fb_CPU_6800.vhd]
2021-12-31 FIX: 6800 nmi never happened
    [fb_CPU_6800.vhd]
2022-01-04 FIX: remove dodgy blanking signal causing ragged edges
    [dvi_synchro.vhd]
2022-01-11 FIX: 6800 - allow realign with SYS clock
    [fb_CPU_6800.vhd]
2022-01-12 FIX: late writes were causing corrupt memory CPU=6800, Mode=2
    [fb_CPU_6800.vhd, fb_SYS.vhd]
2022-01-12 fix incorrect comment on 6800 timing
    [fb_CPU_6800.vhd]
2022-01-14 FIX: dma was not passing on halt and was always halted by missing aeris halt input
    [fb_SYS.vhd]
2022-01-30 fb_MEM.vhd - possible bug, not holding data until end of cyc
    [fb_MEM.vhd]
2022-03-29 FIX: unreliable when hot on Model B
    [fb_SYS.vhd]
2022-03-29 Add mk2 files and start retro fitting mk3 stuff to them, move some stuff to shared folder
    [blit-bringup2-rom0.cfg]
2022-03-29 change mk3blit_pack and mk2blit_pack to board_config_pack and share between boards
2022-03-30 remove/gitignore build files, fixes to build
    [mk2blit.vhd, version.vhd]
2022-03-30 MK2:sim_t65_tb:1st cut harmonize and use SYS component
2022-04-01 MK3:FIX:fb_CPU wasn't enabling t65 core - T65 sim working
    [fb_CPU.vhd]
2022-04-01 MK3:SIM:FIX:select a valid hard cpu
    [sim_65816_elk_tb.vhd, sim_t65_tb.vhd]
2022-04-01 MK3:SIM:sim_68000_tb select correct cpu jumpers
    [sim_68000_tb.vhd]
2022-04-01 MK3:SIM:6x09 update switches and build director
2022-04-01 MK3:SIM:sim_6800_tb fix build directory, bodge timing (faster) to be similar to measured
    [sim_6800_tb.vhd]
2022-04-01 MK3:FIX:port fixes to mk3blit.vhd from mk3blit_tiny.vhd
    [mk3blit.vhd]
2022-04-01 MK3:FIX:fb_cpu - bug in cpu selection logic
    [fb_CPU.vhd]
2022-04-03 MK2/3:make sure hard cpu signals are still routed to socket when t65 active
2022-04-04 MK2:fb_cpu/fb_cpu_t65 harmonize - working up to point of 2MHz throttle
2022-04-04 MK2:SIM:FIX bidirectional bus assignment
    [sim_SYS_tb.vhd]
2022-04-04 MK2/3:better 2mhz throttle code
2022-04-05 MK3:fb_CPU_6x09 tweak address setup time - might not work CHECK!
    [fb_CPU_6x09.vhd]
2022-04-05 MK2/3:FIX:fb_CPU_6x09 do sys via block when running, fb_CPU fix - register D_wr_stb when blocked
    [fb_CPU.vhd]
2022-04-05 MK3:fb_CPU_6x09/fb_CPU back port fix from MK2
    [fb_CPU.vhd]
2022-04-05 MK2:1st cut Z80 fb_cpu_z80 and testbench
2022-04-05 MK2:SIM:FIX z80 fixes to get sim to start
    [fb_CPU.vhd, mk2blit.vhd, sim_z80a_tb.vhd]
2022-04-06 MK2:fb_CPU_z80 - new memory map - works in SIM fails with real hardware
    [fb_CPU_z80.vhd]
2022-04-06 MK2:fb_CPU_z80 - now works on real hardware but gets stuck in SIM!
    [fb_CPU_z80.vhd]
2022-04-12 MK2:SIM:68k assembler test to build directory
2022-04-12 MK2:fb_cpu_68008 - fix up split off 8 bit wrapper
    [fb_CPU_68008.vhd]
2022-04-12 MK2/3:fb_cpu - use component declarations to allow for missing CPU wrappers, fixes for 68008/680x0 split
    [fb_CPU.vhd]
2022-04-15 MK2/3:fb_cpu push pin assignment to top-level outside fb_cpu
2022-04-18 MK3:SIM:remove old 68008 testbench no board designed yet
2022-04-18 MK3:fb_cpu_680x0 state machine for mux to avoid two drivers on EFG port
    [fb_CPU_680x0.vhd]
2022-04-26 fb_cpu_65816 - split state and clock processes for easier experimentation with slowness - still not working at full speed, need to check on timings and noise on address lines
    [fb_CPU_65816.vhd, mk3blit.vhd]
2022-04-26 FIX:fb_cpu 80188 not enabled
    [fb_CPU.vhd]
2022-04-26 SIM: move all simulation boot roms source code to top level
    [blit-bringup2-rom0.cfg]
2022-04-26 scripts - show board name in version.vhd
2022-04-26 MK3:move all config into boards files, get rid of "top" modules
2022-04-29 MK3:board:mk3_tiny make it use shared mk3blit instead of own component
2022-04-29 MK3:copy chipset wrapper changes to other boards
2022-04-29 MK2:SIM:fix up VSS6VPA9BAKnAS to VSS6VPB9BAKnAS in signal names
    [sim_6502_tb.vhd, sim_65816_tb.vhd, sim_65c02_tb.vhd, sim_68008_tb.vhd, sim_6x09_tb.vhd, sim_t65_tb.vhd, sim_z80a_tb.vhd]
2022-04-29 FIX?:Was always mapping rom E to 1D0000 - not sure why but it's not right!
    [log2phys.vhd]
2022-05-13 FIX: turn on NoIce rom mapping for 65c02
    [fb_CPU_65c02.vhd, mk2blit.vhd]
2022-05-24 FIX: build problem when not G_INCL_HDMI
    [address_decode.vhd]
2022-05-24 FIX: 3.5MHz mode was only going at 3.2MHz, now 3.55
    [fb_CPU_6x09.vhd]
2022-05-25 fb_cpu_6x09.vhd - implement 2MHZ throttle
2022-05-25 register throttle after address selection - allow for later pass throttle per ROM
2022-05-25 NEW: harmonize 6x09, 65c02, t65 throttle behaviour
2022-06-26 remove old flex stuff
    [fb_memctl.vhd]
2022-06-29 documentation attach discs.zip
2022-07-12 buttons write up
2022-07-22 1st cut reading from memory
2022-07-24 1st cut write
2022-07-24 1st cut byte writes
2022-08-01 1st cut 2543 latches
2022-08-24 1st cut working on real silicon
2022-10-05 1st cut write in byte lanes
2022-10-06 1st cut try move rdyctdn comparisons to the peripheral
2022-10-06 switch to 6x09 test
2022-10-06 FIX: dma was going crazy if odd channel select when there was only one channel
    [dmac_int_dma.vhd]
2022-10-07 Too big for MAX/04
    [board_config_pack.vhd]
2022-10-09 FIX: fb_mem - rdy was being asserted early
    [fb_MEM.vhd]
2022-10-11 cut down tiny before trying out pipelined mode
2022-10-11 1st cut stall/pipeline mode - works between cpu and fb_SYS but not fb_mem
    [fb_CPU.vhd, fb_MEM.vhd, fb_SYS.vhd]
2022-10-11 1st cut pipelined fb spec
2022-10-12 tinkering with t65 registering data at fb_cpu level - broken JIM
    [fb_CPU.vhd, fb_CPU_t65.vhd]
2022-10-12 FIX: sims t65 had incorrect timings for 10ns RAM harmonize all with realistic values
    [sim_65816_elk_tb.vhd, sim_65816_tb.vhd, sim_65c02_tb.vhd, sim_68000_tb.vhd, sim_6800_tb.vhd, sim_6x09_tb.vhd, sim_t65_tb.vhd]
2022-10-13 add i2c registers
2022-10-13 include i2c and chipset
2022-10-13 FIX: A_stb was being held high too long
    [fb_CPU.vhd]
2022-10-14 fb_intcon_shared - allow stall to be continuous and other p2c to be registered
2022-10-16 chipset select null device instead of default peripheral
2022-10-16 1st cut DMA pipeline mode - not working yet
    [board_config_pack.vhd, dmac_int_dma.vhd, dmac_int_dma_cha.vhd]
2022-10-17 DMA test code
2022-10-17 d_wr/stb - latch during stall and delay by 1 cycle
2022-10-17 DMA was hanging on writes - fix SYS to latch d_wr_stb/d_wr
    [fb_SYS.vhd, mk3blit.vhd]
2022-10-19 sound pipeline mode, harmonise naming in dmac, cpu gets stuck when sounds play
    [board_config_pack.vhd, dmac_int_dma.vhd, dmac_int_sound.vhd, dmac_int_sound_cha.vhd, fb_chipset.vhd]
2022-10-21 enable dma and sound - works with modplay!
2022-10-26 FIX: only assert d_wr_stb for a single cycle
    [fb_CPU_log2phys.vhd]
2022-10-28 FIX: return to idle when ack'd
    [fb_CPU_log2phys.vhd]
2022-10-29 fb_cpu_con_burst - first cut, writes not working
    [fb_CPU_con_burst.vhd]
2022-10-30 1st cut use new components with t65, boots but crashes when Paula plays
    [fb_CPU.vhd, fb_CPU_con_burst.vhd, fb_CPU_log2phys.vhd, fb_CPU_pack.vhd, fb_CPU_t65.vhd]
2022-10-31 test effects of stalls on writes
    [sim_fb_per_mem.vhd]
2022-10-31 ensure d_wr_stb gets latched when stalled and doesn't cause multiple a_stbs
    [fb_CPU_con_burst.vhd]
2022-10-31 make sure d_wr_stb is correctly latched when stalled
    [fb_CPU_log2phys.vhd]
2022-10-31 FIX: dma_cha was not correctly handling d_wr_stb coincident with a_stb harmonize with snd_cha
    [dmac_int_dma_cha.vhd]
2022-11-02 FIX: end con->per cycle and allow another to start after d_wr_stb or read
    [fb_CPU_log2phys.vhd]
2022-11-02 TWEAK: rdy too long, causing fuzzy reads on SYS - TODO: recheck after fixes
    [fb_CPU_680x0.vhd]
2022-11-02 FIX: simplify state machine, was skipping multi reads where n > 2, needs to stall more?
    [fb_CPU_log2phys.vhd]
2022-11-02 FIX: via block being defeated by stray a_stb
    [fb_CPU_log2phys.vhd]
2022-11-02 FIX: fb_MEM - check for ready as first cycle starts
    [fb_MEM.vhd]
2022-11-05 PIPE: 1st cut 816, shave D hold
2022-11-05 oops, multiple drivers at reset
2022-11-13 FIX: read after write was being ack'd early during idle cycle if D_wr_stb left asserted
    [fb_MEM.vhd]
2022-11-21 FIX: stall incorrectly released
2022-11-22 FIX: was re-granting a cycle to the current controller if another controller requested one
2022-11-22 FIX: A_stb was asserted beyond stall=0
2022-11-22 FIX: 2 channel DMA had channels mis-ordered
    [fb_chipset.vhd]
2022-11-22 PIPE: 16-max board
2022-11-22 PIPE: Aeris 1st cut - random banding near top of screen in BigFonts
2022-11-22 FIX: make sure Aeris has highest priority otherwise get streaks in BigFonts
    [blit_int.vhd, fb_chipset.vhd]
2022-11-23 FIX: writes must come from pipeline register!
    [aeris.vhd, blit_int.vhd]
2022-11-23 FIX: mk2 was not using fast RAM
    [board_config_pack.vhd, mk2blit.vhd, sim_t65_tb.vhd]
2022-11-23 FIX: fb_CPU_68008 dropping cyc too early
    [fb_CPU_68008.vhd]
2022-11-30 FIX: need to de-assert d_wr_stb earlier for 2MHz 6x09
    [fb_CPU_6x09.vhd]
2022-12-11 FIX: was getting stuck in simulation
    [fb_CPU_z80.vhd]
2023-01-03 FIX: throttle was broken in T65
    [fb_CPU_t65.vhd]
2023-01-05 FIX: NoIce debugging was broken by recent pipeline updates
    [fb_memctl.vhd]
2023-01-30 more speed - shave rdy ctdn - doesn't seem to make much difference?!
    [fb_CPU_z180.vhd]
2023-02-06 NEW: im2 location, fix metastability issues with z180 at boot
    [fb_CPU_z180.vhd]
2023-03-28 fix up board files for other mk3 boards
    [board_config_pack.vhd]
2023-04-14 FIX: reinstate missing board_config_pack changes
    [board_config_pack.vhd]
2023-04-15 1st cut per ROM throttle for 65xx/6x09
2023-04-18 port per rom throttle back to mk.2
2023-05-10 1st cut 16 bit 80186 - 80188 tests ok with test rom
2023-05-10 FIX: boot not selecting 80186, add debugging of 80188 state
    [fb_CPU.vhd, fb_CPU_80188.vhd, fb_CPU_con_burst.vhd, mk3blit.vhd]
2023-05-10 fb_CPU_log2phys was not correctly passing on d_wr/d_wr_stb if it immediately followed the previous transactions d_wr_stb
    [fb_CPU_log2phys.vhd]
2023-05-10 lane direction masking was wrong, just mask off top lane in 8 bit mode
    [fb_CPU_80188.vhd]
2023-08-23 first cut pinning - no extras yet
2023-08-27 Updates for corrections to pinning from Dock schematic
2023-08-28 CPU 1st cut
2023-09-17 new board
2023-09-18 1st cut sim rom
    [model_BC.cfg]
2023-09-19 1st cut working - direct screen accessed to HDMI memory buffer
2023-09-19 Vsync now working can play snapper and zalaga
    [fb_SYS_model_BC.vhd, mk3blit_model_BC.vhd]
2023-09-19 shift ttx cursor bodge
    [fb_HDMI_enabled.vhd]
2023-09-20 Upgrade to latest Hoglet video stuff - fixes some interlace problems
    [fb_HDMI_crtc.vhd, fb_HDMI_enabled.vhd, fb_HDMI_vidproc.vhd]
2023-09-20 1st cut sequencer control
2023-09-20 1st cut ansi text - works in mono
2023-09-22 working - 1st cut attributes and palettes
2023-09-23 FIX backporch was 1 pixel out
    [dvi_synchro.vhd, mk3blit_model_BC.vhd]
2023-09-26 2880x576i / 2880x288p mode - working with fixed repetition factor of 4
    [dvi_synchro.vhd, fb_HDMI_ctl.vhd, pll_hdmi.vhd]
2023-09-27 FIX: get rid of accidental latches, SEQ: add font base address register
    [fb_HDMI_enabled.vhd, fb_HDMI_seq_ctl.vhd]
2023-10-02 1st cut sim working
2023-10-05 1st cut working with 2 sprites
2023-10-06 FIX: broken teletext mode
    [fb_HDMI_enabled.vhd]
2023-10-10 FIX: fix to work in all modes with correct pixel sizes
    [fb_HDMI_enabled.vhd, fb_HDMI_vidproc.vhd]
2023-10-10 better pixel priority encoder for pixels
2023-10-10 FIX: reclock horz reload from pixel clock domain
    [sprite_int.vhd]
2023-10-13 FIX: spoofed VIA needs to clear ca1 interrupt on portA access - elite hang
    [board_config_pack.vhd, fb_SYS_model_BC.vhd]
2023-10-13 FIX: restore attributes in ANSI mode
    [vidmem_sequencer.vhd]
2023-11-10 Add schematics pdfs
2024-01-19 FIX: per-ROM throttle for t65 on the wrong cycle, extend for whole instruction
    [fb_CPU_t65.vhd]
2024-01-19 throttle - remove unnecessary latch of throttle state, clock isn't monotonic
2024-01-20 FIX: per-rom throttle in 65816
    [fb_CPU_65816.vhd]
2024-01-20 per-rom throttle corrections, working 8MHz, runs at 1.95MHz in 4MHz mode
    [fb_CPU_65c02.vhd]
2024-01-20 NEW: ERC for 65816 cpu board
2024-02-14 initial infrastructure - not working
    [address_decode_chipset.vhd, board_config_pack.vhd, fb_VERSION.vhd, fb_chipset.vhd, fb_chipset_pack.vhd, fb_spi.vhd]
2024-02-14 start vunit test for spi
2024-02-17 implement spi, working with SD card at 400kHz
2024-02-19 FIX: signal busy when a transaction is pending - slow clock speeds skip bytes
    [fb_spi.vhd]
2024-02-28 FIX: type from auto-hazel
    [fb_CPU_68008.vhd]
2024-02-28 FIX: typo from auto-hazel
    [fb_CPU_z80.vhd]
2024-02-28 NEW: wire up ABORT for 65816 bidir for mk.2
2024-03-29 FIX: auto-hazel page in Hazel for current rom when NMI page accessed
    [log2phys.vhd]
2024-03-29 FIX: 65816 debug - debug button was causing continuous nABORT
    [fb_CPU_65816.vhd]
2024-04-01 FIX: qualify boot mode shifts with ack - was prematurely losing operands
    [fb_CPU_65816.vhd]
2024-04-01 add debugging for boot mode - it allows 2 cycles after swap before acting
    [fb_CPU.vhd, fb_CPU_65816.vhd, mk3blit.vhd]
2024-04-23 Add "auto-throttle"
2024-04-29 first cut WINDOW for 65816 model c mos
2024-07-26 FIX: Blitter shifting was broken in 1bpp modes
    [blit_int.vhd]
2024-07-27 FIX: BLIT: last mask not set if ExecA unset
    [blit_int.vhd]
2024-08-01 FIX: blitcon read back broken in LE mode
    [blit_int.vhd]
2024-08-02 NEWABI: sound and DMA new register layout for LE
2024-08-02 FIX: LE/BE register layouts were swapped
    [dmac_int_dma_cha.vhd]
2024-08-03 NEWABI: reorg little-used registers to end of range, add wait state to reg reads for stability
    [blit_int.vhd]
2024-10-08 FIX: 65c02 and 65816 didn't exit cpu_halt from chipset cleanly - bigfonts, aetest crashes
    [fb_CPU_65816.vhd, fb_CPU_65c02.vhd]
2025-01-05 FIX: add 30 ns hold time to SYS_D_io
    [fb_SYS.vhd]
2025-01-05 FIX: sys_D_io was being allowed to float on writes while external board databuffer was still open
    [mk3blit.vhd]
2025-06-02 fixup modelBC after merge with main
    [fb_SYS_model_BC.vhd, mk3blit_model_BC.vhd]
2025-06-03 C20K BARE - boot to simple test program
    [P20K-boot-rom.cfg]
2025-06-03 fix timing and improve uart clockiness
    [fb_uart.vhd]
2025-06-03 C20K BARE simple uart rx
2025-06-03 C20K BARE - separate ROM/RAM make ROM readonly
    [P20K-boot-rom.cfg]
2025-06-04 Make P20KBare run noice to load test programs
    [P20K-boot-rom.cfg]
2025-06-05 C20KBARE - test uart prog
    [test-serialout.cfg]
2025-06-05 C20K - Add PoC vunit tests from KiCad project
2025-06-10 full test - pass through to board and get back out, correct MIO clashes at 96M
    [c20k_peripheral_mux_ctl.vhd]
2025-06-11 better define memory areas to avoid clash with chipram and noice
    [P20K-boot-rom.cfg, test-serialout.cfg]
2025-06-11 c20k bare - port mem test from blitter tools65 project
    [memtest.cfg]
2025-06-13 1st cut rgb leds
2025-06-14 c20k bare - led chaser demo to test ws2812 driver
    [ledchase.cfg]
2025-06-18 FIX: P-bus reset polarity
    [fb_SYS_c20k.vhd]
2025-06-18 FIX: mux control, only CS on final stretched 2M cycle, timings - still glitchy on U19
    [c20k_peripheral_mux_ctl.vhd]
2025-06-18 default inputs to board sim
2025-06-18 C20K peripherals - move A/CS phases later (still meet 1MHz bus and Tube specs)
2025-06-18 BUGFIX: backport - one to many doesn't latch d_wr_stb while stalled
2025-06-19 c20k: fix, chip selects active in wrong part of stretched cycles
    [c20k_peripheral_mux_ctl.vhd]
2025-06-19 C20K mux fix: ALE was happening before address had been registered, move back cycle register
    [c20k_peripheral_mux_ctl.vhd, fb_SYS_c20k.vhd]
2025-06-20 user via test timer operation
    [uservia-time.cfg]
2025-06-20 c20k mux - better align clocks and enab;es, read data ack correction
    [c20k_peripheral_mux_ctl.vhd]
2025-06-21 c20k bare mos - interrupt vectors
    [P20K-boot-rom.cfg]
2025-06-21 c20k testprogs separate user via timer with irq and with poll
    [uservia-time.cfg]
2025-06-21 FIX: backport - comments
    [fb_MEM.vhd]
2025-06-21 C20K - fix input timings and hook up at top level, interrupts now working and debug button
    [c20k_peripheral_mux_ctl.vhd, fb_SYS_c20k.vhd]
2025-06-22 c20K - testprogs - flashinfo
    [flashinfo.cfg]
2025-06-22 c20k - fb_c20k_sys - phased reset of mux controller
    [fb_SYS_c20k.vhd]
2025-06-22 c20k - new sysvia BLAME - causes uservia readbacks to fail
    [sysvia-time-irq.cfg, sysvia-time-poll.cfg, uservia-time-irq.cfg, uservia-time-poll.cfg]
2025-06-22 C20: FIX: 2MHzE must rise before 1MHzE for W65C22N - check this is real!
    [c20k_peripheral_mux_ctl.vhd, fb_SYS_c20k.vhd]
2025-06-22 C20K - first cut slow latch, no cater for new signals yet
2025-06-23 c20k testprogs keyboard scan (polled)
    [kbtest-scan.cfg]
2025-06-23 c20k - fix - chip selects from U2/U3 were glitchy due to O0 and O1 cycles latching changing data, moved latch cycle on by 1 clock
    [c20k_peripheral_mux_ctl.vhd]
2025-06-24 C20K bare - reenable board memory from 1000-7FFF
2025-06-24 c20k bare program flash eeprom
    [flashprog.cfg]
2025-06-25 C20K - fix up project structure
    [C20K-boot-rom.cfg, flashinfo.cfg, flashprog.cfg, kbtest-scan.cfg, ledchase.cfg, memtest.cfg, sysvia-time-irq.cfg, sysvia-time-poll.cfg]
2025-06-25 C20K firstlight - fix up asm builds
    [C20KFirstLight.vhd]
2025-06-27 C20K - enable chipset and fix more sdc timing violations
    [board_config_pack.vhd]
2025-06-27 FIX: default readback from vidproc (should maybe be FE?)
    [fb_HDMI_vidproc.vhd]
2025-06-28 C20K FIX: despite blockram for hdmi being in bypass read need an extra cycle - check with Hoglet
    [fb_HDMI_ram.vhd, hdmi_blockram.vhd, hdmi_blockram_tmp.vhd]
2025-06-28 C20K, FIX: throttle mode, NEW: 1bit dacs for R,G,B
    [C20K.vhd, board_config_pack.vhd, dac1_oser.vhd, dac1_oserx2.vhd, dossy_chroma.vhd, fb_SYS_c20k.vhd, hdmi_blockram.vhd, hdmi_blockram_tmp.vhd]
2025-06-30 default throttle on
2025-06-30 C20K BODGE: disable IORB blocker, causing timing failures
    [board_config_pack.vhd, fb_CPU_log2phys.vhd, fb_CPU_t65only.vhd]
2025-06-30 FIX: improve read timings
    [fb_HDMI_ctl.vhd]
2025-06-30 FIX: Timing improvements - add register controller reads on one to many (optional) use in chipset cpu reads
    [fb_chipset.vhd]
2025-06-30 C20K - Timing - register interrupt, was causing timing violations
2025-06-30 C20K - tube detect defeater
2025-07-01 C20K switch hdmi to lvds
2025-07-01 C20K FIX HDMI is clocked at 270M/54M in 2880x576i or 2880x576p
    [pll_hdmi.vhd, pll_hdmi_tmp.vhd]
2025-07-03 FIX: get rid of latch
    [blit_int.vhd]
2025-07-04 C20K TIMING TRY - register cpu reset exit - makes closure worse, no noticeable effect on cpu stability
    [fb_CPU_t65.vhd]
2025-07-04 C20K - FIX - show reset state on LEDS
    [C20K.vhd]
2025-07-04 C20K FIX - bus reset was causing resetfull state to get stuck, need bus running early
    [fb_SYS_c20k.vhd]
2025-07-04 C20K FIX - correct VS polarity at sysvia - White Light, Frogger now run
    [C20K.vhd, fb_SYS_c20k.vhd]
2025-07-04 Revert "C20K - timing try - register phi2 clken"
    This reverts commit 3bb5c0f51afa0382e7c0b659b6203c6a4ead00cf.
    [fb_CPU_t65.vhd]
2025-07-05 FIX: missing others on case statements
    [dmac_int_dma_cha.vhd]
2025-07-05 FIX: some tools wont multiply and integer by a real
    [dossy_chroma.vhd]
2025-07-05 C20K - SIM - full test - test throttle and sys problems
    [C20KTestMOS-ThrottleOff.cfg]
2025-07-05 FIX - registered periph c2p needs an extra wait before checking stall
2025-07-06 C20K - NEW: update to latest BeebFPGA vidproc - sprites work, mode 7 correct cursor, ansi works
    [C20K.vhd, board_config_pack.vhd, fb_HDMI_enabled.vhd, fb_HDMI_vidproc.vhd]
2025-07-10 C20K - FIX - chroma samples on 48M clock use x2 DAC - slightly less patterning
    [C20K.vhd]
2025-07-11 C20K - better 48M reset
    [fb_HDMI_vidproc.vhd]
2025-07-12 C20K - VID - first cut mode 15 / 80 column teletext, needs retimer tweak for hdmi. flickery on PAL
2025-07-13 C20K - 80 col teletext first cut
2025-07-16 C20K Firstlight - regression - fix up for changes to fb_sys_c20k
    [C20KFirstLight.vhd]
2025-07-18 C20K: FIX: remove unnecessary use statements
    [fb_uart.vhd]
2025-07-18 C20K - SIM - FIX - reinstate memory assignments, CPU_RDY is inout
    [sim_cpu_mem.vhd]
2025-07-19 C20K - 816 - working with all memory at 8M read 4M write, some contention according to sim
    [C20K-test-rom.cfg]
2025-07-20 C20KFirstlight816 - enable bank switch
2025-07-20 C20KFirstLight816 - NEW DeIce monitor ROM
    [C20KBareMOS816.cfg]
2025-07-21 C20K816FL - add WDM and ABORTS to debugger, fix UART methods to be bank agnostic
    [C20KBareMOS816.asm, C20KFirstLight816.vhd, fb_C20K_mem_cpu_65816.vhd]
2025-07-21 C20K816FL - test program
    [flashinfo.cfg]
2025-07-22 C20K - serial - first cut add new BeebFPGA cores to sys component
    [C20KTestMOS-ThrottleOff.cfg]
2025-07-25 C20K - make nula reset only on powerup
    [fb_HDMI_vidproc.vhd]
2025-07-29 C20K - spi working on SOM
2025-08-05 fix up after merge-back from dev-spi
    [C20KFirstLight816.vhd]
2025-08-05 C20k 816 demo - new hdmi+pal demo
    [hdmidemo.cfg]
2025-08-05 FIX: reinstate chipset interrupt
    [C20K.vhd]
2025-08-07 C20K816 - new project with 816 as main CPU and all main non-chipset devices
2025-08-08 C20K816Only - get rid of unused devices, add null memory device for now
2025-08-08 WINDOW - improve reset code to avoid compaints from gowin synthesis of unclosed loop
    [log2phys.vhd]
2025-08-08 C20K816only - full speed memory writes
    [C20KTestMOS-write60xxxx.cfg]
2025-08-11 C20K816only - FIX memory reads were crashing bank address on D7..0 during PHI1
    [fb_C20K_mem_cpu_65816.vhd]
2025-08-25 FIX: ABORT should only be asserted for a single cycle
    [fb_C20K_mem_cpu_65816.vhd]
2025-08-25 FIX: C20K816only - correct boot/version flags
    [C20K816only.vhd]
2025-08-25 FIX: some memory writes to odd 64kbanks were causing aliassed problems in even banks (*XMLOAD)
    [fb_C20K_mem_cpu_65816.vhd]
2025-08-27 FIX: better memory write fix
    [fb_C20K_mem_cpu_65816.vhd]
2025-08-30 NOT WORKING - try 1st cut throttle
    [C20K816only.vhd, fb_C20K_mem_cpu_65816.vhd, log2phys.vhd]
2025-09-01 NEW: ALL!!!: change log2phys to register throttle for entire instruction
2025-09-01 C20K Add MOS throttle/Turbo
2025-09-16 C20K demo - fix for more stable writes
    [fb_C20K_mem_cpu_65816.vhd]
2025-09-27 Align cpu clock phase with sys clock better.
    FIX: 1m stretch was breaking throttling: throttle release was forgotten on non-ready cycles
    Simplify ready logic
    [fb_C20K_mem_cpu_65816.vhd]
2025-09-28 NEW: Full reset now resets sysvia, reset mobo button forces full reset
    [C20K816only.vhd, fb_SYS_c20k.vhd]
2025-09-28 C20K: fix up for changes to throttling and log2phys
    [C20K.vhd, fb_CPU_log2phys.vhd, fb_CPU_t65only.vhd]
2025-10-03 get rid of reference to std_logic_misc library which is problematic in dsim
    [blit_int.vhd, c20k_peripheral_mux_ctl.vhd, dmac_int_dma.vhd, dmac_int_sound.vhd, dvi_synchro.vhd, fb_C20K_mem_cpu_65816.vhd, fb_CPU.vhd, fb_CPU_68008.vhd]
2025-10-04 reset nula on full/power reset
    [fb_HDMI_vidproc.vhd]
2025-10-06 C20K - reset nula on full / powerup reset
    [fb_HDMI_vidproc.vhd]
2025-10-07 BLITTER ALL: backport C20K changes to mk2 and mk3 - not HDMI NOT working, cpu-04 full
    [address_decode.vhd, board_config_pack.vhd, fb_CPU.vhd, fb_CPU_t65only.vhd, fb_HDMI_enabled.vhd, mk2blit.vhd, mk3blit.vhd]
2025-10-09 ALL: new sys via blocker, throttle instead of pause
2025-10-09 C20K/816 - fix versioning to no cause rebuild flagged
    [version.vhd]
2025-11-14 FIX: C20K: i2s DAC for sound - missing clock divider on 816only
    [C20K816only.vhd]
2025-11-24 project filename case as spotted by Hoglet
2025-12-02 c20k 816 add wavedrom and ods for cpu/mem bus explore
    [tim_cpu_mux.ods]
2025-12-03 FIX:SIM: fix sim for i2s, new version
    [fb_VERSION.vhd]
2025-12-03 C20K816: fix ABORT/WDM detection was not working with stretched cycles
    [fb_C20K_mem_cpu_65816.vhd]
2025-12-03 FIX: return to more conservative timings and avoid databus contention
    [fb_C20K_mem_cpu_65816.vhd]
2025-12-05 FIX: ALL: missing sensitivity signal
    [address_decode.vhd]
2025-12-05 C20K816: new busmaster - DMA works, SND causes hang
    [C20KTestMOS-dma.cfg]
2025-12-06 FIX: C20K: ALL - get DIV5 working in testbenches
    [C20K.vhd, C20K816only.vhd, dossy_chroma.vhd]
2025-12-06 C20K816: bus mastering for DMA and sound now working
    [C20KTestMOS-sound.cfg]
2025-12-13 FIX: no ROM paging in noice
    [noice.asm]
2025-12-13 C20KFirstLight: update firstlight to have more block RAM, document
    [C20K-boot-rom.cfg]
2025-12-14 c20kfirstlight - leds chase
2025-12-14 C20KFirstLight: reconnect debug leds
2025-12-14 C20KFirstLight: Add video
    [vidtest.cfg]
2025-12-16 NEW: Monitor ROM - 1st cut built to run under a debugger
    [C20KBareMON.cfg]
2025-12-16 C20KFirstLight: add a pipeline stage back to log2phys for better timing closure
2025-12-17 C20KFirstLight: add read FPGA Config SPI
2025-12-17 C20KFirstLight - use srec_cat and Motorola hex format
    [flashinfo.cfg, flashprog.cfg, kbtest-scan.cfg, ledchase.cfg, memtest.cfg, sysvia-time-irq.cfg, sysvia-time-poll.cfg, test-serialout.cfg]
2025-12-17 fix up Makefiles to clean up properly
    [C20KBareMON.asm]
2025-12-18 C20KFirstLight - split into two .gprj with NoICE/MON, mon fixed can now load srecs and execute
    [C20KBareMON-test.cfg, C20KBareMON.cfg]
2025-12-18 C20KBareMON: add flash read/dump
    [C20KBareMON-test.cfg, C20KBareMON.cfg]
2025-12-20 C20K - 1st cut Flash EEPROM U25 prime instructions
2025-12-20 C20KBareMON: FIX: Erase and Program were broken
    [C20KBareMON.asm]
2026-01-06 C20K 1bit video fix constants to ensure gray scale is colour free
    [dossy_chroma.vhd]
2026-01-06 chroma - round before adding - avoid UV cross talk
    [dossy_chroma.vhd]
2026-01-08 c20k: button 1 to swap rom sets
    [C20K.vhd]
2026-01-12 C20K: First cut preboot mini-bootstrap ROM to boot from SPI Flash
2026-01-26 C20K: enable debug UART
2026-01-27 ALL: allow change map0n1 programmatically and better control "fake" reboots, turn off preboot using memctl
    [C20K.vhd, C20K816only.vhd, board_config_pack.vhd, fb_C20K_mem_cpu_65816.vhd, fb_CPU_log2phys.vhd, fb_CPU_t65only.vhd, fb_memctl.vhd, log2phys.vhd]
2026-02-01 NEW: fb_config, fix fb_version state machine, econet station id
    [C20K.vhd, C20K816only.vhd, address_decode.vhd, board_config_pack.vhd, fb_CPU_t65only.vhd, fb_SYS_c20k.vhd, fb_VERSION.vhd]
2026-02-02 C20K: fix swromx in version
    [C20K.vhd]
2026-02-03 FIX: maps were swapped in config bits
    [C20K.vhd]
2026-02-03 FIX: fb_version, fb_config were causing hangs with t65
    [fb_VERSION.vhd, fb_config.vhd]
2026-02-06 c20k: fix fb_config wait release
    [fb_config.vhd]
2026-02-06 c20k816only: fix map 0 / 1 config
    [C20K816only.vhd]
2026-02-19 AERIS: better closure on Gowin devices - uses RAM16SDP4's for counters/pointers
2026-02-28 backport swromx and throttle changes to mk3 blitter
2026-03-03 rejig reset, fix fb_memctl to pick up map0n1 swap late in reset
    [fb_memctl.vhd]
2026-03-06 attempt to fix 65816 / halt problems
    [fb_CPU_65816.vhd]
2026-03-09 FIX: cpu count was 1 too high
    [fb_CPU.vhd]
2026-03-09 mk.2 backport - working but doesn't like pre-mux register on intcon_shared
    [board_config_pack.vhd, mk2blit.vhd]
2026-03-10 PREBOOT: 1st part working on mk.2, 2nd part not working
    [C20K.vhd, C20K816only.vhd, C20KFirstLight.vhd, C20KFirstLight816.vhd, board_config_pack.vhd, fb_CPU.vhd, mk2blit.vhd]
2026-03-14 FIX: mk2 BS pin not correctly spec'd causing hard cpu crash (6x09)
2026-04-04 programmer_cli.exe use option 32 to program SPI flash
2026-05-10 1st cut stereo with 12dB separation on channels 0,3 vs 1,2
2026-05-17 get rid of VGA switch in vidproc
2026-05-24 Change VGA to CSYNC on pin 13 when in 15KHz mode
2026-06-04 FIX: clock domain bug in dvi synchro, AVI checksum
    [C20K.vhd, dvi_synchro.vhd, fb_HDMI_ctl.vhd]
2026-06-10 FIX: sparkles on right margin in mode 7?
    [dvi_synchro.vhd]
2026-06-11 DVISYNCHRO: ignore CRTC DE (games, i.e. chronos) and have fixed
    [dvi_synchro.vhd]
2026-06-21 FIX: reduced q range
    [fb_HDMI_ctl.vhd]
2026-06-25 post-merge fixups, DMAC still not quite right in MODPLAYER SYS to CHIP?
    [fb_C20K_mem_cpu_65816.vhd]
2026-06-26 horrible bug - dma (dmac, blitter, sound) often getting memory chipsel wrong but not always
    [fb_C20K_mem_cpu_65816.vhd]
2026-06-27 FIX: slot E wasn't working correctly in map 1
    [log2phys.vhd]
2026-06-27 FIX: use registered value for peripheral sel
    [fb_C20K_mem_cpu_65816.vhd]
2026-07-12 FIX: chronos, interlace vsync moves depending on hsync pos! More lenient interlace detect
    [dvi_synchro.vhd]
2026-08-21 move SPI to lower half of FC5X and move c20k latch to FE58, cassette motor is enabled by serproc writes
2026-09-01 implement local adc inside sys block
2026-09-03 fix for newer 816's seemingly don't hold data after write for 10ns RAM
    [fb_C20K_mem_cpu_65816.vhd]
2026-09-05 first cut, blturbo broken in 816, flash eeprom write broken in t65
    [C20K.vhd, C20K816only.vhd, board_config_pack.vhd, fb_C20K_mem_cpu_65816.vhd, fb_CPU_t65only.vhd]
2026-09-05 undo flash memory bodge
    [fb_C20K_mem_cpu_65816.vhd]
2026-09-05 FIX: inactive t65 was still hogging bus cycles
    [fb_CPU_t65.vhd]
2026-09-09 test and sim
    [MEMCPU_timing.ods]
2026-09-09 try and get t65 working - works on some boards not on UKWebb
2026-09-15 FIX: timings, deadlocks and RDY missed BA
    still problematic in BIGFONTS
    [fb_C20K_mem_cpu_65816.vhd, sim_cpu_mem.vhd]
2026-09-15 FIX: debug lights in 816 mode were stuck
    [C20K.vhd]
2026-09-15 FIX: BIGFONTS now runs, doesn't get stuck on FD00 writes
    Looks like the CYC reset was needed but stall stuff correct
    [fb_C20K_mem_cpu_65816.vhd]
2026-09-18 enable preboot for 65816, 10 bit sound, mk.3 fixups
    [fb_CPU.vhd, mk2blit.vhd, mk3blit.vhd]
2026-09-25 get rid of occasional boots with glitchy syncs in HDMI/DVI, use Hoglets synchroniser idea
    [dvi_synchro.vhd, sync_sync.vhd, vid15tohdmi.vhd]
2026-10-09 get CPU configuration from board_config_pack
2026-10-09 NEW: add a cut-down mk2blitter for testing new components
2026-10-09 Clarify spec about cyc - was implying that dropping cyc was a thing to do if interrupted
2026-10-09 FIX: cancel masks as soon as cyc dropped to avoid passing on stale strobes
    [fb_CPU_con_burst.vhd]
2026-10-09 FIX: avoid stale D_acks and non-write D_acks being generated from queued D_stbs in a read cycle, truncate rdy after ack
    [fb_SYS.vhd]
2026-10-09 fb_MEM, fb_config, fb_VERSION updated - boots without BLTUTIL rom, 65816 mode broken
    [board_config_pack.vhd, fb_CPU.vhd, fb_MEM.vhd, fb_VERSION.vhd, fb_config.vhd, sim_t65_tb.vhd]
2026-10-13 fb_chipset changes to work when there are no controllers enabled, get fb_i2c working (CS_EEPROM) in mk2 test board
2026-10-13 add new many_to_one intcon, update fb_chipset, i2c working
2026-10-14 Sound and DMA updated, extra chipset buffer but timing doesn't close
2026-10-14 fb_intcon_one_to_many - improve return path steering using registers instead of via address select logic
    Also, enable/add some more buffers to help timing
2026-10-16 Do "early capture" of registered address in more peripherals, hopefully remove routing pressure in address registers
2026-10-16 get rid of cut down build and move all changes over to official mk2
2026-10-17 mk3 start porting across mk2 changes (minus HDMI boards)
2026-10-19 First cut C20K816only - fails timing, crashes if blitter enabled build
2026-10-19 OPT: fb_sys defer generating local chip selects and use registered r_SYS_A to take pressure off fb_c2p_i
2026-10-19 Revert "OPT: fb_sys defer generating local chip selects and use registered r_SYS_A to take pressure off fb_c2p_i"
    This reverts commit 9bcdf5150294f062289e47b9a75abc5daa81e609.
2026-10-19 bring SDC improvements to other C20 boards, disable unwanted SID stuff
2026-10-20 Aeris, reenable and improve timing of r_pc by saving play return address in a dedicated register, take pressure of D_ack
2026-10-20 mk2 stuff to C20K, new shared cpu/mem/816 wrapper, Claude improvements to wrapper, non-pipelined intcons for 8 bit boards
2026-10-20 remove old cpu/mem/816 boards
2026-10-21 FIX: missing MHz12 pass on led to chonky text, vhdl syntax fix
2026-10-21 Add a pipeline stage to fb_version to free up placement
2026-10-27 first cut arm2 wrapper updates
2026-11-06 remove slot E special case for mk3/c20k in prep for mos-extender
2026-11-06 Revert "remove slot E special case for mk3/c20k in prep for mos-extender"
    This reverts commit e0de7a0c3a7028b003954fc633a922e01ca9198d.
    Checked in to wrong branch
